Isno-Open/OpenProfalux/firmware/README.md

# OpenProfalux : firmware (ESP32 + CC1101)

Pilote des volets roulants **Profalux 868 MHz** (moteurs MAI-EMPX / MAI-EMNOE) depuis
Home Assistant, **sans la clé constructeur** : le firmware **clone** une télécommande
existante (capture + rejeu) : le moteur accepte le rejeu (rolling code non contraint).

## Fonctions
- **UI web embarquée** : pilotage, apprentissage, calibration, Wi-Fi, MQTT, OTA, système (RF debug).
- **Cover Home Assistant** par volet (MQTT discovery) : open/close/stop + position.
- **Apprentissage** : on capture ▲/▼/■ d'une vraie télécommande et on nomme le volet.
- **Position estimée par le temps** (calibration montée/descente ; recalage aux butées).
- **Suivi de la vraie télécommande** : ▲/▼ lance, ■ fige (modèle appui + stop).
- **Multi-télécommandes** par volet (serials multiples).
- **Sauvegarde / restauration** : export JSON (noms + trames de référence + calibration).
- **Capture de trames** optionnelle vers MQTT (dédup par serial).
- **OTA** : upload web + pull MQTT, 2 partitions ; **retour automatique** à la version précédente si la nouvelle plante au démarrage (voir plus bas), et bouton « Version précédente ».
- **Config UI** : Wi-Fi + MQTT (persistés en NVS).

## Matériel
Une carte ESP32 (M5Stack ATOM Lite, DevKit, D1 mini, Olimex ESP32-POE, ISNO Super : tableau dans
[`BUILD.md`](../BUILD.md)) + module CC1101 868 MHz (EBYTE E07-900M10S).
Brochage : voir `boards/<carte>.json`. **CC1101 = 3.3 V max, jamais 5 V.**

## Build
```bash
# via Docker ESP-IDF v6.1 (un repertoire de build par carte)
docker run --rm -v "$PWD/..":/project -w /project/firmware espressif/idf:v6.1 bash -c "
  idf.py -B build-isno-super set-target esp32s3
  idf.py -B build-isno-super -DBOARD=isno-super build"
# autres cartes : -DBOARD=<fichier de boards/>, cible = son champ mcu (tableau dans BUILD.md)
# ou en local si ESP-IDF v6.1 est installe :
idf.py -B build-isno-super set-target esp32s3 && idf.py -B build-isno-super -DBOARD=isno-super build
```

## Flash

### Option A : release pré-compilée (le plus simple, pas d'ESP-IDF)
Télécharger les binaires de la [dernière release](https://github.com/Isno-Open/OpenProfalux/releases)
puis, avec juste `esptool` (`pip install esptool`). **Choisir le binaire selon la carte** : les
broches SPI diffèrent, un binaire d'une carte ne marchera pas sur l'autre :

| Carte | Board neuf (`write_flash 0x0`) | Mise à jour OTA (onglet OTA) |
|---|---|---|
| **M5Stack ATOM Lite** (ESP32-PICO) | `openprofalux-m5-atom-lite-full.bin` | `openprofalux-m5-atom-lite-ota.bin` |
| **ESP32 DevKit** (CC1101 externe) | `openprofalux-external-full.bin` | `openprofalux-external-ota.bin` |
| **D1 mini ESP32** (CC1101 externe) | `openprofalux-d1-mini-full.bin` | `openprofalux-d1-mini-ota.bin` |
| **Olimex ESP32-POE** (Ethernet) | `openprofalux-esp32-poe-full.bin` | `openprofalux-esp32-poe-ota.bin` |
| **ISNO Super** (ESP32-S3, `--chip esp32s3`) | `openprofalux-isno-super-full.bin` | `openprofalux-isno-super-ota.bin` |

> Chaque release publie aussi `openprofalux-<carte>-bootloader.bin`, le bootloader seul : il active
> le retour automatique sur un boîtier déjà installé (voir plus bas).

> **Le `-full.bin` efface la configuration** (Wi-Fi, MQTT, volets, télécommandes clonées) : sa zone
> de configuration est vide. Sur un boîtier déjà configuré, exporter d'abord la sauvegarde (onglet
> **Système** → Sauvegarde), ou passer par l'OTA, qui la garde.

```bash
# Board neuf / réinstallation complète : image fusionnée à flasher à 0x0
esptool.py --chip esp32 -p /dev/ttyUSB0 --baud 460800 write_flash 0x0 openprofalux-m5-atom-lite-full.bin
```
Windows (PowerShell) : `esptool.exe --chip esp32 --port COM4 --baud 115200 write_flash 0x0 openprofalux-m5-atom-lite-full.bin`

> `460800` accélère l'écriture mais ne passe pas sur tous les câbles/puces USB. En cas d'erreur
> (*Timed out waiting for packet*, *invalid head of packet*), retomber à `--baud 115200`, qui marche partout.

Déjà sous OpenProfalux ? Pas besoin de câble : **onglet OTA → uploader le `-ota.bin`** de ta carte,
ou pousser son URL via MQTT (`openprofalux/ota/pull`).

### Option B : depuis les sources
```bash
# le repertoire de build de SA carte (voir Build) : sans -B, idf.py prend build/, isno-super par defaut
idf.py -B build-m5-atom-lite -p /dev/ttyUSB0 flash monitor
```

Sur Mac, où le flash USB via Docker est capricieux, une procédure pas à pas installe ESP-IDF v6.1 en
natif : [`../docs/FLASH-MACOS.md`](../docs/FLASH-MACOS.md).

## Retour automatique après une mise à jour
Une mise à jour démarre **en essai**. Elle est validée après une minute sans plantage, ou plus tôt
si le boîtier redémarre de lui-même (Wi-Fi revenu, configuration enregistrée) ou reçoit une
nouvelle mise à jour. Si elle plante avant, le bootloader l'abandonne et le boîtier repart **tout
seul** sur la version précédente ; l'onglet **OTA** le signale.
- Débranché pendant cette minute, le boîtier revient aussi à l'ancienne version : refaire la mise à jour.
- Une version qui se bloque sans planter n'est pas rattrapée : bouton « Version précédente » de l'onglet OTA.
- Le retour automatique vit dans le **bootloader**, que l'OTA ne remplace jamais. L'onglet OTA dit
  s'il est actif. Un boîtier installé avant cette version l'obtient une fois, par USB, en ne
  flashant que le bootloader : **configuration et firmware gardés**. Avec le
  `openprofalux-<carte>-bootloader.bin` de la release, à la même adresse que le `-full.bin` :
  ```bash
  esptool.py --chip esp32 -p /dev/ttyUSB0 --baud 115200 write_flash 0x0 openprofalux-m5-atom-lite-bootloader.bin
  ```
  Windows (PowerShell) : `esptool.exe --chip esp32 --port COM4 --baud 115200 write_flash 0x0 openprofalux-m5-atom-lite-bootloader.bin`.
  ISNO Super : `--chip esp32s3`. Depuis les sources : `idf.py -B build-<carte> -p /dev/ttyUSB0 -b 115200 bootloader-flash`.
  Le `-full.bin` le donne aussi, mais il efface la configuration (exporter la sauvegarde avant).

## Premier démarrage
1. Pas de Wi-Fi configuré → l'ESP32 ouvre un point d'accès **ouvert** `OpenProfalux_XXXX`
   (fin de son adresse MAC).
2. S'y connecter : le téléphone ouvre tout seul la page de configuration (portail captif), sinon
   ouvrir http://192.168.4.1. Onglet **Wi-Fi** : réseau, mot de passe, nom du boîtier (facultatif).
3. Redémarrage → le boîtier rejoint le réseau, à l'adresse affichée par la page
   (`http://openprofalux-xxxx.local`, ou `http://<nom>.local`).
4. Onglet **MQTT** : adresse du broker → les covers apparaissent dans Home Assistant.
5. Onglet **Télécommandes** : « Cloner une télécommande » (capturer ▲/▼/■, nommer le volet),
   puis « Calibrer la position » (chronométrer une course complète pour la position en %).

## Sécurité de l'interface
- Le boîtier refuse les envois (POST `/api/...`) qu'une page d'un **autre site** ferait faire au navigateur :
  une page piégée ne peut plus piloter les volets ni changer la configuration (réponse 403, `"err":"origine"`).
- Rien ne change pour l'interface (y compris dans une iframe Home Assistant), Home Assistant (MQTT ou REST),
  curl et les scripts.
- Un mot de passe (Système → Appareil) protège en plus l'accès à l'interface et à la sauvegarde.

## Topics MQTT
| Topic | Sens | Payload |
|---|---|---|
| `homeassistant/cover/openprofalux_<dev>_<id>/config` | pub retain | discovery HA |
| `openprofalux/cover/<id>/set` | sub | `OPEN`\|`CLOSE`\|`STOP` |
| `openprofalux/cover/<id>/set_position` | sub | `0..100` |
| `openprofalux/cover/<id>/position` / `/state` | pub retain | position / état |
| `openprofalux/<nom>/status` | pub retain | `online` / `offline` (disponibilité HA) |
| `openprofalux/listen/set` | sub | `ON`\|`OFF` : écoute RF permanente (aussi dans **Système**) |
| `openprofalux/frames/last`, `openprofalux/frames/log/<n>` | pub retain | trames captées (si écoute activée) |
| `openprofalux/ota/pull` | sub | URL du `.bin` |

> Le firmware de reverse/banc (capture, tests KeeLoq) est dans `../firmware-capture-test/`.
