Isno-Open/OpenProfalux/docs/images/telecommandes-compatibles.webp

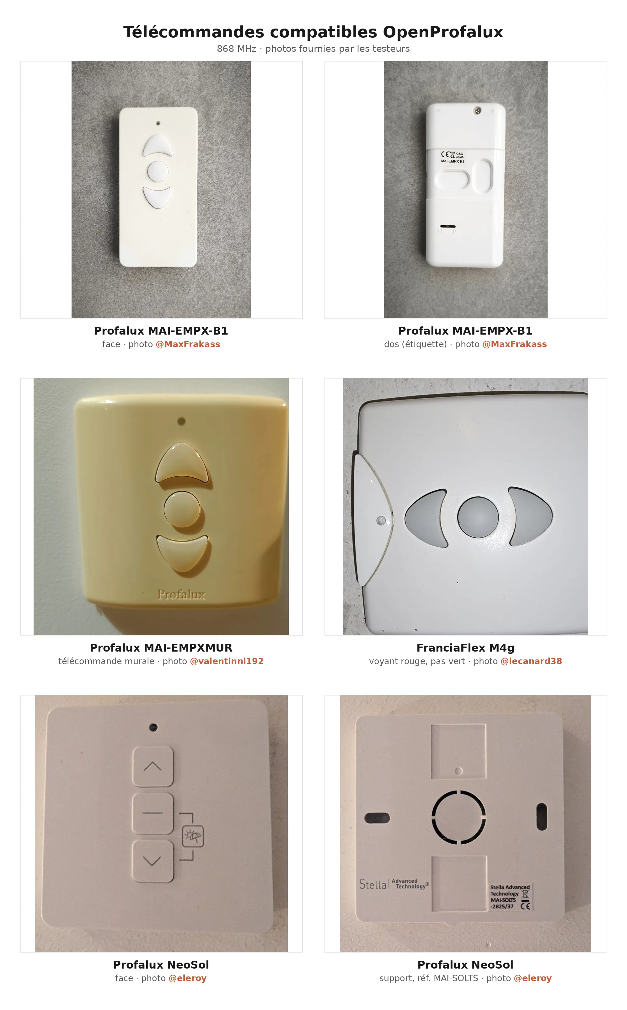
docs/images/telecommandes-compatibles.webp
