Isno-Open/OpenProfalux/enclosure/Ensemble.stl

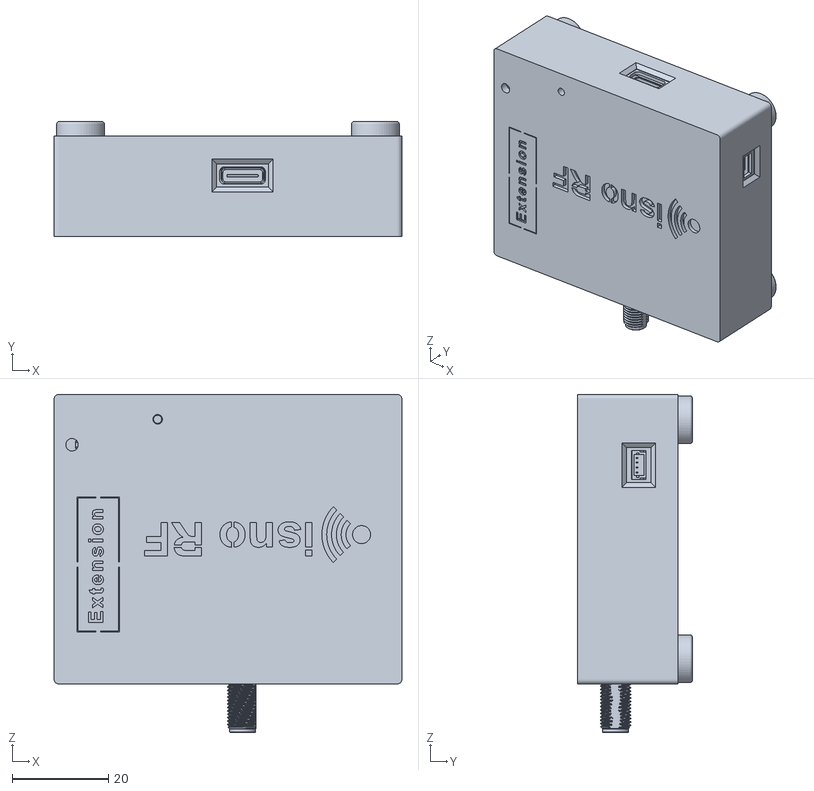
[picture p14: CAD file, 2026-10-23]
enclosure/Ensemble.stl
72.2 x 23.8 x 70.2
