Isno-Open/OpenProfalux/enclosure/OPENPROFALUX-boite.step

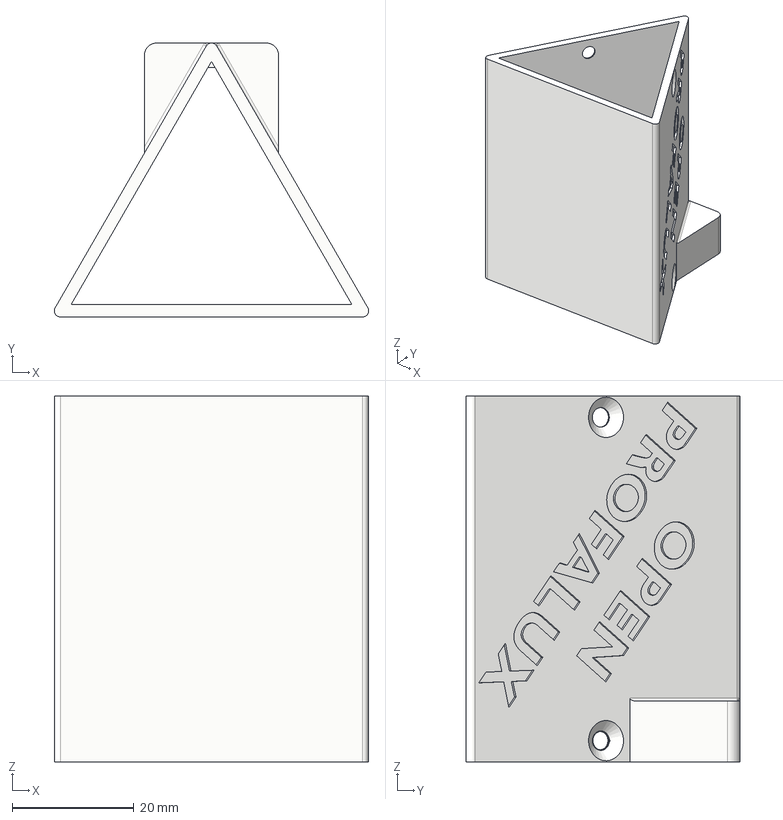
[picture p15: CAD file, 2026-10-23]
enclosure/OPENPROFALUX-boite.step
51.5 x 44.9 x 60.0 mm
