Isno-Open/OpenProfalux/firmware/main/main.c

/*
 * OpenProfalux main task orchestration
 * Boot flow:
 *   1. Init NVS
 *   2. Init CC1101
 *   3. Init Wi-Fi (STA from NVS config, else SoftAP)
 *   4. Init MQTT (broker from NVS config)
 *   5. Publish HA discovery
 *   6. Listen for MQTT commands
 */
#include <stdio.h>
#include <string.h>
#include <freertos/FreeRTOS.h>
#include <freertos/task.h>
#include <esp_log.h>
#include <nvs_flash.h>
#include <nvs.h>

#include "hardware_config.h"
#include "cc1101.h"
#include "radio.h"
#include "radio_profile.h"
#include "wifi_bridge.h"
#include "mqtt_bridge.h"
#include "tls_pool.h"
#include "tls_budget.h"
#include "shutters.h"
#include "pfx_enrol.h"
#include "web_ui.h"
#include "ota.h"
#include <esp_timer.h>
#include <esp_mac.h>
#include "mdns.h"
#include "mdns_name.h"
#include "esp_app_desc.h"   /* esp_app_get_description()->version = PROJECT_VER */
#include "log_ring.h"
#include "memprobe.h"
#include "memprobe.h"
#include <esp_attr.h>     /* RTC_NOINIT_ATTR */
#include <esp_system.h>   /* esp_reset_reason */
#if CONFIG_HEAP_TASK_TRACKING
#include <esp_heap_task_info.h>   /* build de diagnostic : test/heapdiag/sdkconfig.heapdiag */
#include <esp_rom_sys.h>
/* Chaque allocation refusee : taille, fonction et tache, notees ici (contexte de l'allocateur,
 * donc rien qui alloue), puis le bilan par tache est ecrit par la boucle de fond. Un releve
 * toutes les 20 s rate les creux de quelques secondes ; celui-ci tombe sur l'instant meme. */
static volatile uint32_t s_fail_n, s_fail_size;
static const char *volatile s_fail_fn;
static char s_fail_task[16];
static void on_alloc_failed(size_t size, uint32_t caps, const char *fn) {
    s_fail_n++; s_fail_size = size; s_fail_fn = fn;
    const char *t = pcTaskGetName(NULL);
    strlcpy(s_fail_task, t ? t : "?", sizeof(s_fail_task));
    esp_rom_printf("ALLOCFAIL n=%u size=%u caps=0x%x fn=%s task=%s libre=%u bloc=%u\n", (unsigned)s_fail_n,
                   (unsigned)size, (unsigned)caps, fn ? fn : "?", s_fail_task,
                   (unsigned)esp_get_free_heap_size(), (unsigned)heap_caps_get_largest_free_block(MALLOC_CAP_8BIT));
}
#endif

static const char *TAG = "main";
static bool s_log_frames = false;   /* option UI "capture toutes les trames" (namespace cfg) */
static bool s_mqtt_obey  = true;    /* obeir aux ordres cover MQTT (namespace cfg) ; defaut oui */
static bool s_debug      = false;   /* switch UI "debug console" : logge chaque capture RX */
static bool s_upd_auto   = true;    /* verification de mise a jour automatique (toutes les 6 h) */
static bool s_tx_rpt     = false;   /* option UI : bit de repetition comme la telecommande */
static bool s_tx_rmt     = false;   /* option UI : emission par le RMT (timing materiel) */
static uint8_t s_rx_gain = 0x27;    /* plafond de gain RX (AGCCTRL2) reglable via l'UI ; defaut 0x27 */
static uint32_t s_tx_te  = TX_TE_DEFAULT_US;   /* TE d'emission (us) reglable via l'UI ; defaut 400 */
static uint8_t  s_radio_prof = RADIO_PROFILE_DEFAULT;   /* profil radio (radio_profile.h), via l'UI */
static uint32_t s_freq_custom = 0;                      /* kHz, profil custom seulement */

/* Device name / config from NVS */
static char s_device_name[32] = "volet_test";
static char s_wifi_ssid[32]   = "";
static char s_wifi_pass[64]   = "";
static char s_mqtt_uri[160]   = "mqtt://ha.local:1883";
static char s_mqtt_user[128]  = "";   /* certains brokers utilisent des tokens JWT longs */
static char s_mqtt_pass[256]  = "";   /* HA peut generer des mdp broker >64 : marge (nvs_get_str echoue si buffer trop court -> champ vide -> 'not authorized'). Aligne sur OpenXtraflame. */

/* Load user config from NVS "cfg" namespace */
static void load_config(void) {
    nvs_handle_t h;
    if (nvs_open("cfg", NVS_READONLY, &h) != ESP_OK) return;
    size_t sz;
    sz = sizeof(s_device_name); nvs_get_str(h, "device", s_device_name, &sz);
    sz = sizeof(s_wifi_ssid);   nvs_get_str(h, "wifi_ssid", s_wifi_ssid, &sz);
    sz = sizeof(s_wifi_pass);   nvs_get_str(h, "wifi_pass", s_wifi_pass, &sz);
    sz = sizeof(s_mqtt_uri);    nvs_get_str(h, "mqtt_uri", s_mqtt_uri, &sz);
    sz = sizeof(s_mqtt_user);   nvs_get_str(h, "mqtt_user", s_mqtt_user, &sz);
    sz = sizeof(s_mqtt_pass);   nvs_get_str(h, "mqtt_pass", s_mqtt_pass, &sz);
    uint8_t lf = 0; nvs_get_u8(h, "log_frames", &lf); s_log_frames = lf;
    uint8_t mo = 1; nvs_get_u8(h, "mqtt_obey", &mo); s_mqtt_obey = mo;   /* absent = oui */
    uint8_t db = 0; nvs_get_u8(h, "debug", &db); s_debug = db;
    uint8_t ua = 1; nvs_get_u8(h, "upd_auto", &ua); s_upd_auto = ua;   /* absent = active */
    uint8_t rp = 0; nvs_get_u8(h, "tx_rpt", &rp); s_tx_rpt = rp;
    uint8_t rm = 0; nvs_get_u8(h, "tx_rmt", &rm); s_tx_rmt = rm;
    uint8_t rg = 0; if (nvs_get_u8(h, "rx_gain", &rg) == ESP_OK && rg) s_rx_gain = rg;
    uint32_t te = 0; if (nvs_get_u32(h, "te_tx", &te) == ESP_OK && te) s_tx_te = te;
    nvs_get_u8(h, "radio_prof", &s_radio_prof);
    nvs_get_u32(h, "freq_khz", &s_freq_custom);
    nvs_close(h);
    /* L'ancienne cle tx_te melait le reglage manuel et le TE cale automatiquement a chaque
     * apprentissage, sans pouvoir les distinguer : effacee une fois, le boitier repart a 400
     * (issue #64). Le reglage manuel vit desormais sous te_tx. */
    if (nvs_open("cfg", NVS_READWRITE, &h) == ESP_OK) {
        if (nvs_erase_key(h, "tx_te") == ESP_OK) { nvs_commit(h); ESP_LOGW(TAG, "TE d'emission : ancien reglage efface, %u us", (unsigned)s_tx_te); }
        nvs_close(h);
    }
    /* Nom d'appareil vide -> defaut : sinon client_id MQTT vide + topic de disponibilite
     * qui ne coincide pas avec la decouverte HA. */
    if (!s_device_name[0]) strlcpy(s_device_name, "openprofalux", sizeof(s_device_name));
}

/* Publish state JSON (heartbeat : etat liaison + heap libre) */
static void publish_state(const char *last_cmd) {
    char json[320];
    /* reserve TLS : libre, plus bas atteint, debordements (voir tls_pool.h) ; sert a la dimensionner */
    tls_pool_stats_t tp; tls_pool_stats(&tp);
    int ring = 0, hops = 0; shutters_mem_sizes(&ring, &hops);   /* tailles deduites de la RAM */
    snprintf(json, sizeof(json),
        "{\"last_cmd\":\"%s\",\"rssi\":%d,\"free_heap\":%u,\"min_heap\":%u,"
        "\"tls_pool\":%u,\"tls_free\":%u,\"tls_min\":%u,\"tls_spills\":%u,\"tls_offturn\":%u,"
        "\"ring\":%d,\"hops_cap\":%d,\"pub_drops\":%u,\"up_s\":%u}",
        last_cmd, wifi_bridge_rssi(), (unsigned)esp_get_free_heap_size(),
        (unsigned)esp_get_minimum_free_heap_size(),
        (unsigned)tp.size, (unsigned)tp.free_now, (unsigned)tp.free_min, (unsigned)tp.spills, (unsigned)tls_turn_misses(),
        ring, hops, (unsigned)shutters_pub_dropped(), (unsigned)(esp_timer_get_time() / 1000000));
    mqtt_pub_state(s_device_name, json);
}

/* ────── MQTT handlers ────── */

static void on_ota_pull(const char *url) {
    ESP_LOGI(TAG, "▶ OTA pull depuis %s", url);
    ota_pull_from_url(url);
}
static void on_mqtt_connected(void) {
    shutters_mqtt_announce(s_device_name);   /* publie la decouverte HA a la VRAIE connexion broker */
}

/* ── Retour du Wi-Fi en mode secours (wifi_bridge_start_fallback) ──
 * Des que le reseau repond, on redemarre : le demarrage normal (MQTT, mDNS, decouverte HA)
 * est deja eprouve, et rien n'est perdu (config et positions en NVS). Une mise a jour
 * envoyee par le point d'acces est attendue TANT QU'ELLE AVANCE : un envoi abandonne
 * (telephone coupe du point d'acces, qui suit le canal de la box au retour) reste "en
 * cours" sans fin cote serveur web ; 20 s sans octet recu -> on redemarre quand meme
 * (la partition de demarrage ne change qu'une fois l'image verifiee).
 * La duree passee en mode secours survit au redemarrage logiciel (memoire RTC, pas de
 * flash) : le journal du demarrage suivant la donne. */
#define FALLBACK_MAGIC 0x57494649u   /* "WIFI" */
static RTC_NOINIT_ATTR uint32_t s_fb_magic;
static RTC_NOINIT_ATTR uint32_t s_fb_secs;
static int64_t s_fb_since_us;
static esp_timer_handle_t s_back_timer;
static void back_restart_now(void) {
    s_fb_secs = (uint32_t)((esp_timer_get_time() - s_fb_since_us) / 1000000);
    s_fb_magic = FALLBACK_MAGIC;
    ESP_LOGW(TAG, "Wi-Fi de retour apres %u s en mode secours : redemarrage", (unsigned)s_fb_secs);
    esp_restart();
}
static void back_restart_cb(void *arg) {
    (void)arg;
    static uint32_t last; static int still;   /* octets recus au passage precedent, passages sans progres */
    ota_status_t st = {0}; ota_get_status(&st);   /* {0} : rien n'est copie si le verrou ne vient pas */
    bool busy = st.state == OTA_STATE_RECEIVING || st.state == OTA_STATE_VERIFYING || st.state == OTA_STATE_APPLYING;
    if (busy && st.written_bytes != last) { last = st.written_bytes; still = 0; }
    if (busy && still++ < 4) {   /* toutes les 5 s, au plus 4 fois sans progres */
        esp_timer_start_once(s_back_timer, 5 * 1000000ULL);
        return;
    }
    back_restart_now();
}
static void on_wifi_back(void) {   /* appele depuis la tache d'evenements : on ne fait qu'armer */
    if (!s_back_timer) {
        const esp_timer_create_args_t ta = { .callback = back_restart_cb, .name = "wifi_back" };
        if (esp_timer_create(&ta, &s_back_timer) != ESP_OK) { back_restart_now(); return; }   /* sinon connecte sans MQTT */
    }
    if (!esp_timer_is_active(s_back_timer)) esp_timer_start_once(s_back_timer, 2 * 1000000ULL);
}

/* NB : le RX radio (capture permanente arbitree) est demarre par shutters_init() ;
 * les trames recues sont routees vers shutters_on_rx en interne. */

/* ────── App entry ────── */

void app_main(void) {
    log_ring_init();   /* journal de l'interface web : avant le premier message */
    memprobe("boot-debut");
#if CONFIG_HEAP_TASK_TRACKING
    heap_caps_register_failed_alloc_callback(on_alloc_failed);
#endif
    ESP_LOGI(TAG, "╔══════════════════════════════════════════╗");
    ESP_LOGI(TAG, "║ OpenProfalux v%s : target=" TARGET_NAME, esp_app_get_description()->version);
    ESP_LOGI(TAG, "╚══════════════════════════════════════════╝");
    if (s_fb_magic == FALLBACK_MAGIC && esp_reset_reason() == ESP_RST_SW)
        ESP_LOGW(TAG, "redemarre apres le retour du Wi-Fi (%u s en mode secours)", (unsigned)s_fb_secs);
    s_fb_magic = 0;

    /* 1. NVS */
    esp_err_t err = nvs_flash_init();
    if (err == ESP_ERR_NVS_NO_FREE_PAGES || err == ESP_ERR_NVS_NEW_VERSION_FOUND) {
        nvs_flash_erase(); nvs_flash_init();
    }

    /* 1b. OTA (retour automatique : l'image en essai est validee plus bas apres ~60 s) */
    ota_init();
    memprobe("boot-nvs-ota");

    /* 2. Config */
    load_config();
    /* Reserve TLS prise d'un bloc des la configuration connue, avant que le reste du demarrage
     * ne morcelle la memoire, et a la taille de CE boitier (tls_pool_need). Un mqtts choisi en
     * cours de route deborde sur le tas jusqu'au redemarrage, et se compte. */
    {
        bool local_tls  = strncmp(s_mqtt_uri, "mqtts://", 8) == 0;
        bool local_mtls = local_tls && mqtt_cert_len("cert") && mqtt_cert_len("key");
        tls_pool_init(tls_pool_need(local_tls, local_mtls, false, s_upd_auto));
    }
    memprobe("boot-reserve-tls");
    /* Nom mDNS (mdns_name.h), decide AVANT le Wi-Fi : un boitier neuf demarre sans Wi-Fi (point
     * d'acces), et c'est a ce premier demarrage que son nom a suffixe doit etre fige. Nom choisi
     * par l'utilisateur, sinon le nom fige (cfg/mdns_host) : openprofalux pour un boitier deja
     * installe (Wi-Fi deja enregistre : adresse inchangee), openprofalux-xxxx pour un neuf. */
    {
        char host[MDNS_NAME_MAX + 1] = "";
        if (!mdns_name_is_default_device(s_device_name)) mdns_name_sanitize(s_device_name, host, sizeof(host));
        if (!host[0]) {
            nvs_handle_t h; size_t sz = sizeof(host);
            if (nvs_open("cfg", NVS_READWRITE, &h) == ESP_OK) {
                if (nvs_get_str(h, "mdns_host", host, &sz) != ESP_OK || !host[0]) {
                    uint8_t mac[6] = {0}; esp_read_mac(mac, ESP_MAC_WIFI_SOFTAP);
                    mdns_name_first_boot(s_wifi_ssid[0] != 0, mac, host, sizeof(host));
                    nvs_set_str(h, "mdns_host", host); nvs_commit(h);
                    ESP_LOGW(TAG, "mDNS : nom fige au premier demarrage : %s.local", host);
                }
                nvs_close(h);
            }
        }
        wifi_bridge_set_hostname(host);   /* vide : garde openprofalux */
    }
    ESP_LOGI(TAG, "device=%s wifi_ssid=%s mqtt=%s",
             s_device_name, s_wifi_ssid, s_mqtt_uri);

    /* 3. CC1101 */
    if (cc1101_init() != 0) {
        ESP_LOGE(TAG, "CC1101 init FAILED. Check wiring per hardware_config.h");
    }
    /* 3b. Profil radio (frequence par marque). Une config invalide ou hors de la plage de la
     * carte retombe sur le profil par defaut plutot que de laisser la radio muette. */
    {
        uint32_t khz;
        if (!radio_profile_resolve(s_radio_prof, s_freq_custom, CC1101_BAND_LOW_KHZ, CC1101_BAND_HIGH_KHZ, &khz)) {
            ESP_LOGW(TAG, "profil radio %u / %u kHz invalide pour cette carte : profil %s",
                     s_radio_prof, (unsigned)s_freq_custom, radio_profile_name(RADIO_PROFILE_DEFAULT));
            khz = radio_profile_freq_khz(RADIO_PROFILE_DEFAULT, 0);
        }
        cc1101_set_freq_khz(khz);
    }
    /* 4b. Auto-test emission au boot (prouve que la puce passe en TX). */
    if (cc1101_tx_selftest() == 0)
        ESP_LOGI(TAG, "TX SELFTEST OK : la puce emet (MARCSTATE=TX).");
    else
        ESP_LOGW(TAG, "TX SELFTEST ECHEC : puce NE passe PAS en TX (config/SPI).");
    cc1101_rx_probe();   /* sonde de bruit RX au boot (comparaison module/antenne) */

    /* 4c. Modele cover + arbitre radio (RX permanent gere en interne) */
    memprobe("boot-radio");
    shutters_set_update_auto(s_upd_auto);   /* avant shutters_init : la 1re verification en tient compte */
    shutters_init();
    memprobe("boot-volets");
    pfx_enrol_init();   /* identite virtuelle 0x067 (apprentissage sans telecommande, experimental) */
    if (s_log_frames) shutters_set_log_frames(true);
    shutters_set_mqtt_obey(s_mqtt_obey);   /* obeir aux ordres MQTT (defaut oui ; coupe = carte secondaire) */
    cc1101_set_rx_debug(s_debug);   /* switch DEBUG console restaure au boot */
    cc1101_set_rx_gain(s_rx_gain);  /* plafond de gain RX restaure au boot */
    cc1101_set_tx_te(s_tx_te);      /* TE d'emission restaure au boot */
    cc1101_set_tx_repeat_bit(s_tx_rpt);   /* bit de repetition (option) restaure au boot */
    cc1101_set_tx_rmt(s_tx_rmt);          /* emission RMT (option) restauree au boot */
    /* Radios SECONDAIRES (issue #95) : la radio 0 garde les cles NVS historiques (ci-dessus) ;
     * chaque radio i>0 a ses propres cles indexees (rprofN, rfreqN, rxgN, rteN, rrptN, rrmtN).
     * On resout sa frequence dans SA bande (defaut = porteuse declaree) et on applique freq, gain,
     * TE et options a cette puce. radio_apply serialise par le mutex radio. */
    {
        nvs_handle_t rh; bool rok = (nvs_open("cfg", NVS_READONLY, &rh) == ESP_OK);
        for (int i = 1; i < cc1101_radio_count(); i++) {
            char k[24];
            uint8_t prof = RADIO_PROFILE_CUSTOM, rxg = 0x27, rpt = 0, rmt = 0;
            uint32_t fcustom = 0, te = TX_TE_DEFAULT_US;
            if (rok) {
                snprintf(k, sizeof k, "rprof%d", i); nvs_get_u8(rh, k, &prof);
                snprintf(k, sizeof k, "rfreq%d", i); nvs_get_u32(rh, k, &fcustom);
                snprintf(k, sizeof k, "rxg%d", i);   { uint8_t v = 0;  if (nvs_get_u8(rh, k, &v) == ESP_OK && v) rxg = v; }
                snprintf(k, sizeof k, "rte%d", i);   { uint32_t v = 0; if (nvs_get_u32(rh, k, &v) == ESP_OK && v) te = v; }
                snprintf(k, sizeof k, "rrpt%d", i);  nvs_get_u8(rh, k, &rpt);
                snprintf(k, sizeof k, "rrmt%d", i);  nvs_get_u8(rh, k, &rmt);
            }
            uint32_t lo = 0, hi = 0, carrier = 0;
            cc1101_radio_info(i, NULL, &carrier, NULL, &lo, &hi, NULL, NULL);
            uint32_t khz;
            if (!radio_profile_resolve(prof, fcustom, lo, hi, &khz)) khz = carrier ? carrier : lo;
            int rpt_i = rpt, rmt_i = rmt;
            radio_apply(i, &khz, &rxg, &te, &rpt_i, &rmt_i);
        }
        if (rok) nvs_close(rh);
    }
    /* Resume des radios au boot (issue #95) : visible dans la console serie du testeur, pour
     * confirmer que CHAQUE puce declaree repond, sur quelle bande et quelle porteuse. */
    ESP_LOGW(TAG, "radios declarees par la carte : %d", cc1101_radio_count());
    for (int i = 0; i < cc1101_radio_count(); i++) {
        const char *band = ""; uint32_t cur = 0; uint8_t pn = 0xFF, ver = 0xFF;
        cc1101_radio_info(i, &band, NULL, &cur, NULL, NULL, &pn, &ver);
        bool ok = (pn == 0x00 && ver != 0x00 && ver != 0xFF);
        ESP_LOGW(TAG, "  radio %d : bande %s MHz, porteuse %u kHz, PARTNUM=0x%02X VERSION=0x%02X -> %s",
                 i, band[0] ? band : "?", (unsigned)cur, pn, ver, ok ? "DETECTEE" : "ABSENTE");
    }

    /* 5. Reseau : Ethernet filaire d'abord (si la carte en declare), sinon Wi-Fi. */
    memprobe("boot-avant-wifi");
    wifi_bridge_init();
#if BOARD_HAS_ETHERNET
    wifi_bridge_start_eth();
    /* Laisse le lien physique monter et le DHCP repondre (jusqu'a ~15 s). */
    for (int r = 0; !wifi_bridge_is_connected() && r < 30; r++) vTaskDelay(pdMS_TO_TICKS(500));
    if (wifi_bridge_is_connected()) ESP_LOGI(TAG, "reseau par Ethernet filaire");
#endif
    if (!wifi_bridge_is_connected() && strlen(s_wifi_ssid) > 0) {
        wifi_bridge_start_sta(s_wifi_ssid, s_wifi_pass);
        /* Wait for connection or timeout */
        int retry = 0;
        while (!wifi_bridge_is_connected() && retry++ < 60) vTaskDelay(pdMS_TO_TICKS(500));
    }
    if (!wifi_bridge_is_connected()) {
        uint8_t mac[6] = {0}; esp_read_mac(mac, ESP_MAC_WIFI_SOFTAP);
        char ap_ssid[32]; snprintf(ap_ssid, sizeof(ap_ssid), "OpenProfalux_%02X%02X", mac[4], mac[5]);
        if (strlen(s_wifi_ssid) > 0) {
            /* Reseau configure mais muet (box qui redemarre apres une coupure, ou panne) :
             * point d'acces ET client, qui continue de chercher le reseau (mode secours). */
            s_fb_since_us = esp_timer_get_time();
            wifi_bridge_start_fallback(ap_ssid, on_wifi_back);
        } else {
            ESP_LOGW(TAG, "Wi-Fi not connected. Starting SoftAP '%s' (open) for config.", ap_ssid);
            wifi_bridge_start_softap(ap_ssid, "");   /* mdp vide => WIFI_AUTH_OPEN (comme OpenXtraflamme) */
        }
    }

    /* 5b. mDNS (pour l'auto-decouverte du broker MQTT depuis l'UI) */
    memprobe("boot-wifi");
    if (wifi_bridge_is_connected()) {
        if (mdns_init() == ESP_OK) {
            mdns_hostname_set(wifi_bridge_hostname());
            /* Nom d'instance : le nom choisi, sinon le nom d'hote (unique par boitier). */
            mdns_instance_name_set(mdns_name_is_default_device(s_device_name) ? wifi_bridge_hostname() : s_device_name);
            ESP_LOGI(TAG, "mDNS : %s.local", wifi_bridge_hostname());
            /* Service _openprofalux._tcp : un client (script, domotique, outil reseau) retrouve le ou
             * les boitiers sans connaitre leur nom ni leur IP. id (MAC station, voir mdns_name.h) les
             * distingue ; ver et board disent ce qui tourne dessus. */
            uint8_t sta[6] = {0}; esp_read_mac(sta, ESP_MAC_WIFI_STA);
            char id[13]; mdns_name_id(sta, id, sizeof(id));
            mdns_txt_item_t txt[] = {
                { "id", id }, { "ver", esp_app_get_description()->version }, { "board", TARGET_NAME },
            };
            if (mdns_service_add(NULL, "_openprofalux", "_tcp", 80, txt, 3) == ESP_OK)
                ESP_LOGI(TAG, "mDNS : service _openprofalux._tcp annonce (id %s)", id);
            else
                ESP_LOGW(TAG, "mDNS : service _openprofalux._tcp non annonce");
        }
    }

    /* 5c. UI web embarquee (config Wi-Fi/MQTT, apprentissage, OTA...) */
    memprobe("boot-mdns");
    web_ui_start();
    memprobe("boot-web");

    /* 6. MQTT */
    if (wifi_bridge_is_connected() && strlen(s_mqtt_uri) > 0) {
        /* Handlers AVANT le start : la decouverte HA est publiee sur l'evenement CONNECTED
         * (vraie connexion), plus au boot a l'aveugle. Le statut UI suit CONNECTED/DISCONNECTED. */
        mqtt_handlers_t h = {
            .on_message = shutters_mqtt_on_message,   /* cover HA */
            .on_ota_pull = on_ota_pull,               /* OTA pull */
            .on_connected = on_mqtt_connected,        /* -> publie la decouverte HA */
            .on_disconnected = shutters_mqtt_lost,    /* -> statut hors ligne */
        };
        mqtt_bridge_set_handlers(&h);
        mqtt_bridge_start(s_mqtt_uri, s_device_name,
                          strlen(s_mqtt_user) ? s_mqtt_user : NULL,
                          strlen(s_mqtt_pass) ? s_mqtt_pass : NULL);
    }

    memprobe("boot-mqtt");
    ESP_LOGI(TAG, "PRET (%s). Pilotage via HA/MQTT + UI web. Capture/replay actif.", TARGET_NAME);

    /* Boucle de fond : heartbeat MQTT (~60 s) + validation de l'image OTA apres ~60 s sans
     * plantage (retour automatique, voir ota.c : un redemarrage voulu ou une nouvelle mise a
     * jour la valident aussi). Le capture/replay + le suivi de position tournent dans le
     * module radio et la tache shutters. */
    uint32_t hb = 0; bool ota_marked = false;
    while (1) {
        if (++hb >= 1200) { hb = 0;
            /* Premier battement (~60 s) : tout tourne, la RAM libre est representative. Le ring RF
             * et les sets de hops prennent leur taille d'apres elle (shutters_size_from_ram). */
            memprobe("battement-avant");
            shutters_size_from_ram();
            memprobe("battement-anneau");
            publish_state("HEARTBEAT");
            if (!ota_marked) { ota_mark_valid(); ota_marked = true; }
        }
#if CONFIG_HEAP_TASK_TRACKING
        /* Build de diagnostic : ce que chaque tache tient sur le tas, toutes les 20 s, sur la
         * console (pas sur le reseau, qui est justement ce qui tombe quand la memoire manque). */
        static uint32_t fail_seen;
        if (s_fail_n != fail_seen) {   /* un refus depuis le dernier tour : bilan de l'instant */
            fail_seen = s_fail_n;
            printf("HEAPDIAG refus n=%u size=%u fn=%s task=%s\n", (unsigned)s_fail_n, (unsigned)s_fail_size,
                   s_fail_fn ? s_fail_fn : "?", s_fail_task);
            heap_caps_print_all_task_stat_overview(stdout);
        }
        if (hb % 400 == 0) {
            printf("HEAPDIAG t=%u libre=%u min=%u bloc=%u\n", (unsigned)(esp_timer_get_time() / 1000000),
                   (unsigned)esp_get_free_heap_size(), (unsigned)esp_get_minimum_free_heap_size(),
                   (unsigned)heap_caps_get_largest_free_block(MALLOC_CAP_8BIT));
            heap_caps_print_all_task_stat_overview(stdout);
        }
#endif
        memprobe_watch();
        memtrace_poll();
        memprobe_stacks();
        vTaskDelay(pdMS_TO_TICKS(50));
    }
}
