Isno-Open/OpenProfalux/firmware/main/cc1101.c

/*
 * CC1101 driver : Profalux 868.425 MHz OOK
 *
 * NOTE: This is a functional skeleton. Config registers below are
 * validated against SmartRF Studio output for OOK 868.425 MHz ~1550 baud
 * asynchronous serial mode with GDO0 output on TX and GDO0 input on RX.
 */
#include "cc1101.h"
#include "radio_profile.h"
#include "hardware_config.h"
#include <string.h>
#include <esp_log.h>
#include <driver/spi_master.h>
#include <driver/gpio.h>
#include <freertos/FreeRTOS.h>
#include <freertos/task.h>
#include <freertos/queue.h>
#include <esp_rom_sys.h>
#include "soc/soc_caps.h"   /* SOC_RMT_MEM_WORDS_PER_CHANNEL : portabilite RMT (S3/C3) */
#include <esp_timer.h>
#include <driver/rmt_rx.h>
#include <driver/rmt_tx.h>
#include <driver/rmt_encoder.h>
#include <esp_rom_gpio.h>      /* rendre GDO0 au GPIO apres une emission RMT */
#include "soc/gpio_sig_map.h"  /* SIG_GPIO_OUT_IDX */
#include <esp_heap_caps.h>
#include "memprobe.h"   /* heap_caps_aligned_alloc : buffer RX DMA-capable aligne (S3) */
#include "keeloq_decode.h"   /* decodeur OOK HCS/KeeLoq, unite pure testable sur hote */
#include <math.h>            /* fabs/lround : mapping debit/bande passante -> registres */

static const char *TAG = "cc1101";

/* ── Radios de la carte (issue #95) ──────────────────────────────────────────
 * La carte declare une ou plusieurs radios CC1101 sur le MEME bus SPI (SCK/MISO/
 * MOSI communs) ; elles ne different que par CS et GDO0/GDO2. board_pins.h fournit
 * CC1101_COUNT et la table CC1101_RADIO_TABLE_INIT (index 0 = radio primaire 868,
 * voir tools/gen_board.py). Le corps du driver pilote la radio ACTIVE : les macros
 * CC1101_PIN_CS/GDO0/GDO2 sont redefinies pour indirecter vers s_radios[s_active],
 * de sorte qu'aucune fonction du driver n'a a connaitre l'index. Une carte
 * mono-radio garde exactement le comportement d'avant (CC1101_COUNT==1, index 0). */
#ifndef CC1101_COUNT
#define CC1101_COUNT 1
#define CC1101_RADIO_TABLE_INIT { { "", CC1101_PIN_CS, CC1101_PIN_GDO0, CC1101_PIN_GDO2, \
                                    CC1101_BAND_LOW_KHZ, CC1101_BAND_HIGH_KHZ, 0 } }
#endif
typedef struct { const char *band; int cs, gdo0, gdo2; uint32_t band_low_khz, band_high_khz, carrier_khz; } cc1101_radio_cfg_t;
static const cc1101_radio_cfg_t s_radios[CC1101_COUNT] = CC1101_RADIO_TABLE_INIT;
static int s_active = 0;   /* radio courante (0 = primaire 868) */

/* A partir d'ici, CS et GDO suivent la radio active : aucune broche n'est figee. */
#undef  CC1101_PIN_CS
#undef  CC1101_PIN_GDO0
#undef  CC1101_PIN_GDO2
#define CC1101_PIN_CS    (s_radios[s_active].cs)
#define CC1101_PIN_GDO0  (s_radios[s_active].gdo0)
#define CC1101_PIN_GDO2  (s_radios[s_active].gdo2)

int cc1101_radio_count(void) { return CC1101_COUNT; }
int cc1101_active_radio(void) { return s_active; }
/* Index de la radio dont la bande declaree contient khz, ou -1 si aucune. */
int cc1101_radio_for_khz(uint32_t khz) {
    for (int i = 0; i < CC1101_COUNT; i++)
        if (khz >= s_radios[i].band_low_khz && khz <= s_radios[i].band_high_khz) return i;
    return -1;
}

/* Frequence porteuse : cache de la radio active (s_freq_khz) et valeur figee de chaque
 * radio (s_chip_khz), car chaque puce garde ses propres registres FREQ. */
static uint32_t s_freq_khz = PROFALUX_FREQ_HZ / 1000;   /* 868 au boot (s_regs) */
static uint32_t s_chip_khz[CC1101_COUNT];
/* PARTNUM/VERSION lus a l'init pour CHAQUE radio (presence + diagnostic par puce, issue #95). */
static uint8_t s_part[CC1101_COUNT], s_ver[CC1101_COUNT];

/* Description d'une radio declaree, pour l'UI (/api/radios). idx 0 = primaire 868.
 * Lecture seule (table + caches figes a l'init), pas de mutex necessaire. 0=OK, -1=hors borne. */
int cc1101_radio_info(int idx, const char **band, uint32_t *carrier_khz, uint32_t *cur_khz,
                      uint32_t *low_khz, uint32_t *high_khz, uint8_t *partnum, uint8_t *version) {
    if (idx < 0 || idx >= CC1101_COUNT) return -1;
    if (band)        *band = s_radios[idx].band;
    if (carrier_khz) *carrier_khz = s_radios[idx].carrier_khz;
    if (cur_khz)     *cur_khz = s_chip_khz[idx];
    if (low_khz)     *low_khz = s_radios[idx].band_low_khz;
    if (high_khz)    *high_khz = s_radios[idx].band_high_khz;
    if (partnum)     *partnum = s_part[idx];
    if (version)     *version = s_ver[idx];
    return 0;
}
/* ── Switch DEBUG capture RX (runtime, togglable depuis l'UI/MQTT) ──────────
 * Quand ON : logge CHAQUE paquet capte en ecoute (symboles RMT + RSSI + bits
 * decodes + classification KeeLoq), y compris les trames <64 bits normalement
 * jetees. Sert a diagnostiquer "ca ne capte pas" : distingue antenne morte /
 * reception mais decode KO / pas du Profalux. OFF par defaut (log verbeux). */
static volatile bool s_rx_debug = false;
void cc1101_set_rx_debug(bool on) { s_rx_debug = on; ESP_LOGW(TAG, "DEBUG capture RX %s", on ? "ON" : "OFF"); }
bool cc1101_get_rx_debug(void)    { return s_rx_debug; }
/* Gain RX reglable (AGCCTRL2) : plafond de gain LNA. 0x27=defaut (-9 dB). Plus GRAND
 * = moins de gain (0x37, 0x3F=-17 dB) -> l'AGC ne remonte plus sur le bruit dans les
 * creux OOK (moins de fausses transitions), au prix de la sensibilite aux signaux faibles. */
/* Reglages PAR RADIO (issue #95) : chaque CC1101 garde son gain, son TE et ses options.
 * Le set/get agit sur la radio ACTIVE (s_active) ; l'application (registre AGCCTRL2 en RX,
 * timing en TX) lit toujours le slot de la radio active, donc basculer de radio applique
 * naturellement ses reglages. Defauts poses dans cc1101_init. */
static volatile uint8_t s_rx_gain[CC1101_COUNT];
void cc1101_set_rx_gain(uint8_t v) { s_rx_gain[s_active] = v; ESP_LOGW(TAG, "radio %d : RX gain AGCCTRL2=0x%02X", s_active, v); }
uint8_t cc1101_get_rx_gain(void)   { return s_rx_gain[s_active]; }
/* Timing d'EMISSION : TE (temps elementaire), 400 us par defaut, le nominal de la datasheet HCS300
 * (plage garantie 260-660 us). Le TE d'une vraie telecommande depend de son oscillateur RC ; les
 * moteurs le mesurent sur chaque trame et acceptent toute la plage. On n'imite donc pas le TE de la
 * telecommande captee (issue #64), mais le reglage reste possible (Systeme > Appareil). On derive
 * bit '1'=TE, '0'=2*TE, preambule=TE, entete=10 TE. */
static volatile uint32_t s_tx_te[CC1101_COUNT];
/* Bit de repetition (bit 65 de la trame KeeLoq). Mesure 2026-10-10 au YARD Stick One sur les
 * murales Eveno (HCS30x) : la 1re trame d'un appui porte RPT=0, toutes les repetitions RPT=1
 * (meme code tournant), ~18 ms de silence entre trames. Le rejeu envoyait jusqu'ici N trames
 * identiques (le bit tel qu'enregistre, 0 pour une trame adoptee) a 2 ms d'intervalle. Option,
 * desactivee par defaut : les moteurs testes acceptent les deux ; elle sert aux moteurs qui
 * tiendraient compte du bit, et a un maintien fidele (appui long). */
#define TX_RPT_GAP_MS 18
static volatile bool s_tx_rpt[CC1101_COUNT];
void cc1101_set_tx_repeat_bit(bool on) { s_tx_rpt[s_active] = on; ESP_LOGW(TAG, "radio %d : TX bit de repetition %s", s_active, on ? "ON" : "OFF"); }
bool cc1101_get_tx_repeat_bit(void)    { return s_tx_rpt[s_active]; }
/* Emission par le RMT (timing materiel) au lieu du bit-bang (esp_rom_delay_us + GPIO,
 * preemptible par le WiFi, voir issue upstream #37). Option, desactivee par defaut. */
static volatile bool s_tx_rmt[CC1101_COUNT];
void cc1101_set_tx_rmt(bool on) { s_tx_rmt[s_active] = on; ESP_LOGW(TAG, "radio %d : TX par RMT %s", s_active, on ? "ON" : "OFF"); }
bool cc1101_get_tx_rmt(void)    { return s_tx_rmt[s_active]; }
void cc1101_set_tx_te(uint32_t te) { if (te >= 200 && te <= 900) { s_tx_te[s_active] = te; ESP_LOGW(TAG, "radio %d : TX TE=%u us", s_active, (unsigned)te); } }
uint32_t cc1101_get_tx_te(void)    { return s_tx_te[s_active]; }
/* TE (us) mesure sur la DERNIERE trame decodee (periode de bit / 3). Diagnostic seulement
 * (te= sur la ligne RX) : il ne regle plus l'emission. */
static volatile int s_last_te = 455;
int cc1101_last_te(void) { return s_last_te; }
/* Diagnostic radio expose a l'UI : detection de la puce + resultat du self-test TX. */
static int     s_tx_ok   = -1;      /* -1=non teste, 0=HS, 1=OK (puce passe en TX) */
static uint8_t s_partnum = 0xFF;    /* CC1101 attendu : PARTNUM 0x00, VERSION 0x04/0x14 */
static uint8_t s_version = 0xFF;
/* GDO0 libre (issue #60) : -1 = non teste, 1 = libre, 0 = tenu par un autre composant
 * (s_gdo0_lvl = niveau auquel il est tenu). */
static int s_gdo0 = -1, s_gdo0_lvl = -1;
int cc1101_gdo0_state(int *level) { if (level) *level = s_gdo0_lvl; return s_gdo0; }
void cc1101_get_diag(int *tx_ok, uint8_t *partnum, uint8_t *version) {
    if (tx_ok)   *tx_ok   = s_tx_ok;
    if (partnum) *partnum = s_partnum;
    if (version) *version = s_version;
}
int g_tx_marc = -1;   /* MARCSTATE lu juste apres le dernier STX (0x13=TX). Diagnostic expose via HTTP. */
static spi_device_handle_t s_spi = NULL;
static rmt_channel_handle_t s_cap = NULL;
static QueueHandle_t s_capq = NULL;
/* Buffer de reception RMT. Sur ESP32-S3 avec DMA, ce buffer DOIT etre en RAM
 * interne DMA-capable et aligne 64 octets, sinon le GDMA lit/ecrit les mauvaises
 * lignes de cache -> symboles parasites (glitches ~55 us) et corruption silencieuse
 * (cf esp-idf #12564, FastLED #2156). Un simple tableau statique ne garantit NI
 * l'alignement NI MALLOC_CAP_DMA. On l'alloue donc a l'init avec heap_caps. */
#define CAP_SYMBOLS KEELOQ_CAP_SYMBOLS   /* source unique (keeloq_decode.h) */
_Static_assert(sizeof(kq_sym_t) == sizeof(rmt_symbol_word_t), "kq_sym_t doit avoir la meme disposition que rmt_symbol_word_t");
static rmt_symbol_word_t *s_capbuf = NULL;
static size_t s_capbuf_sz = 0;
/* RX et auto-capture partagent l'unique canal RMT s_cap sur GDO0 (memoire RMT limitee). */
static cc1101_rx_cb_t     s_rx_cb = NULL;
static TaskHandle_t       s_rx_task = NULL;
static volatile bool      s_rx_running = false;

/* --- Registers CC1101 --- */
#define CC_IOCFG2   0x00
#define CC_IOCFG0   0x02
#define CC_FIFOTHR  0x03
#define CC_PKTLEN   0x06
#define CC_PKTCTRL0 0x08
#define CC_FREQ2    0x0D
#define CC_FREQ1    0x0E
#define CC_FREQ0    0x0F
#define CC_MDMCFG4  0x10
#define CC_MDMCFG3  0x11
#define CC_MDMCFG2  0x12
#define CC_MDMCFG1  0x13
#define CC_MDMCFG0  0x14
#define CC_DEVIATN  0x15
#define CC_MCSM0    0x18
#define CC_FOCCFG   0x19
#define CC_WORCTRL  0x20
#define CC_FSCAL3   0x23
#define CC_FSCAL2   0x24
#define CC_FSCAL1   0x25
#define CC_FSCAL0   0x26
#define CC_TEST2    0x2C
#define CC_TEST1    0x2D
#define CC_TEST0    0x2E
#define CC_PARTNUM  0x30
#define CC_FREQEST  0x32   /* offset de frequence estime du signal recu (signed) */
#define CC_RSSI     0x34
#define CC_MARCSTATE 0x35   /* etat machine radio (0x0D=RX, 0x13=TX, 0x01=IDLE) */
#define CC_MCSM1    0x17
#define CC_FREND1   0x21
#define CC_FREND0   0x22    /* PA_POWER : bit0..2 = index PATABLE utilise */
#define CC_PATABLE  0x3E

/* Strobes */
#define CC_SRES     0x30
#define CC_SIDLE    0x36
#define CC_STX      0x35
#define CC_SRX      0x34
#define CC_SFTX     0x3B
#define CC_SFRX     0x3A

/* Config array: OOK 868.425 MHz ~1550 baud asynchronous mode */
static const struct { uint8_t reg, val; } s_regs[] = {
    {CC_IOCFG2,   0x0D},  /* Serial data output */
    {CC_IOCFG0,   0x0D},  /* Serial data output on GDO0 */
    {CC_FIFOTHR,  0x47},
    {CC_PKTLEN,   0xFF},
    {CC_PKTCTRL0, 0x32},  /* Async serial, no CRC, infinite packet */
    {CC_FREQ2,    0x21},  /* 868.425 MHz (mesure 2026-08-10, etait 868.35 = hors bande) */
    {CC_FREQ1,    0x66},
    {CC_FREQ0,    0xA5},
    {CC_MDMCFG4,  0xC6},  /* RX BW 102 kHz (mesure) */
    {CC_MDMCFG3,  0x83},
    {CC_MDMCFG2,  0x30},  /* OOK/ASK modulation, no preamble/sync */
    {CC_MDMCFG1,  0x22},
    {CC_MDMCFG0,  0xF8},
    {CC_DEVIATN,  0x15},
    {CC_MCSM1,    0x3C},   /* reste en RX apres reception (comme le sniffer) */
    {CC_MCSM0,    0x18},   /* FS_AUTOCAL: calibre le PLL a IDLE->TX/RX */
    {CC_FREND1,   0xB6},   /* front analogique (ref sniffer qui capte) */
    {CC_FREND0,   0x11},   /* PA_POWER=1 => OOK utilise PATABLE[0] et [1] */
    {CC_FOCCFG,   0x14},
    {CC_WORCTRL,  0xFB},
    {CC_FSCAL3,   0xE9},
    {CC_FSCAL2,   0x2A},
    {CC_FSCAL1,   0x00},
    {CC_FSCAL0,   0x1F},
    {CC_TEST2,    0x81},
    {CC_TEST1,    0x35},
    {CC_TEST0,    0x09},
};

static void cs_low(void)  { gpio_set_level(CC1101_PIN_CS, 0); }
static void cs_high(void) { gpio_set_level(CC1101_PIN_CS, 1); }

static void spi_xfer(uint8_t *tx, uint8_t *rx, size_t n) {
    spi_transaction_t t = { .length = 8 * n, .tx_buffer = tx, .rx_buffer = rx };
    spi_device_polling_transmit(s_spi, &t);
}

/* Ecritures VERIFIEES. Mesure 2026-10-09 (D1 mini ESP32 + module CC1101) : apres une rafale
 * de ~5-10 acces SPI (lectures comprises), le CC1101 ignorait les ecritures pendant moins
 * d'1 ms. Il repondait bien en mode ecriture (octet d'etat 0x0F) mais ne gardait pas la
 * valeur ; lectures et strobes passaient. Independant de la frequence SPI et du DMA. Sans
 * verification, l'init perdait au hasard MCSM1/MCSM0/FREND0/TEST* et le PATABLE : puissance
 * d'emission et modulation fausses, sans aucun message. Le defaut a disparu apres une
 * coupure d'alimentation (puce en surconsommation, elle chauffait) : la verification sert a
 * le rendre VISIBLE (spi_retries/spi_fails dans /api/diag) et a s'en remettre.
 * On relit donc chaque registre de config et on reessaie apres 1 ms. */
static uint32_t s_spi_retries, s_spi_fails;
void cc1101_spi_stats(uint32_t *retries, uint32_t *fails) {
    if (retries) *retries = s_spi_retries;
    if (fails)   *fails   = s_spi_fails;
}

static void write_raw(uint8_t addr, uint8_t val) {
    uint8_t tx[2] = {addr, val}, rx[2];
    cs_low(); spi_xfer(tx, rx, 2); cs_high();
}

void cc1101_write_reg(uint8_t addr, uint8_t val) {
    for (int i = 0; ; i++) {
        write_raw(addr, val);
        if (addr > 0x2E || cc1101_read_reg(addr) == val) return;   /* au-dela : pas relisible */
        if (i == 5) {
            s_spi_fails++;
            ESP_LOGE(TAG, "ecriture registre 0x%02X=0x%02X non prise apres %d essais", addr, val, i + 1);
            return;
        }
        s_spi_retries++;
        esp_rom_delay_us(1000);
    }
}

uint8_t cc1101_read_reg(uint8_t addr) {
    uint8_t tx[2] = {addr | 0x80, 0}, rx[2];
    cs_low(); spi_xfer(tx, rx, 2); cs_high();
    return rx[1];
}

static void strobe(uint8_t s) {
    uint8_t tx = s, rx;
    cs_low(); spi_xfer(&tx, &rx, 1); cs_high();
}

/* ── Acces mode PAQUET (FIFO + strobes), pour un backend FSK. Transferts burst bornes a 31 octets
 * utiles. Le chemin OOK n'en a pas besoin. ── */
void cc1101_strobe_cmd(uint8_t s) { strobe(s); }

void cc1101_write_burst(uint8_t addr, const uint8_t *buf, size_t len) {
    if (!buf || len == 0 || len > 31) return;
    uint8_t tx[32], rx[32];
    tx[0] = addr | 0x40;   /* bit burst */
    for (size_t i = 0; i < len; i++) tx[i + 1] = buf[i];
    cs_low(); spi_xfer(tx, rx, len + 1); cs_high();
}

void cc1101_read_burst(uint8_t addr, uint8_t *buf, size_t len) {
    if (!buf || len == 0 || len > 31) return;
    uint8_t tx[32] = {0}, rx[32];
    tx[0] = addr | 0xC0;   /* bits burst + lecture */
    cs_low(); spi_xfer(tx, rx, len + 1); cs_high();
    for (size_t i = 0; i < len; i++) buf[i] = rx[i + 1];
}

/* Reapplique la config OOK/Profalux (restaure la modulation apres un passage FSK). */
void cc1101_apply_config_ook(void) {
    strobe(CC_SIDLE);
    for (size_t i = 0; i < sizeof(s_regs) / sizeof(s_regs[0]); i++)
        cc1101_write_reg(s_regs[i].reg, s_regs[i].val);
    /* PATABLE OOK (burst) : index0=eteint 0x00, index1=puissance 0xC0 (comme l'init) */
    uint8_t tx[3] = { CC_PATABLE | 0x40, 0x00, 0xC0 }, rx[3];
    cs_low(); spi_xfer(tx, rx, 3); cs_high();
}

/* Configure la radio ACTIVE : GPIO (CS/GDO0), reset, registres, PATABLE, porteuse.
 * Le bus SPI est partage et deja initialise par cc1101_init. Renvoie 0 si la puce
 * repond (PARTNUM 0x00), -1 sinon. */
static int cc1101_configure_active_chip(void) {
    gpio_config_t io_cs = { .pin_bit_mask = 1ULL << CC1101_PIN_CS,
                            .mode = GPIO_MODE_OUTPUT };
    gpio_config(&io_cs);
    cs_high();

    gpio_config_t io_gdo = { .pin_bit_mask = 1ULL << CC1101_PIN_GDO0,
                             .mode = GPIO_MODE_INPUT_OUTPUT };
    gpio_config(&io_gdo);

    /* Reset + configure */
    strobe(CC_SRES);
    vTaskDelay(pdMS_TO_TICKS(10));
    for (size_t i = 0; i < sizeof(s_regs) / sizeof(s_regs[0]); i++) {
        cc1101_write_reg(s_regs[i].reg, s_regs[i].val);
    }
    /* PATABLE (burst) pour OOK : index0=eteint (bit 0), index1=puissance (bit 1). */
    for (int i = 0; ; i++) {   /* ecriture verifiee (relue en burst), voir cc1101_write_reg */
        uint8_t tx[3] = { CC_PATABLE | 0x40, 0x00, 0xC0 }, rx[3];
        cs_low(); spi_xfer(tx, rx, 3); cs_high();
        uint8_t tr[3] = { CC_PATABLE | 0xC0, 0, 0 }, rr[3];
        cs_low(); spi_xfer(tr, rr, 3); cs_high();
        if (rr[1] == 0x00 && rr[2] == 0xC0) break;
        if (i == 5) {
            s_spi_fails++;
            ESP_LOGE(TAG, "PATABLE non pris (lu %02X,%02X) : puissance d'emission fausse", rr[1], rr[2]);
            break;
        }
        s_spi_retries++;
        esp_rom_delay_us(1000);
    }
    /* La radio primaire (index 0) garde la porteuse Profalux de s_regs (868,425 MHz) ; une
     * radio secondaire (p.ex. 433) pose la porteuse declaree par la carte. */
    if (s_active != 0 && s_radios[s_active].carrier_khz)
        cc1101_set_freq_khz(s_radios[s_active].carrier_khz);
    s_chip_khz[s_active] = s_freq_khz;   /* fige la porteuse de cette radio */

    uint8_t partnum = cc1101_read_reg(CC_PARTNUM | 0x40);
    uint8_t version = cc1101_read_reg(0x31 | 0x40);   /* VERSION : ~0x04/0x14 sur un vrai CC1101 */
    uint8_t marc    = cc1101_read_reg(CC_MARCSTATE | 0x40) & 0x1F;
    s_part[s_active] = partnum; s_ver[s_active] = version;             /* presence par radio (/api/radios) */
    if (s_active == 0) { s_partnum = partnum; s_version = version; }   /* diag UI detaille = radio primaire */
    ESP_LOGI(TAG, "radio %d (CS=%d GDO0=%d) PARTNUM=0x%02X VERSION=0x%02X (attendu 0x00/0x04-0x14) MARCSTATE=0x%02X",
             s_active, s_radios[s_active].cs, s_radios[s_active].gdo0, partnum, version, marc);
    return (partnum == 0x00) ? 0 : -1;
}

int cc1101_init(void) {
#if BOARD_HAS_INIT_GPIO
    /* Broches menees a un niveau fixe AVANT le bus SPI, declarees par la carte (voir
     * board_pins.h / boards/<carte>.json, champ init_gpio) : alimentation de la radio,
     * selection de bande, CS des peripheriques d'un SPI partage tenus hauts. Une carte
     * qui n'en declare pas (BOARD_HAS_INIT_GPIO 0), comme la Super, ne compile rien ici :
     * les numeros de broches ne sont ecrits nulle part dans le C. Retour #112 (@mckbrmn),
     * carte LILYGO T-Embed CC1101 ou l'ecran et la carte SD partagent le bus du CC1101. */
    {
        static const struct { int pin; int level; } init_gpio[] = BOARD_INIT_GPIO;
        for (int i = 0; i < BOARD_INIT_GPIO_COUNT; i++) {
            gpio_set_direction(init_gpio[i].pin, GPIO_MODE_OUTPUT);
            gpio_set_level(init_gpio[i].pin, init_gpio[i].level);
        }
    }
#endif
    /* Defauts PAR RADIO (issue #95) : gain nominal, TE nominal, options off. main.c les
     * ecrase ensuite par les reglages NVS de chaque radio (apply_radio_config). */
    for (int i = 0; i < CC1101_COUNT; i++) {
        s_rx_gain[i] = 0x27; s_tx_te[i] = TX_TE_DEFAULT_US; s_tx_rpt[i] = false; s_tx_rmt[i] = false;
    }
    /* Bus SPI partage par toutes les radios, initialise une seule fois. SCK/MISO/MOSI
     * sont communs ; CS manuel (spics_io_num=-1) : cs_low/cs_high abaissent la broche CS
     * de la radio active. On configure ensuite CHAQUE radio declaree (issue #95). */
    spi_bus_config_t bus = {
        .miso_io_num = CC1101_PIN_MISO, .mosi_io_num = CC1101_PIN_MOSI,
        .sclk_io_num = CC1101_PIN_SCK, .quadwp_io_num = -1, .quadhd_io_num = -1,
        .max_transfer_sz = 32,
    };
    ESP_ERROR_CHECK(spi_bus_initialize(CC1101_SPI_HOST, &bus, SPI_DMA_CH_AUTO));

    spi_device_interface_config_t dev = {
        .clock_speed_hz = CC1101_SPI_FREQ_HZ, .mode = 0,
        .spics_io_num = -1, .queue_size = 4,
    };
    ESP_ERROR_CHECK(spi_bus_add_device(CC1101_SPI_HOST, &dev, &s_spi));

    int rc0 = -1;
    for (int i = 0; i < CC1101_COUNT; i++) {
        s_active = i;
        int rc = cc1101_configure_active_chip();
        if (i == 0) rc0 = rc;   /* le code de retour est celui de la radio primaire */
    }
    s_active = 0;               /* on rend la main sur la radio primaire (868) */
    s_freq_khz = s_chip_khz[0];
    return rc0;
}

/* Synchronous bit-bang OOK on GDO0. Codage PWM HCS30x mesure le 2026-08-10 :
 *   Te=455us, periode de bit = 3*Te = 1365us.
 *   symbole H455 L910 (H<L)  et  symbole H910 L455 (H>L).
 * POLARITE (quel symbole = logique 1) NON etablie avec une seule telecommande :
 * on applique la convention "bit=1 si H<L" du decode, A CONFIRMER empiriquement
 * (si l'appairage echoue, inverser PFX_TX_INVERT). */
#ifndef PFX_TX_INVERT
#define PFX_TX_INVERT 0
#endif
static void ook_bit(bool one) {
    if (PFX_TX_INVERT) one = !one;
    if (one) {  /* symbole H455 L910 */
        gpio_set_level(CC1101_PIN_GDO0, 1); esp_rom_delay_us(455);
        gpio_set_level(CC1101_PIN_GDO0, 0); esp_rom_delay_us(910);
    } else {    /* symbole H910 L455 */
        gpio_set_level(CC1101_PIN_GDO0, 1); esp_rom_delay_us(910);
        gpio_set_level(CC1101_PIN_GDO0, 0); esp_rom_delay_us(455);
    }
}

/* Frequence porteuse (profil radio). Ecrite en IDLE ; le synthetiseur se recalibre au
 * prochain passage en RX/TX (MCSM0 FS_AUTOCAL). Relue pour verifier : sur certains montages
 * le CC1101 ignore une ecriture juste apres une rafale d'acces SPI, d'ou 3 essais espaces. */
uint32_t cc1101_get_freq_khz(void) { return s_freq_khz; }

/* Rend active la radio idx (0 = primaire 868). Rebranche la capture RMT sur son GDO0 si
 * l'ecoute etait armee, et restaure la porteuse figee de cette radio. 0=OK, -1=index hors
 * borne. A appeler sous le mutex radio (voir radio.c). */
int cc1101_select(int idx) {
    if (idx < 0 || idx >= CC1101_COUNT) return -1;
    if (idx == s_active) return 0;
    bool had_cap = (s_cap != NULL);
    /* rmt_del_channel EXIGE un canal desactive (ESP-IDF rmt_rx.c : sinon ESP_ERR_INVALID_STATE,
     * le canal n'est PAS libere). En ecoute permanente s_cap est ENABLE : sans ce rmt_disable,
     * la suppression echoue en silence, le canal DMA fuit, et re-creer sur le nouveau GDO0 rend
     * "no free rx channels" -> s_cap NULL -> toute RX sur la radio secondaire (capture, reception,
     * calage 433) echoue instantanement. Le sweep y echappe : il lit le registre RSSI, pas le RMT. */
    if (s_cap) { rmt_disable(s_cap); rmt_del_channel(s_cap); s_cap = NULL; }   /* capture liee a l'ancien GDO0 */
    s_active = idx;
    s_freq_khz = s_chip_khz[idx];                          /* cache = porteuse de cette radio */
    if (had_cap && cc1101_capture_init() != 0)             /* re-cree la capture sur le nouveau GDO0 */
        ESP_LOGE(TAG, "cc1101_select(%d) : recreation de la capture RMT sur GDO0 KO", idx);
    return 0;
}

int cc1101_set_freq_khz(uint32_t khz) {
    uint32_t w = radio_cc1101_freq_word(khz);
    uint8_t f2 = (w >> 16) & 0xFF, f1 = (w >> 8) & 0xFF, f0 = w & 0xFF;
    strobe(CC_SIDLE);
    for (int i = 0; i < 3; i++) {
        cc1101_write_reg(CC_FREQ2, f2); cc1101_write_reg(CC_FREQ1, f1); cc1101_write_reg(CC_FREQ0, f0);
        if (cc1101_read_reg(CC_FREQ2) == f2 && cc1101_read_reg(CC_FREQ1) == f1 && cc1101_read_reg(CC_FREQ0) == f0) {
            s_freq_khz = khz;
            s_chip_khz[s_active] = khz;   /* fige la porteuse de la radio active */
            ESP_LOGI(TAG, "frequence %u kHz (FREQ %02X %02X %02X)", (unsigned)khz, f2, f1, f0);
            return 0;
        }
        esp_rom_delay_us(1000);
    }
    ESP_LOGE(TAG, "frequence %u kHz NON prise (FREQ relu %02X %02X %02X)", (unsigned)khz,
             cc1101_read_reg(CC_FREQ2), cc1101_read_reg(CC_FREQ1), cc1101_read_reg(CC_FREQ0));
    return -1;
}

/* Auto-test d'emission : passe en TX, lit MARCSTATE (0x13 = porteuse ON),
 * module ~300 ms puis revient a IDLE. Prouve que la puce emet, sans recepteur. */
/* GDO0 est-il libre pour l'emission ? Sur une carte non standard, le fil peut rejoindre un autre
 * composant (Ebyte E07-900MBL : le STM8 de la carte, issue #59). Le CC1101 lache GDO0 (haute
 * impedance), l'ESP32 le lit en entree avec son tirage interne vers le haut puis vers le bas :
 * s'il suit les deux, rien ne le pilote ; s'il reste bloque, un autre composant le tient.
 * On ne force jamais le fil : forcer et relire sa propre broche ne voit pas une sortie plus
 * faible que celle de l'ESP32 (mesure, issue #60). Limite : ne voit ni un tampon a sens unique,
 * ni un fil coupe. */
static void gdo0_free_test(void) {
    strobe(CC_SIDLE);
    cc1101_write_reg(CC_IOCFG0, 0x2E);   /* GDO0 haute impedance cote CC1101 */
    gpio_set_direction(CC1101_PIN_GDO0, GPIO_MODE_INPUT);
    gpio_set_pull_mode(CC1101_PIN_GDO0, GPIO_PULLUP_ONLY);   esp_rom_delay_us(200);
    int hi = gpio_get_level(CC1101_PIN_GDO0);
    gpio_set_pull_mode(CC1101_PIN_GDO0, GPIO_PULLDOWN_ONLY); esp_rom_delay_us(200);
    int lo = gpio_get_level(CC1101_PIN_GDO0);
    gpio_set_pull_mode(CC1101_PIN_GDO0, GPIO_FLOATING);
    gpio_set_direction(CC1101_PIN_GDO0, GPIO_MODE_INPUT_OUTPUT);
    gpio_set_level(CC1101_PIN_GDO0, 0);
    cc1101_write_reg(CC_IOCFG0, 0x0D);   /* configuration normale */
    s_gdo0 = (hi == 1 && lo == 0) ? 1 : 0;
    s_gdo0_lvl = s_gdo0 ? -1 : hi;
    if (s_gdo0) ESP_LOGI(TAG, "GDO0 libre (suit les tirages haut et bas)");
    else ESP_LOGW(TAG, "GDO0 tenu a %d par un autre composant : l'emission n'atteindra pas le CC1101", hi);
}

int cc1101_tx_selftest(void) {
    gdo0_free_test();
    strobe(CC_STX);
    esp_rom_delay_us(1000);
    uint8_t m1 = cc1101_read_reg(CC_MARCSTATE | 0x40) & 0x1F;
    for (int i = 0; i < 300; i++) {   /* porteuse modulee 1kHz pendant ~300ms */
        gpio_set_level(CC1101_PIN_GDO0, 1); esp_rom_delay_us(500);
        gpio_set_level(CC1101_PIN_GDO0, 0); esp_rom_delay_us(500);
    }
    uint8_t m2 = cc1101_read_reg(CC_MARCSTATE | 0x40) & 0x1F;
    strobe(CC_SIDLE);
    ESP_LOGI(TAG, "TX SELFTEST: MARCSTATE post-STX=0x%02X, pendant modulation=0x%02X "
                  "(0x13=TX porteuse ON, 0x01=IDLE=rien)", m1, m2);
    s_tx_ok = (m1 == 0x13 || m2 == 0x13) ? 1 : 0;   /* pour le diagnostic UI */
    return s_tx_ok ? 0 : -1;
}

int cc1101_tx_ook_frame(const uint8_t *frame, size_t bits) {
    strobe(CC_STX);
    esp_rom_delay_us(800);   /* laisse le PLL se caler (FS_AUTOCAL) avant de moduler */

    /* Preuve d'emission : lit MARCSTATE une fois par boot. 0x13=TX (porteuse ON). */
    static bool s_marc_logged = false;
    if (!s_marc_logged) {
        s_marc_logged = true;
        uint8_t m = cc1101_read_reg(CC_MARCSTATE | 0x40) & 0x1F;
        ESP_LOGI(TAG, "TX MARCSTATE=0x%02X (0x13=TX porteuse ON, 0x01=IDLE=rien emis)", m);
    }

    /* Preambule: 23 alternances de Te (mesure) */
    for (int i = 0; i < PROFALUX_PREAMBLE_ELEMENTS; i++) {
        gpio_set_level(CC1101_PIN_GDO0, (i & 1) == 0);  /* H,L,H,L... */
        esp_rom_delay_us(PROFALUX_TE_US);
    }
    /* Header: silence ~4450us low */
    gpio_set_level(CC1101_PIN_GDO0, 0); esp_rom_delay_us(PROFALUX_HEADER_US);

    /* Data bits MSB first */
    for (size_t i = 0; i < bits; i++) {
        bool b = (frame[i / 8] >> (7 - (i % 8))) & 1;
        ook_bit(b);
    }
    gpio_set_level(CC1101_PIN_GDO0, 0);
    esp_rom_delay_us(2000);  /* Inter-frame gap */
    strobe(CC_SIDLE);
    return 0;
}

/* ── Emission par le RMT ──
 * Meme forme d'onde que le bit-bang ci-dessous, mais chaque duree est tenue par le
 * materiel : une interruption (WiFi) ne peut plus allonger un TE et casser la trame.
 * Le silence entre deux trames est un symbole, lui aussi exact.
 *
 * Memoire RMT : sur ESP32, le canal de reception s_cap prend les 512 symboles, c'est-a-dire
 * les 8 blocs ; il ne reste rien pour un canal d'emission permanent. La reception est de
 * toute facon coupee pendant une emission : on la libere, on cree un canal d'emission de
 * SOC_RMT_MEM_WORDS_PER_CHANNEL symboles (l'encodeur le recharge au fil de l'eau), on emet,
 * puis on rend GDO0 au GPIO et on recree la reception a l'identique. */
#define TX_SYM_MAX (PROFALUX_PREAMBLE_ELEMENTS / 2 + 1 + 80)   /* preambule + entete + 80 bits */
_Static_assert(PROFALUX_PREAMBLE_ELEMENTS % 2 == 1, "le dernier element haut du preambule est suivi de l'entete");
static rmt_symbol_word_t s_txsym[2][TX_SYM_MAX];   /* 1re trame, et repetitions (sous le mutex radio) */

/* Une trame en symboles RMT (1 tic = 1 us). rpt65 = valeur forcee du bit 65, ou 0 pour le
 * laisser tel quel ; gap = silence apres la trame. Renvoie le nombre de symboles. */
static size_t tx_frame_syms(rmt_symbol_word_t *sy, const char *bits, int n, char rpt65,
                            uint32_t te, uint32_t te2, uint32_t hdr, uint32_t gap) {
    size_t k = 0;
    for (int i = 0; i + 1 < PROFALUX_PREAMBLE_ELEMENTS; i += 2)   /* H,L,H,L... (Te chacun) */
        sy[k++] = (rmt_symbol_word_t){ .duration0 = te, .level0 = 1, .duration1 = te, .level1 = 0 };
    sy[k++] = (rmt_symbol_word_t){ .duration0 = te, .level0 = 1, .duration1 = hdr, .level1 = 0 };
    for (int i = 0; i < n && k < TX_SYM_MAX; i++) {
        const char b = (rpt65 && i == 65) ? rpt65 : bits[i];
        sy[k++] = (b == '1')
            ? (rmt_symbol_word_t){ .duration0 = te,  .level0 = 1, .duration1 = te2, .level1 = 0 }
            : (rmt_symbol_word_t){ .duration0 = te2, .level0 = 1, .duration1 = te,  .level1 = 0 };
    }
    sy[k - 1].duration1 += gap;   /* bas du dernier bit + silence (< 32767 us : tient sur 15 bits) */
    return k;
}

/* Emet la rafale par le RMT. Appele en TX (STX fait), reception desactivee. Renvoie 0 si
 * la rafale est partie ; sinon -1, rien n'a ete emis et l'appelant passe au bit-bang.
 * Dans les deux cas, la reception est recreee et active en sortie. */
static int tx_rmt_burst(const char *bits, int n, int repeats, bool rpt,
                        uint32_t te, uint32_t te2, uint32_t hdr, uint32_t gap) {
    if (s_cap) { rmt_del_channel(s_cap); s_cap = NULL; }   /* deja desactive par l'appelant */
    rmt_channel_handle_t tx = NULL;
    rmt_encoder_handle_t enc = NULL;
    rmt_tx_channel_config_t tc = {
        .gpio_num = CC1101_PIN_GDO0, .clk_src = RMT_CLK_SRC_DEFAULT, .resolution_hz = 1000000,
        .mem_block_symbols = SOC_RMT_MEM_WORDS_PER_CHANNEL, .trans_queue_depth = 4,
    };
    rmt_copy_encoder_config_t ec = {};   /* structure vide */
    int rc = -1;
    if (rmt_new_tx_channel(&tc, &tx) != ESP_OK) { tx = NULL; ESP_LOGW(TAG, "TX RMT : canal KO, bit-bang"); goto out; }
    if (rmt_new_copy_encoder(&ec, &enc) != ESP_OK) { enc = NULL; ESP_LOGW(TAG, "TX RMT : encodeur KO, bit-bang"); goto out; }
    if (rmt_enable(tx) != ESP_OK) { ESP_LOGW(TAG, "TX RMT : activation KO, bit-bang"); goto out; }
    /* 1re trame (RPT force a 0 si l'option est active), puis les repetitions (RPT a 1). */
    size_t n0 = tx_frame_syms(s_txsym[0], bits, n, rpt ? '0' : 0, te, te2, hdr, gap);
    size_t n1 = tx_frame_syms(s_txsym[1], bits, n, rpt ? '1' : 0, te, te2, hdr, gap);
    rmt_transmit_config_t xc = { .loop_count = 0, .flags.eot_level = 0 };
    const int64_t t0 = esp_timer_get_time();
    rc = 0;
    for (int r = 0; r < repeats && rc == 0; r++) {   /* en file : les trames s'enchainent sans trou */
        if (rmt_transmit(tx, enc, r ? s_txsym[1] : s_txsym[0], (r ? n1 : n0) * sizeof(rmt_symbol_word_t), &xc) != ESP_OK)
            rc = r ? -2 : -1;   /* -2 : une partie est partie, on n'en remet pas une couche en bit-bang */
    }
    if (rmt_tx_wait_all_done(tx, 5000) != ESP_OK) ESP_LOGW(TAG, "TX RMT : fin de rafale non confirmee");
    /* Duree mesuree : la rafale dure repeats x (trame + silence), au tic pres. Un ecart
     * signale un probleme d'emission. */
    else ESP_LOGW(TAG, "TX RMT : %d trame(s) en %lld ms (attendu ~%lu ms)", repeats,
                  (long long)((esp_timer_get_time() - t0) / 1000),
                  (unsigned long)((uint64_t)repeats * (PROFALUX_PREAMBLE_ELEMENTS * te + hdr
                                  + (uint64_t)n * (te + te2) + gap) / 1000));
    rmt_disable(tx);
out:
    if (enc) rmt_del_encoder(enc);
    if (tx) rmt_del_channel(tx);
    /* GDO0 rendu au GPIO (sortie bas) pour le bit-bang et l'auto-test, puis reception recreee. */
    gpio_set_level(CC1101_PIN_GDO0, 0);
    esp_rom_gpio_connect_out_signal(CC1101_PIN_GDO0, SIG_GPIO_OUT_IDX, false, false);
    gpio_set_direction(CC1101_PIN_GDO0, GPIO_MODE_INPUT_OUTPUT);
    if (cc1101_capture_init() != 0) ESP_LOGE(TAG, "TX RMT : reception non recreee");
    memprobe("tx-rmt-fin");
    return rc == -2 ? 0 : rc;
}

/* Rejoue une trame brute (chaine de bits '0'/'1' en ordre du fil) en OOK :
 * preambule + entete + symboles HCS30x. Sert au replay d'une trame captee. */
int cc1101_tx_raw_bits(const char *bits, int n, int repeats) {
    memprobe("tx-debut");
    /* UNE seule session TX (un STX, FS_AUTOCAL calibre le PLL), puis `repeats` trames dos-a-dos
     * = une vraie rafale de telecommande. Evite un STX/calibration par trame et rend l'emission
     * plus fiable (le bit-bang reste sensible a la preemption, d'ou plusieurs trames). */
    if (repeats < 1) repeats = 1;
    /* CRITIQUE : couper la capture RMT pendant le bit-bang. Sinon la RMT ecoute GDO0
     * (l'ecoute permanente l'a armee), capte notre propre TX, deborde ("hw buffer too
     * small") et son ISR PREEMPTE le bit-bang -> timing 455/910 us deforme -> trame
     * invalide -> le moteur l'ignore. Critique en environnement bruite (RMT deborde en
     * continu -> TOUTES les repetitions corrompues). On re-arme apres le SIDLE. */
    if (s_cap) rmt_disable(s_cap);
    gpio_set_direction(CC1101_PIN_GDO0, GPIO_MODE_INPUT_OUTPUT);
    strobe(CC_STX);
    esp_rom_delay_us(800);   /* laisse le PLL se caler + la PA monter avant de moduler */
    g_tx_marc = cc1101_read_reg(CC_MARCSTATE | 0x40) & 0x1F;
    /* Preuve d'emission sur le serie : MARCSTATE 0x13 = la puce est bien en TX (elle module
     * l'antenne). Loggue avant le bit-bang, au point exact ou la trame part. */
    ESP_LOGW(TAG, "TX RAW: emission de %d trame(s) x%d bits, MARCSTATE=0x%02X (%s)",
             repeats, n, g_tx_marc, g_tx_marc == 0x13 ? "TX ACTIF" : "PAS EN TX !");
    /* Timing derive du TE reglable : bit '1'=TE haut/2TE bas, '0'=2TE haut/TE bas,
     * preambule=TE, entete = 10 TE comme la telecommande (l'ancien 4450 x TE / 455 = 9,78 TE
     * raccourcissait l'entete de ~100 us a TE 448). */
    const uint32_t te = s_tx_te[s_active], te2 = 2 * s_tx_te[s_active];
    const uint32_t hdr = PROFALUX_HEADER_TE * s_tx_te[s_active];
    const bool rpt = s_tx_rpt[s_active] && n >= 66;   /* bit 65 = RPT : 0 sur la 1re trame, 1 ensuite */
    if (s_tx_rmt[s_active]) {
        if (tx_rmt_burst(bits, n, repeats, rpt, te, te2, hdr, rpt ? TX_RPT_GAP_MS * 1000 : 2000) == 0) {
            strobe(CC_SIDLE);   /* reception deja recreee et active */
            return 0;
        }
        if (s_cap) rmt_disable(s_cap);   /* repli bit-bang : meme etat qu'avant */
    }
    for (int r = 0; r < repeats; r++) {
        for (int i = 0; i < PROFALUX_PREAMBLE_ELEMENTS; i++) {
            gpio_set_level(CC1101_PIN_GDO0, (i & 1) == 0);
            esp_rom_delay_us(te);
        }
        gpio_set_level(CC1101_PIN_GDO0, 0);
        esp_rom_delay_us(hdr);
        for (int i = 0; i < n; i++) {
            const char b = (rpt && i == 65) ? (r == 0 ? '0' : '1') : bits[i];
            if (b == '1') { gpio_set_level(CC1101_PIN_GDO0, 1); esp_rom_delay_us(te);
                                  gpio_set_level(CC1101_PIN_GDO0, 0); esp_rom_delay_us(te2); }
            else                { gpio_set_level(CC1101_PIN_GDO0, 1); esp_rom_delay_us(te2);
                                  gpio_set_level(CC1101_PIN_GDO0, 0); esp_rom_delay_us(te); }
        }
        gpio_set_level(CC1101_PIN_GDO0, 0);
        if (rpt) vTaskDelay(pdMS_TO_TICKS(TX_RPT_GAP_MS));   /* silence de la telecommande, porteuse coupee */
        else     esp_rom_delay_us(2000);   /* gap inter-trame */
    }
    strobe(CC_SIDLE);
    if (s_cap) rmt_enable(s_cap);   /* re-arme la capture RMT pour l'ecoute permanente suivante */
    return 0;
}

/* Train d'impulsions OOK brut (voir cc1101.h). Memes precautions que cc1101_tx_raw_bits :
 * capture RMT coupee pendant le bit-bang (sinon son ISR preempte le timing et le deforme),
 * GDO0 en sortie, un seul STX, capture re-armee au SIDLE. Le TX n'a pas besoin de la bande
 * RX : seule la frequence porteuse compte, et l'appelant l'a deja posee. */
int cc1101_tx_ook_pulses(const uint8_t *levels, const uint32_t *us, int n) {
    if (!levels || !us || n <= 0) return -1;
    if (s_cap) rmt_disable(s_cap);
    gpio_set_direction(CC1101_PIN_GDO0, GPIO_MODE_INPUT_OUTPUT);
    strobe(CC_STX);
    esp_rom_delay_us(800);   /* laisse le PLL se caler + la PA monter avant de moduler */
    for (int i = 0; i < n; i++) {
        gpio_set_level(CC1101_PIN_GDO0, levels[i] ? 1 : 0);
        esp_rom_delay_us(us[i]);
    }
    gpio_set_level(CC1101_PIN_GDO0, 0);
    strobe(CC_SIDLE);
    if (s_cap) rmt_enable(s_cap);
    return 0;
}

/* ── Auto-capture : le RMT lit GDO0 pendant qu'on bit-bang (verifie la trame). ── */
static bool IRAM_ATTR cc_cap_cb(rmt_channel_handle_t ch, const rmt_rx_done_event_data_t *e, void *ctx) {
    BaseType_t hp = pdFALSE; xQueueSendFromISR((QueueHandle_t)ctx, e, &hp); return hp == pdTRUE;
}

int cc1101_capture_init(void) {
    if (s_cap) return 0;
    if (!s_capq) s_capq = xQueueCreate(8, sizeof(rmt_rx_done_event_data_t));   /* une seule file : la reception est recreee apres chaque emission RMT */  /* marge : en_partial_rx genere
                                 * plusieurs callbacks par reception ; eviter de perdre un fragment
                                 * si le consommateur (log DEBUG) ralentit. */
    rmt_rx_channel_config_t c = {0};
    c.clk_src = RMT_CLK_SRC_DEFAULT; c.resolution_hz = 1000000;
    /* Une trame entiere (~132 symboles) doit tenir dans UN buffer RX, sinon la
     * capture est hachee en pleine trame et le decode echoue (vu sur ISNO Super/S3).
     *
     * DEUX drapeaux decident, et ils ne vont pas ensemble (verifie dans l'ESP-IDF
     * v6.1). Le second a coute la regression v0.2.6, cf issue #12 : il manquait a
     * ce tableau.
     *
     *   cible    words/canal   SUPPORT_DMA   SUPPORT_RX_PINGPONG
     *   esp32         64        absent        absent
     *   esp32s3       48        1             1
     *   esp32c3       48        absent        1
     *   esp32c6       48        absent        1
     *
     * Donc le S3 est SEUL a avoir le DMA, mais le C3 et le C6 ont le ping-pong :
     * en_partial_rx leur convient, un grand buffer non.
     *
     * - ESP32 classic : pas de DMA, mais 512 symboles tiennent en multi-blocs.
     * - S3 : 48 words/canal seulement, donc 512 sans DMA echoue et 48 tronque la
     *   trame. with_dma=true donne un grand buffer -> trame complete.
     * - ⚠️ C3 et C6 : PAS de DMA RMT, donc ils tombent dans le #else a 48 words et
     *   RESTENT TRONQUES. Ce n'est pas corrige pour eux, et aucune de nos cartes
     *   n'est concernee (boards/ ne declare que esp32 et esp32s3). Les corriger
     *   demanderait un autre mecanisme, par exemple une capture par GPIO+timer. */
#if defined(CONFIG_IDF_TARGET_ESP32)
    c.mem_block_symbols = 512;    /* ESP32 : pas de DMA mais 512 en multi-blocs */
#elif SOC_RMT_SUPPORT_DMA
    c.flags.with_dma    = true;   /* S3 seul (le C3 n'a pas le DMA, il ne passe jamais
                                   * ici) : seulement 48 words/canal -> ping-pong bogue
                                   * (#13419) sur une trame >48 symb. Le DMA stream vers un
                                   * grand buffer et evite ce chemin. mem_block_symbols petit
                                   * avec DMA corrompt (#12564) -> on prend tout le buffer. */
    c.mem_block_symbols = CAP_SYMBOLS;
#else
    /* C3, C6 : 48 words, la trame longue sera tronquee (voir ci-dessus). */
    c.mem_block_symbols = SOC_RMT_MEM_WORDS_PER_CHANNEL;
#endif
    c.gpio_num = CC1101_PIN_GDO0;
    if (rmt_new_rx_channel(&c, &s_cap) != ESP_OK) { ESP_LOGW(TAG, "RMT capture init KO"); s_cap = NULL; return -1; }
    /* Buffer RX aligne + DMA-capable (voir note sur s_capbuf). */
    if (!s_capbuf) {
        s_capbuf_sz = CAP_SYMBOLS * sizeof(rmt_symbol_word_t);
        s_capbuf = heap_caps_aligned_alloc(64, s_capbuf_sz, MALLOC_CAP_DMA | MALLOC_CAP_INTERNAL | MALLOC_CAP_8BIT);
        if (!s_capbuf) { ESP_LOGW(TAG, "RMT capture: alloc buffer DMA KO"); rmt_del_channel(s_cap); s_cap = NULL; return -1; }
    }
    rmt_rx_event_callbacks_t cb = { .on_recv_done = cc_cap_cb };
    rmt_rx_register_event_callbacks(s_cap, &cb, s_capq);
    rmt_enable(s_cap);
    /* RMT met GDO0 en input : on re-active la sortie pour pouvoir bit-banger */
    gpio_set_direction(CC1101_PIN_GDO0, GPIO_MODE_INPUT_OUTPUT);
    return 0;
}

/* Emet la trame ET capture GDO0, decode la forme d'onde en bits (ordre du fil).
 * Retourne le nombre de bits decodes (<0 = erreur). bit=1 si HAUT court (H<680us). */
/* decode_rmt : fin wrapper autour du decodeur PUR keeloq_decode() (unite keeloq_decode.c,
 * testee sur hote dans firmware/test/keeloq). On caste le buffer RMT en kq_sym_t (meme
 * disposition binaire, cf _Static_assert plus haut) et on met a jour le TE mesure
 * (diagnostic). Tout le decodage (de-glitch, scan entetes, vote) vit dans l'unite. */
static int decode_rmt(const rmt_symbol_word_t *raw, size_t n, char *out, int max_bits) {
    int te = 0;
    int r = keeloq_decode((const kq_sym_t *)raw, n, out, max_bits, &te);
    if (te) s_last_te = te;
    return r;
}

int cc1101_tx_and_capture_bits(const uint8_t *frame, size_t bits, char *out_bits, int max_bits) {
    if (!s_cap && cc1101_capture_init() != 0) return -1;
    gpio_set_direction(CC1101_PIN_GDO0, GPIO_MODE_INPUT_OUTPUT);   /* on pilote GDO0 (TX) */
    rmt_receive_config_t rc = { .signal_range_min_ns = 2000, .signal_range_max_ns = 6000000 };
    if (rmt_receive(s_cap, s_capbuf, s_capbuf_sz, &rc) != ESP_OK) return -2;
    cc1101_tx_ook_frame(frame, bits);         /* bit-bang GDO0, RMT capture en parallele */
    rmt_rx_done_event_data_t ev;
    if (xQueueReceive(s_capq, &ev, pdMS_TO_TICKS(500)) != pdTRUE) return -3;
    return decode_rmt(ev.received_symbols, ev.num_symbols, out_bits, max_bits);
}

/* Ecoute (RX) pendant timeout_ms : bascule la puce en RX, capture GDO0 (donnee
 * demodulee) et decode la 1re trame recue. Retourne nbits (<0 = rien / erreur). */
/* Sonde de bruit RX : arme la reception a vide ~800 ms, compte les evenements RMT
 * (= activite bruit OOK) et suit le RSSI. Sert a comparer objectivement un module/antenne :
 * MOINS d'evenements = moins de bruit qui inonde le buffer = meilleur pour l'ecoute continue. */
int cc1101_rx_probe(void) {
    if (!s_cap && cc1101_capture_init() != 0) return -1;
    gpio_set_direction(CC1101_PIN_GDO0, GPIO_MODE_INPUT);
    cc1101_write_reg(0x02, 0x0D); cc1101_write_reg(0x0B, 0x06); cc1101_write_reg(0x19, 0x14);
    cc1101_write_reg(0x1B, s_rx_gain[s_active]); cc1101_write_reg(0x1C, 0x00); cc1101_write_reg(0x1D, 0x91);   /* AGC : meme reglage que l'ecoute (rx_listen_bits) */
    strobe(CC_SIDLE); esp_rom_delay_us(200);
    strobe(0x33); vTaskDelay(pdMS_TO_TICKS(3));
    strobe(0x3A); strobe(0x34);
    for (int i = 0; i < 50; i++) { if ((cc1101_read_reg(CC_MARCSTATE | 0x40) & 0x1F) == 0x0D) break; vTaskDelay(pdMS_TO_TICKS(1)); }
    rmt_disable(s_cap); rmt_enable(s_cap); xQueueReset(s_capq);
    rmt_receive_config_t rc = { .signal_range_min_ns = 3000, .signal_range_max_ns = 8000000 };
    int64_t t_end = esp_timer_get_time() + 800 * 1000;
    int nev = 0; int8_t rssi_max = -128, rssi_min = 0;
    rmt_rx_done_event_data_t ev;
    if (rmt_receive(s_cap, s_capbuf, s_capbuf_sz, &rc) == ESP_OK) {
        while (esp_timer_get_time() < t_end) {
            int8_t r = cc1101_get_rssi(); if (r > rssi_max) rssi_max = r; if (r < rssi_min) rssi_min = r;
            if (xQueueReceive(s_capq, &ev, pdMS_TO_TICKS(40)) != pdTRUE) continue;
            nev++;
            if (rmt_receive(s_cap, s_capbuf, s_capbuf_sz, &rc) != ESP_OK) break;
        }
    }
    strobe(CC_SIDLE);
    gpio_set_direction(CC1101_PIN_GDO0, GPIO_MODE_INPUT_OUTPUT);
    ESP_LOGI(TAG, "RX PROBE bruit: RSSI %d..%d dBm, %d evt RMT en 800ms (moins d'evt = moins de bruit/flood)",
             rssi_min, rssi_max, nev);
    return nev;
}

/* Log DIAG d'une capture (commun aux deux chemins S3/ESP32). sym/nsym = symboles bruts
 * a dumper, nbits/out = resultat du decode. Ne logge que si le switch DEBUG est ON et la
 * capture est "interessante" (entete trouvee ou grosse rafale). */
static void diag_log_capture(const rmt_symbol_word_t *sym, size_t nsym, int nbits, const char *out) {
    if (!(s_rx_debug && (nbits >= 1 || nsym >= 50))) return;
    int8_t drssi = cc1101_get_rssi();
    if (nbits >= 64)
        ESP_LOGW(TAG, "DIAG RX: %u symb, RSSI %d dBm, %d bits => TRAME PROFALUX/KEELOQ complete: %s",
                 (unsigned)nsym, drssi, nbits, out);
    else if (nbits >= 1)
        ESP_LOGW(TAG, "DIAG RX: %u symb, RSSI %d dBm, entete HCS OK mais %d bits (partiel): %s",
                 (unsigned)nsym, drssi, nbits, out);
    else
        ESP_LOGW(TAG, "DIAG RX: %u symb, RSSI %d dBm, PAS d'entete HCS (ou bruit)", (unsigned)nsym, drssi);
    if (drssi > -70) {   /* signal fort : dump des durees brutes des 1res impulsions (us) */
        int8_t fq = (int8_t)cc1101_read_reg(CC_FREQEST | 0x40);
        int fq_khz = (int)fq * 1587 / 1000;
        char dbuf[320]; int p = 0;
        int lim = nsym < 20 ? (int)nsym : 20;
        for (int k = 0; k < lim && p < 300; k++)
            p += snprintf(dbuf + p, sizeof(dbuf) - p, "%c%u %c%u ",
                          sym[k].level0 ? 'H' : 'L', (unsigned)sym[k].duration0,
                          sym[k].level1 ? 'H' : 'L', (unsigned)sym[k].duration1);
        ESP_LOGW(TAG, "DIAG RAW (RSSI %d, FREQEST %d ~%d kHz, %d/%u symb, us): %s",
                 drssi, fq, fq_khz, lim, (unsigned)nsym, dbuf);
    }
}

int cc1101_rx_listen_bits(uint32_t timeout_ms, char *out_bits, int max_bits) {
    /* RX sur GDO0 (GPIO25) comme le sniffer. On REUTILISE l'unique canal RMT s_cap :
     * l'ESP32 n'a pas assez de memoire RMT pour un 2e canal de 512 symboles
     * ("no free rx channels"). GDO0 est prouve OK par le SELFVERIFY au boot. */
    if (!s_cap && cc1101_capture_init() != 0) return -1;
    /* GDO0 en INPUT : la CC1101 (RX, IOCFG0=0x0D) sort la donnee demodulee, on la lit */
    gpio_set_direction(CC1101_PIN_GDO0, GPIO_MODE_INPUT);
    cc1101_write_reg(0x02, 0x0D);   /* IOCFG0 = donnee serie demodulee sur GDO0 */
    cc1101_write_reg(0x0B, 0x06);   /* FSCTRL1 */
    cc1101_write_reg(0x19, 0x14);   /* FOCCFG  */
    cc1101_write_reg(0x1B, s_rx_gain[s_active]);   /* AGCCTRL2 : plafond de gain RX REGLABLE via l'UI (defaut 0x27)
                                     * et resultat de la calibration. Le 0x04 fige "TI DN022" introduit en
                                     * v0.2.6 degradait la reception en terrain : l'ancienne valeur recoit
                                     * mieux (retours issues #1 eleroy et #59 joha38, rollback = RX revient).
                                     * On restaure donc le reglage. Voir cc1101_set_rx_gain(). */
    cc1101_write_reg(0x1C, 0x00);   /* AGCCTRL1 */
    cc1101_write_reg(0x1D, 0x91);   /* AGCCTRL0 : frontiere de decision ASK/OOK a 8 dB. Le passage a 12 dB
                                     * (0x92) en v0.2.6 ratait des trames faibles a l'enrolement, on revient a 8. */
    strobe(CC_SIDLE); esp_rom_delay_us(200);
    strobe(0x33);     /* SCAL */
    vTaskDelay(pdMS_TO_TICKS(3));
    strobe(0x3A);     /* SFRX */
    strobe(0x34);     /* SRX */
    for (int i = 0; i < 50; i++) {
        if ((cc1101_read_reg(CC_MARCSTATE | 0x40) & 0x1F) == 0x0D) break;
        vTaskDelay(pdMS_TO_TICKS(1));
    }
    ESP_LOGI(TAG, "RX(GDO0): MARCSTATE=0x%02X (0x0D=RX attendu)", cc1101_read_reg(CC_MARCSTATE | 0x40) & 0x1F);
    /* OOK sans squelch => bruit continu sur GDO0. Une rafale Profalux (preambule + entete
     * + 66 bits) est repetee ~10x. DEUX chemins selon la puce (cf issue #12) :
     *  - S3/C3 (SOC_RMT_SUPPORT_RX_PINGPONG) : en_partial_rx -> le driver remplit s_capbuf
     *    de facon CONTIGUE sur plusieurs callbacks d'UNE meme reception ; on accumule et on
     *    decode tout le buffer (vote majoritaire dans decode_rmt sur les repetitions), on ne
     *    re-arme qu'a la fin de reception (is_last) ou avant que le buffer ne reboucle.
     *  - ESP32 classique : PAS de ping-pong RX -> ESP-IDF v6.1 REFUSE en_partial_rx
     *    (rmt_rx.c: ESP_ERR_NOT_SUPPORTED) et rmt_receive echoue (regression v0.2.6). On
     *    garde donc l'ancien fonctionnement : une reception = un evenement delimite par
     *    l'idle, on decode l'evenement, on re-arme. */
    rmt_disable(s_cap); rmt_enable(s_cap); xQueueReset(s_capq);
    int64_t t_end = esp_timer_get_time() + (int64_t)timeout_ms * 1000;
    int r = -3;
    rmt_rx_done_event_data_t ev;
#if SOC_RMT_SUPPORT_RX_PINGPONG
    /* signal_range_max_ns plafonne a 32767000 ns (compteur 15 bits). 32 ms > la garde HCS
     * (~16-23 ms) -> toute la rafale s'accumule dans UNE reception. en_partial_rx requis. */
    rmt_receive_config_t rc = { .signal_range_min_ns = 3000, .signal_range_max_ns = 32000000,
                                .flags.en_partial_rx = true };
    const size_t cap = CAP_SYMBOLS;   /* capacite du buffer, en symboles */
    size_t prev_end = 0;              /* fin (offset) du fragment precedent, pour detecter le wrap */
    if (rmt_receive(s_cap, s_capbuf, s_capbuf_sz, &rc) == ESP_OK) {
        while (esp_timer_get_time() < t_end) {
            if (xQueueReceive(s_capq, &ev, pdMS_TO_TICKS(100)) != pdTRUE) continue;  /* tjrs en RX */
            /* en_partial_rx : fin reelle calculee a partir du POINTEUR (robuste a un
             * callback manque : les symboles intermediaires sont bien dans s_capbuf). */
            size_t off = (size_t)(ev.received_symbols - s_capbuf);
            if (off < prev_end) {   /* le buffer a reboucle : on repart sur une capture neuve */
                rmt_disable(s_cap); rmt_enable(s_cap); xQueueReset(s_capq); prev_end = 0;
                if (rmt_receive(s_cap, s_capbuf, s_capbuf_sz, &rc) != ESP_OK) break;
                continue;
            }
            size_t end = off + ev.num_symbols;
            if (end > cap) end = cap;
            prev_end = end;
            int n = decode_rmt(s_capbuf, end, out_bits, max_bits);
            diag_log_capture(s_capbuf, end, n, out_bits);
            if (n >= 64) { r = n; break; }                                  /* vraie trame */
            if (ev.flags.is_last || end >= cap - 160) {   /* fin de reception / wrap imminent */
                rmt_disable(s_cap); rmt_enable(s_cap); xQueueReset(s_capq); prev_end = 0;
                if (rmt_receive(s_cap, s_capbuf, s_capbuf_sz, &rc) != ESP_OK) break;
            }
        }
    } else r = -2;
#else
    /* ESP32 classique (pas de ping-pong RX) : en_partial_rx INTERDIT. Une reception =
     * un evenement (idle a 8 ms), on decode, on re-arme. decode_rmt (de-glitch + vote)
     * reste commun et tolere le bruit meme sur un seul evenement. */
    rmt_receive_config_t rc = { .signal_range_min_ns = 3000, .signal_range_max_ns = 8000000 };
    if (rmt_receive(s_cap, s_capbuf, s_capbuf_sz, &rc) == ESP_OK) {
        while (esp_timer_get_time() < t_end) {
            if (xQueueReceive(s_capq, &ev, pdMS_TO_TICKS(100)) != pdTRUE) continue;  /* tjrs en RX */
            int n = decode_rmt(ev.received_symbols, ev.num_symbols, out_bits, max_bits);
            diag_log_capture(ev.received_symbols, ev.num_symbols, n, out_bits);
            if (n >= 64) { r = n; break; }                                  /* vraie trame */
            if (rmt_receive(s_cap, s_capbuf, s_capbuf_sz, &rc) != ESP_OK) break;  /* re-arme */
        }
    } else r = -2;
#endif
    strobe(CC_SIDLE);
    gpio_set_direction(CC1101_PIN_GDO0, GPIO_MODE_INPUT_OUTPUT);   /* restaure pour le TX bit-bang */
    return r;
}

/* Profil RX de capture (one-shot) : le PROFIL (profiles.json) declare un debit et une bande
 * passante en unites humaines ; on les pose ici juste avant la prochaine capture, qui les
 * mappe en MDMCFG4/MDMCFG3 puis restaure. 0/0 = garder la config courante (cas agnostique).
 * Aucun octet de registre fige dans le code : la valeur vit dans le profil. */
static uint32_t s_cap_drate_baud = 0, s_cap_bw_khz = 0;
void cc1101_set_capture_rx(uint32_t drate_baud, uint32_t bw_khz) {
    s_cap_drate_baud = drate_baud; s_cap_bw_khz = bw_khz;
}
/* Mappe (debit baud, bande passante kHz) vers MDMCFG4/MDMCFG3, fosc 26 MHz (verifie : l'actuel
 * 0xC6 rend 101,6 kHz). MDMCFG4 = CHANBW_E<<6 | CHANBW_M<<4 | DRATE_E ; MDMCFG3 = DRATE_M.
 * BW = fosc/(8*(4+M)*2^E) ; DRATE = (256+M)*2^E/2^28*fosc. On cherche les (E,M) les plus proches. */
static void cc1101_ook_rx_regs(uint32_t drate_baud, uint32_t bw_khz, uint8_t *mdmcfg4, uint8_t *mdmcfg3) {
    const double fosc = 26000000.0;
    int bw_e = 0, bw_m = 0; double bw_best = 1e18, bw_tgt = (double)bw_khz * 1000.0;
    for (int e = 0; e < 4; e++) for (int m = 0; m < 4; m++) {
        double bw = fosc / (8.0 * (4 + m) * (double)(1u << e));
        if (fabs(bw - bw_tgt) < bw_best) { bw_best = fabs(bw - bw_tgt); bw_e = e; bw_m = m; }
    }
    int dr_e = 0, dr_m = 0; double dr_best = 1e18, dr_tgt = (double)drate_baud;
    for (int e = 0; e < 16; e++) {
        long mm = lround(dr_tgt * 268435456.0 / ((double)(1u << e) * fosc)) - 256;
        if (mm < 0 || mm > 255) continue;
        double rr = (256.0 + (double)mm) * (double)(1u << e) / 268435456.0 * fosc;
        if (fabs(rr - dr_tgt) < dr_best) { dr_best = fabs(rr - dr_tgt); dr_e = e; dr_m = (int)mm; }
    }
    *mdmcfg4 = (uint8_t)(((bw_e & 3) << 6) | ((bw_m & 3) << 4) | (dr_e & 0x0F));
    *mdmcfg3 = (uint8_t)dr_m;
}

/* Capture BRUTE OOK (issue #95) : ecoute idle-delimitee et rend les impulsions brutes
 * (niveau + duree us) SANS decoder - pour rejouer n'importe quelle telecommande OOK a CODE FIXE
 * (portail CAME, capteurs...) que le decodeur Profalux ne connait pas. L'appelant tient le radio
 * (ecoute permanente en pause) et a selectionne la bonne puce (voir radio_capture_raw_on).
 * levels[i]=0|1, us[i]=duree us (resolution RMT = 1 MHz). Rend le nb d'impulsions (>0), <0 si
 * rien/erreur. Code FIXE uniquement : rejouer une trame a code tournant est rejete (il change a
 * chaque appui), ca reste l'affaire des decodeurs dedies (Profalux, io). */
int cc1101_rx_capture_pulses(uint32_t timeout_ms, uint8_t *levels, uint16_t *us, int max, int8_t *rssi_out) {
    if (!levels || !us || max < 2) return -1;
    if (!s_cap && cc1101_capture_init() != 0) return -1;
    /* Profil RX du protocole (depuis profiles.json, via cc1101_set_capture_rx) : regle le debit
     * et la bande passante de demodulation pour CE protocole (CAME : 3800 baud / 135 kHz, contre
     * ~2400 / 102 kHz herites du 868 qui lisaient une sequence fausse). 0/0 = garder la config
     * courante (agnostique). PERSISTANT jusqu'au prochain cc1101_set_capture_rx (pose une fois
     * par l'API, re-utilise a chaque capture suivante) ; restaure les registres a la sortie pour
     * ne pas fuir sur le chemin Profalux. Commodite de TEST : le vrai chemin production passe le
     * profil par capture (UI pyramide -> /api/rejeu/capture), pas par un reglage global. */
    uint8_t mdm4_save = 0, mdm3_save = 0;
    bool mdm_over = (s_cap_drate_baud != 0 && s_cap_bw_khz != 0);
    if (mdm_over) {
        mdm4_save = cc1101_read_reg(CC_MDMCFG4); mdm3_save = cc1101_read_reg(CC_MDMCFG3);
        uint8_t m4 = 0, m3 = 0; cc1101_ook_rx_regs(s_cap_drate_baud, s_cap_bw_khz, &m4, &m3);
        cc1101_write_reg(CC_MDMCFG4, m4); cc1101_write_reg(CC_MDMCFG3, m3);
        ESP_LOGW(TAG, "capture : profil RX %u baud / %u kHz -> MDMCFG4=0x%02X MDMCFG3=0x%02X",
                 (unsigned)s_cap_drate_baud, (unsigned)s_cap_bw_khz, m4, m3);
    }
    /* ⚠️ Armement RX OOK async, calque sur cc1101_rx_listen_bits (meme mode, meme gain
     * s_rx_gain) SAUF AGCCTRL0 : la capture brute se rejoue A L'IDENTIQUE, son enveloppe doit
     * donc etre PROPRE, la ou l'ecoute Profalux passe par un decodeur KeeLoq qui tolere le bave.
     * A factoriser (arm_ook_rx) une fois valide sur une vraie Super. */
    gpio_set_direction(CC1101_PIN_GDO0, GPIO_MODE_INPUT);
    cc1101_write_reg(0x02, 0x0D); cc1101_write_reg(0x0B, 0x06); cc1101_write_reg(0x19, 0x14);
    cc1101_write_reg(0x1B, s_rx_gain[s_active]); cc1101_write_reg(0x1C, 0x00);
    /* AGCCTRL0 : decision ASK/OOK a 8 dB + hysteresis LARGE (0xD1), pas 8 dB simple (0x91)
     * du chemin Profalux. Mesures Pascal 2026-10-31 (portail CAME 433, rfdecode) :
     *  - 8 dB simple (0x91) : l'AGC remonte le gain dans les creux, le slicer bascule sur le
     *    bruit -> parasites 52/55 us, trame illisible (0xc) ;
     *  - 12 dB (0x92) : bruit tue (plus rien <120 us) MAIS le seuil haut RONGE les fronts
     *    (640->555, 320->230, creux gonfles), la separation court/long s'ecrase -> 0xc930 ;
     *  - 8 dB + grande hysteresis (0xD1) : garde les fronts du 8 dB, et la bande morte autour
     *    du seuil tue les re-bascules de bruit dans les creux SANS deplacer le point de decision.
     * But : restaurer le 320/640 propre (le registre n'offre que 8/12/16 dB, pas de 10). #102. */
    cc1101_write_reg(0x1D, 0xD1);
    strobe(CC_SIDLE); esp_rom_delay_us(200);
    strobe(0x33); vTaskDelay(pdMS_TO_TICKS(3));
    strobe(0x3A); strobe(0x34);
    for (int i = 0; i < 50; i++) { if ((cc1101_read_reg(CC_MARCSTATE | 0x40) & 0x1F) == 0x0D) break; vTaskDelay(pdMS_TO_TICKS(1)); }
    rmt_disable(s_cap); rmt_enable(s_cap); xQueueReset(s_capq);
    /* Idle a 8 ms = fin de rafale (une trame, repetitions comprises si le gap inter-trame < 8 ms).
     * min 3 us de-glitche le bruit. Un seul evenement a la fois (pas de partial_rx) : prouve OK
     * sur le S3 par cc1101_rx_probe. */
    rmt_receive_config_t rc = { .signal_range_min_ns = 3000, .signal_range_max_ns = 8000000 };
    int64_t t_end = esp_timer_get_time() + (int64_t)timeout_ms * 1000;
    int n = -3;
    rmt_rx_done_event_data_t ev;
    if (rmt_receive(s_cap, s_capbuf, s_capbuf_sz, &rc) == ESP_OK) {
        while (esp_timer_get_time() < t_end) {
            if (xQueueReceive(s_capq, &ev, pdMS_TO_TICKS(100)) != pdTRUE) continue;   /* tjrs en RX */
            if (ev.num_symbols >= 8) {   /* rafale substantielle : filtre les blips de bruit */
                int k = 0;
                for (size_t i = 0; i < ev.num_symbols && k < max - 1; i++) {
                    const rmt_symbol_word_t *s = &ev.received_symbols[i];
                    if (s->duration0) { levels[k] = (uint8_t)s->level0; us[k] = (uint16_t)s->duration0; k++; }
                    if (k >= max - 1) break;
                    if (s->duration1) { levels[k] = (uint8_t)s->level1; us[k] = (uint16_t)s->duration1; k++; }
                }
                n = k;
                { int8_t rssi = cc1101_get_rssi(); if (rssi_out) *rssi_out = rssi;
                  ESP_LOGW(TAG, "CAPTURE brute : %u symboles -> %d impulsions, RSSI %d dBm",
                           (unsigned)ev.num_symbols, n, rssi); }
                break;
            }
            if (rmt_receive(s_cap, s_capbuf, s_capbuf_sz, &rc) != ESP_OK) break;   /* re-arme */
        }
    } else n = -2;
    if (mdm_over) { cc1101_write_reg(CC_MDMCFG4, mdm4_save); cc1101_write_reg(CC_MDMCFG3, mdm3_save); }
    strobe(CC_SIDLE);
    gpio_set_direction(CC1101_PIN_GDO0, GPIO_MODE_INPUT_OUTPUT);   /* restaure pour le TX bit-bang */
    return n;
}

/* --- RX --- */
static void rx_task(void *pv) {
    ESP_LOGI(TAG, "RX task started");
    strobe(CC_SRX);
    while (s_rx_running) {
        /* TODO: Sample GDO0 with hardware timer + detect preamble + decode bits.
         * This skeleton just polls RSSI and provides infrastructure.
         * Full implementation: use RMT peripheral or GPIO ISR + circular buffer.
         */
        vTaskDelay(pdMS_TO_TICKS(10));
    }
    strobe(CC_SIDLE);
    ESP_LOGI(TAG, "RX task stopped");
    s_rx_task = NULL;
    vTaskDelete(NULL);
}

int cc1101_rx_start(cc1101_rx_cb_t cb) {
    if (s_rx_running) return -1;
    s_rx_cb = cb;
    s_rx_running = true;
    xTaskCreate(rx_task, "cc1101_rx", 4096, NULL, 5, &s_rx_task);
    return 0;
}

int cc1101_rx_stop(void) {
    s_rx_running = false;
    return 0;
}

/* Balayage RSSI (issue #51) : pour chaque frequence, IDLE -> FREQ -> RX (calibration auto du PLL,
 * MCSM0 FS_AUTOCAL) puis RSSI max sur dwell_ms, soit au moins une trame entiere de la
 * telecommande. Filtre RX resserre a 58 kHz pendant le balayage (sommet plus net), frequence et
 * filtre restaures a la fin. RSSI en demi-dB (dBm = valeur / 2). L'appelant tient le radio
 * (ecoute permanente en pause). Rend 0, ou -1 si la puce ne passe pas en RX. */
int cc1101_rssi_scan(const uint32_t *khz, int n, int dwell_ms, int16_t *peak_hdb) {
    const uint32_t f0 = s_freq_khz;
    const uint8_t mdm4 = cc1101_read_reg(CC_MDMCFG4);
    gpio_set_direction(CC1101_PIN_GDO0, GPIO_MODE_INPUT);
    cc1101_write_reg(CC_IOCFG0, 0x0D);
    cc1101_write_reg(0x1B, s_rx_gain[s_active]);   /* AGCCTRL2, AGCCTRL1, AGCCTRL0 : comme l'ecoute (rx_listen_bits) */
    cc1101_write_reg(0x1C, 0x00);
    cc1101_write_reg(0x1D, 0x91);
    cc1101_write_reg(CC_MDMCFG4, (uint8_t)(0xF0 | (mdm4 & 0x0F)));   /* CHANBW 58 kHz, debit inchange */
    int rc = 0;
    for (int i = 0; i < n; i++) {
        uint32_t w = radio_cc1101_freq_word(khz[i]);
        strobe(CC_SIDLE);
        cc1101_write_reg(CC_FREQ2, (w >> 16) & 0xFF);
        cc1101_write_reg(CC_FREQ1, (w >> 8) & 0xFF);
        cc1101_write_reg(CC_FREQ0, w & 0xFF);
        strobe(0x34);   /* SRX (calibre le PLL au passage IDLE -> RX) */
        int k = 0;
        while ((cc1101_read_reg(CC_MARCSTATE | 0x40) & 0x1F) != 0x0D && k++ < 20) esp_rom_delay_us(100);
        if (k >= 20) { rc = -1; peak_hdb[i] = -256; continue; }
        esp_rom_delay_us(500);   /* RSSI valide apres quelques echantillons */
        int16_t best = -256;
        int64_t t_end = esp_timer_get_time() + (int64_t)dwell_ms * 1000;
        while (esp_timer_get_time() < t_end) {
            int8_t raw = (int8_t)cc1101_read_reg(CC_RSSI | 0x40);
            int16_t hdb = (int16_t)(raw - 148);   /* (raw/2 - 74) dBm, en demi-dB */
            if (hdb > best) best = hdb;
            esp_rom_delay_us(300);
        }
        peak_hdb[i] = best;
        if ((i & 3) == 3) vTaskDelay(1);   /* nourrit le watchdog sur un long balayage */
    }
    strobe(CC_SIDLE);
    cc1101_write_reg(CC_MDMCFG4, mdm4);
    cc1101_set_freq_khz(f0);
    gpio_set_direction(CC1101_PIN_GDO0, GPIO_MODE_INPUT_OUTPUT);
    return rc;
}

int8_t cc1101_get_rssi(void) {
    uint8_t r = cc1101_read_reg(CC_RSSI | 0x40);
    return (r >= 128) ? (int8_t)((r - 256) / 2 - 74) : (int8_t)(r / 2 - 74);
}
