Isno-Open/OpenProfalux/firmware/main/shutters.c

/*
 * shutters.c : modele cover OpenProfalux (clone/replay + position time-based).
 * Config persistee en NVS, un document JSON par volet (voir cfg_store.h). Le
 * dataset de trames et le ring RF vivent en SPIFFS (partition "storage").
 */
#include "shutters.h"
#include "cfg_store.h"
#include "cfg_model.h"
#include "remote_battery.h"
#include "pfx_enrol.h"
#include "pfx_keys.h"   /* pfx_key_for_serial : predicat "serial = identite 0x067 valide ?" */
#include "virt_counter.h"   /* compteur des telecommandes virtuelles a la restauration */
#include <string.h>
#include <strings.h>
#include <stdlib.h>
#include <stdio.h>
#include <time.h>
#include <sys/stat.h>
#include "esp_log.h"
#include "esp_timer.h"
#include "nvs_flash.h"
#include "nvs.h"
#include "esp_spiffs.h"
#include "freertos/FreeRTOS.h"
#include "freertos/task.h"
#include "freertos/semphr.h"
#include "cJSON.h"
#include "cc1101.h"
#include "radio.h"
#include "somfy_tx.h"
#include "hardware_config.h"
#include "mqtt_bridge.h"
#include "ota.h"
#include "esp_app_desc.h"   /* esp_app_get_description()->version = version installee */
#include "esp_wifi.h"
#include "wifi_bridge.h"
#include "esp_netif.h"

static const char *TAG = "shutters";
#define TICK_MS 150
#define SH_MAX_HOPS 1024   /* set de hops distincts memorises par serial (4 Ko/serial max) */

/* volet_t et remote_t : definis dans cfg_model.h (modele persistant + serialisation). */
typedef struct { uint32_t t; char serial[SH_SERIAL_LEN]; uint8_t button; uint32_t hop; int8_t rssi; } rfrec_t;
/* LEGER (pas de bits stockes) : les 66 bits sont RECONSTRUITS a la demande depuis serial+bouton+hop
 * (build_frame_bits) pour le rejeu et l'adoption -> permet un ring de 1000 sans exploser la RAM. */

static volet_t  s_volets[SH_MAX_VOLETS];
static int      s_nvolets = 0;
static remote_t s_remotes[SH_MAX_REMOTES];
static int      s_nremotes = 0;
#define RF_RING 1000          /* trames a l'affichage (paginees) ; l'export /api/frames = l'ensemble du dataset */
#define STATUS_RF_SHOW 20     /* nb de trames recentes mises dans /api/status (leger, poll 3 s) ; l'onglet RF pagine via /api/rf */
static rfrec_t  s_rf[RF_RING];
static int      s_rfhead = 0;
static SemaphoreHandle_t s_lock;
static char     s_device[32] = "op";   /* nom appareil (prefixe topics HA) */
static bool     s_mqtt_ready = false;   /* true apres shutters_mqtt_announce() */
static bool     s_log_frames = false;   /* publie toutes les trames captees en MQTT */
static bool     s_mqtt_obey  = true;    /* la carte obeit-elle aux ordres cover MQTT (emission) ? defaut oui */
/* La config persistante, telle que cfg_model.c la lit et l'ecrit. */
static const cfg_model_t s_model = { &s_log_frames, s_remotes, &s_nremotes, s_volets, &s_nvolets };
static bool     s_frames_dirty = false; /* dataset modifie -> a resauvegarder (SPIFFS) */
static bool     s_ring_dirty = false;    /* ring RF modifie -> a resauvegarder (SPIFFS) */
static bool     s_pos_dirty = false;     /* position d'un volet a changer/figer -> sauver la cfg (retenir la position au reboot) */
#define FRAMES_MAX 256                  /* hops distincts persistes (4 Ko, en SPIFFS). Le gros dataset slide s'accumule cote MQTT/HA. */

#define LOCK()   xSemaphoreTake(s_lock, portMAX_DELAY)
#define UNLOCK() xSemaphoreGive(s_lock)

/* ── Liste des telecommandes (SH_MAX_REMOTES places) ── Appeles sous LOCK. */
static char s_remote_refused[SH_SERIAL_LEN];   /* derniere telecommande refusee, liste pleine ("" = aucune) */

/* Telecommandes IGNOREES (bouton UI) : une trame confirmee ne les enregistre plus. Le suivi
 * de position d'un volet n'en depend pas (il passe par les serials du volet). NVS cfg/rem_ignore,
 * CSV. Appeles sous LOCK, sauf ignore_load (boot). */
#define SH_MAX_IGNORED 32
static char s_ignored[SH_MAX_IGNORED][SH_SERIAL_LEN];
static int  s_nignored = 0;

static bool ignored(const char *shex) {
    for (int i = 0; i < s_nignored; i++) if (!strcmp(s_ignored[i], shex)) return true;
    return false;
}
static void ignore_save(void) {
    char csv[SH_MAX_IGNORED * SH_SERIAL_LEN + 1] = "";
    for (int i = 0; i < s_nignored; i++) {
        if (i) strlcat(csv, ",", sizeof(csv));
        strlcat(csv, s_ignored[i], sizeof(csv));
    }
    nvs_handle_t h;
    if (nvs_open("cfg", NVS_READWRITE, &h) != ESP_OK) return;
    nvs_set_str(h, "rem_ignore", csv); nvs_commit(h); nvs_close(h);
}
static void ignore_load(void) {
    char csv[SH_MAX_IGNORED * SH_SERIAL_LEN + 1] = ""; size_t sz = sizeof(csv);
    nvs_handle_t h;
    if (nvs_open("cfg", NVS_READONLY, &h) != ESP_OK) return;
    if (nvs_get_str(h, "rem_ignore", csv, &sz) != ESP_OK) csv[0] = 0;
    nvs_close(h);
    s_nignored = 0;
    for (char *p = csv, *t; s_nignored < SH_MAX_IGNORED && (t = strsep(&p, ",")); )
        if (*t) strlcpy(s_ignored[s_nignored++], t, SH_SERIAL_LEN);
}

static remote_t *remote_find(const char *shex) {
    for (int i = 0; i < s_nremotes; i++) if (!strcmp(s_remotes[i].serial, shex)) return &s_remotes[i];
    return NULL;
}
/* Trouve ou ajoute (sans nom). Liste pleine : refuse, le journalise et le signale a l'UI
 * (/api/status remote_refused) au lieu de l'ignorer en silence (issue #39, zone 5 perdue). */
static remote_t *remote_add(const char *shex) {
    remote_t *rm = remote_find(shex);
    if (rm) return rm;
    if (s_nremotes >= SH_MAX_REMOTES) {
        if (strcmp(s_remote_refused, shex)) {
            ESP_LOGW(TAG, "liste des telecommandes pleine (%d) : %s non enregistree, supprimez-en une inutile",
                     SH_MAX_REMOTES, shex);
            strlcpy(s_remote_refused, shex, SH_SERIAL_LEN);
        }
        return NULL;
    }
    rm = &s_remotes[s_nremotes++];
    memset(rm, 0, sizeof(*rm));
    strlcpy(rm->serial, shex, SH_SERIAL_LEN);
    return rm;
}
/* Serial (0x%07X) d'une trame stockee : bits[32..59], LSB en tete. "" si trame absente. */
static void bits_serial_hex(const char *bits, char *out) {
    out[0] = 0;
    if ((int)strlen(bits) < 60) return;
    uint32_t ser = 0;
    for (int i = 0; i < 28; i++) if (bits[32 + i] == '1') ser |= (1u << i);
    snprintf(out, SH_SERIAL_LEN, "0x%07X", (unsigned)ser);
}
/* Volet qui utilise cette telecommande (serial de suivi, identite virtuelle, ou commande
 * apprise), NULL si aucun. */
static const char *remote_user(const char *shex) {
    for (int i = 0; i < s_nvolets; i++) {
        volet_t *v = &s_volets[i];
        for (int j = 0; j < v->n_serials; j++) if (!strcmp(v->serials[j], shex)) return v->id;
        if (v->virt) {
            char vx[SH_SERIAL_LEN]; snprintf(vx, sizeof(vx), "0x%07X", (unsigned)v->virt_serial);
            if (!strcmp(vx, shex)) return v->id;
        }
        const char *cmds[3] = { v->up, v->down, v->stop };
        for (int k = 0; k < 3; k++) {
            char cx[SH_SERIAL_LEN]; bits_serial_hex(cmds[k], cx);
            if (cx[0] && !strcmp(cx, shex)) return v->id;
        }
    }
    return NULL;
}
/* Retire la telecommande d'index i (et son jeu de trames). */
static void remote_remove(int i) {
    free(s_remotes[i].hops);
    memmove(&s_remotes[i], &s_remotes[i + 1], (size_t)(s_nremotes - i - 1) * sizeof(remote_t));
    s_nremotes--;
    memset(&s_remotes[s_nremotes], 0, sizeof(remote_t));
    s_remote_refused[0] = 0;   /* une place s'est liberee */
}

/* ── Publication MQTT DIFFEREE (anti-deadlock) ──────────────────────────────
 * REGLE ABSOLUE : ne JAMAIS appeler mqtt_pub_raw sous le LOCK. Un handler MQTT
 * entrant (cover/set, set_position...) reprend ce meme LOCK ; publier sous LOCK
 * peut bloquer (outbox pleine, ou la tache MQTT est justement bloquee) -> attente
 * mutuelle = deadlock (httpd/tick/commandes tous figes). On EMPILE le message sous
 * LOCK (malloc seulement, jamais bloquant) puis on PUBLIE apres le UNLOCK via
 * pub_flush(). Voir aussi shutters_on_rx (meme principe, deja applique). */
typedef struct pubmsg { struct pubmsg *next; int qos, retain; char *topic; char *payload; } pubmsg_t;
static pubmsg_t *s_pub_head, *s_pub_tail;   /* file simple, touchee UNIQUEMENT sous LOCK */

/* Empile une publication. Appele SOUS LOCK. Copie topic+payload sur le tas. */
static void pub_defer(const char *topic, const char *payload, int qos, int retain) {
    pubmsg_t *m = malloc(sizeof(*m));
    if (!m) return;
    m->next = NULL; m->qos = qos; m->retain = retain;
    m->topic = strdup(topic); m->payload = strdup(payload);
    if (!m->topic || !m->payload) { free(m->topic); free(m->payload); free(m); return; }
    if (s_pub_tail) s_pub_tail->next = m; else s_pub_head = m;
    s_pub_tail = m;
}

/* Vide la file en publiant HORS LOCK. A appeler APRES chaque UNLOCK qui a empile
 * (jamais en tenant le LOCK : pub_flush reprend le LOCK pour detacher la file). */
static void pub_flush(void) {
    if (!s_pub_head) return;                 /* rapide : rien a publier (course benigne) */
    LOCK(); pubmsg_t *m = s_pub_head; s_pub_head = s_pub_tail = NULL; UNLOCK();
    while (m) {
        pubmsg_t *n = m->next;
        mqtt_pub_raw(m->topic, m->payload, m->qos, m->retain);
        free(m->topic); free(m->payload); free(m);
        m = n;
    }
}

static void update_listening(void);   /* (defini plus bas) : allume le RX si volet appris OU option capture */

static volet_t *find_volet(const char *id) {
    for (int i = 0; i < s_nvolets; i++) if (!strcmp(s_volets[i].id, id)) return &s_volets[i];
    return NULL;
}
/* ZONE : volet appris qui a des suiveurs (voir zone_follow). Une zone n'est
 * jamais suiveuse, et un suiveur n'est jamais une zone : on ne coche que des
 * volets simples. */
static bool is_zone(const volet_t *v) { return !v->central && v->members && *v->members; }
/* Vrai si id figure dans la liste de membres csv. */
static bool in_members(const char *csv, const char *id) {
    char mid[SH_ID_LEN];
    for (const char *p = cfg_members_next(csv, mid); p; p = cfg_members_next(p, mid)) if (!strcmp(mid, id)) return true;
    return false;
}
/* Une zone (ou NULL) dont v est suiveur ; il peut en suivre plusieurs. */
static volet_t *zone_of(const volet_t *v) {
    for (int i = 0; i < s_nvolets; i++) if (is_zone(&s_volets[i]) && in_members(s_volets[i].members, v->id)) return &s_volets[i];
    return NULL;
}
static volet_t *get_or_create(const char *id) {
    volet_t *v = find_volet(id);
    if (v) return v;
    if (s_nvolets >= SH_MAX_VOLETS) return NULL;
    /* Pas de virgule dans un NOUVEAU nom : les membres d'une centrale (et l'ordre
     * d'affichage) sont des listes d'ids separes par des virgules. Coupe en deux,
     * le nom n'y designerait plus le volet, qui ne recevrait jamais les commandes
     * de sa centrale. Un volet existant qui en a une reste utilisable. */
    if (strchr(id, ',')) { ESP_LOGW(TAG, "volet '%s' refuse : virgule dans le nom", id); return NULL; }
    v = &s_volets[s_nvolets++];
    memset(v, 0, sizeof(*v));
    strlcpy(v->id, id, SH_ID_LEN);
    v->position = 50; v->target = -1; v->pub_pos = -1; v->pub_dir = -9; v->orientation = -1;
    v->order = -1;   /* non range : l'UI l'affiche a la fin, dans l'ordre de creation */
    return v;
}

/* nom volet -> slug HA-safe ([a-zA-Z0-9_-]) : espaces/accents interdits dans les topics
 * (decouverte HA ET command/state), sinon commandes/decouverte cassees. */
static void slugify(char *dst, int cap, const char *src) {
    int p = 0;
    for (int k = 0; src[k] && p < cap - 1; k++) {
        char c = src[k];
        dst[p++] = ((c >= 'a' && c <= 'z') || (c >= 'A' && c <= 'Z') || (c >= '0' && c <= '9') || c == '-' || c == '_') ? c : '_';
    }
    dst[p] = 0;
    if (!p && cap > 6) strlcpy(dst, "volet", cap);
}
static volet_t *find_volet_by_slug(const char *slug) {
    char s[SH_ID_LEN];
    for (int i = 0; i < s_nvolets; i++) { slugify(s, sizeof(s), s_volets[i].id); if (!strcmp(s, slug)) return &s_volets[i]; }
    return NULL;
}

/* ── Accesseurs dataset (export des trames captees : hops distincts par telecommande) ── */
int shutters_remote_count(void) { LOCK(); int n = s_nremotes; UNLOCK(); return n; }
int shutters_remote_dump(int i, int from, char *serial, int sser, char *name, int sname, dframe_t *frames, int maxframes) {
    LOCK();
    if (i < 0 || i >= s_nremotes) { UNLOCK(); return -1; }
    strlcpy(serial, s_remotes[i].serial, sser);
    strlcpy(name, s_remotes[i].name, sname);
    int nh = s_remotes[i].nhops, m = nh - from; if (m > maxframes) m = maxframes;
    if (from >= 0 && m > 0 && s_remotes[i].hops) memcpy(frames, s_remotes[i].hops + from, (size_t)m * sizeof(dframe_t));
    UNLOCK();
    return nh < 0 ? 0 : nh;
}

/* ── Persistance JSON <-> NVS ── */
/* La serialisation et le rangement sont dans cfg_model.c / cfg_store.c. Les
 * echecs sont journalises : une NVS pleine faisait autrefois echouer TOUTES les
 * sauvegardes sans le moindre message. */
static esp_err_t save_cfg(void) {
    char key[8] = "";
    esp_err_t e = cfg_model_save(&s_model, key);
    if (e != ESP_OK)
        ESP_LOGE(TAG, "save_cfg ECHEC sur '%s' : %s (%d volets)", key, esp_err_to_name(e), s_nvolets);
    return e;
}
/* Persistance BORNEE du dataset de trames (hops distincts) : survit au reboot, mais
 * plafonnee (FRAMES_MAX). Le GROS dataset (65536) doit vivre cote HA (recorder).
 * Sauvegarde periodique (pas a chaque trame -> menage la flash).
 *
 * En SPIFFS, a cote du ring RF. Il vivait en NVS ("framesv2", jusqu'a 4 Ko) : le plus
 * gros occupant d'une NVS de 16 Ko qui saturait. Donnee NON critique (jeu de trames
 * pour la recherche) : une coupure en pleine ecriture n'en perd au pire que la fin. */
#define FRAMES_FILE "/spiffs/frames.bin"
static void save_frames(void) {
    static uint32_t buf[FRAMES_MAX * 4];   /* records {serial, hop, t, bouton} */
    int n = 0;
    LOCK();
    for (int i = 0; i < s_nremotes && n < FRAMES_MAX; i++) {
        uint32_t ser = (uint32_t)strtoul(s_remotes[i].serial, NULL, 16);
        for (int k = 0; k < s_remotes[i].nhops && n < FRAMES_MAX; k++) {
            dframe_t *d = &s_remotes[i].hops[k];
            buf[n * 4] = ser; buf[n * 4 + 1] = d->hop; buf[n * 4 + 2] = d->t; buf[n * 4 + 3] = d->button; n++;
        }
    }
    s_frames_dirty = false;
    UNLOCK();
    FILE *f = fopen(FRAMES_FILE, "wb");
    if (!f) { ESP_LOGW(TAG, "save_frames: fopen KO"); return; }
    fwrite(buf, 1, (size_t)n * 4 * sizeof(uint32_t), f);
    fclose(f);
}
/* Au boot, apres load_cfg (rattache les hops aux telecommandes). Renvoie true si
 * le dataset est en fichier : son ancienne copie NVS peut alors etre effacee. */
static bool load_frames(void) {
    /* Tampon sur le tas le temps du demarrage, plutot que 4 Ko reserves en permanence
     * pour une lecture faite une fois. Faute de memoire, rien n'est perdu : le dataset
     * reste ou il est, et sa copie NVS n'est pas effacee (on rend false). */
    const size_t cap = FRAMES_MAX * 4 * sizeof(uint32_t);
    uint32_t *buf = malloc(cap);
    if (!buf) { ESP_LOGE(TAG, "load_frames: plus de memoire, dataset laisse en place"); return false; }
    size_t sz = 0;
    /* Fichier, sinon ancienne copie NVS rangee en fichier. La copie NVS n'est
     * effacee (par cfg_store_finish_boot) qu'une fois le fichier en place. */
    bool in_file = cfg_frames_load(FRAMES_FILE, buf, cap, &sz);
    if (sz < 16) { free(buf); return in_file; }
    int n = sz / (4 * sizeof(uint32_t));
    for (int i = 0; i < n; i++) {
        char shex[SH_SERIAL_LEN]; snprintf(shex, sizeof(shex), "0x%07X", (unsigned)buf[i * 4]);
        /* Telecommandes connues seulement : seule une trame confirmee en cree une (issue #39),
         * et une telecommande supprimee ne doit pas revenir par son jeu de trames. */
        remote_t *rm = remote_find(shex);
        if (!rm) continue;
        if (rm->nhops >= rm->caphops && rm->caphops < SH_MAX_HOPS) {
            uint16_t nc = rm->caphops ? (uint16_t)(rm->caphops * 2) : 32; if (nc > SH_MAX_HOPS) nc = SH_MAX_HOPS;
            dframe_t *np = realloc(rm->hops, (size_t)nc * sizeof(dframe_t));
            if (np) { rm->hops = np; rm->caphops = nc; }
        }
        if (rm->nhops < rm->caphops) rm->hops[rm->nhops++] = (dframe_t){ .hop = buf[i * 4 + 1], .t = buf[i * 4 + 2], .button = (uint8_t)buf[i * 4 + 3] };
    }
    free(buf);
    return in_file;
}

/* Reconstruit la trame 66 bits a partir de serial(28)+bouton(4)+hop(32) : format deterministe
 * (radio.c : hop=bits[0..31], serial=bits[32..59], bouton=bits[60..63], LSB-first). Les 2 bits
 * de statut (VLOW/RPT, bits[64..65]) ne sont pas transmis -> 0 (sans effet sur le rejeu). */
static void build_frame_bits(char *out, uint32_t serial, uint8_t button, uint32_t hop) {
    for (int i = 0; i < 32; i++) out[i]      = ((hop    >> i) & 1u) ? '1' : '0';
    for (int i = 0; i < 28; i++) out[32 + i] = ((serial >> i) & 1u) ? '1' : '0';
    for (int i = 0; i < 4;  i++) out[60 + i] = ((button >> i) & 1u) ? '1' : '0';
    out[64] = '0'; out[65] = '0'; out[66] = 0;
}

/* Persistance BORNEE du ring RF en NVS : on ne stocke que les METADONNEES {serial,bouton,hop,t,rssi}
 * (16 o/trame) et on RECONSTRUIT les bits au boot -> les trames restent REJOUABLES apres reboot/flash. */
typedef struct { uint32_t serial, hop, t; uint8_t button; int8_t rssi; uint16_t _pad; } ringrec_t;
#define RING_FILE "/spiffs/rfring.bin"
/* Conversion par blocs de RING_CHUNK, meme format de fichier qu'avant (int head, puis
 * RF_RING enregistrements) : un tampon du ring entier immobilisait 16 Ko de RAM pour
 * une sauvegarde par minute au plus. Partage sans risque : load_ring tourne au
 * demarrage, avant la tache tick_task, seule a appeler save_ring. */
#define RING_CHUNK 64
static ringrec_t s_ringchunk[RING_CHUNK];
static void spiffs_mount(void) {   /* la NVS (16 Ko) ne tient pas le ring 300 -> SPIFFS (partition storage, 960 Ko) */
    esp_vfs_spiffs_conf_t c = { .base_path = "/spiffs", .partition_label = "storage", .max_files = 4, .format_if_mount_failed = true };
    esp_err_t e = esp_vfs_spiffs_register(&c);
    ESP_LOGI(TAG, "spiffs mount: %s", esp_err_to_name(e));
}
/* Le (serial, hop) est-il deja dans le ring ? (dedup : une pression = ~10 repetitions du meme hop).
 * Le hop encode le bouton -> (serial, hop) identique => meme bouton. Caller detient le LOCK (ou boot). */
static bool ring_contains(const char *shex, uint32_t hop) {
    for (int k = 0; k < RF_RING; k++)
        if (s_rf[k].serial[0] && s_rf[k].hop == hop && !strcmp(s_rf[k].serial, shex)) return true;
    return false;
}
static void save_ring(void) {
    FILE *f = fopen(RING_FILE, "wb");
    if (!f) { ESP_LOGW(TAG, "save_ring: fopen KO"); return; }
    int head;
    LOCK();
    head = s_rfhead;
    s_ring_dirty = false;   /* une trame qui arrive pendant l'ecriture relancera une sauvegarde */
    UNLOCK();
    fwrite(&head, sizeof(head), 1, f);
    size_t w = 0;
    for (int i0 = 0; i0 < RF_RING; i0 += RING_CHUNK) {
        int m = RF_RING - i0 < RING_CHUNK ? RF_RING - i0 : RING_CHUNK;
        LOCK();   /* par bloc : le LOCK n'est plus tenu sur les RF_RING conversions */
        for (int j = 0; j < m; j++) {
            rfrec_t *r = &s_rf[i0 + j];
            ringrec_t *o = &s_ringchunk[j];
            o->serial = r->serial[0] ? (uint32_t)strtoul(r->serial, NULL, 16) : 0;
            o->hop = r->hop; o->t = r->t; o->button = r->button; o->rssi = r->rssi; o->_pad = 0;
        }
        UNLOCK();
        w += fwrite(s_ringchunk, 1, (size_t)m * sizeof(ringrec_t), f);
    }
    fclose(f);
    ESP_LOGI(TAG, "save_ring: %d o ecrits (head=%d)", (int)w, head);
}
static void load_ring(void) {   /* boot : restaure le ring + reconstruit les bits (trames rejouables) */
    FILE *f = fopen(RING_FILE, "rb");
    if (!f) { ESP_LOGW(TAG, "load_ring: pas de fichier (rien a charger)"); return; }
    int head = 0;
    if (fread(&head, sizeof(head), 1, f) != 1) { fclose(f); return; }
    (void)head;
    size_t r = 0;
    int loaded = 0;   /* on compacte + on deduplique (nettoie d'eventuels doublons deja en SPIFFS) */
    for (int i0 = 0; i0 < RF_RING && loaded < RF_RING; i0 += RING_CHUNK) {
        size_t want = RF_RING - i0 < RING_CHUNK ? (size_t)(RF_RING - i0) : RING_CHUNK;
        size_t got = fread(s_ringchunk, sizeof(ringrec_t), want, f);   /* enregistrements entiers */
        r += got * sizeof(ringrec_t);
        for (size_t j = 0; j < got && loaded < RF_RING; j++) {
            ringrec_t *c = &s_ringchunk[j];
            if (!c->serial && !c->hop) continue;
            char shex[SH_SERIAL_LEN]; snprintf(shex, sizeof(shex), "0x%07X", (unsigned)c->serial);
            if (ring_contains(shex, c->hop)) continue;   /* dedup (serial, hop) */
            rfrec_t *rr = &s_rf[loaded];
            strlcpy(rr->serial, shex, SH_SERIAL_LEN);
            rr->hop = c->hop; rr->t = c->t; rr->button = c->button; rr->rssi = c->rssi;
            loaded++;
        }
        if (got < want) break;
    }
    fclose(f);
    s_rfhead = loaded % RF_RING;   /* prochaine place libre apres compactage */
    ESP_LOGI(TAG, "load_ring: %d trames rechargees/dedupliquees (%d o)", loaded, (int)r);
}

/* Repeuplement depuis MQTT (frames/log/<slot>) : remplit le slot UNIQUEMENT s'il est vide (NVS vide)
 * -> restaure affichage RF + rejeu + dataset slide. Ne republie rien. Reconcilie aussi la NVS. */
static void ring_fill_from_mqtt(int slot, const char *ser, uint8_t button, uint32_t hop, uint32_t t, int8_t rssi) {
    if (slot < 0 || slot >= RF_RING || !ser || !ser[0]) return;
    LOCK();
    rfrec_t *r = &s_rf[slot];
    if (!r->serial[0] && !ring_contains(ser, hop)) {   /* slot vide ET pas deja present ailleurs (dedup) */
        strlcpy(r->serial, ser, SH_SERIAL_LEN);
        r->button = button; r->hop = hop; r->t = t; r->rssi = rssi;
        s_ring_dirty = true;
        remote_t *rm = remote_find(ser);   /* connues seulement (cf load_frames) */
        if (rm) {
            bool isnew = true;
            for (int i = 0; i < rm->nhops; i++) if (rm->hops[i].hop == hop) { isnew = false; break; }
            if (isnew) {
                if (rm->nhops >= rm->caphops && rm->caphops < SH_MAX_HOPS) {
                    uint16_t nc = rm->caphops ? (uint16_t)(rm->caphops * 2) : 32; if (nc > SH_MAX_HOPS) nc = SH_MAX_HOPS;
                    dframe_t *np = realloc(rm->hops, (size_t)nc * sizeof(dframe_t)); if (np) { rm->hops = np; rm->caphops = nc; }
                }
                if (rm->nhops < rm->caphops) { rm->hops[rm->nhops++] = (dframe_t){ .hop = hop, .t = t, .button = button }; s_frames_dirty = true; }
            }
        }
    }
    UNLOCK();
}

/* Remet la config a zero (libere les sets de hops avant reload/import). */
static void reset_state(void) {
    for (int i = 0; i < s_nremotes; i++) { free(s_remotes[i].hops); s_remotes[i].hops = NULL; s_remotes[i].nhops = s_remotes[i].caphops = 0; }
    for (int i = 0; i < s_nvolets; i++) cfg_volet_release(&s_volets[i]);   /* listes des centrales */
    s_nremotes = 0; s_nvolets = 0;
}
/* Migration (issue #111) : bit de repetition et RMT passent de GLOBAUX box a PAR APPAREIL. ORDRE
 * IMPERATIF : chaque appareil DEJA ENROLE herite de la valeur courante de l'ancien global AVANT que
 * le global ne disparaisse, sinon il retomberait sur le defaut et changerait de comportement. On lit
 * donc l'ancienne cle NVS "cfg" (tx_rpt/tx_rmt), pas l'etat runtime (qui n'est plus restaure au boot).
 * Une fiche deja resolue (valeur != heriter, enrolee par la nouvelle version) n'est pas touchee ;
 * idempotent (une fiche migree n'est plus en 'heriter'). */
static void migrate_tx_overrides(void) {
    nvs_handle_t h;
    if (nvs_open("cfg", NVS_READONLY, &h) != ESP_OK) return;
    uint8_t rp = 0, rm = 0;
    nvs_get_u8(h, "tx_rpt", &rp); nvs_get_u8(h, "tx_rmt", &rm);
    nvs_close(h);
    bool changed = false;
    for (int i = 0; i < s_nvolets; i++) {
        volet_t *v = &s_volets[i];
        if (!(v->virt && (volet_proto_t)v->proto == VOLET_PROTO_PROFALUX)) continue;
        if (v->tx_rpt == TXOVR_INHERIT) { v->tx_rpt = rp ? TXOVR_ON : TXOVR_OFF; changed = true; }
        if (v->tx_rmt == TXOVR_INHERIT) { v->tx_rmt = rm ? TXOVR_ON : TXOVR_OFF; changed = true; }
    }
    if (changed) { ESP_LOGW(TAG, "migration #111 : bit de repetition/RMT (ancien global %d/%d) grave par appareil", rp, rm); save_cfg(); }
}
static cfg_layout_t load_cfg(void) {
    cfg_layout_t lay = cfg_model_load(&s_model);
    for (int i = 0; i < s_nvolets; i++)   /* DIAGNOSTIC : verifie que la calibration est bien relue */
        ESP_LOGI(TAG, "cfg volet '%s' : up=%u ms down=%u ms pos=%d",
                 s_volets[i].id, (unsigned)s_volets[i].travel_up_ms, (unsigned)s_volets[i].travel_down_ms, (int)(s_volets[i].position + 0.5f));
    migrate_tx_overrides();
    return lay;
}

/* ── RF ── */
#define PRESS_REPEATS 10   /* nb de trames par "appui" : le bit-bang peut etre preempte par le WiFi
                              (trame corrompue) ; plus de repetitions = plus de chances qu'une passe propre */
/* Params d'emission RESOLUS depuis la fiche (defini plus bas) : porteuse/TE/rpt/rmt par appareil. */
static tx_params_t tx_params_of(const volet_t *v);

/* Emet une RAFALE = 1 appui de telecommande, en UNE session TX (trames dos-a-dos, une seule
 * calibration) via l'arbitre radio. Le moteur part ensuite tout seul jusqu'au STOP/butee.
 * `v` (optionnel) porte la fiche : si present, emission PAR APPAREIL (porteuse/TE/rpt/rmt de la
 * fiche, appliques puis restaures par radio_tx_device) -> une marque clonee garde SA frequence sur
 * une radio partagee (bug terrain Eveno/Profalux). `v==NULL` = rejeu de trame RF brute sans volet. */
static void emit_press(const volet_t *v, const char *bits) {
    if (!bits || !bits[0]) return;
    /* Log de CE QU'ON EMET (serial/bouton/hop decodes de la trame), symetrique du log RX.
     * Permet de verifier qu'on rejoue bien la trame captee (et de voir le hop emis). */
    int n = (int)strlen(bits);
    if (n >= 64) {
        uint32_t hop = 0, ser = 0; uint8_t btn = 0;
        for (int i = 0; i < 32; i++) if (bits[i]      == '1') hop |= (1u << i);
        for (int i = 0; i < 28; i++) if (bits[32 + i] == '1') ser |= (1u << i);
        for (int i = 0; i < 4;  i++) if (bits[60 + i] == '1') btn |= (1u << i);
        ESP_LOGW(TAG, "TX serial=0x%07X bouton=0x%X hop=0x%08X (%d bits, rafale x%d)",
                 (unsigned)ser, btn, (unsigned)hop, n, PRESS_REPEATS);
    }
    if (v) {
        tx_params_t p = tx_params_of(v);
        radio_tx_device(bits, PRESS_REPEATS, &p);   /* par appareil : porteuse/TE/rpt/rmt de la fiche */
    } else {
        radio_tx(bits, PRESS_REPEATS);              /* trame brute sans volet (rejeu RF debug) */
    }
}

/* ── Rejeu BRUT par commande (code fixe OOK, agnostique : CAME, 433 cheap...) ──
 * Le cadre capte de chaque commande est range dans v->rejeu (JSON {f, up, stop, down} ;
 * chaque valeur = impulsions signees +us haut / -us bas). On le rejoue a l'identique, suivi
 * d'un silence inter-trame, repete. Ne touche ni au clone bit-string ni au virtuel. */
#define REJEU_MAX_PULSES 512
#define REJEU_GAP_US     12000   /* silence inter-trame, couvre le CAME (~11,5 ms) */
#define REJEU_REPEATS    8

/* Rejoue la commande `cmd` ("up"/"stop"/"down") d'un volet a rejeu brut. true si emis. */
static bool rejeu_emit(volet_t *v, const char *cmd) {
    if (!v->rejeu) return false;
    cJSON *j = cJSON_Parse(v->rejeu);
    if (!j) return false;
    /* Frequence d'emission : la fiche (editable dans Modifier, par appareil) prime sur la frequence
     * captee. Permet de faire cohabiter CAME, Profalux et Eveno sur des frequences differentes. */
    uint32_t freq = v->freq_khz ? v->freq_khz : (uint32_t)cJSON_GetNumberValue(cJSON_GetObjectItem(j, "f"));
    const char *csv = cJSON_GetStringValue(cJSON_GetObjectItem(j, cmd));
    /* Portail a bouton UNIQUE (CAME & co) : la telecommande n'a qu'un bouton, le moteur enchaine
     * la sequence lui-meme (ouvre -> stop -> ferme). On ne capture donc qu'une commande ; Ouvrir /
     * Stop / Fermer du pave rejouent la meme trame. Repli : si la commande demandee n'a pas ete
     * captee, on rejoue la premiere commande presente. */
    if (!csv || !*csv)
        for (const char *const *c = (const char *[]){ "up", "stop", "down", NULL }; *c && (!csv || !*csv); c++)
            csv = cJSON_GetStringValue(cJSON_GetObjectItem(j, *c));
    bool ok = false;
    if (csv && *csv && freq) {
        static uint8_t  lvl[REJEU_MAX_PULSES + 1];
        static uint32_t us[REJEU_MAX_PULSES + 1];
        int n = 0;
        for (const char *p = csv; *p && n < REJEU_MAX_PULSES; ) {
            char *end; long d = strtol(p, &end, 10);
            if (end == p) break;
            lvl[n] = d >= 0 ? 1 : 0; us[n] = (uint32_t)(d >= 0 ? d : -d); n++;
            p = end; if (*p == ',') p++;
        }
        if (n >= 2) {
            lvl[n] = 0; us[n] = REJEU_GAP_US; n++;   /* silence inter-trame */
            int r = 0;
            for (int k = 0; k < REJEU_REPEATS && r == 0; k++)
                r = radio_tx_ook_pulses(freq, lvl, us, n);
            ESP_LOGW(TAG, "REJEU brut '%s' cmd=%s : %d impulsions a %u kHz, rc=%d",
                     v->id, cmd, n - 1, (unsigned)freq, r);
            ok = (r == 0);
        }
    }
    cJSON_Delete(j);
    return ok;
}

/* Range le cadre capte (lvl/us, n impulsions) comme commande `cmd` de v, a la frequence freq. */
static int rejeu_store(volet_t *v, const char *cmd, uint32_t freq,
                       const uint8_t *lvl, const uint16_t *us, int n) {
    if (n < 2) return -1;
    char *csv = malloc((size_t)n * 9 + 1);
    if (!csv) return -1;
    int p = 0;
    for (int i = 0; i < n; i++)
        p += snprintf(csv + p, (size_t)n * 9 + 1 - p, "%s%d", i ? "," : "",
                      lvl[i] ? (int)us[i] : -(int)us[i]);
    cJSON *j = v->rejeu ? cJSON_Parse(v->rejeu) : NULL;
    if (!j) j = cJSON_CreateObject();
    cJSON_DeleteItemFromObject(j, "f");   cJSON_AddNumberToObject(j, "f", freq);
    cJSON_DeleteItemFromObject(j, cmd);   cJSON_AddStringToObject(j, cmd, csv);
    char *out = cJSON_PrintUnformatted(j);
    cJSON_Delete(j); free(csv);
    if (!out) return -1;
    free(v->rejeu); v->rejeu = out;   /* out = heap cJSON, libere par cfg_volet_release */
    return 0;
}
/* Rejoue TELLE QUELLE une trame captee (identifiee par serial+hop dans l'anneau RF).
 * Sert au bouton "rejouer" du debug RF : on renvoie la trame brute, sans passer par un volet. */
int shutters_replay_frame(const char *serial, uint32_t hop) {
    if (!serial || !serial[0]) return -1;
    char bits[SH_BITS_LEN] = {0};
    LOCK();
    for (int k = 0; k < RF_RING; k++) {
        rfrec_t *r = &s_rf[k];
        if (r->serial[0] && !strcmp(r->serial, serial) && r->hop == hop) {   /* reconstruit les 66 bits a la demande */
            build_frame_bits(bits, (uint32_t)strtoul(serial, NULL, 16), r->button, hop); break;
        }
    }
    UNLOCK();
    if (!bits[0]) return -2;   /* plus dans l'anneau (ecrasee) */
    emit_press(NULL, bits);    /* trame brute du debug RF : pas de volet, repli global */
    return 0;
}
/* Page de /api/rf, triee par date (recentes d'abord). Sous UN seul LOCK : on trie les
 * (date, place) des trames presentes (8 o chacune, sur le tas le temps de l'appel) et
 * on ne copie que la page. Avant, l'appelant copiait les RF_RING trames dans un tableau
 * statique de 24 Ko (un LOCK par trame), le triait, et n'en renvoyait que 100 au plus.
 * Meme ordre qu'avant, egalites comprises : memes trames, dans le meme ordre de depart
 * (k = 0 la plus recente), meme qsort et meme comparaison (la date seule). */
typedef struct { uint32_t t; uint16_t idx; } rfkey_t;
static int rfkey_cmp(const void *a, const void *b) {   /* t decroissant */
    uint32_t ta = ((const rfkey_t *)a)->t, tb = ((const rfkey_t *)b)->t;
    return (tb > ta) - (tb < ta);
}
int shutters_rf_page(int offset, int limit, shutters_rf_item_t *out, int *nout) {
    *nout = 0;
    rfkey_t *keys = malloc(RF_RING * sizeof(rfkey_t));
    if (!keys) return -1;
    LOCK();
    int n = 0;
    for (int k = 0; k < RF_RING; k++) {
        int idx = (s_rfhead - 1 - k + 2 * RF_RING) % RF_RING;
        if (s_rf[idx].serial[0]) keys[n++] = (rfkey_t){ .t = s_rf[idx].t, .idx = (uint16_t)idx };
    }
    qsort(keys, n, sizeof(rfkey_t), rfkey_cmp);
    int c = 0;
    for (int i = offset < 0 ? 0 : offset; i < n && c < limit; i++, c++) {
        rfrec_t *r = &s_rf[keys[i].idx];
        strlcpy(out[c].serial, r->serial, sizeof(out[c].serial));
        out[c].button = r->button; out[c].hop = r->hop; out[c].t = r->t; out[c].rssi = r->rssi;
    }
    UNLOCK();
    free(keys);
    *nout = c;
    return n;
}
/* bouton (4 bits LSB) d'une trame captee (bits[60..63]). */
static uint8_t bits_button(const char *b) {
    uint8_t v = 0;
    if ((int)strlen(b) >= 64) for (int i = 0; i < 4; i++) if (b[60 + i] == '1') v |= (1u << i);
    return v;
}

/* Volet VIRTUEL Profalux : GENERE la trame (keeloq + compteur roulant), l'emet au TE du
 * boitier, puis avance et persiste le compteur. */
/* Un volet participe a la comptabilite d'enrolement Profalux (identites 0x067, compteurs
 * roulants) seulement s'il est virtuel ET en protocole Profalux. Un volet Somfy RTS porte une
 * adresse 24 bits dans un autre espace de noms : il ne doit ni reserver un creneau 0x067 ni
 * toucher un compteur d'enrolement Profalux, meme si son adresse coincide avec un serial 0x067. */
static inline bool is_pfx_virt(const volet_t *v) {
    return v->virt && (volet_proto_t)v->proto == VOLET_PROTO_PROFALUX;
}

/* Params d'emission RESOLUS depuis la fiche de l'appareil (etage 2, issue #111). On NE code PAS de
 * defaut ici : la source unique des defauts est profiles.json, resolue par le navigateur, qui grave
 * les valeurs concretes du profil dans la fiche a la creation (regle "une configuration, un seul
 * fichier"). Le firmware lit donc des valeurs concretes. Pour une fiche heritee (0 / TXOVR_INHERIT,
 * legacy pre-pyramide), les sentinelles (freq/te 0, rpt/rmt -1) disent a radio_tx_device de GARDER le
 * reglage radio courant : un repli invisible, pas une definition de defaut dupliquee. */
static tx_params_t tx_params_of(const volet_t *v) {
    tx_params_t p = {
        .freq_khz = v->freq_khz,
        .te_us    = v->te_us,
        .rpt = v->tx_rpt == TXOVR_ON ? 1 : v->tx_rpt == TXOVR_OFF ? 0 : -1,
        .rmt = v->tx_rmt == TXOVR_ON ? 1 : v->tx_rmt == TXOVR_OFF ? 0 : -1,
    };
    return p;
}

static bool emit_virt_profalux(volet_t *v, uint8_t button) {
    char bits[68];
    uint16_t cnt = v->virt_counter;
    if (pfx_enrol_frame(v->virt_serial, button, cnt, bits) != 0) return false;   /* rien emis */
    /* Réserve-puis-émets : on persiste le PROCHAIN compteur AVANT d'émettre. Un crash entre les
     * deux fait au pire sauter un compteur (toléré par la fenêtre KeeLoq), jamais un rejeu. */
    v->virt_counter = cnt + 1;
    save_cfg();
    tx_params_t p = tx_params_of(v);
    radio_tx_device(bits, PRESS_REPEATS, &p);
    ESP_LOGW(TAG, "TX VIRT serial=0x%07X btn=0x%X cnt=%u te=%u",
             (unsigned)v->virt_serial, button, cnt, (unsigned)cc1101_get_tx_te());
    return true;
}

/* Volet VIRTUEL Somfy RTS : GENERE la trame (adresse + code roulant), puis l'emet a
 * 433,42 MHz par le module somfy_tx, sans toucher au chemin Profalux. virt_serial sert
 * d'adresse (24 bits) et virt_counter de code roulant : memes champs que la telecommande
 * virtuelle Profalux, reinterpretes par protocole. Reserve-puis-emet comme Profalux : on
 * persiste le PROCHAIN code AVANT d'emettre (au pire un code saute, jamais un rejeu). */
static void somfy_emit_cmd(volet_t *v, somfy_rts_cmd_t cmd) {
    uint16_t code = v->virt_counter;
    somfy_rts_remote_t r = { .address = v->virt_serial & 0xFFFFFF, .rolling_code = code };
    uint8_t frame[SOMFY_RTS_FRAME_BYTES];
    somfy_rts_remote_next(&r, cmd, frame);   /* trame + incrementation du code roulant */
    v->virt_counter = r.rolling_code;
    save_cfg();
    /* Format de trame PAR VOLET (fiche, issue #73) : 56 bits par defaut (rafale COURTE, comme la vraie
     * telecommande) ; 80 bits = format etendu (somfy_tx_emit80) pour les recepteurs qui l'exigent. Sur un
     * BSO a lames, c'est la DUREE de l'appui qui decide course/orientation, pas le format : la rafale
     * courte fait la course complete dans les deux cas. frame_bits 0 (defaut memset) = 56. */
    if (v->frame_bits == 80) somfy_tx_emit80(frame, cmd, SOMFY_RTS_TX_REPEATS, v->freq_khz);
    else                     somfy_tx_emit(frame, SOMFY_RTS_TX_REPEATS, v->freq_khz);
    ESP_LOGW(TAG, "TX SOMFY addr=0x%06X cmd=0x%X code=%u",
             (unsigned)(v->virt_serial & 0xFFFFFF), cmd, (unsigned)code);
}
static bool emit_virt_somfy(volet_t *v, uint8_t button) {
    somfy_emit_cmd(v, somfy_tx_cmd_from_button(button));
    return true;
}

/* Emission d'un volet virtuel, aiguillee par son protocole. Profalux/KeeLoq et Somfy RTS
 * (issue #73) sont cables ; chaque protocole porte sa propre radio, sans toucher aux
 * autres. `button` est un code PFX_BTN_*, traduit par protocole. Renvoie true si une trame a
 * ete emise : un protocole non cable (ou une trame Profalux non construite) renvoie false, pour
 * que l'appelant ne simule pas un mouvement qui n'a rien envoye au moteur. */
static bool emit_virt(volet_t *v, uint8_t button) {
    switch ((volet_proto_t)v->proto) {
    case VOLET_PROTO_PROFALUX:
        return emit_virt_profalux(v, button);
    case VOLET_PROTO_SOMFY_RTS:
        return emit_virt_somfy(v, button);
    default:
        ESP_LOGW(TAG, "volet '%s' : protocole %u pas encore cable, rien emis",
                 v->id, (unsigned)v->proto);
        return false;
    }
}

static void zone_follow(volet_t *z, int dir);   /* (defini plus bas) : les suiveurs d'une zone */

/* Demarre un mouvement (dir=+1 up / -1 down) : UNE rafale (appui), puis le moteur part seul.
 * On integre juste la position ensuite ; l'arret se fait par do_stop (rafale STOP) au bon moment. */
static void start_move(volet_t *v, int dir) {
    radio_pause_rx(true);   /* le temps de nos rafales, l'ecoute permanente ne doit pas bloquer le TX */
    bool sent;
    if (v->virt) sent = emit_virt(v, dir > 0 ? PFX_BTN_UP : PFX_BTN_DOWN);
    else if (v->rejeu) sent = rejeu_emit(v, dir > 0 ? "up" : "down");   /* rejeu brut par commande */
    else       { emit_press(v, dir > 0 ? v->up : v->down); sent = true; }   /* vraie telecommande capturee : toujours emise, par appareil */
    if (!sent) {
        /* Rien n'est parti (protocole non cable) : ne pas enclencher le suivi, sinon la boucle de
         * tick ferait avancer et publier une position que le moteur n'a jamais recue. */
        radio_pause_rx(false);
        return;
    }
    v->dir = dir; v->own_move = true;
    v->last_tick_us = esp_timer_get_time();
    zone_follow(v, dir);
}
static void do_stop(volet_t *v) {
    v->dir = 0; v->target = -1; v->own_move = false; s_pos_dirty = true;   /* fin mouvement : suivi telecommande OK + retenir la position */
    if (v->virt) emit_virt(v, PFX_BTN_STOP);
    else if (v->rejeu) rejeu_emit(v, "stop");   /* rejeu brut par commande */
    else         emit_press(v, v->stop);    /* rafale STOP = fige le moteur a la position voulue, par appareil */
    zone_follow(v, 0);
    radio_pause_rx(false);  /* fin de notre commande : on reprend l'ecoute (sync + frame-log) */
}
/* Sync depuis une commande EXTERNE (vraie telecommande) : suit sans emettre.
 * Le moteur part vers la butee (target) ; l'arret intermediaire vient du STOP (freeze). */
static void track_move(volet_t *v, int dir) {
    v->dir = dir; v->own_move = false; v->target = (dir > 0) ? 0 : 100;   /* monter -> fermeture 0, descendre -> 100 */
    v->last_tick_us = esp_timer_get_time();
}
static void freeze(volet_t *v) { v->dir = 0; v->target = -1; v->own_move = false; s_pos_dirty = true; }

/* ── Home Assistant : discovery + etat (MQTT) ── */
static void ha_state_str(const volet_t *v, char *out) {
    if      (v->dir > 0)          strcpy(out, "opening");   /* monte = ouvre */
    else if (v->dir < 0)          strcpy(out, "closing");   /* descend = ferme */
    else if (v->position <= 1)    strcpy(out, "open");      /* fermeture 0 = ouvert (haut) */
    else if (v->position >= 99)   strcpy(out, "closed");    /* fermeture 100 = ferme (bas) */
    else                          strcpy(out, "stopped");
}
/* Publie position + etat du volet (retained). Appele sous LOCK. */
static void publish_volet_state(volet_t *v) {
    if (!s_mqtt_ready) return;
    char topic[96], pl[16], st[10], slug[SH_ID_LEN];
    slugify(slug, sizeof(slug), v->id);   /* topics slugifies (coherents avec la decouverte) */
    if (s_log_frames) {   /* position publiee seulement si suivi actif (coherent avec la decouverte + l'UI) */
        snprintf(topic, sizeof(topic), "openprofalux/cover/%s/position", slug);
        snprintf(pl, sizeof(pl), "%d", 100 - (int)(v->position + 0.5f));   /* HA = % d'OUVERTURE (100=ouvert) ; interne = fermeture */
        pub_defer(topic, pl, 0, 1);
    }
    ha_state_str(v, st);
    snprintf(topic, sizeof(topic), "openprofalux/cover/%s/state", slug);
    pub_defer(topic, st, 0, 1);
    v->pub_pos = (int)(v->position + 0.5f); v->pub_dir = v->dir;
}
/* ZONE : un volet appris dont la trame fait bouger plusieurs volets a la fois
 * (telecommande de piece). Ses suiveurs (members) reproduisent ses mouvements
 * SANS emettre : sa trame les a deja actionnes. Chacun integre sa position avec
 * ses propres temps de course et s'arrete a sa propre butee ; un STOP de la zone
 * les fige tous. dir = +1 monte, -1 descend, 0 STOP. Un suivi ne se propage pas
 * plus loin : un suiveur n'est jamais une zone (shutters_set_followers). Appele sous LOCK. */
static void zone_follow(volet_t *z, int dir) {
    if (z->central || !z->members) return;
    char mid[SH_ID_LEN];
    for (const char *p = cfg_members_next(z->members, mid); p; p = cfg_members_next(p, mid)) {
        volet_t *m = find_volet(mid);
        if (!m || m == z || m->central || is_zone(m)) continue;   /* volets simples seulement */
        /* Seuls les suiveurs qui changent d'etat sont publies : un STOP arrive en rafale. */
        if (dir == 0) { if (m->dir == 0) continue; freeze(m); }
        else { if (m->dir == dir) continue; track_move(m, dir); }   /* deja en route dans ce sens (suivi ou notre commande) : inchange */
        publish_volet_state(m);
    }
}
/* Publie la config HA discovery d'un cover (retained). Appele sous LOCK. */
/* ── Pile des telecommandes (bit VLOW) : un binary_sensor HA par telecommande NOMMEE ──
 * ON = pile faible. Etat retenu sur openprofalux/remote/<serial>/battery, publie des qu'une
 * trame complete a ete vue depuis le demarrage. Appele sous LOCK (publication differee). */
static const char *remote_slug(const char *serial) {
    return (serial[0] == '0' && (serial[1] == 'x' || serial[1] == 'X')) ? serial + 2 : serial;
}
static void publish_batt_state(remote_t *r) {
    if (!s_mqtt_ready || !r->name[0] || !r->batt.known) return;
    char topic[64];
    snprintf(topic, sizeof(topic), "openprofalux/remote/%s/battery", remote_slug(r->serial));
    pub_defer(topic, r->batt.low ? "ON" : "OFF", 0, 1);
}
static void announce_batt(remote_t *r) {
    if (!s_mqtt_ready) return;
    const char *sl = remote_slug(r->serial);
    char topic[96], uid[48], st[64];
    snprintf(topic, sizeof(topic), "homeassistant/binary_sensor/openprofalux_remote_%s_battery/config", sl);
    if (!r->name[0]) { pub_defer(topic, "", 1, 1); return; }   /* sans nom : pas d'entite (retire l'ancienne) */
    snprintf(uid, sizeof(uid), "openprofalux_remote_%s_battery", sl);
    snprintf(st, sizeof(st), "openprofalux/remote/%s/battery", sl);
    char name[SH_ID_LEN + 8]; snprintf(name, sizeof(name), "Pile %s", r->name);
    char avail[64]; snprintf(avail, sizeof(avail), "openprofalux/%s/status", s_device);
    const char *devname = (!s_device[0] || !strcmp(s_device, "openprofalux")) ? "OpenProfalux" : s_device;
    cJSON *o = cJSON_CreateObject();   /* cJSON : un nom avec guillemets ne casse pas le JSON */
    cJSON_AddStringToObject(o, "name", name);
    cJSON_AddStringToObject(o, "unique_id", uid);
    cJSON_AddStringToObject(o, "object_id", uid);
    cJSON_AddStringToObject(o, "device_class", "battery");
    cJSON_AddStringToObject(o, "entity_category", "diagnostic");
    cJSON_AddStringToObject(o, "state_topic", st);
    cJSON_AddStringToObject(o, "payload_on", "ON");
    cJSON_AddStringToObject(o, "payload_off", "OFF");
    cJSON_AddStringToObject(o, "availability_topic", avail);
    cJSON_AddStringToObject(o, "payload_available", "online");
    cJSON_AddStringToObject(o, "payload_not_available", "offline");
    cJSON *dv = cJSON_AddObjectToObject(o, "device");
    cJSON *ids = cJSON_AddArrayToObject(dv, "identifiers"); cJSON_AddItemToArray(ids, cJSON_CreateString("openprofalux"));
    cJSON_AddStringToObject(dv, "name", devname);
    cJSON_AddStringToObject(dv, "manufacturer", "isno.fr");
    cJSON_AddStringToObject(dv, "model", "OpenProfalux");
    char *pl = cJSON_PrintUnformatted(o);
    cJSON_Delete(o);
    if (pl) { pub_defer(topic, pl, 1, 1); free(pl); }
    publish_batt_state(r);
}

static void announce_one(volet_t *v) {
    if (!s_mqtt_ready) return;
    char topic[160], *pl = malloc(1536);
    if (!pl) return;
    /* configuration_url = UI web du boitier (via son IP) pour "Visiter l'appareil" dans HA ;
     * repli sur la page projet si l'IP n'est pas connue. */
    char cu[52];
    esp_netif_t *nif = esp_netif_get_handle_from_ifkey("WIFI_STA_DEF");
    esp_netif_ip_info_t ip;
    if (nif && esp_netif_get_ip_info(nif, &ip) == ESP_OK && ip.ip.addr)
        snprintf(cu, sizeof(cu), "http://" IPSTR, IP2STR(&ip.ip));
    else
        strlcpy(cu, "https://www.isno.fr/projets/openprofalux", sizeof(cu));
    /* Position exposee a HA UNIQUEMENT si l'ecoute permanente est active (comme dans l'UI web) :
     * sinon un coup de vraie telecommande desynchronise l'estimation, un % faux est pire qu'aucun.
     * Sans l'option, le cover reste pilotable (ouvrir/fermer/stop) mais sans position. */
    /* slug HA-safe : le nom du volet peut avoir espaces/accents (ex "Chambre Parent"),
     * INTERDITS dans les topics (decouverte ET command/state). On slugifie PARTOUT et on
     * resout le volet par slug a la reception (find_volet_by_slug). */
    char slug[SH_ID_LEN]; slugify(slug, sizeof(slug), v->id);
    const char *devname = (!s_device[0] || !strcmp(s_device, "openprofalux")) ? "OpenProfalux" : s_device;
    /* Position seulement si ecoute permanente (sinon % non fiable) */
    char pos[240] = "";
    /* Ni centrale ni zone n'ont de position (juste ouvrir/fermer/stop) : la leur ne
     * serait celle d'aucun volet, et un seul STOP arrete des volets de vitesses differentes. */
    if (s_log_frames && !v->central && !is_zone(v))
        snprintf(pos, sizeof(pos),
            "\"position_topic\":\"openprofalux/cover/%s/position\","
            "\"set_position_topic\":\"openprofalux/cover/%s/set_position\","
            "\"position_open\":100,\"position_closed\":0,", slug, slug);
    snprintf(topic, sizeof(topic), "homeassistant/cover/openprofalux_%s/config", slug);
    /* Cles en TOUTES LETTRES (alignees sur OpenXtraflame) ; device PARTAGE (un seul appareil
     * "OpenProfalux" regroupe tous les volets) ; topics command/state SLUGIFIES.
     * optimistic : HA en deduit assumed_state, et son interface laisse alors Ouvrir et Fermer
     * toujours actifs. Sans lui, un volet que HA croit ferme n'a plus de bouton Fermer : une
     * commande ratee, ou une position mal suivie, ne se rattrapait qu'en le remontant d'abord.
     * C'est le cas reel : le moteur ne renvoie rien, l'etat est suppose. HA continue de lire
     * state_topic ; il affiche juste l'etat vise des l'envoi, avant celui du boitier. */
    snprintf(pl, 1536,
        "{\"name\":\"%s\",\"unique_id\":\"openprofalux_%s\",\"object_id\":\"openprofalux_%s\",\"device_class\":\"shutter\","
        "\"command_topic\":\"openprofalux/cover/%s/set\","
        "\"payload_open\":\"OPEN\",\"payload_close\":\"CLOSE\",\"payload_stop\":\"STOP\",\"optimistic\":true,"
        "%s"
        "\"state_topic\":\"openprofalux/cover/%s/state\","
        "\"availability_topic\":\"openprofalux/%s/status\",\"payload_available\":\"online\",\"payload_not_available\":\"offline\","
        "\"device\":{\"identifiers\":[\"openprofalux\"],\"name\":\"%s\","
        "\"manufacturer\":\"isno.fr\",\"model\":\"OpenProfalux\",\"configuration_url\":\"%s\"}}",
        v->id, slug, slug, slug, pos, slug, s_device, devname, cu);
    pub_defer(topic, pl, 1, 1);
    free(pl);
    publish_volet_state(v);
}

/* Entites HA supplementaires (une seule fois, sous le meme appareil) :
 * - un SWITCH "Ecoute RF permanente" (on/off depuis HA),
 * - un CAPTEUR "Derniere trame RF" (voir les trames passer dans HA). */
static void announce_extras(void) {
    if (!s_mqtt_ready) return;
    const char *devname = (!s_device[0] || !strcmp(s_device, "openprofalux")) ? "OpenProfalux" : s_device;
    char dev[320];
    snprintf(dev, sizeof(dev),
        "\"availability_topic\":\"openprofalux/%s/status\",\"payload_available\":\"online\",\"payload_not_available\":\"offline\","
        "\"device\":{\"identifiers\":[\"openprofalux\"],\"name\":\"%s\",\"manufacturer\":\"isno.fr\",\"model\":\"OpenProfalux\"}",
        s_device, devname);
    char *pl = malloc(700); if (!pl) return;
    snprintf(pl, 700,
        "{\"name\":\"Ecoute RF permanente\",\"unique_id\":\"openprofalux_listen\",\"object_id\":\"openprofalux_listen\","
        "\"command_topic\":\"openprofalux/listen/set\",\"state_topic\":\"openprofalux/listen/state\","
        "\"payload_on\":\"ON\",\"payload_off\":\"OFF\",\"icon\":\"mdi:radio-tower\",%s}", dev);
    pub_defer("homeassistant/switch/openprofalux_listen/config", pl, 1, 1);
    snprintf(pl, 700,
        "{\"name\":\"Derniere trame RF\",\"unique_id\":\"openprofalux_last_frame\",\"object_id\":\"openprofalux_last_frame\","
        "\"state_topic\":\"openprofalux/frames/last\",\"value_template\":\"{{ value_json.hop }}\","
        "\"json_attributes_topic\":\"openprofalux/frames/last\",\"icon\":\"mdi:remote\",%s}", dev);
    pub_defer("homeassistant/sensor/openprofalux_last_frame/config", pl, 1, 1);
    free(pl);
    pub_defer("openprofalux/listen/state", s_log_frames ? "ON" : "OFF", 0, 1);
}

/* Efface la decouverte HA d'un cover : payload retenu vide sur le topic de config (HA
 * retire alors l'entite) + ses topics d'etat/position. Sans ca, un volet supprime reste
 * affiche dans Home Assistant (le discovery retenu survit). Appele sous LOCK. */
static void clear_one(volet_t *v) {
    if (!s_mqtt_ready) return;
    char topic[96], slug[SH_ID_LEN];
    slugify(slug, sizeof(slug), v->id);
    snprintf(topic, sizeof(topic), "homeassistant/cover/openprofalux_%s/config", slug);
    pub_defer(topic, "", 0, 1);   /* vide + retenu -> HA retire l'entite */
    snprintf(topic, sizeof(topic), "openprofalux/cover/%s/state", slug);
    pub_defer(topic, "", 0, 1);
    snprintf(topic, sizeof(topic), "openprofalux/cover/%s/position", slug);
    pub_defer(topic, "", 0, 1);
}

/* ── API commande ── */
int shutters_delete_volet(const char *id) {
    if (!id || !*id) return -1;
    LOCK();
    int idx = -1;
    for (int i = 0; i < s_nvolets; i++) if (!strcmp(s_volets[i].id, id)) { idx = i; break; }
    if (idx < 0) { UNLOCK(); return -1; }
    /* Volet virtuel : son compteur roulant (le seul a jour, il avance a chaque commande) doit
     * survivre au volet, sinon un re-enrolement du meme moteur repart en retard (issue #45). */
    bool pfx_virt = is_pfx_virt(&s_volets[idx]);   /* seul l'enrolement Profalux tient un compteur */
    uint32_t vser = s_volets[idx].virt_serial; uint16_t vcnt = s_volets[idx].virt_counter;
    clear_one(&s_volets[idx]);         /* retire l'entite HA (discovery retenu) AVANT de perdre le volet */
    cfg_model_remove(&s_model, idx);   /* libere la liste d'une centrale */
    save_cfg();
    update_listening();   /* plus aucun volet -> coupe l'ecoute permanente */
    UNLOCK();
    pub_flush();          /* pousse l'effacement MQTT hors LOCK */
    if (pfx_virt) pfx_enrol_note_counter(vser, vcnt);   /* table d'enrolement, hors LOCK */
    ESP_LOGW(TAG, "volet '%s' supprime", id);
    return 0;
}

int shutters_cmd(const char *id, const char *cmd, int value) {
    LOCK();
    volet_t *v = find_volet(id);
    if (!v) { ESP_LOGW(TAG, "CMD '%s' : volet '%s' introuvable", cmd, id ? id : "(null)"); UNLOCK(); return -1; }
    ESP_LOGW(TAG, "CMD %s '%s' (up=%dc stop=%dc down=%dc)", cmd, id,
             (int)strlen(v->up), (int)strlen(v->stop), (int)strlen(v->down));
    if (v->central) {   /* centrale : diffuse la commande a chaque volet membre (CSV) */
        char mid[SH_ID_LEN];
        for (const char *p = cfg_members_next(v->members, mid); p; p = cfg_members_next(p, mid)) {
            volet_t *m = find_volet(mid);
            if (!m || m == v || m->central) continue;
            if      (!strcmp(cmd, "up"))   { m->target = 0;   start_move(m, +1); }
            else if (!strcmp(cmd, "down")) { m->target = 100; start_move(m, -1); }
            else if (!strcmp(cmd, "stop")) { do_stop(m); }
            publish_volet_state(m);
        }
        if (!strcmp(cmd, "up")) v->position = 0; else if (!strcmp(cmd, "down")) v->position = 100;
        v->dir = 0;
        publish_volet_state(v);
        UNLOCK(); pub_flush();
        return 0;
    }
    if (!strcmp(cmd, "prog")) {   /* appairage Somfy RTS : emet la commande PROG vers le moteur */
        if (!v->virt || (volet_proto_t)v->proto != VOLET_PROTO_SOMFY_RTS) {
            ESP_LOGW(TAG, "CMD prog refusee : '%s' n'est pas un volet Somfy virtuel", id);
            UNLOCK(); return -1;
        }
        radio_pause_rx(true);
        somfy_emit_cmd(v, SOMFY_RTS_CMD_PROG);
        radio_pause_rx(false);
        UNLOCK();
        return 0;
    }
    if (!strcmp(cmd, "pos") && is_zone(v)) {   /* zone : pas de position (voir announce_one) */
        ESP_LOGW(TAG, "CMD pos refusee : '%s' est une zone", id);
        UNLOCK(); return -1;
    }
    /* position = % de FERMETURE (0 = ouvert/haut, 100 = ferme/bas). */
    if (!strcmp(cmd, "up"))        { v->target = 0;   start_move(v, +1); }   /* ouvrir : monter vers 0 */
    else if (!strcmp(cmd, "down")) { v->target = 100; start_move(v, -1); }   /* fermer : descendre vers 100 */
    else if (!strcmp(cmd, "stop")) { do_stop(v); }
    else if (!strcmp(cmd, "pos"))  {   /* value = % de fermeture voulu */
        if (value < 0) value = 0;
        if (value > 100) value = 100;
        v->target = value;
        if (value > v->position + 1)      start_move(v, -1);   /* plus ferme -> descendre */
        else if (value < v->position - 1) start_move(v, +1);   /* plus ouvert -> monter */
        else v->dir = 0;
    }
    publish_volet_state(v);
    UNLOCK();
    pub_flush();
    return 0;
}

/* ── Synchro inter-cartes : compteur roulant PARTAGE + verrou d'emission, par MQTT.
 * Deux cartes qui portent la MEME identite virtuelle (meme serial) doivent avancer le MEME compteur,
 * que l'ordre vienne de HA ou de l'UI de l'une d'elles, et ne jamais emettre en meme temps.
 *   openprofalux/counter/<serial>  retained : le compteur ; a la reception on garde le MAX (vc_keep).
 *   openprofalux/busy/<serial>     1/0      : verrou ; un busy recu arme un refus local ~3 s (auto-
 *                                             expire si la carte emettrice plante : jamais de blocage).
 * Les publications se font HORS LOCK (mqtt_pub_raw direct, JAMAIS sous le LOCK, voir pub_defer). ── */
#define SYNC_LOCK_MS   1500u   /* duree max d'une emission : verrou local tenu au plus ce temps */
#define SYNC_STALE_MS  3000u   /* un busy recu plus vieux que ca est ignore (carte emettrice plantee) */
static uint32_t s_busy_until[SH_MAX_VOLETS];   /* ms (esp_timer) jusqu'a laquelle le serial est verrouille ; 0 = libre */
static bool     s_self_emit[SH_MAX_VOLETS];    /* on emet soi-meme ce serial -> ignorer l'echo de notre busy */
static inline uint32_t sync_now_ms(void) { return (uint32_t)(esp_timer_get_time() / 1000); }
static void sync_topic(char *out, size_t cap, const char *kind, uint32_t serial) {
    snprintf(out, cap, "openprofalux/%s/%07lX", kind, (unsigned long)serial);
}
static void sync_pub_counter(uint32_t serial, uint16_t cnt) {
    char t[48], p[8]; sync_topic(t, sizeof t, "counter", serial);
    snprintf(p, sizeof p, "%u", cnt);
    mqtt_pub_raw(t, p, 0, 1);              /* retained : une carte au boot reprend le niveau */
}
static void sync_pub_busy(uint32_t serial, bool on) {
    char t[48]; sync_topic(t, sizeof t, "busy", serial);
    mqtt_pub_raw(t, on ? "1" : "0", 0, 0);
}
/* Index du volet VIRTUEL de ce serial, ou -1. Lecture sous LOCK (tableau partage). */
static int sync_idx_by_serial(uint32_t serial) {
    int idx = -1; LOCK();
    for (int i = 0; i < s_nvolets; i++)
        if (s_volets[i].virt && s_volets[i].virt_serial == serial) { idx = i; break; }
    UNLOCK(); return idx;
}

/* Pilotage AVEC synchro : a appeler a la place de shutters_cmd pour un ordre HA ou UI. Pose le
 * verrou (busy=1) AVANT d'emettre, puis publie le compteur et leve le verrou APRES. Refuse
 * (SH_CMD_BUSY) si une emission du meme serial est deja en cours ici ou sur l'autre carte. */
int shutters_cmd_synced(const char *id, const char *cmd, int value) {
    uint32_t serial = 0; int idx = -1;
    LOCK();
    volet_t *v = find_volet(id);
    if (v && v->virt) { serial = v->virt_serial; idx = (int)(v - s_volets); }
    UNLOCK();
    if (idx >= 0 && !s_self_emit[idx] && s_busy_until[idx] && sync_now_ms() < s_busy_until[idx])
        return SH_CMD_BUSY;                              /* une emission de ce serial est deja en cours */
    if (idx >= 0) { s_self_emit[idx] = true; s_busy_until[idx] = sync_now_ms() + SYNC_LOCK_MS; sync_pub_busy(serial, true); }
    int rc = shutters_cmd(id, cmd, value);               /* prend le LOCK, emet, avance virt_counter */
    if (idx >= 0) {
        uint16_t cnt = 0;
        LOCK(); if (idx < s_nvolets && s_volets[idx].virt) cnt = s_volets[idx].virt_counter; UNLOCK();
        sync_pub_counter(serial, cnt);
        sync_pub_busy(serial, false);
        s_busy_until[idx] = 0; s_self_emit[idx] = false;
    }
    return rc;
}

/* ── Tache : suivi position + streaming du maintien ── */
static void tick_task(void *arg) {
    (void)arg;
    int save_ticks = 0;
    while (1) {
        vTaskDelay(pdMS_TO_TICKS(TICK_MS));
        LOCK();
        int64_t now = esp_timer_get_time();
        for (int i = 0; i < s_nvolets; i++) {
            volet_t *v = &s_volets[i];
            if (v->dir == 0) continue;
            uint32_t travel = v->dir > 0 ? v->travel_up_ms : v->travel_down_ms;
            if (travel < 500) travel = 18000;   /* defaut si non calibre */
            float dms = (now - v->last_tick_us) / 1000.0f;
            v->last_tick_us = now;
            /* Convention : position = % de FERMETURE. 0 = ouvert (haut), 100 = ferme (bas).
             * Monter (dir=+1) DIMINUE la position ; descendre (dir=-1) l'augmente -> d'ou le -=. */
            v->position -= v->dir * (dms / travel) * 100.0f;
            if (v->position < 0) v->position = 0;
            if (v->position > 100) v->position = 100;
            /* cible atteinte ou butee -> stop (monter -> vers 0 ; descendre -> vers 100) */
            int reached = (v->dir > 0 && (v->position <= 0   || (v->target >= 0 && v->position <= v->target)))
                       || (v->dir < 0 && (v->position >= 100 || (v->target >= 0 && v->position >= v->target)));
            if (reached) {
                if (!v->own_move) freeze(v);                                /* mouvement externe : on fige le suivi */
                else if (v->target > 0 && v->target < 100) do_stop(v);      /* notre commande vers une position INTERMEDIAIRE : STOP pour figer */
                else { v->dir = 0; v->target = -1; v->own_move = false; s_pos_dirty = true; radio_pause_rx(false); } /* pleine course : butee, own_move false, retenir la position */
            }
            /* sinon mouvement en cours : le moteur (le notre, lance par une rafale, ou l'externe)
             * tourne tout seul jusqu'au STOP / butee ; on integre juste la position sans re-emettre */
            /* publie l'etat HA quand la position (entiere) ou la direction change */
            if (reached || (int)(v->position + 0.5f) != v->pub_pos || v->dir != v->pub_dir)
                publish_volet_state(v);
        }
        UNLOCK();
        pub_flush();   /* publie les changements de position/etat HORS LOCK */
        if (s_pos_dirty) { s_pos_dirty = false; LOCK(); save_cfg(); UNLOCK(); }   /* fige la nouvelle position en NVS (retenue au reboot) */
        /* sauvegarde periodique du dataset et du ring en SPIFFS (hors LOCK ; menage la flash : ~60 s si modifie) */
        if (++save_ticks * TICK_MS >= 60000) {
            save_ticks = 0;
            if (s_frames_dirty) save_frames();
            if (s_ring_dirty)   save_ring();   /* trames recentes rejouables persistees */
        }
    }
}

/* ── Apprentissage / calibration / nommage ── */
int shutters_learn_assign(const char *id, const char *action, const char *bits) {
    if (!id || !*id || !bits) return -1;
    LOCK();
    volet_t *v = get_or_create(id);
    if (!v) { UNLOCK(); return -1; }
    uint8_t btn = bits_button(bits);
    if      (!strcmp(action, "up"))   { strlcpy(v->up, bits, SH_BITS_LEN);   v->up_btn = btn; }
    else if (!strcmp(action, "down")) { strlcpy(v->down, bits, SH_BITS_LEN); v->down_btn = btn; }
    else if (!strcmp(action, "stop")) { strlcpy(v->stop, bits, SH_BITS_LEN); v->stop_btn = btn; }
    else { UNLOCK(); return -1; }
    /* memorise le serial de cette telecommande pour ce volet (sync position) */
    uint32_t ser = 0; if ((int)strlen(bits) >= 60) for (int i = 0; i < 28; i++) if (bits[32 + i] == '1') ser |= (1u << i);
    char shex[SH_SERIAL_LEN]; snprintf(shex, sizeof(shex), "0x%07X", (unsigned)ser);
    bool has = false;
    for (int i = 0; i < v->n_serials; i++) if (!strcmp(v->serials[i], shex)) { has = true; break; }
    if (!has && v->n_serials < SH_MAX_SERIALS) strlcpy(v->serials[v->n_serials++], shex, SH_SERIAL_LEN);
    save_cfg();
    announce_one(v);       /* (re)publie le cover HA des qu'il est appris */
    update_listening();    /* 1er volet appris -> allume l'ecoute pour le suivi de position */
    UNLOCK();
    pub_flush();
    return 0;
}

/* true si un volet virtuel utilise deja ce serial 0x067 (evite les conflits d'allocation de slot). */
bool shutters_virt_serial_used(uint32_t serial) {
    for (int i = 0; i < s_nvolets; i++)
        if (is_pfx_virt(&s_volets[i]) && s_volets[i].virt_serial == serial) return true;
    return false;
}
/* true si une télécommande ENTENDUE sur l'air (registre des captées, dont celles d'une passerelle tierce) porte
 * déjà ce serial. L'allocateur d'identité virtuelle l'exclut : il ne propose jamais une identité
 * déjà occupée par un tiers, sinon deux moteurs suivraient le même code roulant (collision KeeLoq)
 * et le moteur finirait par refuser nos émissions restées en arrière du compteur. Comparaison
 * numérique pour rester indépendant du format de la chaîne stockée. */
bool shutters_heard_serial_used(uint32_t serial) {
    for (int i = 0; i < s_nremotes; i++)
        if ((uint32_t)strtoul(s_remotes[i].serial, NULL, 16) == serial) return true;
    return false;
}
bool shutters_virt_name_for_serial(uint32_t serial, char *out, size_t cap) {
    if (cap) out[0] = 0;
    for (int i = 0; i < s_nvolets; i++)
        if (is_pfx_virt(&s_volets[i]) && s_volets[i].virt_serial == serial) { strlcpy(out, s_volets[i].id, cap); return true; }
    return false;
}
/* Compteur roulant courant du volet virtuel Profalux de ce serial (0 si aucun). Sert a
 * resynchroniser l'identite d'enrolement sur la valeur reellement emise (toujours devant le moteur). */
uint16_t shutters_virt_counter_for_serial(uint32_t serial) {
    for (int i = 0; i < s_nvolets; i++)
        if (is_pfx_virt(&s_volets[i]) && s_volets[i].virt_serial == serial) return s_volets[i].virt_counter;
    return 0;
}

/* Cree (ou convertit) un volet VIRTUEL a partir d'une identite 0x067 enrolee : il apparait
 * dans l'onglet Volets + en cover HA, et pilote le moteur par generation (compteur roulant). */
int shutters_create_virtual(const char *id, uint32_t serial, uint16_t counter) {
    if (!id || !*id) return -1;
    LOCK();
    volet_t *v = get_or_create(id);
    if (!v) { UNLOCK(); return -1; }
    v->virt = true;
    v->proto = VOLET_PROTO_PROFALUX;   /* seul generateur cable aujourd'hui */
    v->virt_serial = serial;
    v->virt_counter = counter;
    /* L'identite d'emission 0x067 NE VA PAS dans `serials` (= l'ensemble des VRAIES telecommandes
     * qui pilotent le moteur, pour le suivi de position). L'y melanger bloquait l'ajout d'une vraie
     * telecommande (garde-fou anti-melange). L'identite virtuelle est exposee a part (virt_serial). */
    char shex[SH_SERIAL_LEN]; snprintf(shex, sizeof(shex), "0x%07X", (unsigned)serial);
    /* Nomme quand meme l'identite virtuelle -> l'UI l'affiche par son NOM. */
    remote_t *rm = remote_add(shex);
    if (rm) strlcpy(rm->name, id, SH_ID_LEN);
    save_cfg();
    announce_one(v);
    UNLOCK();
    pub_flush();
    ESP_LOGW(TAG, "volet virtuel '%s' cree : identite 0x%07X cnt=%u",
             id, (unsigned)serial, counter);
    return 0;
}

/* Cree (ou convertit) un volet VIRTUEL Somfy RTS : contrairement au Profalux, pas de capture
 * d'identite, on choisit une adresse 24 bits. Le code roulant part a 1 et se persiste comme
 * le Profalux. L'appairage reel (commande PROG) se declenche ensuite depuis l'UI. */
int shutters_create_virtual_somfy(const char *id, uint32_t address) {
    if (!id || !*id) return -1;
    /* Une adresse Somfy ne doit JAMAIS ressembler a une identite Profalux 0x067 valide. Sinon un
     * ancien firmware (d'avant le champ `proto`) qui restaure ce volet le prendrait pour un volet
     * virtuel Profalux et emettrait une vraie trame 0x067 sur 868, pouvant commander un moteur
     * Profalux du meme foyer mixte. On refuse ces adresses a la source : le cas devient impossible,
     * y compris sur les firmwares deja deployes. */
    if (pfx_key_for_serial(address & 0xFFFFFF, NULL, NULL)) {
        ESP_LOGW(TAG, "volet Somfy '%s' refuse : adresse 0x%06X ressemble a une identite Profalux 0x067",
                 id, (unsigned)(address & 0xFFFFFF));
        return -1;
    }
    LOCK();
    volet_t *v = get_or_create(id);
    if (!v) { UNLOCK(); return -1; }
    v->virt = true;
    v->proto = VOLET_PROTO_SOMFY_RTS;
    v->virt_serial = address & 0xFFFFFF;
    v->virt_counter = 1;
    save_cfg();
    announce_one(v);
    UNLOCK();
    pub_flush();
    ESP_LOGW(TAG, "volet Somfy '%s' cree : adresse 0x%06X", id, (unsigned)(address & 0xFFFFFF));
    return 0;
}

/* Cree (ou convertit) un appareil a REJEU BRUT : ni clone bit-string, ni virtuel. Les cadres
 * par commande arrivent ensuite par shutters_rejeu_capture. `type` = dev_type_t (portail/volet). */
int shutters_create_rejeu(const char *id, uint8_t type) {
    if (!id || !*id) return -1;
    LOCK();
    volet_t *v = get_or_create(id);
    if (!v) { UNLOCK(); return -1; }
    v->virt = false;
    v->type = type;
    save_cfg();
    announce_one(v);
    UNLOCK();
    pub_flush();
    ESP_LOGW(TAG, "appareil rejeu brut '%s' cree (type %u)", id, type);
    return 0;
}

/* Corrige le type (dev_type_t) d'un appareil DEJA cree, sans reenroler ni recapturer : l'id,
 * l'identite, le compteur et les captures restent. Sert a reparer un type mal attribue. */
int shutters_set_type(const char *id, uint8_t type) {
    if (!id || !*id || type > TYPE_PORTAIL) return -1;   /* borne sur dev_type_t declare */
    LOCK();
    volet_t *v = find_volet(id);
    if (!v) { UNLOCK(); return -1; }
    v->type = type;
    save_cfg();
    announce_one(v);   /* republie l'entite (un libelle HA peut dependre du type) */
    UNLOCK();
    pub_flush();
    ESP_LOGW(TAG, "appareil '%s' : type change en %u", id, type);
    return 0;
}

/* Capture le cadre OOK brut d'UNE commande (cmd = "up"/"stop"/"down") sur la radio `radio` et
 * le range dans l'appareil. La capture (~15 s, mutex radio) se fait HORS du LOCK shutters ; le
 * rangement + sauvegarde sous LOCK. Rend le nombre d'impulsions (>0), <=0 si rien / erreur. */
int shutters_rejeu_capture(const char *id, const char *cmd, int radio, uint32_t freq_khz) {
    if (!id || !*id || !cmd || !*cmd) return -1;
    static uint8_t  lvl[REJEU_MAX_PULSES];
    static uint16_t us[REJEU_MAX_PULSES];
    int8_t rssi = 0;
    int n = radio_capture_raw_on_freq(radio, freq_khz, 15000, lvl, us, REJEU_MAX_PULSES, &rssi);
    if (n < 2) { ESP_LOGW(TAG, "rejeu capture '%s' cmd=%s : rien (rc=%d)", id, cmd, n); return n <= 0 ? n : -1; }
    const char *band = NULL; uint32_t carrier = 0, cur = 0, low = 0, high = 0; uint8_t pn = 0, ver = 0;
    cc1101_radio_info(radio, &band, &carrier, &cur, &low, &high, &pn, &ver);
    uint32_t freq = freq_khz ? freq_khz : (cur ? cur : carrier);   /* freq du profil de marque si fournie, sinon porteuse de la radio */
    LOCK();
    volet_t *v = find_volet(id);
    int rc = v ? rejeu_store(v, cmd, freq, lvl, us, n) : -1;
    if (rc == 0) save_cfg();
    UNLOCK();
    if (rc != 0) return -1;
    ESP_LOGW(TAG, "rejeu capture '%s' cmd=%s : %d impulsions a %u kHz, RSSI %d dBm", id, cmd, n, (unsigned)freq, rssi);
    return n;
}

/* ZONE : fixe les suiveurs d'un volet appris (CSV d'ids, "" = plus aucun).
 * Suiveurs : des volets simples existants, ni la zone elle-meme, ni une centrale,
 * ni une autre zone. Une zone ne peut pas non plus etre elle-meme suiveuse.
 * *why recoit la raison d'un refus. */
int shutters_set_followers(const char *id, const char *members_csv, const char **why) {
    const char *err = NULL;
    if (!id || !*id) { if (why) *why = "volet inconnu"; return -1; }
    LOCK();
    volet_t *v = find_volet(id), *z;
    char mid[SH_ID_LEN];
    bool any = false;
    if (!v) err = "volet inconnu";
    else if (v->central) err = "une centrale ne peut pas etre une zone";
    else for (const char *p = cfg_members_next(members_csv, mid); p && !err; p = cfg_members_next(p, mid)) {
        volet_t *m = find_volet(mid);
        if (!m) err = "suiveur inconnu";
        else if (m == v) err = "une zone ne peut pas se suivre elle-meme";
        else if (m->central) err = "une centrale ne peut pas etre suiveuse";
        else if (is_zone(m)) err = "une zone ne peut pas etre suiveuse";
        any = true;
    }
    if (!err && any && (z = zone_of(v)) && z != v) err = "ce volet suit une zone, il ne peut pas en etre une";
    if (!err && cfg_volet_set_members(v, members_csv) != 0) err = "trop de suiveurs";
    if (err) {
        UNLOCK();
        ESP_LOGW(TAG, "zone '%s' refusee : %s", id, err);
        if (why) *why = err;
        return -1;
    }
    save_cfg();
    announce_one(v);   /* zone <-> volet simple : la position apparait ou disparait dans HA */
    ESP_LOGW(TAG, "zone '%s' : suiveurs=[%s]", id, v->members ? v->members : "");
    UNLOCK();
    pub_flush();
    return 0;
}

/* Cree/convertit une CENTRALE : commande diffusee a un groupe de volets (members_csv = "id1,id2,..."). */
int shutters_create_central(const char *id, const char *members_csv) {
    if (!id || !*id) return -1;
    LOCK();
    int before = s_nvolets;
    volet_t *v = get_or_create(id);
    if (!v) { UNLOCK(); return -1; }
    /* Liste refusee plutot que tronquee (trop longue, ou plus de memoire) : un
     * membre coupe ne recevrait plus rien. Rien ne change, pas meme un volet cree. */
    if (cfg_volet_set_members(v, members_csv) != 0) {
        if (s_nvolets > before) cfg_model_remove(&s_model, s_nvolets - 1);
        UNLOCK();
        ESP_LOGE(TAG, "centrale '%s' refusee : liste de membres de %u o (plus de %d, ou plus de memoire)",
                 id, members_csv ? (unsigned)strlen(members_csv) : 0u, SH_MEMBERS_LEN - 1);
        return -1;
    }
    v->central = true; v->virt = false;
    v->position = 50; v->dir = 0; v->target = -1;
    save_cfg();
    announce_one(v);
    ESP_LOGW(TAG, "centrale '%s' creee : membres=[%s]", id, v->members ? v->members : "");
    UNLOCK();
    pub_flush();
    return 0;
}

/* Champs (bits + bouton) d'une action pour un volet. NULL si action inconnue. */
static char *action_bits(volet_t *v, const char *a, uint8_t **btn) {
    if (!strcmp(a, "up"))   { *btn = &v->up_btn;   return v->up; }
    if (!strcmp(a, "stop")) { *btn = &v->stop_btn; return v->stop; }
    if (!strcmp(a, "down")) { *btn = &v->down_btn; return v->down; }
    return NULL;
}

/* Permute deux commandes apprises (corrige une trame rangee dans le mauvais slot,
 * sans avoir a re-presser la telecommande). Si la cible est vide, revient a un deplacement. */
int shutters_reassign(const char *id, const char *from, const char *to) {
    if (!id || !from || !to) return -1;
    if (!strcmp(from, to)) return 0;
    LOCK();
    volet_t *v = find_volet(id);
    if (!v) { UNLOCK(); return -1; }
    uint8_t *fb, *tb; char *fbits = action_bits(v, from, &fb), *tbits = action_bits(v, to, &tb);
    if (!fbits || !tbits) { UNLOCK(); return -1; }
    char tmp[SH_BITS_LEN]; uint8_t tmpb;
    strlcpy(tmp, tbits, SH_BITS_LEN); tmpb = *tb;
    strlcpy(tbits, fbits, SH_BITS_LEN); *tb = *fb;
    strlcpy(fbits, tmp, SH_BITS_LEN); *fb = tmpb;
    save_cfg();
    announce_one(v);
    UNLOCK();
    pub_flush();
    ESP_LOGW(TAG, "reaffectation '%s' %s <-> %s", id, from, to);
    return 0;
}

int shutters_adopt(const char *id, const char *action, const char *serial, uint32_t hop) {
    if (!id || !action || !serial) return -1;
    char bits[SH_BITS_LEN] = {0};
    LOCK();
    for (int k = 0; k < RF_RING; k++) {
        rfrec_t *r = &s_rf[k];
        if (r->serial[0] && !strcmp(r->serial, serial) && r->hop == hop) {   /* reconstruit les 66 bits */
            build_frame_bits(bits, (uint32_t)strtoul(serial, NULL, 16), r->button, hop); break;
        }
    }
    UNLOCK();
    if (!bits[0]) return -1;
    return shutters_learn_assign(id, action, bits);   /* prend son propre LOCK */
}

/* Cree un volet a partir d'une telecommande deja captee (Telecommandes > Liste) : pour chaque
 * commande, la trame la plus recente de ce serial dans le journal RF (boutons PFX_BTN_*). Les
 * commandes absentes du journal restent a apprendre. *learned recoit "up,stop,down" (celles
 * trouvees). Refuse un nom deja pris : on ne reecrit pas un volet existant. */
int shutters_create_volet_from_remote(const char *id, const char *serial, char *learned, size_t cap, const char **why) {
    *why = NULL; if (cap) learned[0] = 0;
    if (!id || !*id) { *why = "nom manquant"; return -1; }
    if (!serial || !*serial) { *why = "serial manquant"; return -1; }
    static const struct { const char *action; uint8_t btn; } CMD[] = {
        { "up", PFX_BTN_UP }, { "stop", PFX_BTN_STOP }, { "down", PFX_BTN_DOWN } };
    char bits[3][SH_BITS_LEN] = {{0}};
    LOCK();
    if (find_volet(id)) { UNLOCK(); *why = "un volet porte deja ce nom"; return -1; }
    /* du plus recent au plus ancien : s_rfhead est la prochaine place libre de l'anneau */
    for (int k = 1; k <= RF_RING; k++) {
        rfrec_t *r = &s_rf[(s_rfhead - k + RF_RING) % RF_RING];
        if (!r->serial[0] || strcmp(r->serial, serial)) continue;
        for (int c = 0; c < 3; c++)
            if (!bits[c][0] && r->button == CMD[c].btn)
                build_frame_bits(bits[c], (uint32_t)strtoul(serial, NULL, 16), r->button, r->hop);
    }
    UNLOCK();
    if (!bits[0][0] && !bits[1][0] && !bits[2][0]) { *why = "aucune trame ▲ ■ ▼ de cette telecommande dans le journal RF"; return -1; }
    for (int c = 0; c < 3; c++) {
        if (!bits[c][0]) continue;
        if (shutters_learn_assign(id, CMD[c].action, bits[c]) != 0) { *why = "creation du volet impossible"; return -1; }
        if (cap) { if (learned[0]) strlcat(learned, ",", cap); strlcat(learned, CMD[c].action, cap); }
    }
    LOCK();
    remote_t *rm = remote_find(serial);
    if (rm && !rm->name[0]) { strlcpy(rm->name, id, SH_ID_LEN); save_cfg(); }   /* nomme la telecommande comme le volet */
    UNLOCK();
    ESP_LOGW(TAG, "volet '%s' cree depuis la telecommande %s (journal RF) : %s", id, serial, learned);
    return 0;
}

int shutters_calibrate(const char *id, uint32_t up_ms, uint32_t down_ms) {
    LOCK();
    volet_t *v = find_volet(id);
    if (!v) { UNLOCK(); return -1; }
    v->travel_up_ms = up_ms; v->travel_down_ms = down_ms;
    save_cfg();
    UNLOCK();
    return 0;
}
int shutters_set_orientation(const char *id, int orientation) {
    LOCK();
    volet_t *v = find_volet(id);
    if (!v) { UNLOCK(); return -1; }
    v->orientation = (orientation < 0) ? -1 : (orientation % 360);   /* azimut facade (-1 = non defini) */
    save_cfg();
    UNLOCK();
    return 0;
}

/* Ecrit les parametres d'emission PAR APPAREIL dans la fiche (etage 2, issue #111). Appele au save
 * d'un enrolement (valeurs resolues depuis le profil) et a l'edition du panneau avance. Sentinelles :
 * freq_khz/te_us a 0 = heriter du defaut ; tx_rpt/tx_rmt = tx_override_t (0 heriter, 1 off, 2 on).
 * marque=NULL laisse la provenance inchangee. Une valeur < 0 ou > plafond est ignoree (garde l'actuelle). */
int shutters_set_tx_params(const char *id, uint32_t freq_khz, uint32_t te_us,
                           int rpt, int rmt, int frame_bits, const char *marque) {
    LOCK();
    volet_t *v = find_volet(id);
    if (!v) { UNLOCK(); return -1; }
    v->freq_khz = freq_khz;                                  /* 0 = heriter */
    v->te_us    = (te_us && (te_us < 200 || te_us > 900)) ? v->te_us : te_us;   /* hors plage HCS300 : on garde */
    if (rpt >= TXOVR_INHERIT && rpt <= TXOVR_ON) v->tx_rpt = (uint8_t)rpt;
    if (rmt >= TXOVR_INHERIT && rmt <= TXOVR_ON) v->tx_rmt = (uint8_t)rmt;
    if (frame_bits == 56 || frame_bits == 80) v->frame_bits = (uint8_t)frame_bits;   /* Somfy ; autre = inchange */
    if (marque) strlcpy(v->marque, marque, SH_ID_LEN);
    save_cfg();
    UNLOCK();
    return 0;
}

/* Renomme un volet : change son id ET met a jour toutes les references (membres de centrale, suiveurs
 * de zone). L'id sert d'identifiant partout, dont le slug MQTT/Home Assistant : on retire l'ancienne
 * entite HA (ancien slug) et on publie la nouvelle. Cote HA, une NOUVELLE entite apparait, l'ancienne
 * devient indisponible : c'est inherent au renommage d'un nom qui sert d'identifiant. */
int shutters_rename_volet(const char *old_id, const char *new_id) {
    if (!old_id || !new_id || !new_id[0]) return -1;
    if (strchr(new_id, ','))        return -2;   /* virgule = separateur de membres */
    if (strlen(new_id) >= SH_ID_LEN) return -5;   /* refuse plutot que tronquer en silence */
    LOCK();
    volet_t *v = find_volet(old_id);
    if (!v)                      { UNLOCK(); return -3; }
    if (!strcmp(old_id, new_id)) { UNLOCK(); return 0; }   /* inchange */
    if (find_volet(new_id))      { UNLOCK(); return -4; }   /* collision */
    clear_one(v);   /* retire l'ancienne entite HA (ancien slug) AVANT de changer l'id */
    /* Remplace old_id par new_id dans toutes les listes de membres (centrales ET zones). */
    for (int i = 0; i < s_nvolets; i++) {
        volet_t *c = &s_volets[i];
        if (!c->members || !in_members(c->members, old_id)) continue;
        char buf[SH_MEMBERS_LEN]; int p = 0; char mid[SH_ID_LEN]; bool ok = true;
        for (const char *q = cfg_members_next(c->members, mid); q; q = cfg_members_next(q, mid)) {
            const char *use = strcmp(mid, old_id) ? mid : new_id;
            int w = snprintf(buf + p, sizeof(buf) - (size_t)p, "%s%s", p ? "," : "", use);
            if (w < 0 || p + w >= (int)sizeof(buf)) { ok = false; break; }
            p += w;
        }
        if (ok) cfg_volet_set_members(c, buf);
    }
    strlcpy(v->id, new_id, SH_ID_LEN);
    /* L'IDENTITE affichee = le nom du remote. Elle doit suivre le volet : on renomme le/les remotes
     * qui portaient l'ancien nom (identite virtuelle, ou telecommandes clonees nommees comme lui).
     * Un remote nomme autrement (choisi a la main) n'est PAS touche. */
    char shex[SH_SERIAL_LEN];
    if (v->virt) {
        /* L'identite virtuelle EST le volet : son nom suit TOUJOURS (sans garde), meme s'il avait
         * derive (ancien renommage sous un firmware qui ne la mettait pas a jour). */
        snprintf(shex, sizeof(shex), "0x%07X", (unsigned)v->virt_serial);
        remote_t *rm = remote_find(shex);
        if (rm) { strlcpy(rm->name, new_id, SH_ID_LEN); announce_batt(rm); }
    }
    for (int si = 0; si < v->n_serials; si++) {
        remote_t *rm = remote_find(v->serials[si]);
        if (rm && !strcmp(rm->name, old_id)) { strlcpy(rm->name, new_id, SH_ID_LEN); announce_batt(rm); }
    }
    announce_one(v);   /* publie la nouvelle entite HA (nouveau slug) */
    save_cfg();
    UNLOCK();
    pub_flush();       /* pousse retrait + annonce MQTT hors LOCK */
    return 0;
}
/* Applique un ordre d'affichage : ids_csv = liste d'ids separes par des virgules,
 * dans l'ordre voulu. Chaque volet nomme recoit son rang ; ceux qui ne sont pas
 * dans la liste passent a -1 (affiches en fin, dans leur ordre de creation).
 *
 * N'affecte QUE l'affichage de l'UI web : aucun impact sur la radio, le pilotage,
 * la position ou la decouverte Home Assistant. Une seule ecriture NVS, a la
 * demande de l'utilisateur (jamais pendant un mouvement). */
int shutters_set_order(const char *ids_csv) {
    if (!ids_csv) return -1;
    /* Copie de travail (strtok_r modifie sa chaine) a la taille de la liste :
     * un tampon fixe de 384 octets la tronquait au-dela. Sur
     * le tas : rien de plus sur la pile de la tache HTTP. */
    char *buf = strdup(ids_csv);
    if (!buf) return -1;
    LOCK();
    for (int i = 0; i < s_nvolets; i++) s_volets[i].order = -1;   /* remise a plat */
    int rank = 0;
    char *sv = NULL;
    for (char *tok = strtok_r(buf, ",", &sv); tok; tok = strtok_r(NULL, ",", &sv)) {
        while (*tok == ' ') tok++;
        volet_t *v = find_volet(tok);
        if (v) v->order = rank++;
    }
    save_cfg();
    UNLOCK();
    free(buf);
    ESP_LOGI(TAG, "ordre d'affichage mis a jour (%d volets ranges)", rank);
    return 0;
}

int shutters_remote_name(const char *serial, const char *name) {
    if (!serial || !*serial) return -1;
    LOCK();
    remote_t *rm = remote_add(serial);
    if (rm) { strlcpy(rm->name, name, SH_ID_LEN); save_cfg(); announce_batt(rm); }   /* nommee : capteur pile annonce ; nom vide : entite retiree */
    UNLOCK();
    pub_flush();
    return rm ? 0 : -1;   /* -1 : liste pleine */
}

/* Supprime une telecommande de la liste (bouton UI). Refuse si un volet s'en sert : il faut
 * d'abord supprimer ou reapprendre ce volet. Elle reviendra si elle est de nouveau captee. */
int shutters_delete_remote(const char *serial, const char **why) {
    *why = NULL;
    if (!serial || !*serial) { *why = "serial manquant"; return -1; }
    LOCK();
    int idx = -1;
    for (int i = 0; i < s_nremotes; i++) if (!strcmp(s_remotes[i].serial, serial)) { idx = i; break; }
    const char *user = idx >= 0 ? remote_user(serial) : NULL;
    static char msg[SH_ID_LEN + 40];
    if (idx < 0) *why = "telecommande inconnue";
    else if (user) { snprintf(msg, sizeof(msg), "utilisee par le volet %s", user); *why = msg; }
    else { remote_remove(idx); save_cfg(); s_frames_dirty = true; }
    UNLOCK();
    if (*why) return -1;
    save_frames();   /* tout de suite : sinon son jeu de trames la recreerait au prochain boot */
    ESP_LOGW(TAG, "telecommande %s supprimee", serial);
    return 0;
}

/* Ignore une telecommande : la retire de la liste (refuse si un volet s'en sert, comme la
 * suppression) et n'enregistre plus ses trames. Un serial absent de la liste (saisi a la main)
 * est simplement ajoute aux ignorees. Serial normalise en 0x%07X. */
int shutters_ignore_remote(const char *serial, const char **why) {
    *why = NULL;
    char *end = NULL;
    unsigned long v = serial ? strtoul(serial, &end, 16) : 0;
    if (!serial || !*serial || *end || v == 0 || v > 0xFFFFFFFUL) { *why = "serial invalide (0x + 7 chiffres hexa)"; return -1; }
    char shex[SH_SERIAL_LEN]; snprintf(shex, sizeof(shex), "0x%07lX", v);
    LOCK();
    const char *user = remote_user(shex);
    static char msg[SH_ID_LEN + 40];
    if (user) { snprintf(msg, sizeof(msg), "utilisee par le volet %s", user); *why = msg; }
    else if (!ignored(shex) && s_nignored >= SH_MAX_IGNORED) *why = "liste des telecommandes ignorees pleine";
    else {
        if (!ignored(shex)) { strlcpy(s_ignored[s_nignored++], shex, SH_SERIAL_LEN); ignore_save(); }
        for (int i = 0; i < s_nremotes; i++) if (!strcmp(s_remotes[i].serial, shex)) {
            remote_remove(i); save_cfg(); s_frames_dirty = true; break;
        }
    }
    UNLOCK();
    if (*why) return -1;
    save_frames();
    ESP_LOGW(TAG, "telecommande %s ignoree", shex);
    return 0;
}
int shutters_unignore_remote(const char *serial) {
    int rc = -1;
    LOCK();
    for (int i = 0; i < s_nignored; i++) if (!strcasecmp(s_ignored[i], serial ? serial : "")) {
        memmove(s_ignored[i], s_ignored[i + 1], (size_t)(s_nignored - i - 1) * SH_SERIAL_LEN);
        s_nignored--; ignore_save(); rc = 0; break;
    }
    UNLOCK();
    if (rc == 0) ESP_LOGI(TAG, "telecommande %s n'est plus ignoree", serial);
    return rc;
}

/* Purge UNIQUE (cle NVS cfg/rem_purge) des telecommandes sans nom qu'aucun volet n'utilise :
 * les fantomes enregistres avant la confirmation des trames (issue #39). Une vraie telecommande
 * purgee revient d'elle-meme a son prochain appui. Au boot, apres load_cfg/load_frames. */
static void purge_ghost_remotes_once(void) {
    nvs_handle_t h; uint8_t done = 0;
    if (nvs_open("cfg", NVS_READWRITE, &h) != ESP_OK) return;
    nvs_get_u8(h, "rem_purge", &done);
    if (!done) {
        int n = 0;
        for (int i = 0; i < s_nremotes; ) {
            if (!s_remotes[i].name[0] && !remote_user(s_remotes[i].serial)) {
                ESP_LOGW(TAG, "purge : telecommande %s sans nom ni volet retiree", s_remotes[i].serial);
                remote_remove(i); n++;
            } else i++;
        }
        if (n) { save_cfg(); save_frames(); }
        nvs_set_u8(h, "rem_purge", 1); nvs_commit(h);
        ESP_LOGI(TAG, "purge unique des telecommandes fantomes : %d retiree(s)", n);
    }
    nvs_close(h);
}

/* ══ FONCTION 1 : Dataset slide (option MQTT "capture toutes les trames") ══
 * Publie un hop UNIQUEMENT s'il n'est pas deja dans le set enregistre de ce serial.
 * Sert a collecter les 65536 hops distincts pour l'attaque slide-MITM. Appele sous LOCK. */
static void dataset_log_frame(const char *shex, uint8_t button, uint32_t hop, int8_t rssi, uint32_t t) {
    remote_t *rm = NULL;
    for (int i = 0; i < s_nremotes; i++) if (!strcmp(s_remotes[i].serial, shex)) { rm = &s_remotes[i]; break; }
    if (!rm) return;
    bool is_new = true;
    if (rm->nhops && rm->last_hop == hop) is_new = false;                      /* fast-path maintien */
    else for (int i = 0; i < rm->nhops; i++) if (rm->hops[i].hop == hop) { is_new = false; break; }
    rm->last_hop = hop;
    if (!is_new) return;                                                       /* deja enregistre -> rien */
    /* ajoute au set (croissance bornee a SH_MAX_HOPS) */
    if (rm->nhops >= rm->caphops && rm->caphops < SH_MAX_HOPS) {
        uint16_t nc = rm->caphops ? (uint16_t)(rm->caphops * 2) : 32;
        if (nc > SH_MAX_HOPS) nc = SH_MAX_HOPS;
        dframe_t *np = realloc(rm->hops, (size_t)nc * sizeof(dframe_t));
        if (np) { rm->hops = np; rm->caphops = nc; }
    }
    if (rm->nhops < rm->caphops) { rm->hops[rm->nhops++] = (dframe_t){ .hop = hop, .t = t, .button = button }; s_frames_dirty = true; }
    /* Plus de publication frames/<serial> ni /count : une seule structure MQTT = l'anneau frames/log/<n>.
     * Le dataset slide (hops distincts) reste construit ici en RAM/NVS pour l'export /api/frames. */
}

/* ══ FONCTION 2 : Suivi de position via telecommandes ENREGISTREES ══
 * Independante de l'option MQTT : des qu'un volet a appris ce serial+bouton, on suit
 * sa position quand la VRAIE telecommande l'actionne. Appele sous LOCK. */
static void track_shutter_position(const char *shex, uint8_t button) {
    for (int i = 0; i < s_nvolets; i++) {
        volet_t *v = &s_volets[i];
        bool mine = false;
        for (int j = 0; j < v->n_serials; j++) if (!strcmp(v->serials[j], shex)) { mine = true; break; }
        if (!mine) continue;
        /* Profalux = appui + stop : ▲/▼ lance le moteur vers la butee, STOP le fige.
         * On demarre le suivi au 1er appui (repetitions du burst ignorees), on fige au STOP. */
        if (v->stop_btn && button == v->stop_btn) {
            /* Toujours, meme si la zone est deja a l'arret : un suiveur plus lent qu'elle roule
             * encore quand elle a atteint sa butee estimee, et le STOP de la piece l'arrete aussi.
             * zone_follow ne fige que les suiveurs en mouvement : les repetitions sont sans effet. */
            zone_follow(v, 0);
            freeze(v);
        } else if (v->up_btn && button == v->up_btn) {
            if (!v->own_move && v->dir != +1) { track_move(v, +1); zone_follow(v, +1); }
        } else if (v->down_btn && button == v->down_btn) {
            if (!v->own_move && v->dir != -1) { track_move(v, -1); zone_follow(v, -1); }
        }
        /* v->own_move : notre propre echo (meme serial rejoue) -> ignore.
         * PAS de break : un meme serial (telecommande GENERALE) peut piloter plusieurs volets
         * -> on met a jour l'etat de TOUS les volets qui portent ce serial (sync HA correcte). */
    }
}

/* ── RX : chaque trame recue -> journal + les 2 fonctions ci-dessus ── */
void shutters_on_rx(const char *bits, uint32_t serial, uint8_t button, int8_t rssi, uint32_t hop) {
    /* te : TE de la trame, mesure sur sa periode de bit / 3 (cc1101_last_te, mis a jour au decodage
     * qui vient de la produire). Permet de relever le TE de chaque telecommande sans console. */
    ESP_LOGI(TAG, "RX serial=0x%07X bouton=0x%X hop=0x%08X rssi=%d dBm te=%d us",
             (unsigned)serial, button, (unsigned)hop, rssi, cc1101_last_te());
    bool do_pub = false; int pub_slot = -1; char pub_lf[128];   /* publie APRES UNLOCK (anti-deadlock) */
    LOCK();
    char shex[SH_SERIAL_LEN]; snprintf(shex, sizeof(shex), "0x%07X", (unsigned)serial);
    /* Les 66 bits ne sont pas stockes (reconstruits a la demande pour le rejeu/adoption) ; seul
     * le bit 64 (VLOW, pile faible) est exploite, une fois par appui, ci-dessous. */
    /* DEDUP : meme (serial, hop) deja vu -> repetition d'un meme appui, on n'ajoute rien (ni ring ni MQTT). */
    if (!ring_contains(shex, hop)) {
        int slot = s_rfhead;   /* emplacement -> topic MQTT recuperable frames/log/<slot> */
        rfrec_t *r = &s_rf[s_rfhead];
        time_t now = time(NULL);
        uint32_t t = (now > 1600000000) ? (uint32_t)now : 0;   /* epoch si SNTP synchro, sinon 0 */
        r->t = t; r->button = button; r->hop = hop; r->rssi = rssi;
        strlcpy(r->serial, shex, SH_SERIAL_LEN);
        s_rfhead = (s_rfhead + 1) % RF_RING;
        s_ring_dirty = true;
        /* auto-enregistre le serial vu (nom vide) */
        if (!ignored(shex)) remote_add(shex);   /* trame confirmee (radio.c) ; liste pleine -> signale a l'UI ; ignoree -> rien */
        /* Pile : une fois par appui (nouveau hop), sur trame COMPLETE uniquement (bit 64 = VLOW). */
        if (bits && strlen(bits) >= 66) {
            for (int i = 0; i < s_nremotes; i++) if (!strcmp(s_remotes[i].serial, shex)) {
                remote_t *rm = &s_remotes[i];
                rm->batt_t = t;
                if (batt_on_press(&rm->batt, bits[64] == '1')) {
                    if (rm->batt.low) ESP_LOGW(TAG, "pile FAIBLE : telecommande %s (%s)", shex, rm->name);
                    publish_batt_state(rm);   /* differe, publie apres UNLOCK */
                }
                break;
            }
        }
        if (s_log_frames && s_mqtt_ready) {
            dataset_log_frame(shex, button, hop, rssi, t);  /* dataset slide (dedup par hop, bouton+t) */
            /* On PREPARE le payload ici, mais on PUBLIE hors du LOCK (voir plus bas). */
            snprintf(pub_lf, sizeof(pub_lf), "{\"serial\":\"%s\",\"button\":\"0x%X\",\"hop\":\"0x%08X\",\"rssi\":%d,\"t\":%u}",
                     shex, button, (unsigned)hop, rssi, (unsigned)t);
            pub_slot = slot; do_pub = true;
        }
    }
    track_shutter_position(shex, button);   /* toujours (idempotent sur les repetitions) */
    UNLOCK();
    pub_flush();   /* etat pile eventuel (empile sous LOCK) */
    /* DEADLOCK FIX : ne JAMAIS publier en MQTT sous le LOCK. Un publish QoS1 retained peut
     * bloquer (outbox pleine pendant une rafale d'apprentissage) ; or l'ESP est abonne a
     * frames/log/# et recoit ses propres publications -> la tache MQTT reprend ce meme LOCK
     * pour les traiter. Publier apres UNLOCK casse le cycle d'attente mutuelle. */
    if (do_pub) {
        mqtt_pub_raw("openprofalux/frames/last", pub_lf, 0, 1);   /* capteur HA "Derniere trame" */
        char lt[48]; snprintf(lt, sizeof(lt), "openprofalux/frames/log/%d", pub_slot);
        mqtt_pub_raw(lt, pub_lf, 1, 1);   /* QoS 1 + retained : recuperable via frames/log/# */
    }
}

/* Ajoute au JSON une commande apprise : { "b": <bouton>, "s": "0x<serial>" }.
 * Le serial est extrait de la trame stockee (bits[32..59], LSB), pour verifier
 * dans l'UI que les 3 commandes viennent bien de la meme telecommande. */
static void add_cmd_json(cJSON *cmd, const char *key, const char *bits, uint8_t btn) {
    if (!bits[0]) return;
    uint32_t ser = 0;
    if ((int)strlen(bits) >= 60) for (int i = 0; i < 28; i++) if (bits[32 + i] == '1') ser |= (1u << i);
    char sx[12]; snprintf(sx, sizeof(sx), "0x%07X", (unsigned)ser);
    cJSON *c = cJSON_CreateObject();
    cJSON_AddNumberToObject(c, "b", btn);
    cJSON_AddStringToObject(c, "s", sx);
    cJSON_AddItemToObject(cmd, key, c);
}

/* ── Status JSON ── */
char *shutters_status_json(void) {
    LOCK();
    cJSON *root = cJSON_CreateObject();
    cJSON *rem = cJSON_AddObjectToObject(root, "remotes");
    for (int i = 0; i < s_nremotes; i++) cJSON_AddStringToObject(rem, s_remotes[i].serial, s_remotes[i].name);
    cJSON_AddNumberToObject(root, "remotes_max", SH_MAX_REMOTES);
    cJSON_AddStringToObject(root, "remote_refused", s_remote_refused);   /* "" = aucune refusee */
    cJSON *ign = cJSON_AddArrayToObject(root, "remotes_ignored");
    for (int i = 0; i < s_nignored; i++) cJSON_AddItemToArray(ign, cJSON_CreateString(s_ignored[i]));
    cJSON *rb = cJSON_AddObjectToObject(root, "remote_battery");   /* pile : telecommandes vues depuis le boot */
    for (int i = 0; i < s_nremotes; i++) {
        if (!s_remotes[i].batt.known) continue;
        cJSON *b = cJSON_AddObjectToObject(rb, s_remotes[i].serial);
        cJSON_AddBoolToObject(b, "low", s_remotes[i].batt.low);
        cJSON_AddNumberToObject(b, "t", s_remotes[i].batt_t);
    }
    cJSON *vols = cJSON_AddArrayToObject(root, "volets");
    for (int i = 0; i < s_nvolets; i++) {
        volet_t *v = &s_volets[i];
        cJSON *o = cJSON_CreateObject();
        cJSON_AddStringToObject(o, "id", v->id);
        cJSON_AddNumberToObject(o, "type", v->type);   /* dev_type_t EXPLICITE (0 = volet, 1 = portail) : l'UI filtre dessus, plus d'hypothese "absent = volet". Codes miroir de profiles.json types[].code. */
        if (v->virt) {   /* volet a telecommande virtuelle -> pas d'apprentissage */
            cJSON_AddBoolToObject(o, "virt", true);
            bool somfy = (volet_proto_t)v->proto == VOLET_PROTO_SOMFY_RTS;
            cJSON_AddStringToObject(o, "proto", somfy ? "somfy" : "profalux");
            char vhex[SH_SERIAL_LEN];
            /* Profalux : identite 0x067 sur 7 quartets. Somfy : adresse 24 bits sur 6 quartets. */
            snprintf(vhex, sizeof(vhex), somfy ? "0x%06X" : "0x%07X",
                     (unsigned)(somfy ? (v->virt_serial & 0xFFFFFF) : v->virt_serial));
            cJSON_AddStringToObject(o, "virt_serial", vhex);
        }
        if (v->central) cJSON_AddBoolToObject(o, "central", true);
        if (v->central || v->members) cJSON_AddStringToObject(o, "members", v->members ? v->members : "");   /* centrale : membres ; zone : suiveurs */
        if (is_zone(v)) cJSON_AddBoolToObject(o, "zone", true);
        if (zone_of(v)) {   /* zones que ce volet suit (il peut en suivre plusieurs) */
            cJSON *fl = cJSON_AddArrayToObject(o, "follows");
            for (int k = 0; k < s_nvolets; k++)
                if (is_zone(&s_volets[k]) && in_members(s_volets[k].members, v->id)) cJSON_AddItemToArray(fl, cJSON_CreateString(s_volets[k].id));
        }
        cJSON_AddNumberToObject(o, "position", (int)(v->position + 0.5f));
        cJSON_AddNumberToObject(o, "travel_up_ms", v->travel_up_ms);     /* pour reafficher la calibration dans l'UI */
        cJSON_AddNumberToObject(o, "travel_down_ms", v->travel_down_ms);
        cJSON_AddNumberToObject(o, "orientation", v->orientation);       /* azimut facade (-1 = non defini) */
        cJSON_AddNumberToObject(o, "order", v->order);                   /* rang d'affichage UI (-1 = non range) */
        /* Parametres d'emission PAR APPAREIL (etage 2, issue #111) : pour le panneau avance de l'UI
         * (affichage + edition). tx_rpt/tx_rmt = tri-etat tx_override_t (0 heriter, 1 off, 2 on). */
        if (v->marque[0]) cJSON_AddStringToObject(o, "marque", v->marque);
        cJSON_AddNumberToObject(o, "freq_khz", v->freq_khz);
        cJSON_AddNumberToObject(o, "te_us",    v->te_us);
        cJSON_AddNumberToObject(o, "tx_rpt",   v->tx_rpt);
        cJSON_AddNumberToObject(o, "tx_rmt",   v->tx_rmt);
        cJSON_AddNumberToObject(o, "frame_bits", v->frame_bits);
        cJSON *sr = cJSON_AddArrayToObject(o, "serials");
        for (int j = 0; j < v->n_serials; j++) cJSON_AddItemToArray(sr, cJSON_CreateString(v->serials[j]));
        /* etat des 3 commandes : bouton appris (nibble) si le slot est rempli, absent sinon.
         * Permet a l'UI d'apprentissage centree-volet d'afficher appris / a capturer. */
        cJSON *cmd = cJSON_AddObjectToObject(o, "cmd");
        add_cmd_json(cmd, "up",   v->up,   v->up_btn);
        add_cmd_json(cmd, "stop", v->stop, v->stop_btn);
        add_cmd_json(cmd, "down", v->down, v->down_btn);
        /* Rejeu brut (CAME et code fixe) : l'ecran de capture unifie en a besoin pour distinguer
         * le moteur (rejeu vs clone KeeLoq) et montrer quelles commandes sont deja captees. Le cadre
         * brut est range dans v->rejeu (JSON {f, up, stop, down}) ; on expose juste les commandes
         * presentes, pas les impulsions. */
        if (v->rejeu) {
            cJSON_AddBoolToObject(o, "rejeu", true);
            cJSON *rc = cJSON_AddObjectToObject(o, "rejeu_cmds");
            cJSON *rj = cJSON_Parse(v->rejeu);
            if (rj) {
                for (const char *const *c = (const char *[]){ "up", "stop", "down", NULL }; *c; c++) {
                    const char *s = cJSON_GetStringValue(cJSON_GetObjectItem(rj, *c));
                    if (s && *s) cJSON_AddBoolToObject(rc, *c, true);
                }
                cJSON_Delete(rj);
            }
        }
        cJSON_AddItemToArray(vols, o);
    }
    cJSON *rf = cJSON_AddArrayToObject(root, "rf");   /* recentes seulement ; les 300 via /api/rf */
    for (int k = 0; k < STATUS_RF_SHOW; k++) {
        int idx = (s_rfhead - 1 - k + 2 * RF_RING) % RF_RING;
        rfrec_t *r = &s_rf[idx];
        if (!r->serial[0]) continue;
        cJSON *f = cJSON_CreateObject();
        cJSON_AddNumberToObject(f, "t", r->t);
        cJSON_AddStringToObject(f, "serial", r->serial);
        char hx[10]; snprintf(hx, sizeof(hx), "%X", r->button); cJSON_AddStringToObject(f, "button", hx);
        snprintf(hx, sizeof(hx), "%08X", (unsigned)r->hop); cJSON_AddStringToObject(f, "hop", hx);
        cJSON_AddNumberToObject(f, "rssi", r->rssi);
        cJSON_AddItemToArray(rf, f);
    }
    UNLOCK();
    /* Statut Wi-Fi + MQTT (pour l'UI : pastilles + force du signal) */
    cJSON *wifi = cJSON_AddObjectToObject(root, "wifi");
    wifi_ap_record_t ap;
    /* Le pilote n'est questionne que si le client est connecte : en mode secours (point
     * d'acces + client non connecte), chaque appel ecrit "Haven't to connect to a suitable
     * AP now!", soit une ligne par rafraichissement de l'UI (toutes les 3 s), qui noyait
     * le journal. */
    if (wifi_bridge_is_connected() && esp_wifi_sta_get_ap_info(&ap) == ESP_OK) {
        cJSON_AddBoolToObject(wifi, "connected", true);
        cJSON_AddStringToObject(wifi, "ssid", (char *)ap.ssid);
        cJSON_AddNumberToObject(wifi, "rssi", ap.rssi);
        esp_netif_t *nif = esp_netif_get_handle_from_ifkey("WIFI_STA_DEF");
        esp_netif_ip_info_t ip;
        if (nif && esp_netif_get_ip_info(nif, &ip) == ESP_OK && ip.ip.addr) {
            char ips[16]; snprintf(ips, sizeof(ips), IPSTR, IP2STR(&ip.ip));
            cJSON_AddStringToObject(wifi, "ip", ips);
        }
    } else {
        cJSON_AddBoolToObject(wifi, "connected", false);
        cJSON_AddBoolToObject(wifi, "fallback", wifi_bridge_in_fallback());   /* reessaie seul (mode secours) */
    }
    cJSON_AddBoolToObject(root, "mqtt", s_mqtt_ready);
    cJSON_AddBoolToObject(root, "listening", s_log_frames);   /* ecoute permanente = position fiable */
    cJSON_AddNumberToObject(root, "uptime", (double)(esp_timer_get_time() / 1000000));   /* s depuis boot : date les trames RF cote UI */
    char *js = cJSON_PrintUnformatted(root);
    cJSON_Delete(root);
    return js;
}

/* ── Sauvegarde / restauration (telecommandes + noms + trames de reference + calibration) ── */
char *shutters_export_json(void) {
    LOCK();
    char *js = cfg_model_export(&s_model);
    UNLOCK();
    /* + la table d'enrolement des volets virtuels (cle a part, ignoree par cfg_model_import) */
    cJSON *root = js ? cJSON_Parse(js) : NULL;
    if (!root) return js;
    free(js);
    cJSON_AddItemToObject(root, "pfx_enrol", pfx_enrol_export());
    js = cJSON_PrintUnformatted(root);
    cJSON_Delete(root);
    return js;
}
/* Copie de la config d'avant la derniere restauration (Systeme > Sauvegarde, "Revenir"). */
#define PREV_CFG_FILE "/spiffs/config-avant.json"
#define PREV_CFG_MAX  (24 * 1024)   /* = RESTORE_MAX_BODY (web_ui.c) */

int shutters_import_json(const char *js, const char **err) {
    *err = "format";
    cJSON *root = js ? cJSON_Parse(js) : NULL;
    /* Une sauvegarde, et rien d'autre : l'export des trames (meme onglet), {} ou []
     * passaient, et remettaient toute la config a zero avant de n'importer rien. */
    if (!cfg_model_is_backup(root)) { cJSON_Delete(root); return -1; }
    LOCK();
    /* Copie de la config courante, pour pouvoir revenir en arriere. Sans copie, on ne
     * remplace pas une config qui a des volets ; sans volet, il n'y a rien a perdre. */
    if (!cfg_model_save_copy(&s_model, PREV_CFG_FILE) && s_nvolets > 0) {
        UNLOCK(); cJSON_Delete(root);
        ESP_LOGE(TAG, "restauration annulee : copie de la config actuelle impossible");
        *err = "copie"; return -1;
    }
    /* Compteurs des telecommandes virtuelles en place : la sauvegarde en est une photo plus
     * ancienne, elle ne doit pas les faire reculer sous ce que le moteur a deja vu (virt_counter.h). */
    struct { uint32_t serial; uint16_t counter; uint8_t proto; } vc[SH_MAX_VOLETS];
    int nvc = 0;
    for (int i = 0; i < s_nvolets && nvc < SH_MAX_VOLETS; i++) if (s_volets[i].virt) {
        vc[nvc].serial = s_volets[i].virt_serial; vc[nvc].counter = s_volets[i].virt_counter;
        vc[nvc].proto = s_volets[i].proto; nvc++;
    }
    reset_state();
    cfg_model_import(&s_model, root);
    for (int i = 0; i < s_nvolets; i++) {
        volet_t *v = &s_volets[i];
        if (!v->virt) continue;
        for (int k = 0; k < nvc; k++) if (vc[k].proto == v->proto && vc[k].serial == v->virt_serial) {
            uint16_t keep = vc_keep(v->virt_counter, vc[k].counter);
            if (keep != v->virt_counter) {
                ESP_LOGW(TAG, "volet virtuel '%s' : compteur %u garde (la sauvegarde disait %u)",
                         v->id, (unsigned)keep, (unsigned)v->virt_counter);
                v->virt_counter = keep;
            }
            break;
        }
    }
    /* Table d'enrolement, et compteurs-photo des volets virtuels restaures : non confirmes,
     * un re-enrolement sautera devant le moteur au lieu de repartir derriere (issue #45). */
    pfx_enrol_import(cJSON_GetObjectItem(root, "pfx_enrol"));
    for (int i = 0; i < s_nvolets; i++) if (is_pfx_virt(&s_volets[i])) pfx_enrol_unconfirm(s_volets[i].virt_serial);
    /* L'echec d'ecriture remonte a l'UI : une restauration repondait "ok" meme
     * quand la NVS pleine l'empechait de survivre au redemarrage. */
    esp_err_t saved = save_cfg();
    for (int i = 0; i < s_nvolets; i++) announce_one(&s_volets[i]);   /* re-publie les covers HA restaures */
    update_listening();
    UNLOCK();
    pub_flush();
    cJSON_Delete(root);
    ESP_LOGI(TAG, "config restauree : %d volets, %d telecommandes%s", s_nvolets, s_nremotes,
             saved == ESP_OK ? "" : " (NON enregistree en NVS)");
    *err = saved == ESP_OK ? NULL : "nvs";
    return saved == ESP_OK ? 0 : -1;
}

/* Revient a la copie : la config remplacee devient a son tour la copie (aller-retour). */
int shutters_restore_undo(const char **err) {
    char *js = cfg_read_file(PREV_CFG_FILE, PREV_CFG_MAX, NULL);
    if (!js) { *err = "absente"; return -1; }
    int rc = shutters_import_json(js, err);
    free(js);
    return rc;
}
bool shutters_prev_cfg_time(time_t *t) {
    struct stat st;
    if (stat(PREV_CFG_FILE, &st) != 0 && stat(PREV_CFG_FILE ".tmp", &st) != 0) return false;
    *t = st.st_mtime;
    return true;
}

/* ── Integration Home Assistant (MQTT) ── */
/* Etat de l'entite update HA : version installee + derniere version GitHub connue. */
static void publish_update_state(void) {
    if (!s_mqtt_ready) return;
    const esp_app_desc_t *d = esp_app_get_description();
    const char *inst = d ? d->version : "?";
    const char *latest = ota_latest_version();
    if (!latest || !latest[0]) latest = inst;   /* pas encore verifie -> aucune MAJ signalee */
    char pl[288];
    snprintf(pl, sizeof(pl),
        "{\"installed_version\":\"%s\",\"latest_version\":\"%s\",\"title\":\"OpenProfalux\","
        "\"release_url\":\"https://github.com/Isno-Open/OpenProfalux/releases\"}", inst, latest);
    pub_defer("openprofalux/update/state", pl, 0, 1);
}
/* Decouverte HA de l'entite update (plateforme MQTT update, meme device "openprofalux"). */
static void announce_update(void) {
    if (!s_mqtt_ready) return;
    char *pl = malloc(768); if (!pl) return;
    const char *devname = (!s_device[0] || !strcmp(s_device, "openprofalux")) ? "OpenProfalux" : s_device;
    snprintf(pl, 768,
        "{\"name\":\"Firmware\",\"unique_id\":\"openprofalux_update\",\"object_id\":\"openprofalux_update\","
        "\"device_class\":\"firmware\",\"state_topic\":\"openprofalux/update/state\","
        "\"command_topic\":\"openprofalux/update/install\",\"payload_install\":\"INSTALL\","
        "\"availability_topic\":\"openprofalux/%s/status\",\"payload_available\":\"online\",\"payload_not_available\":\"offline\","
        "\"device\":{\"identifiers\":[\"openprofalux\"],\"name\":\"%s\",\"manufacturer\":\"isno.fr\",\"model\":\"OpenProfalux\"}}",
        s_device, devname);
    pub_defer("homeassistant/update/openprofalux/config", pl, 1, 1);
    free(pl);
    publish_update_state();
}

void shutters_mqtt_announce(const char *device) {
    LOCK();
    strlcpy(s_device, (device && *device) ? device : "op", sizeof(s_device));
    s_mqtt_ready = true;
    for (int i = 0; i < s_nvolets; i++) announce_one(&s_volets[i]);
    announce_extras();           /* switch "Ecoute RF permanente" + capteur "Derniere trame" */
    announce_update();           /* entite update HA (firmware) */
    for (int i = 0; i < s_nremotes; i++) if (s_remotes[i].name[0]) announce_batt(&s_remotes[i]);   /* pile des telecommandes nommees */
    UNLOCK();
    pub_flush();                 /* publie la decouverte HORS LOCK (anti-deadlock a la connexion) */
    /* NB : plus de flush en masse du ring ici. Les frames/log/<slot> sont QoS1 RETAINED
     * (le broker les garde deja) + persistees en SPIFFS ; re-pousser tout le ring (jusqu'a
     * 1000 QoS1) SOUS LOCK dans la tache MQTT tenait le LOCK trop longtemps -> httpd/commandes
     * figes ("plante"). Les nouvelles trames sont publiees en direct par shutters_on_rx. */
    ESP_LOGI(TAG, "HA discovery publiee pour %d cover(s), device=%s", s_nvolets, s_device);
}

void shutters_mqtt_lost(void) {
    LOCK();
    bool was = s_mqtt_ready;
    s_mqtt_ready = false;   /* broker perdu : le statut UI repasse a deconnecte */
    UNLOCK();
    if (was) ESP_LOGW(TAG, "MQTT perdu : statut hors ligne");   /* au passage seulement, pas a chaque essai rate */
}

void shutters_mqtt_on_message(const char *topic, const char *data, int len) {
    /* Entite update HA : HA publie "INSTALL" -> on lance l'OTA de la derniere version connue. */
    if (!strcmp(topic, "openprofalux/update/install")) {
        if (ota_latest_url()[0]) {
            ESP_LOGW(TAG, "HA -> installer MAJ %s : %s", ota_latest_version(), ota_latest_url());
            ota_pull_from_url(ota_latest_url());   /* telecharge + reboot (retour auto si elle plante, voir ota.c) */
        } else {
            ESP_LOGW(TAG, "HA -> install demande mais aucune version GitHub connue");
        }
        return;
    }
    /* Switch HA "Ecoute RF permanente" (commande) */
    if (!strcmp(topic, "openprofalux/listen/set")) {
        shutters_set_log_frames(len >= 2 && !strncasecmp(data, "ON", 2));   /* publie l'etat + re-annonce */
        return;
    }
    /* Etat retained (publie par nous) : restaure l'ecoute au boot si differente. Garde anti-boucle. */
    if (!strcmp(topic, "openprofalux/listen/state")) {
        bool on = (len >= 2 && !strncasecmp(data, "ON", 2));
        if (on != s_log_frames) shutters_set_log_frames(on);   /* re-echo ignore (meme valeur) */
        return;
    }
    /* Repeuplement du ring depuis MQTT (retained frames/log/<slot>) : rempli si slot vide (NVS vide). */
    if (!strncmp(topic, "openprofalux/frames/log/", 24)) {
        int slot = atoi(topic + 24);
        cJSON *j = cJSON_ParseWithLength(data, len);
        if (j) {
            const char *ser = cJSON_GetStringValue(cJSON_GetObjectItem(j, "serial"));
            const char *bs  = cJSON_GetStringValue(cJSON_GetObjectItem(j, "button"));
            const char *hs  = cJSON_GetStringValue(cJSON_GetObjectItem(j, "hop"));
            cJSON *tj = cJSON_GetObjectItem(j, "t"), *rj = cJSON_GetObjectItem(j, "rssi");
            if (ser && hs)
                ring_fill_from_mqtt(slot, ser,
                    bs ? (uint8_t)strtoul(bs, NULL, 16) : 0, (uint32_t)strtoul(hs, NULL, 16),
                    tj ? (uint32_t)cJSON_GetNumberValue(tj) : 0, rj ? (int8_t)cJSON_GetNumberValue(rj) : 0);
            cJSON_Delete(j);
        }
        return;
    }
    /* Synchro compteur : une autre carte (ou nous) a emis ce serial -> on garde le MAX (ne recule jamais). */
    if (!strncmp(topic, "openprofalux/counter/", 21)) {
        uint32_t serial = strtoul(topic + 21, NULL, 16);
        char nb[8]; int k = len < 7 ? len : 7; memcpy(nb, data, k); nb[k] = 0;
        uint16_t rx = (uint16_t)atoi(nb);
        LOCK();
        for (int i = 0; i < s_nvolets; i++)
            if (s_volets[i].virt && s_volets[i].virt_serial == serial) {
                uint16_t keep = vc_keep(rx, s_volets[i].virt_counter);
                if (keep != s_volets[i].virt_counter) { s_volets[i].virt_counter = keep; save_cfg(); }
                break;
            }
        UNLOCK();
        return;
    }
    /* Verrou d'emission : une AUTRE carte emet ce serial -> on se refuse ~3 s (auto-expire). */
    if (!strncmp(topic, "openprofalux/busy/", 18)) {
        uint32_t serial = strtoul(topic + 18, NULL, 16);
        int idx = sync_idx_by_serial(serial);
        if (idx >= 0 && !s_self_emit[idx])   /* pas notre propre echo */
            s_busy_until[idx] = (len >= 1 && data[0] == '1') ? (sync_now_ms() + SYNC_STALE_MS) : 0;
        return;
    }
    static const char P[] = "openprofalux/cover/";
    if (strncmp(topic, P, sizeof(P) - 1)) return;
    const char *after = topic + sizeof(P) - 1;
    const char *slash = strchr(after, '/');
    if (!slash) return;
    char slug[SH_ID_LEN]; int n = slash - after; if (n >= SH_ID_LEN) n = SH_ID_LEN - 1;
    memcpy(slug, after, n); slug[n] = 0;
    const char *sub = slash + 1;
    /* le topic porte le SLUG -> on retrouve le vrai volet, puis on commande avec son id reel */
    volet_t *v = find_volet_by_slug(slug);
    if (!v) { ESP_LOGW(TAG, "MQTT cmd : volet slug '%s' inconnu", slug); return; }
    char id[SH_ID_LEN]; strlcpy(id, v->id, sizeof(id));
    char payload[16]; int m = len < 15 ? len : 15; memcpy(payload, data, m); payload[m] = 0;
    if (!s_mqtt_obey) { ESP_LOGW(TAG, "MQTT cmd ignoree (obey=OFF) pour '%s'", id); return; }   /* carte secondaire : une seule carte emet un volet partage */
    if (!strcmp(sub, "set")) {
        if      (!strcasecmp(payload, "OPEN"))  shutters_cmd_synced(id, "up", 0);
        else if (!strcasecmp(payload, "CLOSE")) shutters_cmd_synced(id, "down", 0);
        else if (!strcasecmp(payload, "STOP"))  shutters_cmd_synced(id, "stop", 0);
    } else if (!strcmp(sub, "set_position")) {
        shutters_cmd_synced(id, "pos", 100 - atoi(payload));   /* HA envoie le % d'ouverture -> on convertit en fermeture */
    }
}

/* L'ecoute radio est necessaire pour DEUX raisons independantes :
 *  - suivre la position via une vraie telecommande  -> des qu'au moins un volet est appris,
 *  - collecter le dataset slide                      -> si l'option "capture" est ON.
 * On ecoute donc si l'une OU l'autre est vraie. */
static void update_listening(void) {
    /* Ecoute permanente = uniquement si l'option est activee. Evite la saturation
     * (boucle RMT sur le bruit OOK) en usage normal. L'apprentissage et le rejeu
     * n'en dependent pas ; seuls le RF debug live, le suivi de position via la vraie
     * telecommande et le dataset MQTT necessitent cette ecoute. */
    radio_set_listening(s_log_frames);
}

void shutters_set_log_frames(bool on) {
    s_log_frames = on;
    update_listening();
    LOCK();
    save_cfg();                                        /* persiste l'ecoute permanente -> restauree au boot */
    for (int i = 0; i < s_nvolets; i++) announce_one(&s_volets[i]);   /* re-publie la decouverte : position apparait/disparait selon l'option */
    if (s_mqtt_ready) pub_defer("openprofalux/listen/state", on ? "ON" : "OFF", 0, 1);   /* etat du switch HA */
    UNLOCK();
    pub_flush();
    ESP_LOGI(TAG, "log_frames=%d", on);
}
void shutters_set_mqtt_obey(bool on) { s_mqtt_obey = on; ESP_LOGI(TAG, "mqtt_obey=%d", on); }
bool shutters_mqtt_obey(void) { return s_mqtt_obey; }

/* Dispatch d'une trame recue par la tache radio -> sync position + frame-log. */
static void on_air(const char *bits, uint32_t serial, uint8_t button, uint32_t hop, int8_t rssi) {
    shutters_on_rx(bits, serial, button, rssi, hop);
}

/* Verifie GitHub au demarrage puis toutes les 6 h (si la verification automatique est
 * active), ou a la demande (shutters_update_check_now), et republie l'etat de l'entite
 * update HA. Tache dediee : ota_check_github() est bloquant (~s), a ne pas mettre dans
 * tick_task.
 *
 * ⚠️ Delai en ticks, pas pdMS_TO_TICKS : dans l'IDF, pdMS_TO_TICKS calcule en 32 bits
 * (projdefs.h), et 6 h = 21 600 000 ms x 1000 Hz depasse 2^32. Le delai retombait a
 * ~125 s : une connexion TLS vers GitHub toutes les ~2 min au lieu de 4 par jour. */
static volatile bool s_upd_auto = true;
static TaskHandle_t  s_upd_task = NULL;
void shutters_set_update_auto(bool on) { s_upd_auto = on; ESP_LOGI(TAG, "verification MAJ auto %s", on ? "ON" : "OFF"); }
bool shutters_get_update_auto(void)    { return s_upd_auto; }
void shutters_update_check_now(void)   { if (s_upd_task) xTaskNotifyGive(s_upd_task); }

static void update_check_task(void *arg) {
    (void)arg;
    const TickType_t six_h = (TickType_t)6 * 3600 * configTICK_RATE_HZ;
    /* laisse WiFi + MQTT monter ; une demande explicite passe tout de suite */
    bool demande = ulTaskNotifyTake(pdTRUE, pdMS_TO_TICKS(30000)) > 0;
    while (1) {
        if (demande || s_upd_auto) {
            ota_check_github();
            if (s_mqtt_ready) { publish_update_state(); pub_flush(); }
        }
        demande = ulTaskNotifyTake(pdTRUE, six_h) > 0;
    }
}

/* Migration : les anciens firmwares rangeaient l'identite d'emission 0x067 dans `serials`
 * (l'ensemble des VRAIES telecommandes). Ca bloquait l'ajout de la vraie telecommande sur un
 * volet enrole (garde-fou anti-melange), et affichait le 0x067 comme "la" telecommande du volet.
 * On l'en retire : `serials` ne porte plus que du reel, l'identite virtuelle vit dans virt_serial.
 * Renvoie true si au moins un volet a change (il faut alors re-sauver). */
static bool migrate_strip_virt_serial(void) {
    bool changed = false;
    for (int i = 0; i < s_nvolets; i++) {
        volet_t *v = &s_volets[i];
        if (!v->virt) continue;
        char shex[SH_SERIAL_LEN]; snprintf(shex, sizeof(shex), "0x%07X", (unsigned)v->virt_serial);
        for (int j = 0; j < v->n_serials; j++) {
            if (strcmp(v->serials[j], shex)) continue;
            for (int k = j; k + 1 < v->n_serials; k++) strlcpy(v->serials[k], v->serials[k + 1], SH_SERIAL_LEN);
            v->n_serials--; j--; changed = true;
        }
    }
    return changed;
}

void shutters_init(void) {
    s_lock = xSemaphoreCreateMutex();
    /* L'ORDRE compte sur une NVS de 16 Ko saturee : le dataset de trames doit
     * quitter la NVS (load_frames) AVANT que la migration de la config ait besoin
     * de cette place pour ecrire ses cles par volet. */
    spiffs_mount();  /* EN PREMIER : dataset de trames et ring RF y vivent */
    cfg_layout_t lay = load_cfg();
    bool frames_stored = load_frames();   /* restaure le dataset borne ; reprend l'ancienne copie NVS si besoin */
    /* Ancien rangement -> nouveau : l'ordre et la regle d'effacement sont dans
     * cfg_store_finish_boot(), ou le banc de test les exerce tels quels. */
    esp_err_t mig = cfg_store_finish_boot(lay, frames_stored, save_cfg);
    if (mig != ESP_OK) ESP_LOGE(TAG, "migration config : ecriture KO (%s), ancien format conserve", esp_err_to_name(mig));
    else if (lay == CFG_LAYOUT_LEGACY) ESP_LOGI(TAG, "migration config : %d volets, une cle NVS par volet", s_nvolets);
    if (migrate_strip_virt_serial()) { save_cfg(); ESP_LOGI(TAG, "migration : identite 0x067 retiree de la liste des vraies telecommandes"); }
    load_ring();     /* restaure les trames recentes rejouables (bits reconstruits) apres reboot */
    ignore_load();
    purge_ghost_remotes_once();   /* une fois : fantomes d'avant la confirmation des trames (#39) */
    xTaskCreate(tick_task, "sh_tick", 4096, NULL, 5, NULL);
    xTaskCreate(update_check_task, "sh_upd", 6144, NULL, 4, &s_upd_task);   /* check GitHub -> entite update HA */
    radio_init();
    radio_start(on_air);   /* tache radio prete (arbitre TX) */
    update_listening();    /* ecoute si des volets sont deja appris (suivi position) ou si capture ON */
    ESP_LOGI(TAG, "init : %d volets, %d telecommandes, ecoute permanente=%s", s_nvolets, s_nremotes, s_log_frames ? "ON" : "OFF");
}
