Isno-Open/OpenProfalux/firmware/main/shutters.h

/*
 * shutters.h : modele "cover" OpenProfalux.
 * Clone/replay : chaque volet stocke 3 trames captees (up/down/stop) rejouees telles quelles.
 * Position estimee par le temps (le moteur ne renvoie rien). Multi-serial par volet.
 */
#ifndef SHUTTERS_H
#define SHUTTERS_H

#include <stdbool.h>
#include <stdint.h>
#include <time.h>

#define SH_MAX_VOLETS   24
/* Longueur maximale (NUL compris) de la liste des membres d'une centrale, CSV
 * d'ids : de quoi tenir TOUS les volets a leur longueur maximale (SH_ID_LEN - 1
 * caracteres + la virgule). Au-dela, la liste est refusee, jamais tronquee. Elle
 * vit sur le tas, a sa taille (cfg_model.h) : rien n'est reserve par volet. */
#define SH_MEMBERS_LEN  (SH_MAX_VOLETS * SH_ID_LEN + 1)
#define SH_MAX_SERIALS  8    /* vraies telecommandes d'un volet : une centrale + plusieurs individuelles */
#define SH_BITS_LEN     72   /* 66 bits + marge + NUL */
#define SH_ID_LEN       24
#define SH_SERIAL_LEN   12

/* Charge la config NVS + demarre la tache de suivi position. */
void shutters_init(void);
/* Tailles du ring RF et des sets de hops, DEDUITES de la RAM libre quand tout tourne (reseau,
 * MQTT, serveur web) : a appeler une fois, au premier battement. Recharge alors le ring de la
 * flash a sa taille. Avant cet appel, un petit ring garde les trames du demarrage. */
void shutters_size_from_ram(void);
/* Tailles retenues (publiees avec le battement). */
void shutters_mem_sizes(int *ring, int *hops_cap);

/* Commande : cmd = "up" | "down" | "stop" | "pos" (value = 0..100). Rejoue la trame + suit la position. */
int  shutters_cmd(const char *id, const char *cmd, int value);
#define SH_CMD_BUSY (-2)   /* une emission du meme serial est deja en cours (ici ou sur l'autre carte) */
/* Comme shutters_cmd, mais synchronise le compteur roulant entre cartes (MQTT) et pose un verrou
 * d'emission : refuse (SH_CMD_BUSY) si une emission du meme serial est deja en cours. A appeler pour
 * tout ordre venant de HA ou de l'UI ; shutters_cmd reste l'emission brute (zones, centrales). */
int  shutters_cmd_synced(const char *id, const char *cmd, int value);
int  shutters_delete_volet(const char *id);
int  shutters_delete_remote(const char *serial, const char **why);   /* refuse si un volet s'en sert (*why) */
int  shutters_ignore_remote(const char *serial, const char **why);   /* retire + n'enregistre plus ; refuse si un volet s'en sert */
int  shutters_unignore_remote(const char *serial);

/* Apprentissage : affecte une trame captee (bitstring) a une action d'un volet. Cree le volet si absent. */
int  shutters_learn_assign(const char *id, const char *action, const char *bits);
/* Cree un volet "virtuel PFX" a partir d'une identite 0x067 enrolee (pilote par generation,
 * pas rejeu) : apparait dans l'onglet Volets + cover HA. Retourne 0 si OK. */
int  shutters_create_virtual(const char *id, uint32_t serial, uint16_t counter);
int  shutters_create_virtual_somfy(const char *id, uint32_t address);   /* volet Somfy RTS (adresse 24 bits, pas de capture) */
int  shutters_create_rejeu(const char *id, uint8_t type);                /* appareil a rejeu brut OOK (code fixe) */
int  shutters_set_type(const char *id, uint8_t type);                    /* corrige le dev_type d'un appareil existant */
int  shutters_rejeu_capture(const char *id, const char *cmd, int radio, uint32_t freq_khz); /* capture le cadre brut d'une commande, a freq_khz (0 = porteuse radio) */
/* Cree une "centrale" virtuelle : une commande (ouvrir/fermer/stop) diffusee a un GROUPE de
 * volets. members_csv = ids de volets separes par des virgules. Apparait en cover HA. */
int  shutters_create_central(const char *id, const char *members_csv);
/* ZONE : volet appris dont la trame actionne plusieurs volets (telecommande de piece).
 * Ses suiveurs (CSV d'ids, "" = aucun) suivent ses mouvements sans rien emettre, pour
 * que leur etat reste juste. Une zone n'a pas de position (comme une centrale).
 * Suiveurs : volets simples seulement (ni zone, ni centrale) ; une zone ne suit rien.
 * Refuse (-1) sinon, *why (peut etre NULL) recevant la raison. */
int  shutters_set_followers(const char *id, const char *members_csv, const char **why);
int  shutters_reassign(const char *id, const char *from, const char *to);

/* Calibration : temps de course. */
int  shutters_calibrate(const char *id, uint32_t up_ms, uint32_t down_ms);
int  shutters_set_orientation(const char *id, int orientation);   /* azimut facade (-1 = non defini) */
/* Params d'emission PAR APPAREIL (etage 2, issue #111) : porteuse, TE, tri-etat bit de repetition/RMT
 * (tx_override_t). freq_khz/te_us a 0 = heriter. marque=NULL = provenance inchangee. */
int  shutters_set_tx_params(const char *id, uint32_t freq_khz, uint32_t te_us,
                            int rpt, int rmt, int frame_bits, const char *marque);
/* Renomme un volet (change son id + met a jour membres/suiveurs + entite HA). 0 ok ; -4 nom deja pris. */
int  shutters_rename_volet(const char *old_id, const char *new_id);
/* Ordre d'affichage dans l'UI : CSV d'ids dans l'ordre voulu. N'affecte QUE
 * l'affichage web (ni radio, ni pilotage, ni decouverte HA). */
int  shutters_set_order(const char *ids_csv);

/* Nommage d'une telecommande (serial -> nom). */
int  shutters_remote_name(const char *serial, const char *name);

/* Appele par le sniff RX : met a jour la position si une commande externe bouge un volet. */
void shutters_on_rx(const char *bits, uint32_t serial, uint8_t button, int8_t rssi, uint32_t hop);
/* Adopte une trame vue dans le journal RF (identifiee par serial+hop) et l'affecte a une action. */
int  shutters_adopt(const char *id, const char *action, const char *serial, uint32_t hop);
/* Volet cree depuis une telecommande du journal RF (derniere trame ▲ ■ ▼) ; learned = "up,stop,down". */
int  shutters_create_volet_from_remote(const char *id, const char *serial, char *learned, size_t cap, const char **why);
/* Rejoue telle quelle une trame captee (serial+hop) depuis le journal RF (bouton "rejouer" du debug). */
int  shutters_replay_frame(const char *serial, uint32_t hop);
/* Journal RF pour /api/rf : la page [offset, offset + limit) des trames triees par date
 * (recentes d'abord), copiee dans out (limit places). Renvoie le nombre total de trames
 * (-1 si plus de memoire) ; *nout recoit le nombre copie. */
typedef struct { char serial[SH_SERIAL_LEN]; uint32_t hop, t; uint8_t button; int8_t rssi; } shutters_rf_item_t;
int  shutters_rf_page(int offset, int limit, shutters_rf_item_t *out, int *nout);

/* JSON /api/status, alloue a sa taille : a liberer par l'appelant (NULL si plus de
 * memoire). Plus de tampon fixe : celui de 4 Ko tronquait l'etat au-dela de ~9 volets,
 * et l'UI recevait un JSON invalide. */
char *shutters_status_json(void);

/* ── Integration Home Assistant (MQTT) ── */
/* Publie la discovery HA (1 cover par volet) + l'etat courant. A appeler apres connexion MQTT. */
void shutters_mqtt_announce(const char *device);
void shutters_mqtt_lost(void);   /* broker perdu -> statut hors ligne */
/* Export dataset slide : par telecommande, ses trames distinctes {hop, bouton, t} (tout brut). */
typedef struct { uint32_t hop; uint32_t t; uint8_t button; } dframe_t;
int  shutters_remote_count(void);
/* Telecommande i : numero, nom, et ses trames [from, from + maxframes) copiees dans frames.
 * Renvoie son nombre TOTAL de trames (-1 si i n'existe pas) : l'export les parcourt par
 * tranches, sans tampon de la taille du dataset. */
int  shutters_remote_dump(int i, int from, char *serial, int sser, char *name, int sname, dframe_t *frames, int maxframes);
/* Route une commande HA cover recue en MQTT : openprofalux/cover/<id>/set|set_position. */
void shutters_mqtt_on_message(const char *topic, const char *data, int len);
/* Active/desactive la publication MQTT de TOUTES les trames captees (dedup par serial). */
void shutters_set_log_frames(bool on);

/* Par carte : obeir aux ordres cover MQTT (emettre quand HA commande) ? Defaut oui. Couper sur une
   carte secondaire quand deux cartes partagent un volet : une seule emet (pas de double emission). */
void shutters_set_mqtt_obey(bool on);
bool shutters_mqtt_obey(void);

/* ── Verification de mise a jour (GitHub) ── */
/* Verification automatique toutes les 6 h (defaut : oui). Desactivee, seule une demande
 * explicite (shutters_update_check_now) interroge GitHub. */
void shutters_set_update_auto(bool on);
bool shutters_get_update_auto(void);
/* Demande une verification tout de suite, en tache de fond (ne bloque pas l'appelant).
 * Fin observable par ota_check_count(). */
void shutters_update_check_now(void);

/* ── Sauvegarde / restauration ── */
/* Exporte toute la config (telecommandes + noms + trames de reference + calibration) en
 * JSON, alloue a sa taille : a liberer par l'appelant (NULL si plus de memoire). */
char *shutters_export_json(void);
/* Restaure la config depuis un JSON (remplace tout). Retourne 0 si OK ; sinon *err dit
 * pourquoi : "format" (pas une sauvegarde de config, rien n'est touche), "copie" (la
 * config actuelle n'a pas pu etre copiee, rien n'est touche) ou "nvs" (restauree mais
 * pas enregistree). Avant de remplacer, copie la config courante : voir undo. */
int  shutters_import_json(const char *js, const char **err);
/* Revient a la config d'avant la derniere restauration ; celle-ci devient la copie. */
int  shutters_restore_undo(const char **err);
/* Une copie existe-t-elle ? *t recoit sa date (fiable si l'heure etait synchronisee). */
bool shutters_prev_cfg_time(time_t *t);

/* ── Identités virtuelles PFX (anti-conflit + resync compteur pour l'enrôlement) ── */
bool     shutters_virt_serial_used(uint32_t serial);        /* serial 0x067 déjà pris par un volet ? */
bool     shutters_heard_serial_used(uint32_t serial);       /* serial déjà entendu sur l'air (télécommande tierce) ? */
bool     shutters_virt_name_for_serial(uint32_t serial, char *out, size_t cap); /* volet virtuel de ce serial */
uint16_t shutters_virt_counter_for_serial(uint32_t serial); /* compteur du volet de ce serial (0 si aucun) */

#endif
/* Publications perdues faute de place dans la file differee (voir PUB_DEFER_BUDGET). */
uint32_t shutters_pub_dropped(void);
