Isno-Open/OpenProfalux/firmware/main/cfg_model.c

/* Config persistante des volets : serialisation JSON et rangement. Voir cfg_model.h. */
#include "cfg_model.h"
#include <stdio.h>
#include <stdlib.h>
#include <string.h>
#if __has_include(<bsd/string.h>)
#include <bsd/string.h>   /* strlcpy sur PC (banc de test) ; newlib la fournit sur l'ESP32 */
#endif
#include "esp_log.h"

static const char *TAG = "cfg_model";

/* ── Membres d'une centrale ── */
int cfg_volet_set_members(volet_t *v, const char *csv) {
    size_t n = csv ? strlen(csv) : 0;
    if (n >= SH_MEMBERS_LEN) return -1;
    char *copy = NULL;
    if (n && !(copy = strdup(csv))) return -1;
    free(v->members);
    v->members = copy;
    return 0;
}
void cfg_volet_release(volet_t *v) {
    free(v->members);
    v->members = NULL;
}
void cfg_model_remove(const cfg_model_t *m, int idx) {
    int n = *m->nvolets;
    if (idx < 0 || idx >= n) return;
    cfg_volet_release(&m->volets[idx]);
    memmove(&m->volets[idx], &m->volets[idx + 1], (size_t)(n - idx - 1) * sizeof(volet_t));
    memset(&m->volets[n - 1], 0, sizeof(volet_t));   /* la place liberee ne partage plus de liste */
    (*m->nvolets)--;
}
/* Meme decoupage que l'ancien parcours (copie + strtok_r + espaces de tete),
 * sans tampon : un tampon fixe etait ce qui tronquait la liste. */
const char *cfg_members_next(const char *p, char id[SH_ID_LEN]) {
    if (!p) return NULL;
    while (*p == ',') p++;
    if (!*p) return NULL;
    while (*p == ' ') p++;
    size_t n = strcspn(p, ",");
    if (n < SH_ID_LEN) { memcpy(id, p, n); id[n] = 0; }
    else id[0] = 0;
    return p + n;
}

/* ── Modele -> JSON ── */
static cJSON *volet_to_json(const volet_t *v) {
    cJSON *o = cJSON_CreateObject();
    cJSON_AddStringToObject(o, "id", v->id);
    cJSON *sr = cJSON_AddArrayToObject(o, "serials");
    for (int j = 0; j < v->n_serials; j++) cJSON_AddItemToArray(sr, cJSON_CreateString(v->serials[j]));
    cJSON *cmd = cJSON_AddObjectToObject(o, "cmd");
    cJSON_AddStringToObject(cmd, "up", v->up);
    cJSON_AddStringToObject(cmd, "down", v->down);
    cJSON_AddStringToObject(cmd, "stop", v->stop);
    cJSON_AddNumberToObject(o, "up_btn", v->up_btn);
    cJSON_AddNumberToObject(o, "down_btn", v->down_btn);
    cJSON_AddNumberToObject(o, "stop_btn", v->stop_btn);
    cJSON_AddNumberToObject(o, "travel_up_ms", v->travel_up_ms);
    cJSON_AddNumberToObject(o, "travel_down_ms", v->travel_down_ms);
    cJSON_AddNumberToObject(o, "orientation", v->orientation);
    cJSON_AddNumberToObject(o, "order", v->order);   /* rang d'affichage UI (-1 = non range) */
    cJSON_AddNumberToObject(o, "position", (int)(v->position + 0.5f));
    if (v->virt) {   /* volet virtuel : identite 0x067 + compteur roulant persiste */
        cJSON_AddBoolToObject(o, "virt", true);
        cJSON_AddNumberToObject(o, "virt_serial", v->virt_serial);
        cJSON_AddNumberToObject(o, "virt_counter", v->virt_counter);
        /* Protocole : omis quand il vaut Profalux (0), pour garder le JSON et les
         * sauvegardes existantes a l'identique. */
        if (v->proto != VOLET_PROTO_PROFALUX)
            cJSON_AddNumberToObject(o, "proto", v->proto);
        /* Format Somfy RTS : omis quand il vaut 56 bits (0), meme raison que proto. */
        if (v->somfy_mode)
            cJSON_AddNumberToObject(o, "somfy_mode", v->somfy_mode);
    }
    if (v->central) cJSON_AddBoolToObject(o, "central", true);
    /* Centrale : volets membres. Zone : volets suiveurs. Toujours ecrit pour une
     * centrale (meme vide, comme avant) ; pour un volet, seulement s'il en a. */
    if (v->central || v->members) cJSON_AddStringToObject(o, "members", v->members ? v->members : "");
    return o;
}
/* En-tete : tout ce qui n'est pas un volet. */
static cJSON *hdr_to_json(const cfg_model_t *m) {
    cJSON *root = cJSON_CreateObject();
    cJSON_AddBoolToObject(root, "log_frames", *m->log_frames);   /* ecoute permanente : restauree au boot */
    cJSON *rem = cJSON_AddObjectToObject(root, "remotes");
    for (int i = 0; i < *m->nremotes; i++) cJSON_AddStringToObject(rem, m->remotes[i].serial, m->remotes[i].name);
    return root;
}
char *cfg_model_export(const cfg_model_t *m) {
    cJSON *root = hdr_to_json(m);
    cJSON *vols = cJSON_AddArrayToObject(root, "volets");
    for (int i = 0; i < *m->nvolets; i++) cJSON_AddItemToArray(vols, volet_to_json(&m->volets[i]));
    char *js = cJSON_PrintUnformatted(root);
    cJSON_Delete(root);
    return js;
}
static char *print_and_free(cJSON *j) {   /* NULL si plus de memoire : cfg_store le compte en echec */
    char *s = j ? cJSON_PrintUnformatted(j) : NULL;
    cJSON_Delete(j);
    return s;
}
/* Un document a la fois : la config n'est jamais tenue entiere en RAM, ni
 * reecrite en bloc. Un volet inchange ne coute rien, la NVS ignore une valeur
 * identique. */
esp_err_t cfg_model_save(const cfg_model_t *m, char *failed_key) {
    cfg_store_tx_t tx;
    if (cfg_store_begin(&tx) == ESP_OK) {
        char *d = print_and_free(hdr_to_json(m));
        cfg_store_put_hdr(&tx, d); free(d);
        for (int i = 0; i < *m->nvolets; i++) {
            d = print_and_free(volet_to_json(&m->volets[i]));
            cfg_store_put_volet(&tx, d); free(d);
        }
    }
    esp_err_t e = cfg_store_end(&tx);
    if (failed_key) memcpy(failed_key, tx.failed_key, sizeof(tx.failed_key));
    return e;
}

/* ── JSON -> modele ── */
/* Peuple les telecommandes depuis l'en-tete (le modele doit etre remis a zero avant). */
static void parse_hdr_json(const cfg_model_t *m, cJSON *root) {
    cJSON *lf = cJSON_GetObjectItem(root, "log_frames");
    if (cJSON_IsBool(lf)) *m->log_frames = cJSON_IsTrue(lf);   /* restaure l'ecoute permanente au boot */
    cJSON *rem = cJSON_GetObjectItem(root, "remotes");
    /* Objet attendu : dans un tableau, it->string est NULL et strlcpy plantait
     * (redemarrage provoque par une restauration malformee). */
    if (!cJSON_IsObject(rem)) return;
    for (cJSON *it = rem->child; it && *m->nremotes < SH_MAX_REMOTES; it = it->next) {
        if (!it->string) continue;
        remote_t *r = &m->remotes[(*m->nremotes)++];
        memset(r, 0, sizeof(*r));
        strlcpy(r->serial, it->string, SH_SERIAL_LEN);
        strlcpy(r->name, cJSON_IsString(it) ? it->valuestring : "", SH_ID_LEN);
    }
}
/* Ajoute UN volet depuis son document JSON. */
static void parse_volet_json(const cfg_model_t *m, cJSON *o) {
    if (*m->nvolets >= SH_MAX_VOLETS) return;
    char id[SH_ID_LEN];
    strlcpy(id, cJSON_GetStringValue(cJSON_GetObjectItem(o, "id")) ?: "", sizeof(id));
    /* Identifiant deja charge : ignore. Ne se produit pas en temps normal, mais une
     * coupure au milieu de la suppression d'un volet (les cles suivantes sont
     * renumerotees) peut laisser deux fois le meme document. */
    for (int i = 0; i < *m->nvolets; i++)
        if (!strcmp(m->volets[i].id, id)) { ESP_LOGW(TAG, "volet '%s' en double, ignore", id); return; }
    volet_t *v = &m->volets[(*m->nvolets)++];
    memset(v, 0, sizeof(*v)); v->target = -1; v->pub_pos = -1; v->pub_dir = -9;
    strlcpy(v->id, id, SH_ID_LEN);
    cJSON *sr = cJSON_GetObjectItem(o, "serials");
    for (cJSON *s = sr ? sr->child : NULL; s && v->n_serials < SH_MAX_SERIALS; s = s->next)
        strlcpy(v->serials[v->n_serials++], cJSON_GetStringValue(s) ?: "", SH_SERIAL_LEN);
    cJSON *cmd = cJSON_GetObjectItem(o, "cmd");
    if (cmd) {
        strlcpy(v->up,   cJSON_GetStringValue(cJSON_GetObjectItem(cmd, "up"))   ?: "", SH_BITS_LEN);
        strlcpy(v->down, cJSON_GetStringValue(cJSON_GetObjectItem(cmd, "down")) ?: "", SH_BITS_LEN);
        strlcpy(v->stop, cJSON_GetStringValue(cJSON_GetObjectItem(cmd, "stop")) ?: "", SH_BITS_LEN);
    }
    v->up_btn   = (uint8_t)cJSON_GetNumberValue(cJSON_GetObjectItem(o, "up_btn"));
    v->down_btn = (uint8_t)cJSON_GetNumberValue(cJSON_GetObjectItem(o, "down_btn"));
    v->stop_btn = (uint8_t)cJSON_GetNumberValue(cJSON_GetObjectItem(o, "stop_btn"));
    v->travel_up_ms   = cJSON_GetNumberValue(cJSON_GetObjectItem(o, "travel_up_ms"));
    v->travel_down_ms = cJSON_GetNumberValue(cJSON_GetObjectItem(o, "travel_down_ms"));
    cJSON *ori = cJSON_GetObjectItem(o, "orientation");
    v->orientation    = ori ? (int)cJSON_GetNumberValue(ori) : -1;   /* -1 = non defini */
    /* Champ absent (config anterieure) -> -1 : le volet garde sa place actuelle. */
    cJSON *ord = cJSON_GetObjectItem(o, "order");
    v->order          = ord ? (int)cJSON_GetNumberValue(ord) : -1;
    v->position       = cJSON_GetNumberValue(cJSON_GetObjectItem(o, "position"));
    cJSON *vt = cJSON_GetObjectItem(o, "virt");
    if (cJSON_IsTrue(vt)) {
        v->virt         = true;
        v->virt_serial  = (uint32_t)cJSON_GetNumberValue(cJSON_GetObjectItem(o, "virt_serial"));
        v->virt_counter = (uint16_t)cJSON_GetNumberValue(cJSON_GetObjectItem(o, "virt_counter"));
        cJSON *pr       = cJSON_GetObjectItem(o, "proto");   /* absent -> Profalux (0) */
        v->proto        = pr ? (uint8_t)cJSON_GetNumberValue(pr) : (uint8_t)VOLET_PROTO_PROFALUX;
        cJSON *sm       = cJSON_GetObjectItem(o, "somfy_mode");   /* absent -> 56 bits (0) */
        v->somfy_mode   = sm ? (uint8_t)cJSON_GetNumberValue(sm) : 0;
    }
    v->central = cJSON_IsTrue(cJSON_GetObjectItem(o, "central"));
    /* Membres d'une centrale, ou suiveurs d'une zone. Une liste ecrite par le
     * firmware tient toujours : seul un fichier modifie a la main peut depasser
     * SH_MEMBERS_LEN. Refusee entiere plutot que tronquee, et signalee. */
    const char *mem = cJSON_GetStringValue(cJSON_GetObjectItem(o, "members")) ?: "";
    if (cfg_volet_set_members(v, mem) != 0)
        ESP_LOGE(TAG, "%s '%s' : liste de membres de %u o refusee (trop longue ou plus de memoire)",
                 v->central ? "centrale" : "zone", v->id, (unsigned)strlen(mem));
}
void cfg_model_import(const cfg_model_t *m, cJSON *root) {
    parse_hdr_json(m, root);
    cJSON *vols = cJSON_GetObjectItem(root, "volets");
    for (cJSON *o = vols ? vols->child : NULL; o; o = o->next) parse_volet_json(m, o);
}
bool cfg_model_is_backup(const cJSON *root) {
    if (!cJSON_IsObject(root)) return false;
    const cJSON *rem = cJSON_GetObjectItemCaseSensitive(root, "remotes");
    return cJSON_IsArray(cJSON_GetObjectItemCaseSensitive(root, "volets")) && (!rem || cJSON_IsObject(rem));
}
bool cfg_model_save_copy(const cfg_model_t *m, const char *path) {
    char *js = cfg_model_export(m);
    bool ok = js && cfg_write_file(path, js, strlen(js));
    free(js);
    return ok;
}

/* ── NVS -> modele ── */
static void on_cfg_doc(void *ctx, int index, const char *doc) {
    const cfg_model_t *m = ctx;
    cJSON *j = cJSON_Parse(doc);
    if (!j) { ESP_LOGE(TAG, "document %d illisible", index); return; }
    if (index == CFG_DOC_LEGACY)   cfg_model_import(m, j);
    else if (index == CFG_DOC_HDR) parse_hdr_json(m, j);
    else                           parse_volet_json(m, j);
    cJSON_Delete(j);
}
/* L'ancienne config (cle NVS unique) contient-elle au moins un volet ? */
static bool legacy_has_volets(const char *doc) {
    cJSON *j = cJSON_Parse(doc);
    bool yes = cJSON_GetArraySize(cJSON_GetObjectItem(j, "volets")) > 0;
    cJSON_Delete(j);
    return yes;
}
cfg_layout_t cfg_model_load(const cfg_model_t *m) {
    return cfg_store_load(on_cfg_doc, (void *)m, legacy_has_volets);
}

/* ── Dataset de trames ── */
bool cfg_frames_load(const char *path, void *buf, size_t cap, size_t *sz) {
    *sz = 0;
    FILE *f = fopen(path, "rb");
    if (f) {
        *sz = fread(buf, 1, cap, f);
        fclose(f);
        return true;
    }
    size_t n = cfg_store_read_legacy_frames(buf, cap);
    if (!n) return false;
    *sz = n;
    /* Ecrit directement sous son nom final, un fichier coupe en cours d'ecriture
     * (panne de courant) passait au demarrage suivant pour le dataset complet, et
     * sa copie NVS, la seule entiere, etait effacee : d'ou cfg_write_file. */
    bool ok = cfg_write_file(path, buf, n);
    if (ok) ESP_LOGI(TAG, "dataset de trames : NVS -> fichier (%u o)", (unsigned)n);
    else    ESP_LOGE(TAG, "dataset de trames : ecriture du fichier KO, il reste en NVS");
    return ok;
}

/* Le temporaire est complet avant de toucher a l'ancien fichier. SPIFFS refuse de
 * renommer vers un fichier existant (SPIFFS_ERR_CONFLICTING_NAME) : l'ancien est
 * alors efface juste avant. Une coupure entre les deux laisse le temporaire complet,
 * que cfg_read_file reprend ; un temporaire incomplet est reecrit la fois suivante. */
bool cfg_write_file(const char *path, const void *buf, size_t n) {
    char tmp[96];
    if (snprintf(tmp, sizeof(tmp), "%s.tmp", path) >= (int)sizeof(tmp)) return false;
    FILE *w = fopen(tmp, "wb");
    bool ok = w && fwrite(buf, 1, n, w) == n;
    if (w && fclose(w) != 0) ok = false;
    if (!ok) { if (w) remove(tmp); return false; }
    if (rename(tmp, path) == 0) return true;
    if (remove(path) != 0) { remove(tmp); return false; }   /* l'ancien reste */
    return rename(tmp, path) == 0;
}
char *cfg_read_file(const char *path, size_t cap, size_t *n) {
    char tmp[96];
    FILE *f = fopen(path, "rb");
    if (!f && snprintf(tmp, sizeof(tmp), "%s.tmp", path) < (int)sizeof(tmp)) f = fopen(tmp, "rb");
    if (!f) return NULL;
    char *buf = malloc(cap + 1);
    size_t got = buf ? fread(buf, 1, cap + 1, f) : 0;
    fclose(f);
    if (!buf || got == 0 || got > cap) { free(buf); return NULL; }
    buf[got] = 0;
    if (n) *n = got;
    return buf;
}
