Isno-Open/OpenProfalux/firmware/main/cc1101.h

/*
 * CC1101 driver : TX + RX for Profalux 868.35 MHz OOK
 *
 * Provides:
 *   - Init SPI + register config for OOK 868.35 MHz ~1550 baud
 *   - TX single frame (=synthesize OOK signal via GDO0 bit-banging)
 *   - RX capture : invokes callback for each detected frame
 */
#ifndef CC1101_H
#define CC1101_H

#include <stdint.h>
#include <stdbool.h>
#include <stddef.h>

typedef void (*cc1101_rx_cb_t)(const uint8_t *frame, size_t bits, int8_t rssi_dbm);

int  cc1101_init(void);

/* Transmit one frame using OOK modulation (=synthesize preamble + header + data) */
int  cc1101_tx_ook_frame(const uint8_t *frame, size_t bits);

/* Enter async RX mode. Callback invoked from ISR-friendly task */
int  cc1101_rx_start(cc1101_rx_cb_t cb);
int  cc1101_rx_stop(void);

/* Auto-test emission : renvoie 0 si la puce passe bien en TX (MARCSTATE 0x13). */
int  cc1101_tx_selftest(void);
/* Frequence porteuse en kHz (profil radio, voir radio_profile.h). 0=OK, -1=non prise. */
int      cc1101_set_freq_khz(uint32_t khz);
uint32_t cc1101_get_freq_khz(void);

/* Radios de la carte (issue #95). La carte peut declarer plusieurs CC1101 sur le bus SPI
 * partage (index 0 = primaire 868). Une seule est active a la fois : le TX/RX vise la radio
 * active. Selection a appeler sous le mutex radio (radio.c). */
int cc1101_radio_count(void);              /* nombre de radios declarees (>=1) */
int cc1101_active_radio(void);             /* index de la radio active */
int cc1101_radio_for_khz(uint32_t khz);    /* index dont la bande contient khz, ou -1 */
int cc1101_select(int idx);                /* rend active la radio idx ; 0=OK, -1=hors borne */
/* Description d'une radio declaree, pour l'UI (/api/radios) : etiquette de bande ("868"/"433"),
 * porteuse declaree, frequence courante figee, bornes de bande, PARTNUM/VERSION lus a l'init.
 * Tout pointeur peut etre NULL. 0=OK, -1=index hors borne. */
int cc1101_radio_info(int idx, const char **band, uint32_t *carrier_khz, uint32_t *cur_khz,
                      uint32_t *low_khz, uint32_t *high_khz, uint8_t *partnum, uint8_t *version);
int  cc1101_rx_probe(void);   /* sonde de bruit RX au boot (RSSI + nb d'evenements RMT a vide) */

/* Auto-capture : initialise le RMT sur GDO0 pour relire notre propre emission. */
int  cc1101_capture_init(void);
/* Emet frame + capture GDO0 + decode en bits (ordre du fil). Retourne nbits (<0=err). */
int  cc1101_tx_and_capture_bits(const uint8_t *frame, size_t bits, char *out_bits, int max_bits);
/* Ecoute en RX pendant timeout_ms, decode la 1re trame recue. Retourne nbits (<0=rien). */
int  cc1101_rx_listen_bits(uint32_t timeout_ms, char *out_bits, int max_bits);
/* Capture OOK BRUTE (issue #95) : rend les impulsions brutes (levels[]/us[]) sans decoder,
 * pour rejouer les telecommandes a code fixe (CAME, capteurs) hors protocole Profalux/Somfy. */
int  cc1101_rx_capture_pulses(uint32_t timeout_ms, uint8_t *levels, uint16_t *us, int max, int8_t *rssi_out);
/* Profil RX des captures brutes (PERSISTANT jusqu'au prochain appel) : debit (baud) et bande
 * passante (kHz) de demodulation, mappes en MDMCFG4/MDMCFG3 a chaque capture puis restaures.
 * 0/0 = config courante (agnostique). Les valeurs viennent du profil (profiles.json), pas du
 * code. Commodite de test ; la production passe le profil par capture (UI -> API rejeu). */
void cc1101_set_capture_rx(uint32_t drate_baud, uint32_t bw_khz);
/* Rejoue (TX) une trame brute (chaine '0'/'1' en ordre du fil) en OOK HCS30x. */
int  cc1101_tx_raw_bits(const char *bits, int n, int repeats);

/* Emet un train d'impulsions OOK brut : chaque impulsion est un niveau (0/1) tenu us[i]
 * microsecondes, en bit-bang sur GDO0, dans UNE session TX. Primitive GENERIQUE, sans
 * protocole : l'appelant fournit la forme d'onde complete (et a deja retune la porteuse
 * si besoin). Rend 0 si emis, -1 sur argument invalide. */
int  cc1101_tx_ook_pulses(const uint8_t *levels, const uint32_t *us, int n);

/* Utils */
extern int g_tx_marc;   /* MARCSTATE lu apres le dernier STX (0x13=TX). Diagnostic. */
int8_t cc1101_get_rssi(void);
/* Balayage RSSI : RSSI max (demi-dB) sur dwell_ms a chaque frequence khz[i]. Filtre RX a 58 kHz
 * pendant le balayage ; frequence et filtre restaures. L'appelant tient le radio. 0, ou -1. */
int cc1101_rssi_scan(const uint32_t *khz, int n, int dwell_ms, int16_t *peak_hdb);
void cc1101_set_rx_debug(bool on);   /* switch DEBUG : logge chaque capture RX (symboles+RSSI+bits+classif) */
bool cc1101_get_rx_debug(void);
void cc1101_set_rx_gain(uint8_t agcctrl2);   /* plafond de gain RX (AGCCTRL2) reglable ; defaut 0x27 */
uint8_t cc1101_get_rx_gain(void);
void cc1101_set_tx_repeat_bit(bool on);      /* imite la telecommande : RPT 0 puis 1, 18 ms entre trames */
bool cc1101_get_tx_repeat_bit(void);
void cc1101_set_tx_rmt(bool on);              /* emission par le RMT (timing materiel) au lieu du bit-bang */
bool cc1101_get_tx_rmt(void);
void cc1101_set_tx_te(uint32_t te_us);       /* TE d'emission (us) reglable ; defaut TX_TE_DEFAULT_US (400) */
uint32_t cc1101_get_tx_te(void);
int cc1101_last_te(void);                    /* TE (us) mesure sur la derniere trame decodee */
void cc1101_spi_stats(uint32_t *retries, uint32_t *fails); /* ecritures SPI reessayees / jamais prises */
void cc1101_get_diag(int *tx_ok, uint8_t *partnum, uint8_t *version); /* diag UI : puce + self-test TX */
int  cc1101_gdo0_state(int *level);   /* GDO0 : -1 non teste, 1 libre, 0 tenu (*level = niveau) */
uint8_t cc1101_read_reg(uint8_t addr);
void   cc1101_write_reg(uint8_t addr, uint8_t val);

/* Acces mode PAQUET (FIFO + strobes), pour les protocoles FSK comme io-homecontrol (#87).
 * Transferts burst bornes a 31 octets utiles ; le chemin OOK n'en a pas besoin. */
void cc1101_strobe_cmd(uint8_t strobe);
void cc1101_write_burst(uint8_t addr, const uint8_t *buf, size_t len);
void cc1101_read_burst(uint8_t addr, uint8_t *buf, size_t len);
/* Reapplique la config OOK/Profalux (restaure la modulation apres un passage FSK io). */
void cc1101_apply_config_ook(void);

#endif
