Isno-Open/OpenProfalux/firmware/main/profalux.h

/*
 * Profalux protocol specific - frame build/parse + TX/RX
 */
#ifndef PROFALUX_H
#define PROFALUX_H

#include <stdint.h>
#include <stdbool.h>
#include "hardware_config.h"

/* Profalux transmitter state (=persisted in NVS) */
typedef struct {
    uint32_t serial;         /* 28-bit */
    uint64_t crypt_key;      /* 64-bit */
    uint16_t counter;        /* Rolling code counter */
    uint16_t discrimination; /* 12-bit discrim (=8 LSB serial typical) */
} pfx_tx_state_t;

/* Parsed RX frame from external transmitter */
typedef struct {
    uint32_t serial;         /* Serial extracted from frame */
    uint32_t encrypted_hop;  /* Raw encrypted 32-bit hop */
    uint8_t  button;         /* Button code */
    uint8_t  status_flags;   /* 2 status bits */
    uint16_t counter;        /* Decrypted counter (=only if we have the crypt_key) */
    bool     decoded;        /* true if crypt_key was known and decoded */
} pfx_rx_frame_t;

/* Init state: load NVS or generate new random */
int  pfx_state_init(pfx_tx_state_t *st);
int  pfx_state_save(const pfx_tx_state_t *st);
int  pfx_state_reset(pfx_tx_state_t *st);  /* Force new random (=re-pair) */

/* Build 66-bit frame in 9-byte buffer */
void pfx_frame_build(const pfx_tx_state_t *st, uint8_t button, uint8_t frame[9]);

/* Parse received 66-bit frame */
int  pfx_frame_parse(const uint8_t frame[9], pfx_rx_frame_t *out);

/* Try to decrypt hop using known crypt_key */
int  pfx_frame_decrypt(pfx_rx_frame_t *frm, uint64_t crypt_key);

/* Emit N frames spaced over duration_ms (=for pairing burst) */
void pfx_emit_burst(pfx_tx_state_t *st, uint8_t button, uint32_t n_frames, uint32_t duration_ms);

/* Tient un bouton "appuye" (meme compteur/hop) pendant duration_ms, comme un
 * vrai appui maintenu. Incremente et sauvegarde le compteur UNE fois a la fin.
 * Utilise pour l'etape 2 de la notice (STOP-en-P maintenu 5 s = bouton 0x8). */
void pfx_emit_hold(pfx_tx_state_t *st, uint8_t button, uint32_t duration_ms);

/* Workflow GW d'enrolement : SETTINGS interne silencieux pendant 5 s,
 * transition du compteur, puis seule emission RF ENROLL bouton 0x5. */
void pfx_emit_enroll(pfx_tx_state_t *st);

/* Emit single command (=3 repeats HCS301-style) */
void pfx_emit_command(pfx_tx_state_t *st, uint8_t button);

#endif
