Isno-Open/OpenProfalux/firmware/main/web_ui.c

/*
 * web_ui.c : serveur HTTP OpenProfalux, sert l'UI embarquee + endpoints sous /api.
 */
#include "web_ui.h"
#include "shutters.h"
#include "cfg_model.h"   /* tx_override_t (TXOVR_*) : tri-etat des options d'emission par appareil */
#include "pfx_enrol.h"
#include "pfx_keys.h"   /* pfx_key_for_serial : refuser une adresse Somfy = identite 0x067 */
#include "enrol_gate.h"
#include "radio.h"
#include "rf_capture.h"   /* capture OOK brute + rejeu (issue #95) */
#include "ota.h"
#include "mqtt_bridge.h"       /* mqtt_cert_write / mqtt_cert_len (certificats TLS en NVS) */
#include "wifi_bridge.h"
#include "hardware_config.h"   /* TARGET_NAME (expose la variante a l'UI OTA) */
#include <string.h>
#include <stdlib.h>
#include "esp_log.h"
#include "esp_http_server.h"
#include "esp_wifi.h"
#include "esp_netif.h"
#include "mdns.h"
#include "nvs.h"
#include "freertos/FreeRTOS.h"
#include "freertos/task.h"
#include "esp_timer.h"
#include "cJSON.h"
#include "log_ring.h"
#include "cc1101.h"
#include "radio_profile.h"   /* profil radio (frequence par marque) */
#include "esp_random.h"
#include "esp_system.h"      /* esp_reset_reason, tas libre (/api/health) */
#include "esp_heap_caps.h"
#include "esp_spiffs.h"
#include "esp_ota_ops.h"
#include "esp_app_desc.h"
#include "esp_http_client.h" /* POST du rapport vers le relais www.isno.fr */
#include "esp_crt_bundle.h"  /* verification TLS du relais */
#include "esp_mac.h"         /* chip-id (MAC eFuse) : cle stable qui survit au flash */
#include "cfg_store.h"       /* place des volets en NVS */
#include "req_guard.h"       /* envois venus d'un autre site (CSRF) */
#include <inttypes.h>

#ifndef MIN
#define MIN(a,b) ((a) < (b) ? (a) : (b))
#endif

static const char *TAG = "web_ui";

/* ── Authentification par SESSION (cookie) ──────────────────────────────────
 * MODELE : tant qu'AUCUN mot de passe n'est enregistre (cle NVS cfg/ui_pass vide
 * ou absente), l'UI est OUVERTE : c'est l'etat du 1er demarrage, celui des
 * boitiers deja deployes : aucune regression, aucun mot de passe par defaut a
 * deviner. Des que l'utilisateur en definit un, TOUTES les routes "/api/" l'exigent.
 * La desactivation se fait par un bouton dedie de l'UI (envoie ui_pass vide).
 *
 * POURQUOI PAS HTTP Basic : la popup native du navigateur ne permet ni de se
 * deconnecter, ni d'expliquer quoi que ce soit, et le navigateur rejoue les
 * identifiants indefiniment. On utilise donc une page de login servie par l'UI :
 * POST /api/login verifie le mot de passe et pose un cookie de session.
 *
 * JETONS EN RAM UNIQUEMENT : ils ne sont jamais ecrits en flash (pas d'usure NVS,
 * rien a lire sur une flash extraite). Consequence assumee : un reboot du boitier
 * invalide les sessions ouvertes -> il faut se reconnecter. Un boitier reboote
 * rarement, et c'est le comportement le plus sur.
 *
 * PORTEE : seul le HTTP est concerne. Home Assistant pilote le boitier par MQTT
 * (cover/set, listen/set, update/install...) et n'appelle jamais ces routes :
 * activer l'auth n'a AUCUN impact sur l'integration HA, OTA par HA comprise.
 *
 * Le cookie transite en clair (pas de TLS sur l'UI) : cela protege d'un acces
 * opportuniste sur le LAN, pas d'une ecoute du reseau. C'est le niveau adapte
 * a la menace reelle ici ; le point dur restant est /api/ota/upload, qui permet
 * sinon de pousser un firmware arbitraire depuis n'importe quel appareil. */
#define UI_PASS_MAX   64
#define UI_SESS_MAX    4     /* sessions simultanees (navigateurs/appareils) */
#define UI_TOKEN_LEN  32     /* longueur du jeton en caracteres hex */
#define UI_SESS_TTL_S (7 * 24 * 3600)   /* validite d'une session : 7 jours */

/* Mot de passe courant en cache RAM (evite un acces NVS a chaque requete).
 * Vide = authentification desactivee. Recharge par ui_auth_reload(). */
static char s_ui_pass[UI_PASS_MAX] = "";

/* Table des sessions actives (RAM). exp = date d'expiration (s depuis boot). */
typedef struct { char tok[UI_TOKEN_LEN + 1]; int64_t exp; } uisess_t;
static uisess_t s_sess[UI_SESS_MAX];

static void ui_auth_reload(void) {
    nvs_handle_t h;
    s_ui_pass[0] = 0;
    if (nvs_open("cfg", NVS_READONLY, &h) == ESP_OK) {
        size_t sz = sizeof(s_ui_pass);
        if (nvs_get_str(h, "ui_pass", s_ui_pass, &sz) != ESP_OK) s_ui_pass[0] = 0;
        nvs_close(h);
    }
}

/* Comparaison a TEMPS CONSTANT : un strcmp sort au 1er caractere different et
 * laisse fuir la longueur du prefixe correct, ce qui permet de reconstruire le
 * secret caractere par caractere. On compare toujours tout le buffer. Utilise
 * pour le mot de passe ET pour les jetons de session. */
static bool ui_secret_equal(const char *a, const char *b) {
    size_t la = strlen(a), lb = strlen(b);
    unsigned char diff = (unsigned char)(la ^ lb);
    for (size_t i = 0; i < la; i++) diff |= (unsigned char)(a[i] ^ b[i < lb ? i : (lb ? lb - 1 : 0)]);
    return diff == 0;
}

static int64_t ui_now_s(void) { return esp_timer_get_time() / 1000000; }

/* Cree une session et ecrit son jeton dans out (UI_TOKEN_LEN+1 octets).
 * Jeton tire d'esp_random() (RNG materiel). Si la table est pleine, recycle
 * l'entree la plus proche de l'expiration. */
static void ui_sess_create(char *out) {
    uint32_t r[UI_TOKEN_LEN / 8];
    for (size_t i = 0; i < sizeof(r) / sizeof(r[0]); i++) r[i] = esp_random();
    for (size_t i = 0; i < sizeof(r) / sizeof(r[0]); i++)
        snprintf(out + i * 8, 9, "%08" PRIx32, r[i]);
    out[UI_TOKEN_LEN] = 0;

    int slot = 0; int64_t oldest = INT64_MAX; int64_t now = ui_now_s();
    for (int i = 0; i < UI_SESS_MAX; i++) {
        if (!s_sess[i].tok[0] || s_sess[i].exp <= now) { slot = i; break; }   /* libre/expire */
        if (s_sess[i].exp < oldest) { oldest = s_sess[i].exp; slot = i; }
    }
    strlcpy(s_sess[slot].tok, out, sizeof(s_sess[slot].tok));
    s_sess[slot].exp = now + UI_SESS_TTL_S;
}

static void ui_sess_drop(const char *tok) {
    for (int i = 0; i < UI_SESS_MAX; i++)
        if (s_sess[i].tok[0] && ui_secret_equal(s_sess[i].tok, tok)) { memset(&s_sess[i], 0, sizeof(s_sess[i])); return; }
}
static void ui_sess_drop_all(void) { memset(s_sess, 0, sizeof(s_sess)); }

static bool ui_sess_valid(const char *tok) {
    int64_t now = ui_now_s();
    for (int i = 0; i < UI_SESS_MAX; i++)
        if (s_sess[i].tok[0] && s_sess[i].exp > now && ui_secret_equal(s_sess[i].tok, tok)) return true;
    return false;
}

/* Extrait la valeur du cookie de session de la requete. false si absent. */
static bool ui_cookie_get(httpd_req_t *r, char *out, size_t cap) {
    char c[256];
    size_t n = sizeof(c);
    if (httpd_req_get_cookie_val(r, "opfx_sess", c, &n) != ESP_OK) return false;
    strlcpy(out, c, cap);
    return true;
}

/* true si la requete est autorisee. Repond 401 (JSON) sinon, SANS en-tete
 * WWW-Authenticate : c'est precisement lui qui declencherait la popup native
 * du navigateur. L'UI intercepte le 401 et affiche sa propre page de login. */
static bool ui_auth_ok(httpd_req_t *r) {
    if (!s_ui_pass[0]) return true;   /* pas de mot de passe defini -> UI ouverte */

    char tok[UI_TOKEN_LEN + 1] = "";
    if (ui_cookie_get(r, tok, sizeof(tok)) && ui_sess_valid(tok)) return true;

    httpd_resp_set_status(r, "401 Unauthorized");
    httpd_resp_set_type(r, "application/json");
    httpd_resp_sendstr(r, "{\"ok\":0,\"err\":\"auth\"}");
    return false;
}

/* Valeur d'un en-tete, NULL s'il est absent (tronquee si trop longue : elle reste presente). */
static const char *hdr_or_null(httpd_req_t *r, const char *name, char *buf, size_t cap) {
    esp_err_t e = httpd_req_get_hdr_value_str(r, name, buf, cap);
    return (e == ESP_OK || e == ESP_ERR_HTTPD_RESULT_TRUNC) ? buf : NULL;
}

/* true si l'envoi est accepte. Un POST lance depuis la page d'un AUTRE site (CSRF : sans mot de
 * passe, une page piegee pouvait piloter le boitier) recoit 403 ; l'interface, une iframe dans Home
 * Assistant, Home Assistant en REST et les scripts passent comme avant. Regles : req_guard.h. */
static bool req_guard_ok(httpd_req_t *r) {
    if (r->method != HTTP_POST) return true;   /* une autre page ne peut pas lire les reponses */
    char sfs[24], origin[96], host[96];
    const char *f = hdr_or_null(r, "Sec-Fetch-Site", sfs, sizeof(sfs));
    const char *o = hdr_or_null(r, "Origin", origin, sizeof(origin));
    const char *h = hdr_or_null(r, "Host", host, sizeof(host));
    if (rg_write_ok(f, o, h)) return true;
    ESP_LOGW(TAG, "envoi refuse (autre site) : %s, Sec-Fetch-Site=%s Origin=%s Host=%s",
             r->uri, f ? f : "-", o ? o : "-", h ? h : "-");
    httpd_resp_set_status(r, "403 Forbidden");
    httpd_resp_set_type(r, "application/json");
    httpd_resp_sendstr(r, "{\"ok\":0,\"err\":\"origine\"}");
    return false;
}

/* Fichiers UI embarques COMPRESSES (tools/gzip_web.py, voir EMBED_FILES du CMakeLists). */
extern const uint8_t index_html_start[] asm("_binary_index_html_gz_start");
extern const uint8_t index_html_end[]   asm("_binary_index_html_gz_end");
extern const uint8_t style_css_start[]  asm("_binary_style_css_gz_start");
extern const uint8_t style_css_end[]    asm("_binary_style_css_gz_end");
extern const uint8_t app_js_start[]     asm("_binary_app_js_gz_start");
extern const uint8_t app_js_end[]       asm("_binary_app_js_gz_end");
extern const uint8_t app_capture_js_start[] asm("_binary_app_capture_js_gz_start");   /* UI capture brute (issue #95) */
extern const uint8_t app_capture_js_end[]   asm("_binary_app_capture_js_gz_end");
extern const uint8_t pyramid_detect_js_start[] asm("_binary_pyramid_detect_js_gz_start");   /* detection de profil (pyramide, #111) */
extern const uint8_t pyramid_detect_js_end[]   asm("_binary_pyramid_detect_js_gz_end");
/* Ecran d'accueil du telephone : manifeste (compresse) et icone (PNG, deja compressee). */
extern const uint8_t manifest_start[]   asm("_binary_manifest_webmanifest_gz_start");
extern const uint8_t manifest_end[]     asm("_binary_manifest_webmanifest_gz_end");
extern const uint8_t profiles_json_start[] asm("_binary_profiles_json_gz_start");   /* table de profils de l'ecran "Ajouter un appareil" */
extern const uint8_t profiles_json_end[]   asm("_binary_profiles_json_gz_end");
extern const uint8_t icon_png_start[]   asm("_binary_icon_192_png_start");
extern const uint8_t icon_png_end[]     asm("_binary_icon_192_png_end");

/* ── Etat apprentissage ── */
static char           s_lbits[SH_BITS_LEN];
static uint32_t       s_lserial;
static uint8_t        s_lbtn;
static int8_t         s_lrssi;
static volatile bool  s_lready;
static volatile bool  s_lactive;

/* ── Capture télécommande pour enrôlement PFX (appui télécommande -> serial -> identité) ── */
static volatile bool     s_pcap_active, s_pcap_done;
static volatile int      s_pcap_rc, s_pcap_new, s_pcap_model;
static volatile uint32_t s_pcap_remote;

static uint32_t bits_lsb(const char *b, int from, int len) {
    uint32_t v = 0;
    for (int i = 0; i < len; i++) if (b[from + i] == '1') v |= (1u << i);
    return v;
}

static int req_radio_idx(httpd_req_t *r);   /* ?radio=N (defini plus bas) */
static int s_learn_radio = 0;               /* radio ciblee par /api/learn/start (issue #95) */
static uint32_t s_learn_freq = 0;           /* frequence d'ecoute (0 = porteuse de la radio) : capture a la freq du profil de marque */

static void learn_task(void *arg) {
    (void)arg;
    char bits[SH_BITS_LEN];
    /* Ecoute dediee 15 s : on garde la PREMIERE trame confirmee, quel que soit le bouton.
     * C'est l'action choisie dans l'UI + le bouton physique presse qui determinent la
     * commande. Filtrer par valeur de bouton etait une erreur (codes reels differents de
     * ce qu'on supposait) : ca empechait d'apprendre stop et descente.
     * Confirmee par une 2e trame identique et complete (66 bits) : une trame isolee a bits
     * faux donnait un volet au serial ou a la commande corrompus (issue #39). */
    int n = radio_listen_confirmed_on_freq(s_learn_radio, s_learn_freq, 15000, bits, SH_BITS_LEN, true);
    if (n >= 66) {
        s_lrssi   = cc1101_get_rssi();
        strlcpy(s_lbits, bits, SH_BITS_LEN);
        s_lserial = bits_lsb(bits, 32, 28);
        s_lbtn    = (uint8_t)bits_lsb(bits, 60, 4);
        s_lready  = true;
        /* fait aussi apparaitre la trame captee dans le journal RF debug */
        shutters_on_rx(bits, s_lserial, s_lbtn, s_lrssi, bits_lsb(bits, 0, 32));
    }
    s_lactive = false;
    vTaskDelete(NULL);
}

/* ── Helpers HTTP ── */
/* Interface embarquee en gzip, envoyee telle quelle : le navigateur decompresse. ETag =
 * empreinte du firmware (app_elf_sha256) : tant qu'il ne change pas, la revalidation
 * (no-cache) recoit un 304 sans corps au lieu de toute l'interface ; apres une OTA,
 * l'empreinte change et la nouvelle interface arrive. */
static esp_err_t send_asset(httpd_req_t *r, const char *type, const uint8_t *s, const uint8_t *e, bool gz) {
    char etag[19], inm[24];
    const uint8_t *h = esp_app_get_description()->app_elf_sha256;
    etag[0] = '"';
    for (int i = 0; i < 8; i++) snprintf(etag + 1 + 2 * i, 3, "%02x", h[i]);
    etag[17] = '"'; etag[18] = 0;
    httpd_resp_set_hdr(r, "Cache-Control", "no-cache");   /* toujours revalider : pas d'UI perimee apres MAJ */
    httpd_resp_set_hdr(r, "ETag", etag);
    if (httpd_req_get_hdr_value_str(r, "If-None-Match", inm, sizeof(inm)) == ESP_OK && !strcmp(inm, etag)) {
        httpd_resp_set_status(r, "304 Not Modified");
        return httpd_resp_send(r, NULL, 0);
    }
    httpd_resp_set_type(r, type);
    if (gz) httpd_resp_set_hdr(r, "Content-Encoding", "gzip");
    return httpd_resp_send(r, (const char *)s, e - s);
}
static char *read_body_max(httpd_req_t *r, int max) {
    int len = r->content_len;
    if (len <= 0 || len > max) return NULL;
    char *buf = malloc(len + 1);
    if (!buf) return NULL;
    int got = 0;
    while (got < len) {
        int k = httpd_req_recv(r, buf + got, len - got);
        if (k <= 0) { free(buf); return NULL; }
        got += k;
    }
    buf[len] = 0;
    return buf;
}
static char *read_body(httpd_req_t *r) { return read_body_max(r, 8192); }
static const char *jstr(cJSON *o, const char *k) {
    cJSON *i = cJSON_GetObjectItem(o, k);
    return cJSON_IsString(i) ? i->valuestring : NULL;
}

/* ── Handlers statiques ── */
static esp_err_t h_index(httpd_req_t *r) { return send_asset(r, "text/html",       index_html_start, index_html_end, true); }
static esp_err_t h_css  (httpd_req_t *r) { return send_asset(r, "text/css",        style_css_start,  style_css_end,  true); }
static esp_err_t h_js   (httpd_req_t *r) { return send_asset(r, "application/javascript", app_js_start, app_js_end, true); }
static esp_err_t h_js_capture(httpd_req_t *r) { return send_asset(r, "application/javascript", app_capture_js_start, app_capture_js_end, true); }
static esp_err_t h_js_detect(httpd_req_t *r) { return send_asset(r, "application/javascript", pyramid_detect_js_start, pyramid_detect_js_end, true); }
static esp_err_t h_manifest(httpd_req_t *r) { return send_asset(r, "application/manifest+json", manifest_start, manifest_end, true); }
static esp_err_t h_profiles(httpd_req_t *r) { return send_asset(r, "application/json", profiles_json_start, profiles_json_end, true); }
static esp_err_t h_icon (httpd_req_t *r) { return send_asset(r, "image/png",       icon_png_start,   icon_png_end,   false); }

/* ── /api/status ── */
static esp_err_t h_status(httpd_req_t *r) {
    char *js = shutters_status_json();
    if (!js) return httpd_resp_send_err(r, HTTPD_500_INTERNAL_SERVER_ERROR, "mem");
    httpd_resp_set_type(r, "application/json");
    esp_err_t e = httpd_resp_send(r, js, HTTPD_RESP_USE_STRLEN);
    free(js);
    return e;
}

/* ── /api/shutter ── */
static esp_err_t h_shutter(httpd_req_t *r) {
    char *body = read_body(r); if (!body) return httpd_resp_send_err(r, HTTPD_400_BAD_REQUEST, "body");
    cJSON *j = cJSON_Parse(body); free(body);
    if (!j) return httpd_resp_send_err(r, HTTPD_400_BAD_REQUEST, "json");
    const char *id = jstr(j, "id"), *cmd = jstr(j, "cmd");
    cJSON *val = cJSON_GetObjectItem(j, "value");
    int rc = (id && cmd) ? shutters_cmd_synced(id, cmd, val ? (int)val->valuedouble : 0) : -1;
    cJSON_Delete(j);
    char resp[56];
    snprintf(resp, sizeof(resp), "{\"ok\":%d,\"busy\":%d,\"tx_marc\":%d}", rc == 0 ? 1 : 0, rc == SH_CMD_BUSY ? 1 : 0, g_tx_marc);
    httpd_resp_sendstr(r, resp);
    return ESP_OK;
}

/* ── /api/volet/delete : supprime un volet (permet de reapprendre proprement) ── */
static esp_err_t h_volet_delete(httpd_req_t *r) {
    char *body = read_body(r); if (!body) return httpd_resp_send_err(r, HTTPD_400_BAD_REQUEST, "body");
    cJSON *j = cJSON_Parse(body); free(body);
    if (!j) return httpd_resp_send_err(r, HTTPD_400_BAD_REQUEST, "json");
    int rc = shutters_delete_volet(jstr(j, "id"));
    cJSON_Delete(j);
    httpd_resp_sendstr(r, rc == 0 ? "{\"ok\":1}" : "{\"ok\":0}");
    return ESP_OK;
}

/* ── /api/volet/rename : {"id":"ancien","name":"nouveau"} -> change l'id + met a jour les references.
 * -4 = nom deja pris (on le signale pour un message clair cote UI). ── */
static esp_err_t h_volet_rename(httpd_req_t *r) {
    char *body = read_body(r); if (!body) return httpd_resp_send_err(r, HTTPD_400_BAD_REQUEST, "body");
    cJSON *j = cJSON_Parse(body); free(body);
    if (!j) return httpd_resp_send_err(r, HTTPD_400_BAD_REQUEST, "json");
    int rc = shutters_rename_volet(jstr(j, "id"), jstr(j, "name"));
    cJSON_Delete(j);
    if (rc == -4) { httpd_resp_sendstr(r, "{\"ok\":0,\"err\":\"exists\"}"); return ESP_OK; }
    httpd_resp_sendstr(r, rc == 0 ? "{\"ok\":1}" : "{\"ok\":0}");
    return ESP_OK;
}

/* ── /api/volet/type : {"id":"...","type":N} -> corrige le dev_type d'un appareil existant.
 * Repare un type mal attribue (volet/portail) sans reenroler : identite, compteur, captures conserves. */
static esp_err_t h_volet_type(httpd_req_t *r) {
    char *body = read_body(r); if (!body) return httpd_resp_send_err(r, HTTPD_400_BAD_REQUEST, "body");
    cJSON *j = cJSON_Parse(body); free(body);
    if (!j) return httpd_resp_send_err(r, HTTPD_400_BAD_REQUEST, "json");
    cJSON *ty = cJSON_GetObjectItem(j, "type");
    int rc = shutters_set_type(jstr(j, "id"), ty ? (uint8_t)cJSON_GetNumberValue(ty) : 0);
    cJSON_Delete(j);
    httpd_resp_sendstr(r, rc == 0 ? "{\"ok\":1}" : "{\"ok\":0}");
    return ESP_OK;
}

/* ── /api/learn/start + /poll ── */
static esp_err_t h_learn_start(httpd_req_t *r) {
    char *body = read_body(r); if (body) free(body);   /* le corps {action} n'est plus utilise cote firmware */
    if (!s_lactive) {
        s_learn_radio = req_radio_idx(r);
        s_learn_freq = 0;   /* ?freq_khz=N : ecouter a la frequence de l'appareil/profil (Eveno 868330 vs Profalux 868425) */
        char q[96], v[12];
        if (httpd_req_get_url_query_str(r, q, sizeof q) == ESP_OK &&
            httpd_query_key_value(q, "freq_khz", v, sizeof v) == ESP_OK)
            s_learn_freq = (uint32_t)strtoul(v, NULL, 10);
        s_lready = false; s_lactive = true;
        xTaskCreate(learn_task, "learn", 4096, NULL, 6, NULL);
    }
    httpd_resp_sendstr(r, "{\"ok\":1}");
    return ESP_OK;
}
static esp_err_t h_learn_poll(httpd_req_t *r) {
    httpd_resp_set_type(r, "application/json");
    if (!s_lready) { httpd_resp_sendstr(r, "{}"); return ESP_OK; }
    char out[SH_BITS_LEN + 96];
    snprintf(out, sizeof(out), "{\"bits\":\"%s\",\"serial\":\"0x%07X\",\"button\":\"%X\",\"rssi\":%d}",
             s_lbits, (unsigned)s_lserial, s_lbtn, s_lrssi);
    httpd_resp_sendstr(r, out);
    return ESP_OK;
}
static esp_err_t h_learn_assign(httpd_req_t *r) {
    char *body = read_body(r); if (!body) return httpd_resp_send_err(r, HTTPD_400_BAD_REQUEST, "body");
    cJSON *j = cJSON_Parse(body); free(body);
    if (!j) return httpd_resp_send_err(r, HTTPD_400_BAD_REQUEST, "json");
    int rc = shutters_learn_assign(jstr(j, "id"), jstr(j, "action"), jstr(j, "bits"));
    cJSON_Delete(j); s_lready = false;
    httpd_resp_sendstr(r, rc == 0 ? "{\"ok\":1}" : "{\"ok\":0}");
    return ESP_OK;
}
static esp_err_t h_learn_reassign(httpd_req_t *r) {
    char *body = read_body(r); if (!body) return httpd_resp_send_err(r, HTTPD_400_BAD_REQUEST, "body");
    cJSON *j = cJSON_Parse(body); free(body);
    if (!j) return httpd_resp_send_err(r, HTTPD_400_BAD_REQUEST, "json");
    int rc = shutters_reassign(jstr(j, "id"), jstr(j, "from"), jstr(j, "to"));
    cJSON_Delete(j);
    httpd_resp_sendstr(r, rc == 0 ? "{\"ok\":1}" : "{\"ok\":0}");
    return ESP_OK;
}
static esp_err_t h_learn_adopt(httpd_req_t *r) {
    char *body = read_body(r); if (!body) return httpd_resp_send_err(r, HTTPD_400_BAD_REQUEST, "body");
    cJSON *j = cJSON_Parse(body); free(body);
    if (!j) return httpd_resp_send_err(r, HTTPD_400_BAD_REQUEST, "json");
    const char *hs = jstr(j, "hop");
    uint32_t hop = hs ? (uint32_t)strtoul(hs, NULL, 16) : 0;
    int rc = shutters_adopt(jstr(j, "id"), jstr(j, "action"), jstr(j, "serial"), hop);
    cJSON_Delete(j);
    httpd_resp_sendstr(r, rc == 0 ? "{\"ok\":1}" : "{\"ok\":0}");
    return ESP_OK;
}

static esp_err_t h_rf_replay(httpd_req_t *r) {
    char *body = read_body(r); if (!body) return httpd_resp_send_err(r, HTTPD_400_BAD_REQUEST, "body");
    cJSON *j = cJSON_Parse(body); free(body);
    if (!j) return httpd_resp_send_err(r, HTTPD_400_BAD_REQUEST, "json");
    const char *hs = jstr(j, "hop");
    uint32_t hop = hs ? (uint32_t)strtoul(hs, NULL, 16) : 0;
    int rc = shutters_replay_frame(jstr(j, "serial"), hop);
    cJSON_Delete(j);
    httpd_resp_sendstr(r, rc == 0 ? "{\"ok\":1}" : "{\"ok\":0}");
    return ESP_OK;
}

/* ── /api/calibrate + /api/remote ── */
static esp_err_t h_calibrate(httpd_req_t *r) {
    char *body = read_body(r); if (!body) return httpd_resp_send_err(r, HTTPD_400_BAD_REQUEST, "body");
    cJSON *j = cJSON_Parse(body); free(body);
    if (!j) return httpd_resp_send_err(r, HTTPD_400_BAD_REQUEST, "json");
    int rc = shutters_calibrate(jstr(j, "id"),
        (uint32_t)cJSON_GetNumberValue(cJSON_GetObjectItem(j, "travel_up_ms")),
        (uint32_t)cJSON_GetNumberValue(cJSON_GetObjectItem(j, "travel_down_ms")));
    cJSON_Delete(j);
    httpd_resp_sendstr(r, rc == 0 ? "{\"ok\":1}" : "{\"ok\":0}");
    return ESP_OK;
}
static esp_err_t h_orientation(httpd_req_t *r) {
    char *body = read_body(r); if (!body) return httpd_resp_send_err(r, HTTPD_400_BAD_REQUEST, "body");
    cJSON *j = cJSON_Parse(body); free(body);
    if (!j) return httpd_resp_send_err(r, HTTPD_400_BAD_REQUEST, "json");
    cJSON *ori = cJSON_GetObjectItem(j, "orientation");
    int rc = shutters_set_orientation(jstr(j, "id"), ori ? (int)cJSON_GetNumberValue(ori) : -1);
    cJSON_Delete(j);
    httpd_resp_sendstr(r, rc == 0 ? "{\"ok\":1}" : "{\"ok\":0}");
    return ESP_OK;
}
/* /api/volet/txparams : edition PAR APPAREIL de la porteuse, du TE, du bit de repetition et du RMT
 * (etage 2, issue #111 ; panneau avance). freq_khz/te_us a 0 = heriter du defaut ; tx_rpt/tx_rmt =
 * tri-etat (0 heriter, 1 off, 2 on). Chaque appareil garde SES valeurs : en regler un ne touche aucun
 * autre, meme sur la meme radio (c'est le correctif du bug "ajouter de l'Eveno casse le Profalux"). */
static esp_err_t h_volet_txparams(httpd_req_t *r) {
    char *body = read_body(r); if (!body) return httpd_resp_send_err(r, HTTPD_400_BAD_REQUEST, "body");
    cJSON *j = cJSON_Parse(body); free(body);
    if (!j) return httpd_resp_send_err(r, HTTPD_400_BAD_REQUEST, "json");
    cJSON *fk = cJSON_GetObjectItem(j, "freq_khz");
    cJSON *tu = cJSON_GetObjectItem(j, "te_us");
    cJSON *xp = cJSON_GetObjectItem(j, "tx_rpt");
    cJSON *xm = cJSON_GetObjectItem(j, "tx_rmt");
    cJSON *fb = cJSON_GetObjectItem(j, "frame_bits");
    int rc = shutters_set_tx_params(jstr(j, "id"),
        cJSON_IsNumber(fk) ? (uint32_t)fk->valuedouble : 0,
        cJSON_IsNumber(tu) ? (uint32_t)tu->valuedouble : 0,
        cJSON_IsNumber(xp) ? (int)xp->valuedouble : -1,
        cJSON_IsNumber(xm) ? (int)xm->valuedouble : -1,
        cJSON_IsNumber(fb) ? (int)fb->valuedouble : 0,
        jstr(j, "marque"));
    cJSON_Delete(j);
    httpd_resp_sendstr(r, rc == 0 ? "{\"ok\":1}" : "{\"ok\":0}");
    return ESP_OK;
}
/* /api/volet/order : {"ids":["id1","id2",...]} dans l'ordre d'affichage voulu.
 * Purement cosmetique : ne touche ni la radio, ni le pilotage, ni les topics HA. */
static esp_err_t h_volet_order(httpd_req_t *r) {
    char *body = read_body(r); if (!body) return httpd_resp_send_err(r, HTTPD_400_BAD_REQUEST, "body");
    cJSON *j = cJSON_Parse(body); free(body);
    if (!j) return httpd_resp_send_err(r, HTTPD_400_BAD_REQUEST, "json");
    /* Tous les volets : un tampon de 384 octets (l'ancien SH_MEMBERS_LEN)
     * tronquait la liste en silence au-dela, et les volets coupes repassaient
     * a order = -1 (renvoyes en fin d'affichage). */
    char csv[SH_MAX_VOLETS * SH_ID_LEN + 1] = ""; int p = 0;
    cJSON *ids = cJSON_GetObjectItem(j, "ids"), *it;
    if (cJSON_IsArray(ids)) cJSON_ArrayForEach(it, ids) {
        const char *s = cJSON_GetStringValue(it);
        if (s && *s && p < (int)sizeof(csv) - 1)
            p += snprintf(csv + p, sizeof(csv) - p, "%s%s", p ? "," : "", s);
    }
    int rc = shutters_set_order(csv);
    cJSON_Delete(j);
    httpd_resp_set_type(r, "application/json");
    return httpd_resp_sendstr(r, rc == 0 ? "{\"ok\":1}" : "{\"ok\":0}");
}

static esp_err_t h_remote(httpd_req_t *r) {
    char *body = read_body(r); if (!body) return httpd_resp_send_err(r, HTTPD_400_BAD_REQUEST, "body");
    cJSON *j = cJSON_Parse(body); free(body);
    if (!j) return httpd_resp_send_err(r, HTTPD_400_BAD_REQUEST, "json");
    int rc = shutters_remote_name(jstr(j, "serial"), jstr(j, "name") ?: "");
    cJSON_Delete(j);
    httpd_resp_sendstr(r, rc == 0 ? "{\"ok\":1}" : "{\"ok\":0,\"err\":\"liste des telecommandes pleine\"}");
    return ESP_OK;
}
/* ── /api/remote/ignore et /api/remote/unignore : {"serial":"0x..."} ── */
static esp_err_t h_remote_ignore(httpd_req_t *r) {
    char *body = read_body(r); if (!body) return httpd_resp_send_err(r, HTTPD_400_BAD_REQUEST, "body");
    cJSON *j = cJSON_Parse(body); free(body);
    if (!j) return httpd_resp_send_err(r, HTTPD_400_BAD_REQUEST, "json");
    const char *why = NULL;
    int rc = shutters_ignore_remote(jstr(j, "serial"), &why);
    cJSON_Delete(j);
    if (rc != 0) return httpd_resp_send_err(r, HTTPD_400_BAD_REQUEST, why ? why : "refus");
    httpd_resp_sendstr(r, "{\"ok\":1}");
    return ESP_OK;
}
static esp_err_t h_remote_unignore(httpd_req_t *r) {
    char *body = read_body(r); if (!body) return httpd_resp_send_err(r, HTTPD_400_BAD_REQUEST, "body");
    cJSON *j = cJSON_Parse(body); free(body);
    if (!j) return httpd_resp_send_err(r, HTTPD_400_BAD_REQUEST, "json");
    int rc = shutters_unignore_remote(jstr(j, "serial"));
    cJSON_Delete(j);
    httpd_resp_sendstr(r, rc == 0 ? "{\"ok\":1}" : "{\"ok\":0}");
    return ESP_OK;
}
/* ── /api/remote/create_volet : {"serial":"0x...","name":"..."} -> {"ok":1,"learned":"up,stop,down"} ── */
static esp_err_t h_remote_create_volet(httpd_req_t *r) {
    char *body = read_body(r); if (!body) return httpd_resp_send_err(r, HTTPD_400_BAD_REQUEST, "body");
    cJSON *j = cJSON_Parse(body); free(body);
    if (!j) return httpd_resp_send_err(r, HTTPD_400_BAD_REQUEST, "json");
    char learned[24]; const char *why = NULL;
    int rc = shutters_create_volet_from_remote(jstr(j, "name"), jstr(j, "serial"), learned, sizeof(learned), &why);
    cJSON_Delete(j);
    if (rc != 0) return httpd_resp_send_err(r, HTTPD_400_BAD_REQUEST, why ? why : "refus");
    char out[64]; snprintf(out, sizeof(out), "{\"ok\":1,\"learned\":\"%s\"}", learned);
    httpd_resp_set_type(r, "application/json");
    httpd_resp_sendstr(r, out);
    return ESP_OK;
}
/* ── /api/remote/delete : {"serial":"0x..."} ; refuse (400 + raison) si un volet s'en sert ── */
static esp_err_t h_remote_delete(httpd_req_t *r) {
    char *body = read_body(r); if (!body) return httpd_resp_send_err(r, HTTPD_400_BAD_REQUEST, "body");
    cJSON *j = cJSON_Parse(body); free(body);
    if (!j) return httpd_resp_send_err(r, HTTPD_400_BAD_REQUEST, "json");
    const char *why = NULL;
    int rc = shutters_delete_remote(jstr(j, "serial"), &why);
    cJSON_Delete(j);
    if (rc != 0) return httpd_resp_send_err(r, HTTPD_400_BAD_REQUEST, why ? why : "refus");
    httpd_resp_sendstr(r, "{\"ok\":1}");
    return ESP_OK;
}

/* ── /api/config : Wi-Fi + MQTT + nom (namespace NVS "cfg", lu par main.c) ── */
static void cfg_get(nvs_handle_t h, const char *k, char *out, size_t cap) {
    size_t sz = cap; out[0] = 0; nvs_get_str(h, k, out, &sz);
}
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
