Isno-Open/OpenProfalux/(commit log)

2026-08-13 sim: harness de verification KEELOQ (cipher + codec + ancre production)
    Certifie sans materiel que keeloq.c et profalux.c sont corrects :
    - cipher keeloq_encrypt/decrypt == KEELOQ Microchip standard (1000/1000)
    - round-trip pfx_frame_build/parse/decrypt (4/4)
    - ancre optionnelle byte-exact contre l'encodeur de production cherubini
    (16/16 si binaire tiers + unicorn dispo, sinon skip propre)
    Aucun binaire ni cle tiers committe. Runnable avec python3 seul.
2026-08-24 fix: reproduce Devmel PFX enrollment frames
    [hardware_config.h, main.c, profalux.c, profalux.h]
2026-08-24 fix: reproduce Gw PFX enrollment frames
    [hardware_config.h, main.c, profalux.c, profalux.h]
2026-08-24 fix: keep Devmel settings phase RF-silent
    [hardware_config.h, main.c, profalux.c, profalux.h]
2026-08-24 fix: keep Gw settings phase RF-silent
    [hardware_config.h, main.c, profalux.c, profalux.h]
2026-10-05 cc1101 RX : capture Profalux fiable sur ISNO Super (S3), en_partial_rx + vote majoritaire + AGC OOK
    La capture OOK KeeLoq etait hachee/tronquee sur ISNO Super (ESP32-S3) alors
    qu'elle marchait sur M5Stack ATOM : cause 100% logicielle (chaine RMT du S3 +
    reglage AGC), pas la radio (2x CC1101 OK, cf OpenHardware#1).
    - en_partial_rx : le driver remplit un buffer contigu sur plusieurs callbacks
    d'une meme reception, on ne re-arme plus entre fragments (plus de milieu perdu).
    Le S3 n'a que 48 mots/canal -> ping-pong bogue (esp-idf #13419) sans ca.
    - buffer RX en RAM interne DMA-capable aligne 64 o (heap_caps_aligned_alloc) :
    sans ca le GDMA du S3 corrompt la capture (glitches ~55 us).
    - sig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
    [cc1101.c]
2026-10-06 mqtts : durcir le TLS et l'UI des certificats (revue codex sur #11)
    - CN : ne lever skip_cert_common_name_check que pour un broker en IP AVEC un CA prive
    fourni. Avec le bundle public le controle reste actif, sinon tout certificat public
    usurperait un broker joint par IP. (P1)
    - Config POST : limite de corps dediee (16 Ko) au lieu de 8 Ko, les 3 certificats
    tenaient a l'etroit ; l'UI remonte desormais l'echec au lieu d'afficher "enregistre". (P2)
    - UI : une case "effacer" par certificat envoie une chaine vide (suppression en NVS),
    on peut enfin revenir au bundle public et couper le mTLS depuis l'interface. (P2)
    - Commentaires "SPIFFS" perimes corriges : les certificats vivent en NVS.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
2026-10-06 test : banc hote pour la decision TLS skip_cn (revue codex P1)
    host_is_ipv4 et la decision de lever le controle du nom (CN) extraites de mqtt_bridge.c
    dans une unite pure mqtt_tls_policy.c, testable sans esp-mqtt (patron du banc KeeLoq).
    Le banc firmware/test/mqtt-tls verifie la table de verite : CN leve uniquement pour un
    broker joint par IP AVEC un CA prive. Mutation verifiee : retirer "&& has_ca" fait echouer
    le cas "IP + bundle". Nouveau job CI banc-mqtt-tls.
2026-10-07 OTA : un envoi interrompu ne bloque plus l'interface web
    Pendant une mise a jour envoyee par l'interface (/api/ota/upload), un delai de
    reception depasse etait ignore sans limite. Si l'appareil qui envoie disparait
    sans fermer la connexion (portable en veille, telephone qui verrouille son
    ecran ou sort de la portee du Wi-Fi), la boucle ne finissait jamais : l'unique
    tache du serveur web restait bloquee, l'interface ne repondait plus a personne
    jusqu'a une coupure de courant, et l'etat OTA restait "receiving". MQTT et
    Home Assistant continuaient, le chien de garde Wi-Fi ne voyait rien.
    - 15 s sans un octet (3 delais de reception de 5 s) : la mise a jour est
    abandonnee (partition active non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
2026-10-07 volets : effacer l'entite Home Assistant a la suppression
    shutters_delete_volet publie un payload retenu vide sur le topic de
    decouverte du cover (HA retire alors l'entite) + ses topics d'etat et de
    position, avant de retirer le volet du modele. Sans ca, un volet supprime
    restait affiche dans Home Assistant : le discovery retenu survivait.
2026-10-07 UI : suppression et suivi de position accessibles sur un volet enrole
    Un volet enrole (telecommande virtuelle) sortait en retour anticipe de
    renderLearnSlots : ni le bouton Supprimer ni la capture n'etaient atteints.
    On ne pouvait donc pas supprimer un volet enrole mal memorise.
    Desormais, pour un volet enrole : le bouton Supprimer est accessible, et on
    peut apprendre sa VRAIE telecommande d'origine, uniquement pour suivre la
    position (le pilotage reste par generation, ces trames ne sont pas rejouees).
    Le backend convient deja : learn_assign enregistre serial + bouton, et
    start_move/do_stop d'un volet virtuel passent toujours par la generation.
2026-10-07 doc : portee radio requise pendant l'apprentissage et l'enrolement
    La capture d'une telecommande et l'enrolement d'un volet passent par la
    radio : la telecommande d'origine doit etre a portee du boitier a ce
    moment-la. Une fois le volet memorise, le pilotage se fait a distance.
2026-10-09 Wi-Fi : le boitier revient tout seul apres une coupure (#22)
    Au demarrage, le Wi-Fi client etait essaye 30 s, puis le boitier passait en
    point d'acces de configuration SEUL (WIFI_MODE_AP) : le client etait eteint et
    plus jamais relance, le chien de garde n'etant arme qu'apres une premiere
    connexion. Deux cas courants y menaient :
    - une coupure de courant generale : l'ATOM redemarre en 2 s, la box en 1 a 3 min ;
    - une box injoignable plus de 5 min pendant le fonctionnement (mise a jour de la
    box, panne du fournisseur) : le chien de garde redemarre le boitier, qui ne la
    trouve toujours pas.
    Le boitier restait alors injoignable depuis Home Assistant jusqu'a un
    redemarrage manuel, avec un po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
2026-10-09 Ethernet filaire (LAN8720) pour une variante Olimex ESP32-POE
    Ajoute une variante de carte esp32-poe avec reseau filaire Ethernet en plus du
    Wi-Fi, demande de toat (issue #28). Le systeme de carte porte le brochage ; le
    code reseau est garde par BOARD_HAS_ETHERNET, donc les cartes existantes
    (isno-super, external, m5-atom-lite) sont inchangees.
    - boards/esp32-poe.json : variante POE, un CC1101 868 sur GPIO libres hors RMII,
    bloc ethernet (LAN8720, MDC 23 / MDIO 18 / alim PHY 12 / clk GPIO0). Brochage
    CC1101 et adresse PHY A CONFIRMER sur le module de toat.
    - tools/gen_board.py : lit le bloc ethernet, engendre BOARD_HAS_ETHERNET + ETH_*.
    - wifi_bridge.c/.h : init esp_eth (EMAC esp32 + PH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
    [gen_board.py, hardware_config.h, main.c, wifi_bridge.c, wifi_bridge.h]
2026-10-09 CI : ne requerir lan87xx que sur esp32 (le composant n'existe pas pour esp32s3)
2026-10-09 UI : etat du boitier (Systeme > Etat), sans cable USB (#29)
    Pour savoir ce qui se passait dans le boitier, il fallait jusqu'ici le cable USB :
    un firmware de diagnostic pour la memoire (elle manquait au point de casser le
    TLS, #17), une lecture de la NVS par esptool pour la place restante (elle limite
    le nombre de volets). Et la cause d'un redemarrage (plantage, chien de garde,
    alimentation trop faible) restait invisible.
    Nouvel onglet Systeme > Etat, rafraichi toutes les 5 s tant qu'il est ouvert :
    - allume depuis, et cause du dernier redemarrage (esp_reset_reason) ;
    - memoire libre, au plus bas depuis le demarrage, et plus gros bloc d'un seul
    tenant (ce qu'une connexion TLS peut obtenir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
2026-10-10 Carte d1-mini : D1 mini ESP32 + CC1101 (GDO0 sur IO26, SPI 1 MHz) (#30)
    Ajoute boards/d1-mini.json. GDO0 sur IO26 (IO4 non cable sur la carte de reference), SPI a 1 MHz (ecritures en rafale corrompues a 6 MHz, mesure).
2026-10-10 HTTP : les refus repondent 400, pas 500 (#33)
    httpd_resp_send_err attend l'enum httpd_err_code_t, ou HTTPD_500 vaut 0 : les 33 appels en 400 litteral sortaient en 500. 400 -> HTTPD_400_BAD_REQUEST, 500 -> HTTPD_500_INTERNAL_SERVER_ERROR.
2026-10-10 cc1101 : ecritures de registres verifiees, compteurs spi_retries/spi_fails (#32)
    Chaque ecriture de registre est relue et reessayee apres 1 ms, le PATABLE aussi. spi_retries/spi_fails exposes dans /api/diag, bandeau Diagnostic rouge si une ecriture n'est jamais prise.
    [cc1101.c, cc1101.h, web_ui.c]
2026-10-10 Profil radio : frequence par marque (Profalux, Eveno, personnalisee), reglable sans reboot (#31)
    Module pur radio_profile.c (profils profalux/eveno/custom, frequence controlee contre bands_allowed_khz de la carte), banc de test hote + job CI. Reglage NVS applique a chaud. Profalux reste le defaut. Voir issue #3.
    [cc1101.c, cc1101.h, hardware_config.h, main.c, radio.c, radio.h, radio_profile.c, radio_profile.h]
2026-10-11 Compatibilité : la porteuse Profalux varie selon la génération (868,350 à 868,425), essayer la fréquence personnalisée
2026-10-11 README : section Soutenir le projet (lien Sponsor) a la place des remerciements
2026-10-15 openprofalux: volet enrole, dissocier le 0x067 des vraies telecommandes + afficher l'identite virtuelle
    Repart de main, sans la re-application config ni la frequence par volet du build test1
    (l'un des deux cassait l'emission re-enrolee chez un testeur). On garde uniquement la
    correction d'association et on ajoute l'affichage de l'identite virtuelle.
    - create_virtual : l'identite d'emission 0x067 ne va plus dans serials (= l'ensemble des
    VRAIES telecommandes reconnues en reception). Elle reste dans virt_serial.
    - migration au boot : retire le 0x067 de serials des volets deja enroles.
    - garde-fou de capture relache pour les volets virtuels : on associe plusieurs vraies
    telecommandes (orig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
2026-10-15 main : version 0.2.11, pas de release 0.2.12 pour l'instant
    Le correctif d'association + identite virtuelle est fusionne, mais on ne publie pas encore
    la 0.2.12 : les loupes d'emission (RMT + bit Repeat, piste azriek, #37) ne sont pas encore
    traites. Le label -test2 ne vit que sur la pre-release de test, pas sur main.
2026-10-15 Verification de mise a jour : vraiment toutes les 6 h, desactivable, et a la demande
    Le delai de 6 h (vTaskDelay(pdMS_TO_TICKS(6UL * 3600UL * 1000UL))) debordait :
    dans l'IDF, pdMS_TO_TICKS calcule en 32 bits (projdefs.h) et 21 600 000 ms x
    1000 Hz depasse 2^32. Le delai retombait a ~125 s : une connexion TLS vers
    l'API GitHub toutes les ~2 min (releve : verifications a 819, 949, 1080,
    1210 s), au lieu de 4 par jour. Pendant chacune, une commande emise en
    bit-bang est souvent ignoree par le moteur (voir issue #37).
    - delai compte directement en ticks (6 x 3600 x configTICK_RATE_HZ)
    - option « Verification automatique » (NVS cfg/upd_auto, active par defaut) ;
    /api/config : update_auto en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
2026-10-15 Calage du TE : periode de bit / 3, et entete d'emission a 10 TE
    A l'apprentissage, le TE d'emission etait la moyenne des HAUT courts de la
    trame captee. La demodulation OOK du CC1101 etire les HAUT d'environ 16 us
    (et raccourcit d'autant les BAS) : le calage donnait 458 us pour une murale
    Eveno dont le TE reel est 448 us (periode de bit 1343 us au RTL-SDR).
    Le TE est maintenant la periode de bit moyenne (HAUT + BAS) / 3, ou le
    decalage se compense.
    L'entete d'emission valait 4450 x TE / 455, soit 9,78 TE : ~100 us trop
    court a TE 448. Il vaut maintenant 10 TE, comme la telecommande (datasheet
    HCS, ~4475 us mesures au SDR a TE 448).
    Banc keeloq : T5 (TE 448, HAUT etires de 16 us) attend TE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
2026-10-15 Restauration : refuser le mauvais fichier, et pouvoir revenir en arriere
    Restaurer un JSON valide qui n'est pas une sauvegarde de config remettait toute
    la config a zero : shutters_import_json appelait reset_state() avant d'importer,
    puis enregistrait. L'export des trames (openprofalux-trames.json, telecharge
    depuis la meme interface), un {} ou un [] effacaient ainsi tous les volets et
    telecommandes en NVS, sans retour possible.
    - Le fichier doit avoir le format d'une sauvegarde (cfg_model_is_backup : un
    objet, un tableau "volets", "remotes" absent ou objet, comme toutes les
    sauvegardes depuis la premiere version). Sinon : refus en 400, rien n'est
    touche, et l'interface dit pourquoi (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
2026-10-15 Firmware plus leger : interface compressee et mise en cache, compilation de production
    L'image ATOM approchait 90 % de la partition OTA (1 408 224 o). Trois gisements :
    - Interface web embarquee COMPRESSEE : tools/gzip_web.py (module gzip de Python,
    niveau 9, mtime=0 : meme fichier a chaque compilation, pas de gzip systeme
    requis) est appele par CMake a la configuration, comme gen_board.py ; EMBED_FILES
    pointe vers les .gz du dossier de construction, les sources web/ restent
    lisibles. send_asset envoie Content-Encoding: gzip. 112 Ko -> 35 Ko en flash, et
    une page complete pese 35 Ko au lieu de 114.
    - Mise en cache : ETag = debut de app_elf_sha256 (unique par compilation), 304 sans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
2026-10-15 Emission : option « comme la telecommande » (bit de repetition RPT, 18 ms entre trames)
    Releve au YARD Stick One sur des murales Eveno (HCS30x) : la premiere trame d'un appui
    porte le bit 65 (RPT) a 0, toutes les repetitions a 1, avec le meme code tournant, et
    ~18 ms de silence entre deux trames (docs/TRAMES-TELECOMMANDE.md). Le rejeu envoie 10
    trames identiques a 2 ms d'intervalle (RPT tel qu'enregistre, 0 pour une trame adoptee).
    Option desactivee par defaut, les moteurs testes acceptant les deux :
    - cc1101_tx_raw_bits : si active et trame >= 66 bits, RPT = 0 sur la 1re trame de la
    rafale, 1 ensuite ; silence de 18 ms (vTaskDelay, porteuse coupee) au lieu de 2 ms.
    Vaut aussi pour le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
2026-10-15 Emission par le RMT (timing materiel), en option
    Le bit-bang (esp_rom_delay_us + GPIO, sans section critique) peut etre
    preempte par le WiFi : un TE allonge casse la trame et le moteur l'ignore
    (hypothese de l'issue upstream #37). Avec l'option, chaque duree de la
    trame est tenue par le RMT, et le silence entre deux trames (2 ms, ou 18 ms
    avec le bit de repetition) devient un symbole, exact lui aussi.
    Memoire RMT : sur ESP32, la reception prend les 512 symboles (les 8 blocs).
    Elle est de toute facon coupee pendant une emission : on la libere, on cree
    un canal d'emission de SOC_RMT_MEM_WORDS_PER_CHANNEL symboles (l'encodeur
    copie le recharge au fil de l'eau), on emet, puis GDO0 est rendu au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
2026-10-15 Emission RMT : log de la duree mesuree de la rafale (et de la duree attendue)
2026-10-15 UI : l'interface ne se vide plus quand le boitier ne repond pas
    Pendant une mise a jour, un redemarrage ou une coupure Wi-Fi, loadStatus
    remplacait l'etat par une liste vide des que /api/status echouait : toutes les
    cartes de volets disparaissaient et l'onglet Wi-Fi annoncait "non connecte",
    sans rien dire du boitier. Et le rafraichissement de 3 s relancait une requete
    meme si la precedente n'etait pas finie : sans delai d'abandon, elles
    s'empilaient pendant la coupure puis repartaient toutes ensemble.
    - Une requete a la fois, abandonnee au bout de 4 s.
    - Un echec ne touche plus a l'affichage : apres 2 echecs de suite (~6 s, rien sur
    un rate isole), un bandeau sous l'en-tete dit "Boitier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
2026-10-16 UI : theme memorise, boutons libelles, mise a jour signalee, ecran d'accueil (#50)
    - Theme : le choix clair / sombre est garde (localStorage) et reapplique dans
    <head> avant la feuille de style, sans eclair du theme par defaut au
    chargement. Sans localStorage (navigation privee), rien ne casse.
    - Libelles : les boutons faits d'un seul symbole (monter, stop, descendre des volets et de
    l'enrolement, fleches de rangement, poubelle des centrales, rejeu, theme,
    deconnexion) ont un aria-label et une infobulle. Ceux des cartes de volets,
    regenerees toutes les 3 s, sont poses apres chaque rendu (MutationObserver).
    - Mise a jour : /api/ota/status donne deja la derniere release trouvee par l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
2026-10-16 Ethernet filaire pour Olimex ESP32-POE (issue #28) (#52)
    Ajoute une carte esp32-poe (LAN8720 via RMII) qui pilote le reseau filaire en
    plus du Wi-Fi. L'horloge RMII est generee par l'ESP32 et sortie sur GPIO0
    (variante WROVER, le PSRAM occupe 16/17) : clk_mode "out", lu du JSON de la
    carte et non ecrit en dur. En entree, aucune horloge n'arrivait et le MAC ne
    se reinitialisait pas (emac_esp32_init: reset timeout). Valide sur une
    ESP32-POE-WROVER-E (adresse IP par le cable).
    - boards/esp32-poe.json : brochage Ethernet + CC1101 868 sur les GPIO libres.
    - gen_board.py : emet le bloc ETH_* (dont ETH_CLK_MODE) depuis le JSON, et
    BOARD_HAS_ETHERNET 0 pour les cartes sans Ethernet.
    - wifi_bridge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
2026-10-17 Enrolement : re-enroler un moteur connu repart devant son compteur (#45)
    Deux pertes de compteur rendaient le re-enrolement d'un moteur deja connu impossible (#45) :
    - l'apprentissage partait toujours au compteur fige 3, les commandes de 4 : derriere le compteur d'un moteur connu, donc rejete comme un rejeu. Il part maintenant du compteur courant de l'identite (3 pour une neuve, conserve pour un moteur connu), reserve avant d'emettre.
    - la suppression d'un volet virtuel jetait son compteur, le seul a jour (il avance a chaque commande) : il y est maintenant reporte.
    Ajouts :
    - saut de resynchronisation KeeLoq (1024, puis 4096, 16384) pour une entree non confirmee (ancien firmware ou volet r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
2026-10-17 Decodage KeeLoq : seuils cales sur l'en-tete de chaque trame (AN742)
    Le decodeur calibre ses seuils sur l'en-tete (TE = en-tete/10) au lieu de seuils fixes, comme le decodeur de reference Microchip AN742. Avant, les seuils fixes limitaient le TE accepte a ~340-600 us ; la datasheet HCS300 va de 260 a 660 us (oscillateur RC), donc les telecommandes rapides etaient ratees (issue #37). Banc elargi aux TE 270, 400 et 650 us. Ajoute te= sur la ligne RX du journal. Ferme #37.
2026-10-17 Radio : calage de frequence sur la telecommande par balayage RSSI
    Trouve la porteuse reelle d'une telecommande en balayant la frequence de reception pendant une emission longue (commutateur P) et en relevant le RSSI max a chaque pas. FREQEST etant inutilisable en OOK (mesure sur issue #51), on prend le milieu des bords du plateau au seuil a mi-hauteur. Unite pure freq_sweep.c testee sur PC (banc dedie + job CI). Le balayage reste dans la bande declaree de la carte et l'application passe par la config validee. Ferme #51.
2026-10-17 Enrolement : pas d'apprentissage sans capture reussie dans la tentative
    Une capture ratee laissait l'identite de la capture precedente selectionnee, et l'apprentissage partait avec elle : une meme identite virtuelle finissait apprise par plusieurs moteurs, jamais celui qu'on visait (issue #53). Porte d'apprentissage (enrol_gate.c, unite pure testee sur PC) : l'emission n'est permise qu'apres une capture reussie dans la tentative en cours. Une capture ratee, un oubli, un volet enregistre ou un redemarrage ferme la porte. Message clair a l'utilisateur et bouton grise sinon. Ferme #53.
2026-10-17 NVS : pile Wi-Fi en RAM, et occupation par espace de noms dans l'etat
    La pile Wi-Fi d'ESP-IDF gardait sa config en NVS (~85-100 entrees sur les 16 Ko) alors que le firmware la redonne a chaque demarrage depuis cfg. NVS saturee, la calibration radio ne s'enregistrait plus (0x1105). cfg.nvs_enable=0 (Wi-Fi en RAM) et effacement unique de l'ancienne copie. /api/health expose desormais nvs_used et l'occupation par espace de noms, affichee dans Systeme > Etat. Mesure sur un boitier 9 volets : 60 -> 144 entrees libres, calibration de nouveau enregistree.
2026-10-17 mDNS : nom du boîtier, défaut unique par carte, et portail captif (#58)
    Le nom mDNS était écrit en dur (openprofalux) : deux boîtiers sur un même réseau se disputaient openprofalux.local.
    - Le nom mDNS vient du nom du boîtier (cfg/device), nettoyé par mdns_name.c (unité pure, banc firmware/test/mdns-name).
    - Sans nom choisi, le nom par défaut est figé une fois au premier démarrage : openprofalux pour un boîtier déjà installé (adresse inchangée), openprofalux-xxxx pour un neuf (2 derniers octets de la MAC du point d'accès, comme son SSID). Comparaison des noms par défaut sans tenir compte de la casse.
    - Portail captif sur le point d'accès : DNS en API brute lwIP (aucun s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
2026-10-17 mDNS : le boîtier s'annonce comme service _openprofalux._tcp (identifiant, version, carte)
    Suite de #58. Le boîtier annonce un service DNS-SD _openprofalux._tcp sur le port 80, avec trois TXT : id (MAC station en 12 hexa), ver (version du firmware), board (carte compilée). Un client réseau liste ainsi tous les boîtiers sans connaître leur nom ni leur IP.
    mdns_name_id() est dans l'unité pure mdns_name.c, couvert par le banc (T12). Les 5 cartes compilent sans avertissement.
2026-10-18 Build : versions des composants figées par puce, et doc alignée sur le code
    Fige les versions des composants du registre dans un verrou commis par puce (dependencies.lock.esp32 et .esp32s3), comme l'IDF est déjà figé en v6.1 : deux builds du même commit embarquent les mêmes composants. Une étape de CI échoue si un build recrée ou recalcule le verrou de sa puce.
    Le message « carte inconnue » liste les cartes depuis boards/*.json au lieu d'une liste écrite à la main. Le build par docker compose monte tout le dépôt (boards/, tools/) et reconstruit l'image. Documentation alignée sur le code : noms de binaires, topics MQTT, point d'accès et portail captif, tailles d'image. Aucu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
2026-10-18 Reception et telecommandes : confirmer une trame par une seconde identique (#39)
    Une trame recue n'est retenue que si une seconde identique la confirme, a la capture d'enrolement comme en ecoute permanente. Une trame isolee, souvent faible et a bits faux, ne cree plus de telecommande fantome et ne peut plus etre apprise.
    - rx_confirm : module pur (confirmation par repetition), teste sur PC, banc CI dedie.
    - Liste des telecommandes : onglet pour nommer, supprimer, ignorer une telecommande, et creer un volet depuis une telecommande deja captee.
    - Liste pleine signalee a l'UI au lieu de perdre une telecommande en silence.
    - Purge unique au boot des telecommandes fantomes d'avant la confirmatio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
2026-10-18 Emission : TE fixe a 400 us par defaut, sans calage automatique (#64)
    Le boitier emet au TE nominal du HCS300 (400 us) au lieu d'imiter celui de la telecommande captee. Recopier le TE mesure, c'est recopier la derive de l'oscillateur RC et le bruit de la mesure : dans #53, une capture a -61 dBm avait recale le TE de tous les volets a 482 us.
    - Plus de calage automatique a l'apprentissage, plus de TE par modele pour les telecommandes virtuelles.
    - Defaut 400 us (TX_TE_DEFAULT_US), toujours reglable dans Systeme > Appareil.
    - Migration : l'ancienne cle cfg/tx_te est effacee au demarrage, le reglage vit sous cfg/te_tx ; un boitier installe repart a 400 us, un TE saisi a la main est a ressaisir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
2026-10-18 Captures : rappel du profil radio, et un echec qui renvoie vers le profil ou le calage (#63)
    Au clonage et a la creation d'une telecommande virtuelle, le profil radio actif est rappele en haut de l'ecran. En cas d'echec de capture, le message reste affiche sous les boutons et propose de verifier le profil ou de caler la frequence sur la telecommande. Le texte s'adapte au profil actif (Profalux, Eveno, personnalise). Pas de balayage RSSI impose : les liens ouvrent Systeme > Appareil.
    Closes #63.
2026-10-18 Diagnostic radio : GDO0 libre ou tenu par un autre composant (#60)
    Le diagnostic radio teste GDO0 par les tirages internes de l'ESP32 : la broche est mise en entree, tirage haut puis bas, et on regarde si elle suit. Si elle suit les deux, rien d'autre ne pilote le fil ; si elle reste bloquee, un composant le tient. L'ESP32 ne force rien, sans risque pour le materiel. Resultat dans le diagnostic : GDO0 libre, ou GDO0 tenu par un autre composant.
    Closes #60.
2026-10-18 Enrolement : creer une identite neuve pour une telecommande deja connue (#53)
    Quand on cree un volet virtuel depuis une telecommande deja connue, on peut desormais choisir une identite neuve au lieu de reprendre l'existante. Une identite apprise par plusieurs moteurs les faisait bouger ensemble, et la reprendre ne separait rien.
    - Option de creer une identite neuve apres une capture qui reprend une identite.
    - La capture signale quand l'identite reprise pilote deja un volet virtuel.
    - L'ancienne entree est detachee : son slot reste reserve, jamais reattribue, puisque des moteurs la connaissent. La telecommande passe sur un slot libre, compteur neuf.
    - Permis seulement juste apres une captur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
2026-10-19 Enrolement : dire les deux cas de confirmation et forcer le delai avant de tester
    L'assistant presentait le va-et-vient du moteur comme obligatoire ; beaucoup de moteurs confirment sans bouger, ce qui faisait croire a un echec. Les consignes disent maintenant les deux cas. Et les boutons de test sont bloques jusqu'a un compte a rebours de 10 s lance apres les gestes, pour empecher un test trop precoce. Texte et UI seulement. Voir #59, #1.
2026-10-19 build de test : version identifiable via OPF_VERSION + script build-test.sh (#70)
    Les builds de test gardaient le numero de release (0.2.11), donc un testeur ne
    pouvait pas distinguer la build de test de l'ancienne version et verifier son flash.
    CMakeLists.txt lit desormais OPF_VERSION si definie et s'en sert comme PROJECT_VER,
    sans toucher le numero des releases. build-test.sh compile chaque carte de boards/
    avec une version <prochaine release>-<label> (ex. 0.2.12-test9), affichee au boot et
    dans l'UI. Doc dans BUILD.md.
2026-10-19 OTA : retour automatique à la version précédente si une mise à jour plante (#71)
    Active CONFIG_BOOTLOADER_APP_ROLLBACK_ENABLE et gère les faux rollbacks. Revue : logique de validation correcte, pas de risque de brique, partitions OK toutes cartes, test branché en CI. Auteur Akkeoss.
2026-10-19 Zones : les volets d'une télécommande de pièce suivent ses mouvements (#42)
    Les suiveurs d'une zone suivent l'état de leur télécommande de pièce (app, HA, vraie télécommande), sans réémettre. Corrige #38. Revue : pas de double comptage ni de boucle, modèle members rétrocompatible. Rebasé, STOP corrigé, CI 6 cartes verte. Auteur azriek.
2026-10-20 RX : restaurer le gain reglable (AGCCTRL2=rx_gain) et le seuil OOK 8 dB, regression v0.2.6
    AGCCTRL2 reprend s_rx_gain (defaut 0x27) au lieu du 0x04 cable en dur, et AGCCTRL0 revient a 0x91 (decision OOK 8 dB) au lieu de 0x92. Applique aux trois sites RX : ecoute permanente, probe d'enrolement, scan RSSI.
    Confirme cote TX par joha38 (#59, moteur solaire NeoSol pilote). Reception a reconfirmer : Nicoast (#1) reste sans capture sur test10, l'issue reste ouverte.
2026-10-20 Volet virtuel : dimension protocole pour preparer d'autres radios (#73)
    Ouvre le terrain pour qu'un volet virtuel emette autre chose que du
    Profalux/KeeLoq (Somfy RTS, ou un autre protocole), sans changer le
    comportement actuel.
    - volet_t gagne un champ `proto` (volet_proto_t). Profalux vaut 0 : les
    volets deja persistes, sans ce champ, le prennent par defaut.
    - emit_virt aiguille sur `proto` : le chemin Profalux est extrait dans
    emit_virt_profalux, les autres protocoles s'ajouteront a cote. Rien
    d'autre que Profalux n'est cable, le defaut emet comme avant.
    - Serialisation JSON retrocompatible : `proto` n'est ecrit que s'il n'est
    pas Profalux, donc les exports et sauvegardes existan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
2026-10-20 doc : collecte des trames par MQTT (#74)
    doc : collecte des trames par MQTT (#74)
    Procedure pour rassembler un gros jeu de trames d'une meme telecommande, en vue
    de l'analyse (issue #74) : ce que le boitier publie (topics, format JSON,
    prerequis), la collecte en direct sans limite via un abonne MQTT, les plafonds a
    connaitre (topics retenus vers 1000, export /api/frames borne a 1024 par
    telecommande), et le role de chaque champ. Valeurs relevees dans shutters.c et
    web_ui.c.
2026-10-21 Reception : confirmation a fenetre adaptative selon le signal
    La confirmation d'une trame par une seconde identique (#39) exigeait les deux
    dans 500 ms. Une reception faible (signal marginal, trames rares) n'y arrivait
    jamais : la trame etait decodee mais jamais confirmee, donc "rien capte" a
    l'enrolement et au test de reception, alors qu'une version anterieure captait.
    La fenetre devient adaptative, sans aucun reglage : confirmation rapide sous
    500 ms en reception dense, jusqu'a 4 s en reception faible. La protection de #39
    reste entiere, il faut toujours DEUX trames identiques, jamais une trame isolee
    (le code tournant change a chaque appui, donc pas de fausse confirmation entre
    deux appu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
2026-10-21 Web : table des routes pleine depuis #42, la route des centrales n'etait plus enregistree (#80)
    Depuis a88f9c0 (#42, zones), donc en v0.2.12, les deux tables de routes
    debordent d'une place : 49 routes protegees pour 48 places (MAX_ROUTES, la
    table de reg()) et 57 routes pour 56 (max_uri_handlers du serveur web). La
    derniere, /api/central, n'est pas enregistree : POST /api/central repond 404,
    et creer ou modifier une centrale depuis l'interface ne marche plus. Seule une
    ligne du journal de demarrage le dit ("route NON enregistree: /api/central
    (table pleine)"). Le piege avait deja frappe (/api/restore mort a 28).
    - MAX_ROUTES 48 -> 64, et MAX_OPEN_ROUTES = 12 pour les routes ouvertes (8
    a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
2026-10-21 Somfy RTS : codec logique de la trame en module pur teste (#73)
    Prepare le terrain du support Somfy RTS (433 MHz) dans OpenProfalux, sans
    toucher au chemin Profalux ni rien emettre.
    somfy_rts.c/.h : niveau LOGIQUE de la trame RTS 7 octets. Somme de controle
    (XOR de quartets), obscurcissement en cascade, aller-retour des champs
    (cle, commande, code tournant 16 bits, adresse 24 bits), et depliage
    Manchester. Module PUR (ni ESP-IDF ni FreeRTOS), comme radio_profile et
    keeloq_decode. Les durees d'emission et la polarite a l'antenne sont
    declarees d'apres les references publiques mais marquees A VALIDER : rien ne
    les consomme encore.
    Banc de test host (gcc + AddressSanitizer), branche en CI : 7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
2026-10-21 Somfy RTS : banc contre les vrais vecteurs open-rts, timings et adresse documentes
    Le banc somfy-rts ne se verifiait que lui-meme (pack et unpack d'accord entre
    eux). T7 confronte le codec a deux vecteurs reels tires des tests unitaires
    d'open-rts (loopj/open-rts) : les octets du fil et les champs decodes viennent
    d'une implementation tierce, pas de nous.
    - v1 : UP, code 0x1E63, adresse 0x421FEE -> fil A3 8A 94 F7 19 06 44.
    - v2 : UP, code 0x007B, adresse 0xFACADE -> fil AB 84 84 FF 21 EB 11.
    unpack(fil) rend les bons champs, pack(champs) reproduit le fil, dans les deux sens.
    somfy_rts.h, precisions apportees par la confrontation aux references :
    - convention d'adresse explicitee (octet 4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
2026-10-21 doc : plan d'implementation Somfy RTS (radio 433, TX/RX, appairage, carte)
    Etat du codec (#75, teste contre open-rts) et ce qu'il reste a faire pour piloter
    du Somfy RTS : la radio 433,42 MHz (point dur, antenne/matching specifique, options
    carte 433 / deux modules / diplexeur Super), l'emission (forme d'onde RMT), la
    capture, le code roulant persistant, l'appairage PROG, l'integration (dimension
    protocole #76, arbitrage radio, UI), le plan de test (Machin77 a le materiel) et
    les questions ouvertes. Sert de plan avant de coder la partie radio (#73).
2026-10-21 doc Somfy RTS : prevoir les deux cartes (433 dediee + Super), bandes declarees
    Les deux cartes sont de premier plan : la carte 433 dediee (Somfy seul) et l'ISNO
    Super (Profalux + Somfy, diplexeur 433+868). Aucune bande en dur : chaque carte
    declare ses bandes dans boards/<carte>.json, le firmware les lit et active Somfy
    et/ou Profalux en consequence, et refuse l'emission hors bande. Tableau des cartes
    et ordre revu en ce sens.
2026-10-21 Somfy RTS : constructeur de la sequence d'impulsions d'emission (unite pure)
    somfy_rts_tx_pulses construit, a partir des 7 octets empaquetes, la sequence
    d'impulsions OOK d'une trame : sync materiel (2 paires 1re trame, 7 aux
    repetitions), sync logiciel, puis les 56 bits Manchester, avec fusion des niveaux
    identiques adjacents. N'inclut ni le wakeup ni le silence inter-trame (enveloppe
    laissee a la boucle d'emission). Pret a jouer sur le RMT.
    Unite pure, sans radio : le banc (T8) prouve la STRUCTURE (ordre, durees des
    constantes, alternance des niveaux, duree totale) et verifie capable d'echouer par
    mutation. La polarite reelle a l'antenne et la jonction sync logiciel / premier bit
    restent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
2026-10-21 Somfy RTS : retirer le tiret cadratin des en-tetes de fichier
2026-10-21 Somfy RTS : telecommande virtuelle (adresse + code roulant, trame suivante)
    somfy_rts_remote_next produit la trame empaquetee d'une commande pour une
    telecommande virtuelle (adresse 24 bits + code roulant 16 bits), puis incremente le
    code roulant (repli a 0 apres 0xFFFF). Le quartet de cle n'est pas un etat a part :
    c'est le quartet bas du code roulant, verifie sur les vecteurs open-rts.
    Banc T9 : cale sur l'etat exact des deux vecteurs open-rts, la trame produite est
    bit pour bit celle du fil (A3 8A 94 F7 19 06 44 et AB 84 84 FF 21 EB 11), le code
    roulant avance et se replie ; verifie capable d'echouer par mutation. README a jour.
2026-10-21 Somfy RTS : demanchester (sens reception), inverse de manchester
    somfy_rts_demanchester relit 2*56 symboles '0'/'1' et recompose les 7 octets du fil :
    '0''1' -> bit 1, '1''0' -> bit 0, toute paire non-transition rejetee (demi-symbole
    manquant ou bruite). C'est la brique de decodage d'une capture Somfy pour le clonage ;
    les octets rendus se repassent a somfy_rts_unpack.
    Banc T10 : aller-retour manchester/demanchester = identite, vecteur open-rts relu
    jusqu'aux champs (adresse 0x421FEE, code 0x1E63), paire invalide et mauvaise longueur
    refusees ; verifie capable d'echouer par mutation. README a jour.
2026-10-21 Somfy RTS : aligner les durees d'emission sur ESPSomfy-RTS (source prouvee)
    Les constantes de timing passent du camp Pushstack (604/2416/1208, wakeup 9415/89565,
    inter-trame 30415) a celles d'ESPSomfy-RTS, lues dans Transceiver::sendFrame : demi-
    symbole 640, bit 1280, sync materiel 2560 (4 demi-symboles), sync logiciel 4850,
    wakeup haut 10920 / bas 7357 (sans long silence), inter-trame 27434. ESPSomfy est le
    projet Somfy le plus utilise, valide sur des milliers de moteurs : on suit la source
    prouvee au lieu de reinventer. La structure (tx_pulses) et les tests, parametres par
    ces constantes, sont inchanges et passent.
2026-10-21 doc Somfy RTS : config CC1101 et appairage d'apres ESPSomfy-RTS
    Section 3.1 : les reglages CC1101 repris d'ESPSomfy (lib ELECHOUSE) pour notre couche
    radio Somfy : 433,42 MHz, modulation ASK/OOK (setModulation 2), format serie async sur
    GDO0 (setPktFormat 3), carrier sense (setSyncMode 4), bande RX large, CRC/adresse
    desactives ; emission bit-bang GDO0, meme modele que notre capture Profalux. Section
    3.6 : PROG s'emet comme toute commande (sendFrame + repetitions), la procedure est cote
    moteur. On suit la source prouvee, reste a traduire en registres cc1101.c et mesurer.
2026-10-21 Somfy RTS : primitive d'emission OOK generique + module somfy_tx
    cc1101_tx_ook_pulses emet un train d'impulsions OOK brut en bit-bang sur GDO0,
    sans connaissance de protocole (memes precautions que cc1101_tx_raw_bits : capture
    RMT coupee pendant le bit-bang, GDO0 en sortie, un seul STX). radio_tx_ook_pulses
    l'emet sur une autre porteuse sous mutex puis retablit la porteuse Profalux.
    Le module somfy_tx assemble l'enveloppe d'une rafale (reveil, trames, silence
    inter-trame, repetitions) a partir du codec pur somfy_rts et emet a 433,42 MHz.
    Isole du chemin Profalux : rien du cote 868 ne bouge.
2026-10-21 Somfy RTS : cabler l'emission du volet virtuel (#73)
    emit_virt aiguille desormais VOLET_PROTO_SOMFY_RTS vers emit_virt_somfy, qui
    genere la trame (adresse + code roulant) via le codec, persiste le prochain code
    avant d'emettre (reserve-puis-emet, comme Profalux), puis emet a 433,42 MHz par le
    module somfy_tx. virt_serial et virt_counter du volet servent d'adresse et de code
    roulant. Le chemin Profalux est inchange.
    Compile-verifie sur isno-super (ESP32-S3). La polarite Manchester a l'antenne et le
    suivi par un vrai moteur restent a valider au banc (issue #73).
2026-10-21 Somfy RTS : UI de creation, appairage et test du volet virtuel (#73)
    Nouvel onglet Somfy (Telecommandes) : creer un volet Somfy par son adresse 24 bits
    (generateur d'adresse inclus), emettre l'appairage (commande PROG), puis tester
    montee/stop/descente. Pas de capture d'identite, contrairement au Profalux.
    Cote firmware : shutters_create_virtual_somfy (adresse, code roulant a 1), commande
    'prog' dans shutters_cmd (reservee aux volets Somfy virtuels), endpoint
    /api/somfy/create, et le champ proto expose dans le JSON d'un volet pour que l'UI
    distingue Somfy de Profalux. Le volet Somfy se pilote aussi depuis l'onglet Volets.
    Compile-verifie sur isno-super. Reste a valider sur un vrai moteur S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
2026-10-21 OTA : bootloader seul dans les releases, et bouton Version precedente qui dit pourquoi il refuse (#79)
    Suite de #71, deux manques.
    Releases : seuls -full.bin et -ota.bin etaient publies. Le retour
    automatique vit dans le bootloader, que l'OTA ne remplace jamais : sans
    ESP-IDF, la seule facon de l'obtenir sur un boitier installe etait le
    -full.bin, qui efface la configuration. build-release.sh publie maintenant
    openprofalux-<carte>-bootloader.bin, le bootloader seul, en image calee a
    0x0 comme le -full.bin sur toutes les puces : bootloader a 0x1000 sur ESP32
    (complete de 0xFF), a 0x0 sur ESP32-S3, offset lu dans flasher_args.json.
    Une adresse unique evite qu'un bootloader ESP32 ecrit a 0x0 e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
2026-10-21 doc : io-homecontrol, etude de faisabilite et appel a materiel de test
2026-10-21 Somfy RTS : cloisonner l'enrolement Profalux par protocole et verrouiller l'adresse (revue Codex #76)
    - Comptabilite d'enrolement 0x067 limitee aux volets Profalux (is_pfx_virt) : un volet
    Somfy ne reserve plus de creneau et ne touche plus un compteur d'enrolement Profalux.
    - emit_virt renvoie si une trame est partie ; start_move n'enclenche le suivi de position
    que dans ce cas (un protocole non cable ne fait plus avancer une position fantome).
    - Refus d'une adresse Somfy qui serait une identite Profalux 0x067 valide, a la creation
    (endpoint + fonction) : un ancien firmware restaurant une telle sauvegarde ne peut plus
    la prendre pour un volet Profalux et commander un moteur du meme f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
2026-10-21 Retrait du bouton Sponsor et de la section de soutien du README (#89)
    Le projet avance grace au travail de plusieurs contributeurs. Un bouton de dons
    a un seul nom ne reflete pas cette realite. On retire le bouton (FUNDING.yml) et
    la section correspondante du README, en attendant une forme de soutien partagee
    ou transparente, discutee avec les contributeurs.
2026-10-21 README : section Compatibilite et deux methodes de pilotage (#90)
    * README : section Compatibilite, deux methodes de pilotage, et corrections
    - Ajoute une section Compatibilite (resume du materiel confirme, renvoi vers
    docs/COMPATIBILITE.md) et une section "Deux methodes de pilotage" : le rejeu
    n'etait pas le seul chemin documente, l'enrolement etait cite sans etre defini.
    - Nuance la frequence : la porteuse Profalux varie selon la generation
    (868,350 a 868,425 MHz), au lieu d'une valeur unique devenue trompeuse.
    - Uniformise les separateurs decimaux en virgule francaise.
    - Complete la structure du depot (firmware/test, boards, research, tools).
    - Statut : l'enrolement est confirme pa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
2026-10-21 Web : refuser les envois venus de la page d'un autre site (CSRF) (#91)
    Sans mot de passe (le defaut), une page piegee ouverte sur un PC de la
    maison pouvait piloter le boitier : le navigateur execute un POST vers son
    adresse locale (ouvrir les volets, restaurer une configuration, lancer une
    mise a jour). Aucune route ne regardait d'ou venait la requete. Avec un mot
    de passe, le cookie SameSite=Lax protegeait deja.
    Le boitier refuse maintenant ces envois-la, et seulement eux (403,
    {"ok":0,"err":"origine"}, une ligne de journal) :
    - Sec-Fetch-Site (navigateurs recents, une page ne peut pas le falsifier) :
    refus seulement pour "cross-site" ; same-origin, same-site et none passent
    (l'interf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
2026-10-21 Capture : accepter une trame complete a defaut de confirmation (#1) (#92)
    * Capture : accepter une trame complete a defaut de confirmation (#1)
    La capture explicite exigeait deux trames identiques (confirmation anti-fantome,
    #39). Sur une reception marginale (M5 Atom Lite et XIAO, retours Nicoast et
    eleroy), la paire n'arrivait pas toujours dans la fenetre et la capture echouait,
    alors que la 0.2.11 captait a -53 dBm. Bissection (builds sans60 / sans60-39) :
    la regression vient bien de #39.
    radio_listen_confirmed garde la derniere trame complete et valide vue dans la
    fenetre et la rend si aucune paire n'est confirmee. La double trame reste exigee
    pour l'ecoute permanente (rx_task), ou le r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
2026-10-21 Version 0.2.13 : corrige la regression de capture de la 0.2.12 (#1)
2026-10-21 Serveur web : sessions = sockets - 5, pour laisser un socket a MQTT et un au TLS
    Le boitier a 10 sockets lwIP (CONFIG_LWIP_MAX_SOCKETS, defaut ESP-IDF, le
    meme sur toutes les cartes). Le serveur web en garde 3 pour lui et en
    autorisait 7 aux sessions, le maximum. Or MQTT tient un socket en
    permanence : des la 6e session navigateur (onglets, pages qui interrogent
    le boitier en keep-alive), les 10 sont pris, et accept() echoue avec
    l'errno 23 (ENFILE). La purge LRU du serveur, qui ferme la session la plus
    ancienne, n'agit qu'a 7 sessions pleines : elle ne se declenche jamais, et
    l'interface et l'OTA restent injoignables tant qu'une page ouverte garde
    ses connexions.
    Les sessions valent mainte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
2026-10-21 Telecommandes : alerte pile faible (bit VLOW), capteur Home Assistant par telecommande nommee
    Le decodeur rend les 66 bits de chaque trame, dont le bit 64 (VLOW, pile faible des
    HCS30x), mais shutters_on_rx l'ignorait : ni le journal, ni MQTT, ni l'UI n'en
    gardaient trace. Les murales fonctionnent sur pile : autant prevenir avant la panne.
    - remote_battery.c (pur) : une trame captee pres du bruit peut porter un bit faux
    (vu le 2026-10-10 : un meme appui decode en deux trames differentes a -91 dBm). On
    n'alerte qu'apres VLOW = 1 sur 2 appuis distincts d'affilee ; une trame VLOW = 0 leve
    l'alerte. Banc hote firmware/test/remote-battery + job CI (mutation verifiee).
    - shutters_on_rx : un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
2026-10-22 remote_battery : retire un tiret cadratin de l'en-tete
2026-10-23 enclosure : boitier imprime 3D OPEN PROFALUX (contribution @lecanard38)
    Boitier en forme de maison pour la carte ESP32 + CC1101, logo en relief, passage
    d'antenne et ouverture USB-C. Sources Fusion 360, STEP et STL, plus la photo.
    Partage avec l'accord de l'auteur, sous CC BY-SA 4.0. Repond a la demande de
    modele 3D d'un boitier (issue #53).
2026-10-23 enclosure : photo detouree sur fond blanc (+ version transparente)
    Remplace la photo de banc par un rendu detoure sur fond blanc, et ajoute la
    version a fond transparent pour reutilisation.
2026-10-23 doc io : integrer ce qui est mesure sur de vraies trames
    Met a jour l'etude de faisabilite avec les mesures faites via un testeur (#87) :
    structure reelle d'une commande Somfy io (25 octets, charge utile de 6, codes bouton,
    CRC KERMIT), couche physique 2-FSK portee et verifiee sur CC1101 (RX et TX), sync reel
    0x57FD. Ajoute les references Somfy (danielpetrovic, samr037) et precise que rspaargaren
    cible le Velux. Recadre le point ouvert : ce n'est plus la radio ni le format, c'est
    l'appairage (1W non prouve vs 2W).
2026-10-23 Revert du merge #86 sauf la doc io : Somfy RTS pas encore pret
    Le merge #86 a amene sur main, en plus de la doc io, tout le code Somfy RTS
    (somfy_rts/somfy_tx + integration + banc de test), qui n'est pas pret (feature en
    brouillon, PR #75, en cours de test #73). On annule l'arrivee du RTS sur main et on
    garde uniquement docs/IO-HOMECONTROL.md. Le RTS reviendra par le PR #75 quand il sera
    valide.
2026-10-24 Home Assistant : Ouvrir et Fermer toujours actifs (etat suppose)
    L'interface de HA desactive Fermer sur un volet qu'elle croit ferme, et Ouvrir sur un
    volet qu'elle croit ouvert, sauf si l'entite annonce assumed_state. Une commande ratee,
    ou une position mal suivie, ne se rattrapait donc qu'en faisant d'abord un mouvement dans
    l'autre sens.
    La decouverte des covers annonce optimistic: true, d'ou HA tire assumed_state
    (mqtt/cover.py) ; son interface laisse alors les deux boutons actifs (frontend,
    data/cover.ts : canOpen, canClose). C'est le cas reel : le moteur ne renvoie rien. HA lit
    toujours state_topic ; il affiche seulement l'etat vise des l'envoi, avant celui publie
    par le boitier.
    Co-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
2026-10-24 somfy rts : rafale plus longue pour monter/descendre (enclenchement course complete)
    Certains moteurs n'enclenchent la course complete qu'au-dela d'un seuil de trames (mesure
    communautaire NodeMCU : ~2 trames = un cran, ~16 = course complete). Les 8 trames d'avant
    restaient sous le seuil sur un volet a battants (#73, retour de Machin77). Monter/descendre
    emettent maintenant 20 repetitions, stop/My 3 (plafond monte a 23). Le timing reste celui
    d'ESPSomfy. Colle au modele existant : une rafale enclenche, do_stop fige au bon moment.
2026-10-24 somfy rts : emission 80 bits (format qui declenche la course complete)
    La vraie cause du petit mouvement (#73, trouvee par @Machin77 en capturant sa Situo avec
    ESPSomfy) : sa telecommande emet en 80 bits, pas 56, et c'est le FORMAT qui declenche la
    course complete (2 trames suffisent), pas le nombre de trames. Ma piste test2 (plus de
    repetitions) etait fausse, elle est retiree.
    Ajoute somfy_rts_frame80 (56 bits standard + 3 octets d'extension bruts, par commande et
    index de repetition) et somfy_tx_emit80, repris a l'identique d'ESPSomfy-RTS encode80BitFrame
    (la reference qui marche sur ce moteur). Verifie sur hote : les 3 octets collent aux valeurs
    ESPSomfy pour monter/descendre/stop, 1re t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
2026-10-24 somfy rts : emettre en 56 bits par defaut (standard), le 80 bits en option a venir
    Le 56 bits est le standard des volets roulants classiques et le defaut d'ESPSomfy ; le
    80 bits (dans le codec, somfy_tx_emit80) ne s'applique qu'a certains moteurs (lames
    orientables, ex. Situo Variation). Tant que le reglage 56/80 par volet n'existe pas, on
    emet en 56 bits pour ne regresser aucune install standard. Le code 80 bits reste present
    pour ce futur reglage.
2026-10-24 Restaure Somfy RTS : annule le revert 506259f (la base RTS est prete)
    Le revert 506259f avait retire tout le code Somfy RTS de main (cc1101, radio,
    somfy_rts/somfy_tx, l'UI, web_ui, CMakeLists) en gardant la doc io. La base RTS
    est desormais prete : on la restaure telle quelle, puis on y pose le travail
    plus recent de la branche (80 bits, defaut 56 bits).
2026-10-24 Somfy RTS : selecteur 56/80 bits par volet
    Le 56 bits reste le defaut (standard, ne regresse personne). Le 80 bits (course
    complete sur les moteurs a lames orientables, #73) se choisit a la creation d'un
    volet Somfy, et se change ensuite sans le recreer (/api/somfy/mode). Le format est
    persiste par volet (somfy_mode, omis en JSON quand il vaut 56 bits), aiguille dans
    somfy_emit_cmd par l'enum somfy_rts_mode_t, jamais par un litteral.
2026-10-24 README : firmware multi-protocole (Profalux + Somfy RTS, io a l'etude)
    Profalux reste le coeur. On ajoute la section Somfy RTS (433 MHz, #73 : appairage
    PROG, pilotage, format 56/80 bits par volet) et io-homecontrol (Velux/Somfy io, #87,
    pas encore fonctionnel), toutes deux marquees experimentales. Faits d'appareil
    seulement dans la compatibilite, aucun nom de testeur.
2026-10-24 boards : ajoute xiao-esp32s3 (XIAO ESP32S3 + CC1101 868 externe, depannage #1)
    La carte etait utilisee pour un build de depannage mais son fichier n'etait pas
    suivi : les binaires xiao-esp32s3 de la release v0.2.14 en sortent, la source les
    rejoint. CC1101 externe sur SPI (sck7 miso8 mosi9 cs5 gdo0=4 gdo2=2), bande 868.
2026-10-24 Compatibilite : ajoute un recepteur Somfy RTS (Soliris Mod/Var Slim, BSO 2012)
    Confirme en Somfy RTS (appairage PROG, course complete en appui bref). Faits
    d'appareil seulement, pas de nom de testeur (issue #73).
2026-10-24 Compatibilite : crediter le testeur par son pseudo (Machin77) sur la ligne Somfy RTS
2026-10-24 Somfy RTS : rafale courte par defaut (course complete, pas orientation)
    Retour #73 : sur un recepteur a lames orientables (BSO), la duree de l'appui decide,
    bref = course complete, long = orientation des lames. On emettait 8 trames (une salve
    longue), qui orientait les lames au lieu de faire la course. On repasse a la rafale
    courte de la vraie telecommande (SOMFY_RTS_TX_REPEATS), pour les deux formats 56 et 80.
2026-10-24 Somfy RTS : retire le selecteur 56/80 par volet (inutile)
    Le retour #73 a montre que le levier de la course complete, c'est la rafale COURTE,
    pas le format 56/80. Le menu par volet (champ somfy_mode, endpoint /api/somfy/mode,
    UI, enum) ne servait donc a rien : on le retire. L'emission Somfy RTS reste en 56 bits,
    rafale courte. Le codec 80 bits (somfy_tx_emit80) reste dans la base, teste, au cas ou
    il compterait sur d'autres moteurs, mais il n'est plus cable.
2026-10-27 Ajoute les captures d'écran de l'interface web (mobile et PC)
2026-10-27 Simplifie la table de compatibilité (5 colonnes, une ligne par modèle)
2026-10-27 Table de compatibilité groupée par marque
2026-10-27 README : ajoute une galerie des captures de l'interface web
2026-10-27 Captures RF debug : floute la colonne télécommande (mobile) et recadre sur la table
2026-10-27 docs(compat): enrôlement, préciser l'aller-retour facultatif et le délai de 10 s avant de tester
2026-10-27 docs(compat): NeoSol S300 Stella, preciser la frequence ~868,383 MHz forcee (a confirmer)
2026-10-27 docs: montage photos des télécommandes compatibles (testeurs)
2026-10-27 docs: illustrer la compatibilité avec le montage des télécommandes
2026-10-28 docs(images): montage telecommandes, ajout de la NeoSol d'eleroy (face + etiquette MAI-SOLTS)
2026-10-28 docs(compat): deux colonnes Rejeu et Enrolement (oui/non) a la place de Methode
2026-10-28 docs(compat): marquer NA les cases rejeu/enrolement non renseignees
2026-10-28 docs(compat): tableau bilingue (FR // EN), une source pour les deux langues
2026-10-28 Super : piloter les deux radios declarees (868 + 433) (#95)
    Le firmware ne retenait qu'une radio : gen_board.py jetait les radios declarees
    sauf la 868 (pick_radio), alors que isno-super.json en declare deux (868
    E07-900MM10S et 433 E07-400MM10S). La carte n'etait donc pas pilotee selon sa
    declaration.
    - gen_board.py emet CC1101_COUNT et CC1101_RADIO_TABLE_INIT (toutes les radios,
    index 0 = primaire 868). Une carte mono-radio reste inchangee (COUNT=1).
    - cc1101.c pilote N radios sur le bus SPI partage via une radio active : les
    broches CS/GDO suivent s_radios[s_active]. Le bus est initialise une seule
    fois, chaque puce configuree au boot. Ajoute cc1101_select / radio_count /
    active_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
2026-10-29 UI radio : une carte de reglages par radio (profil, calage, gain, TE) + backend par radio et logs de boot (#95)
2026-10-30 cfg_model: incise en virgules au lieu de tirets dans un commentaire
2026-10-30 style : retire les tirets cadratins de la prose et des commentaires
2026-10-30 web : retire une marque tierce d'un commentaire (suivi de position)
2026-10-30 Diagnostic : test de reception PAR radio, pour ecouter la bonne puce (433 inclus) (#95)
    La reception (ecoute dediee / apprentissage) ecoutait toujours la radio ACTIVE, soit la
    primaire 868 : d'ou le "ne capte rien" sur une telecommande 433, remonte par Pascal au banc
    sur la Super. Le sweep et le calage etaient deja par radio, pas la reception.
    Ajout de radio_listen_confirmed_on(idx) sur le meme patron (selection de la puce sous mutex,
    ecoute, puis retour a la 868), de /api/learn/start?radio=N, et d'un bouton "Tester la
    reception" PAR radio dans le Diagnostic. Carte mono-radio : un seul bouton, inchange.
2026-10-30 Logo du projet : banniere du README et logo de l'interface
    Banniere clair/sombre du README, logo et favicon de l'interface au bleu, assets dans docs/images/logo/.
2026-10-30 radio : desactiver le canal RMT avant de le supprimer au changement de radio
    cc1101_select supprimait s_cap sans rmt_disable prealable. ESP-IDF exige un
    canal desactive pour rmt_del_channel : sinon la suppression echoue, le canal
    DMA fuit, et re-creer la capture sur le GDO0 de la radio secondaire rend
    "no free rx channels". s_cap reste NULL, donc capture, reception ET calage de
    la 433 echouaient instantanement (le sweep y echappait : il lit le RSSI, pas
    le RMT). On desactive avant de supprimer, et on ne masque plus un echec de
    recreation (log).
2026-10-30 radio : corrige 3 retours Codex sur le support deux radios (#95)
    - radio_apply propage l'echec de cc1101_set_freq_khz au lieu de toujours
    rendre 0 : l'UI ne dira plus "applique" quand une radio secondaire a
    refuse la frequence.
    - cal_task ne selectionne la radio ciblee que DANS chaque fenetre tenue
    sous mutex et restaure la primaire avant de relacher : la 433 ne reste
    plus active mutex relache pendant ~24 s, un radio_tx concurrent n'emet
    plus un volet Profalux sur la mauvaise puce.
    - Diagnostic 433 : le test de reception dit clairement qu'il lit du
    Profalux/KeeLoq (code tournant, serial), et qu'une Somfy RTS ou un
    portail CAME n'y apparaissent pas meme recus.
2026-10-30 Capture brute OOK + rejeu RMT : module rf_capture + UI Diagnostic (#95)
    Capture protocole-agnostique des telecommandes OOK a CODE FIXE (portail CAME, capteurs...)
    que le decodeur Profalux/Somfy ne connait pas, et rejeu a l'identique. Pas de "filtre de ce
    qu'on connait".
    - cc1101_rx_capture_pulses : capture RMT brute (impulsions niveau+us, res 1 MHz), additif, sans
    toucher le chemin d'ecoute eprouve.
    - radio_capture_raw_on : capture sur la radio idx (mutex + select + restauration), patron du sweep.
    - rf_capture.c/.h : moteur capture + rejeu + export JSON ; point d'integration journal auto-cable
    via __has_include("capture_journal.h") (owne par la session soeur).
    - /api/capture/{start,last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
2026-10-30 Capture : eviter la sequence /* dans les commentaires (-Werror=comment)
2026-10-30 support : onglet Rapport + POST /api/report (ouvre l'issue via le relais www.isno.fr)
    - web_ui.c : route /api/report ; joint chip-id + version + carte + la derniere capture
    brute (rfcap_last_json, OOK, protocole-agnostique, aucun secret) et POST au relais
    /support (qui ouvre l'issue OpenProfalux + envoie l'email de suivi) ; l'email ne part
    jamais dans l'issue publique.
    - index.html : onglet Rapport (email, marque/modele, but, description, apercu capture).
    - app.js : handlers rep-send / rep-jview (apercu -> /api/capture/last).
    Zero dependance io : appelle seulement le rfcap_last_json public. Build isno-super vert (1233888 o).
2026-10-30 types : dev_type_t { volet, portail } + champ type sur l'appareil, UI type-aware
    Modele de type d'appareil (#101), orthogonal au protocole d'emission : il decide le vocabulaire
    de commande et les libelles de l'UI, pas la facon d'emettre.
    - cfg_model.h : enum dev_type_t { TYPE_VOLET=0, TYPE_PORTAIL=1 } (on ne declare que ce qu'on
    pilote ; eclairage plus tard, en ajout) + champ type sur volet_t (defaut 0, NVS inchange).
    - cfg_model.c : serialisation du type (meme motif que proto, ecrit si non-defaut, lu avec defaut).
    - shutters.c : type expose dans le JSON de statut pour l'UI.
    - app.js : d-pad type-aware (volet reste Montee/Descente, portail Ouvrir/Fermer, icone 🚪).
    Source unique du type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
2026-10-30 Rejeu : silence inter-trame entre les repetitions (#102)
    Une capture ne prend qu'UNE trame (le creux final n'est pas capte). Au rejeu, les
    repetitions arrivaient collees (~3 ms d'ecart) et le recepteur ne delimitait plus les
    trames : un portail CAME ne s'ouvrait pas, radio et frequence pourtant bonnes (vu sur le
    log du testeur). On ajoute un creux inter-trame (porteuse OFF, RFCAP_GAP_US = 12 ms,
    couvre le silence CAME ~11,5 ms) apres chaque trame rejouee. Generique OOK, a affiner au
    banc si une marque exige un creux different.
2026-10-30 Appareils : table de profils declaree (source unique) pour l'ecran unifie (#101)
    Pose la TABLE DE PROFILS, source unique de l'ecran unifie « Ajouter un appareil »
    (pyramide type -> marque -> profil). L'UI (ecran a venir) se batit dessus : 'types'
    donne les libelles + d-pad par type, 'profils' les feuilles (marque, nom, mecanisme,
    flow). Protocoles existants seulement (Profalux cloner + enroler, Somfy enroler) ;
    le CAME (portail, rejeu OOK) arrive en branche 2. Contrat auto-documente dans _contract.
2026-10-30 ecran : fusion Cloner/Creer/Somfy en un ecran 'Ajouter un appareil' (pyramide type/marque/profil)
    L'ecran unifie se batit depuis profiles.json (table de Max, source unique) : pyramide type -> marque
    -> profil, puis routage vers les flux EXISTANTS (Cloner/Creer/Somfy) via le hash, avec un retour.
    Aucun handler de flux touche : zero regression attendue, seule la vue fusionne.
    - index.html : un onglet 'Ajouter un appareil' remplace les 3 sous-onglets ; panneau pyramide ; retours.
    - app.js : rendu de la pyramide depuis /profiles.json, routage flow -> panneau existant.
    - web_ui.c + CMakeLists : profiles.json embarque + route /profiles.json.
    - web_ui.c : MAX_ROUTES 64 -> 80. /profiles.json faisait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
2026-10-30 CAME : profil portail CAME (rejeu brut) dans la table (#102)
2026-10-30 ecran : panneau 'rejeu' (creer + capturer par commande) + routage pyramide flow=rejeu
    Le flux de rejeu brut generique (branche 2) a son UI : la pyramide 'Ajouter un appareil' route le
    profil flow='rejeu' (ex. Portail CAME) vers un nouveau sous-panneau data-sp='rejeu' :
    - nom + Creer -> POST /api/rejeu/create {id,type} (type pris du profil choisi dans la pyramide) ;
    - selecteur radio (/api/radios, pre-selection 433 pour un portail CAME OOK) ;
    - un bouton Capturer par commande, libelles type-aware (Ouvrir/Fermer pour un portail) ->
    POST /api/rejeu/capture {id,cmd,radio} ; affiche le nombre d'impulsions.
    Le d-pad de Pilotage rejoue ensuite tout seul (moteur de rejeu de Max). Ajoute UNIQUEMENT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
2026-10-31 ecran : retours d'Akkeoss (#111) - bug F5, MAX_ROUTES, renommage Appareils
    - Bug corrige : le profil choisi n'etait qu'en variable JS, donc un F5 sur #remotes/rejeu creait un
    portail comme un volet. L'index du profil est desormais dans le hash (#remotes/rejeu/<i>) et
    loadRejeuPanel le recupere.
    - MAX_ROUTES remis a 64 : mon bump etait inutile (2 tables distinctes, les protegees tenaient a 57/64).
    Et /profiles.json passe de route ouverte a protegee -> soulage la table ouverte (10/12 -> 9/12),
    comme suggere par Akkeoss (auteur de check_routes.py / PR #80).
    - Onglet renomme 'Appareils' (au lieu de 'Telecommandes'), plus juste avec les portails ; hint maj.
    Reste (suivi #111) : deep-link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
2026-10-31 profiles.json : champ band (433/868) par profil pour le filtre radio vs carte (#111)
    Chaque profil declare sa bande, meme vocabulaire que /api/radios : CAME et
    Somfy RTS en 433, Profalux (cloner + enrolement) en 868. L'UI (pyramide) ne
    proposera un profil que si la carte a une radio sur cette bande. Au passage,
    le _contract disait encore qu'aucun profil portail n'existait : corrige, le
    portail CAME y est.
2026-10-31 ecran : filtre radio vs carte dans la pyramide (retour Akkeoss #111)
    La pyramide 'Ajouter un appareil' ne propose plus un profil dont la bande n'est pas sur la carte :
    loadAddPyramid lit /api/radios (PYRAMID_BANDS), renderAddStep filtre les profils par leur champ
    'band' (de profiles.json, pose par Max en a53dc6a). Un profil sans 'band' reste montre (filet).
    Donc un Portail CAME / Somfy (433) ne s'affiche plus sur une carte 868 seule. Filtre app.js seul.
    Build isno-super vert (filtre valide).
2026-10-31 ecran : filtre pyramide fail-open sur echec /api/radios (suivi relecture Max)
    Si /api/radios echoue ou rend une liste vide, PYRAMID_BANDS reste null (au lieu d'un Set vide, qui
    est truthy) : le filtre montre alors TOUS les profils (fail-open, le filet annonce) au lieu de tout
    cacher, et re-essaie au prochain affichage. Bug attrape par Max a la relecture.
2026-10-31 Carte LILYGO T-Embed CC1101 (retour #112) (#113)
    Nouvelle carte communautaire proposee par @mckbrmn : CC1101 integre, ecran TFT
    et carte SD sur le meme bus SPI. Son init (alimentation, selection de bande, CS
    des peripheriques tenus hauts) n'est PAS ecrit en dur dans cc1101.c : il est
    declare dans la carte (champ init_gpio) et lu sous la garde BOARD_HAS_INIT_GPIO,
    sur le modele du bloc ethernet. Une carte sans init_gpio, comme la Super, ne
    compile et ne pilote rien de tout cela.
    - boards/lilygo-t-embed-cc1101.json : la carte (868 MHz, init_gpio).
    - tools/gen_board.py : emet BOARD_HAS_INIT_GPIO / BOARD_INIT_GPIO.
    - cc1101.c : applique la table au tout debut de cc1101_init, sous garde.
    Verifi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
2026-11-01 Pyramide : ecran unifie Ajouter un appareil + detection de profil + E4 (capture rejeu lit le rx du profil)
2026-11-01 io : hooks radio (ecoute permanente / sniff / send / pair 1W) sur feat/came, FSK io exclusif de l'OOK (#87)
2026-11-01 io : UI de test (ecoute io permanente, capture du 0x30 en PROG) dans Diagnostic radio, separee de la pyramide (#87)
2026-11-02 pyramide : emission par appareil (freq/TE/rpt/rmt) + ecran Modifier (profil, renommage, suppression)
    - volet_t porte freq_khz/te_us/tx_rpt/tx_rmt (tri-etat tx_override_t) + marque ; serialisation
    additive, round-trip cfg_store T0-T14 vert
    - radio_tx_device applique puis restaure les params de l'appareil : deux marques sur une meme radio
    ne se melangent plus (correctif du bug terrain Eveno/Profalux)
    - emit_virt_profalux ET emit_press (clones) passent par radio_tx_device ; migration-snapshot au boot
    - defauts resolus depuis profiles.json par le navigateur (source unique), jamais codes en dur
    - Appareils > Mes appareils > Modifier : panneau avance partage (ajout + edition), selecteur de pro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
2026-11-02 pyramide : panneau avance GENERIQUE pilote par le schema du profil (E7) + Somfy dans le moule
    - UI : profileFields(profil) derive les champs editables du tx du profil (profiles.json), txAdvanced
    les rend dynamiquement (number / on-off / selecteur 56-80) ; plus de champs codes en dur
    - Somfy RTS entre dans le moule : Mes appareils > Modifier montre frequence + format 56/80
    - Frequence PAR APPAREIL pour toutes les marques (ajustement par installation) : KeeLoq via
    radio_tx_device, CAME via le rejeu, Somfy via somfy_tx_emit(..., freq_khz) desormais parametrable
    (avant constante SOMFY_RTS_FREQ_KHZ)
    - fiche : champ frame_bits (volet_t) + serialisation additive + sortie status ; somfy_emit_c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
2026-11-03 pyramide : ecran de capture unifie, clone et rejeu dans un seul ecran, commandes par type
    Le rejeu (CAME) reutilise l'ecran learn de Profalux : meme geste, un seul
    ecran. Les commandes a capturer viennent du TYPE (profiles.json : volet =
    Montee/Stop/Descente, portail = un bouton), plus de liste figee dans l'UI.
    shutters.c expose l'etat rejeu (rejeu + rejeu_cmds) pour le rendu et rejoue
    le bouton unique en repli. index.html porte un titre/sous-titre dynamiques.
2026-11-03 came : encodeur TOP-432 propre (E6), polarite validee par round-trip rtl_433
    came_tx_build_frame / came_tx_emit regenerent une trame CAME propre a partir
    du code 12 bits connu, au lieu de rejouer l'enveloppe captee avec ses scories
    (la regression de rejeu brut). Mapping cale empiriquement en resynthetisant la
    trame et en la repassant dans rtl_433 : cellule de start courte, 12 bits MSB
    d'abord, bit 0 = longue haute + creux court, bit 1 = courte haute + creux long,
    gap inter-trame 11,5 ms. Round-trip concluant pour 0x39E, 0x000, 0xFFF, 0x123,
    0xABC. Ajoute au build. NON branche a un flux et NON teste sur un vrai moteur.
2026-11-03 io : io_store_erase_all, socle de purge du namespace iohc sature, non branche
    Compte les entrees du NS iohc, les efface toutes, commit, et rend le nombre
    libere. Prepare le correctif du budget NVS de l'external (iohc accumule 3
    entrees par source io captee au vol, ~141 entrees, NVS sature). Aucun endpoint
    ne l'appelle encore : c'est du socle pour le lot NVS a venir.
2026-11-03 pyramide : ecran de capture unifie corrige + selection de radio explicite par bande
    - CAME resout enfin son profil : window.PROFILES etait toujours undefined (PROFILES est
    lexical, pas une propriete de window), l'ecran retombait sur le clone volet generique
    (3 boutons, 868, titre generique). Lit PROFILES.
    - liste des appareils filtree par TYPE (un profil portail ne liste plus les volets), icone
    porte pour un portail.
    - note 'creer une telecommande virtuelle' affichee seulement si la MARQUE declare un profil
    d'enrolement dans profiles.json : CAME n'a que du rejeu -> note cachee. Decision du fichier
    de config, pas une regle ecrite en dur.
    - bandeau profil radio 868 cache en contexte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
2026-11-03 pyramide : type d'appareil pilote par la config + filtre par type dans Mes appareils
    - le statut expose desormais TOUJOURS v.type (0 volet, 1 portail), fin de l'hypothese
    implicite 'absent = volet' cote UI (shutters.c).
    - profiles.json : chaque type porte 'code' (miroir de dev_type_t) et 'icon'. Le vocabulaire
    des types vit dans la config, plus de 0/1 ni d'icone ecrits en dur dans le JS.
    - helpers partages typeByCode / deviceTypeKey / deviceTypeIcon / filterByType : la MEME
    logique de type sert l'ecran de capture ET Mes appareils, plus de regle recopiee.
    - Mes appareils : barre de filtre par type (une puce par type declare + Tous).
    - creation d'un appareil rejeu : le code de type est l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
2026-11-03 pyramide : changer le type d'un appareil depuis l'ecran Modifier
    Repare un appareil range au mauvais type (ex. un rejeu cree sans profil portail, tombe sur
    le defaut volet) sans le reenroler ni le recapturer : identite, compteur et captures conserves.
    - firmware : shutters_set_type(id, type) + endpoint POST /api/volet/type {id,type}. Borne sur
    dev_type_t declare.
    - UI : selecteur de type dans l'ecran Modifier (Mes appareils). Options, libelles, icones et
    codes viennent de profiles.json (deviceTypeKey + types[].code), rien en dur.
2026-11-03 pyramide : masquer orientation/zone pour un portail + profil sous le nom + fermer Modifier au filtre
    - profiles.json : le type 'volet' porte 'positional' (a une orientation de façade et peut etre une
    zone de suiveurs) ; un portail ne l'a pas -> l'ecran de capture masque Orientation et Zone pour lui.
    Declare dans la config, pas en dur.
    - Mes appareils : le nom du profil passe SOUS le nom de l'appareil (pile verticale).
    - Mes appareils : changer de filtre ferme le panneau Modifier ouvert (il restait affiche pour un
    appareil absent de la liste filtree).
2026-11-03 fix : persister le type d'appareil pour TOUS les appareils, pas seulement les virtuels
    Le champ 'type' (dev_type_t) etait serialise ET deserialise a l'interieur du bloc if (v->virt).
    Un appareil rejeu (CAME, non-virt) portail ne persistait donc pas son type : au reboot il repassait
    volet (0). Prouve sur la Super : Poub (rejeu) passe portail -> reboot -> redevenait volet. Deplace la
    (de)serialisation du type HORS du bloc virt -> attribut general. Verifie : set portail -> reboot ->
    reste portail ; /api/backup porte desormais type=1 pour un rejeu.
2026-11-03 pyramide : capturer a la frequence du PROFIL de marche, pas celle de la box + icone par type partout
    Prerequis pour faire cohabiter Profalux (868425) et Eveno (868330) sur une meme box : la capture ne
    doit pas ecouter sur la frequence globale de la box.
    - radio.c/h : radio_listen_confirmed_on_freq et radio_capture_raw_on_freq calent idx sur la frequence
    demandee (0 = garder), ecoutent, puis RESTAURENT la porteuse de idx (ne pas decaler l'ecoute
    permanente). Les anciennes fonctions delegent avec freq 0.
    - learn/start accepte ?freq_khz=N ; rejeu/capture lit freq_khz du corps ; shutters_rejeu_capture le
    prend et le stocke.
    - UI : captureFreqFor(profil) donne la frequence (profil de marque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
2026-11-03 pyramide : frequence du rejeu editable par appareil dans Modifier
    Dernier morceau : la notion de reglage par appareil s'applique enfin au rejeu (CAME).
    - rejeu_emit prend la frequence de la FICHE (v->freq_khz) si elle est posee, sinon la frequence
    captee. La fiche prime donc, et devient editable.
    - ecran Modifier : un appareil rejeu a desormais un champ Frequence (kHz), pre-rempli depuis la fiche
    ou le profil, enregistre via /api/volet/txparams. C'est ce qui fait cohabiter CAME, Profalux et
    Eveno sur des frequences differentes sur une meme box.
2026-11-03 pyramide : icone de type en SOURCE UNIQUE (profiles.json) + portail coulissant dessine (SVG)
    - l'icone d'un type n'etait definie qu'a moitie dans profiles.json : l'ecran Volets gardait une table
    DEV en dur. devOf lit desormais l'icone ET les libelles du d-pad dans profiles.json (typeByCode),
    DEV ne reste qu'un repli tant que profiles.json n'est pas charge. Une seule source.
    - portail : aucun emoji ne represente un portail coulissant -> icone SVG trait dessinee (panneau a
    lames sur rail + fleche de glissement), portee par profiles.json types.portail.icon. Rendue partout
    en innerHTML (pastille du picker, filtre, Mes appareils, ecran Volets).
    - picker : innerHTML au lieu de textContent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
2026-11-03 pyramide : filtrer l'ecran de capture par MECANISME, pas seulement par type
    Dangereux : l'ecran de clone listait les volets ENROLES (virtuels), qu'on ne clone pas (pilotes par
    generation). On pouvait les selectionner et lancer une capture dessus par erreur. Desormais, avec un
    profil porte, le picker filtre aussi par mecanisme : un ecran de clone ne montre que les appareils
    clones, un ecran de rejeu que les rejeu, jamais les enroles. deviceMech(v) = enrolement|rejeu|cloner,
    compare a profil.mecanisme. Sans profil (gestion d'un appareil existant), pas de filtre mecanisme :
    la fonction 'apprendre la telecommande d'origine d'un volet enrole' reste accessible par ce chemin.
2026-11-03 pyramide : capture calquee sur l'enrolement, panneau avance (frequence PAR APPAREIL) sur l'ecran de capture
    Olivier : la capture (clone/rejeu) doit se regler comme l'enrolement, avec un mode avance, et pareil en
    modification ; sa specificite c'est la capture PAR APPAREIL (a sa frequence).
    - ecran de capture : meme composant que l'enrolement (txAdvanced derive du schema du profil) monte dans
    #learn-advanced (mountCaptureAdvanced, miroir de mountEnrolAdvanced). Donne la frequence (et TE/rpt/rmt
    pour un clone KeeLoq) PAR APPAREIL. captureFreqFor lit ce panneau en priorite ; apres la capture,
    applyCaptureAdvanced applique les reglages a l'appareil (/api/volet/txparams).
    - Modifier : le rej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
2026-11-03 pyramide : panneau avance de capture deplace a la fin de l'ecran
    Sur retour d'Olivier : les reglages avances (frequence par appareil) se placent en bas de l'ecran de
    capture, apres les commandes, comme un repli d'ajustement. Pour un clone il n'y a pas de profil Eveno :
    la marque se resout par la frequence saisie dans ce panneau (pas de selecteur de marque sur l'ecran).
2026-11-03 pyramide : « Caler sur ma telecommande » vit sur l'ecran de capture et remplit l'avance
    Sur retour d'Olivier : plus besoin d'aller dans Systeme regler la box. Un bouton « Caler sur ma
    telecommande » dans le panneau avance balaie la BONNE radio (par bande, captureRadioFor) et ecrit la
    porteuse trouvee (center_khz du /api/rx/sweep) dans le champ Frequence du panneau, PAR APPAREIL ; le
    panneau s'ouvre pour la montrer. captureFreqFor lit ce champ, donc la capture se fait sur la frequence
    calee. Le bandeau de capture ne renvoie plus vers Systeme.
2026-11-03 pyramide : en-tete de l'enrolement aligne sur l'ecran de capture (titre puis explication, plus en haut)
2026-11-03 pyramide : enrolement, un seul bouton primary par ecran et libelle de capture unifie (Appuie sur ta telecommande)
2026-11-03 pyramide : clonage, la prochaine commande a capturer devient le seul bouton primary (libelle unifie Appuie sur ta telecommande)
2026-11-03 pyramide : clonage, boutons de capture uniformes (meme libelle Capturer), seul le prochain passe en primary
2026-11-03 pyramide : enrolement, bouton de capture passe a 'Capturer' (verbe d'action, coherent avec clonage et rejeu)
2026-11-03 retrait io : feature io-homecontrol (module io/, hooks radio, endpoints et UI de test) reportee sur une branche dediee, main reste sur le socle pyramide/came stable
2026-11-03 mqtt : interrupteur par carte « obeir aux ordres MQTT » (defaut ON) ; coupe sur une carte secondaire pour qu'une seule emette un volet partage (fin de la double emission et de la derive de compteur)
2026-11-03 Carte Arduino Nano ESP32 + CC1101 externe
    La Nano ESP32 (module u-blox NORA-W106) est un ESP32-S3 : le brochage de la
    carte external ne s'y applique pas (GPIO23 n'existe pas sur le S3, GPIO19/20
    portent l'USB natif de la Nano). Le CC1101 est sur le SPI serigraphie :
    D13/SCK = GPIO48, D12/CIPO = GPIO47, D11/COPI = GPIO38, D10/CS = GPIO21,
    GDO0 sur D2 = GPIO5. LED a -1 : la LED_BUILTIN (D13) est aussi SCK.
    - boards/arduino-nano-esp32.json : la carte (esp32s3, 868 MHz).
    - BUILD.md, README.md : ligne dans le tableau des cartes.
    - docs/WIRING.md : table de cablage et premier flash (B1 a GND + RST).
    Verifie : compile (idf v6.1, esp32s3), flashe sur une Nano ESP32, demarre,
    rejoint le Wi-Fi et se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
2026-11-03 mqtt : compteur roulant partage entre cartes + verrou d'emission (topics counter/<serial> retained, busy/<serial>). Deux cartes de meme identite avancent le meme compteur (adoption du max), et ne peu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
2026-11-03 systeme : clarifier le bloc radio primaire en « Reception / ecoute permanente » (l'emission est par appareil) et retirer la note TE devenue orpheline
2026-11-03 carte xiao-esp32c3 : Seeed XIAO ESP32C3 + CC1101 868 externe (module M115). Premiere cible ESP32-C3, compile sans changer le code. MISO deplace sur GPIO3 (GPIO9 = strap BOOT), straps et UART0 laisses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
2026-11-04 pfx/enrol : map_free_slot exclut les identites 0x067 entendues sur l'air
    L'allocateur d'identite virtuelle ne consultait que nos volets virtuels et les
    moteurs enroles, jamais le registre des telecommandes entendues (s_remotes). Il
    pouvait donc attribuer un slot deja occupe par un tiers de la meme famille 0x067,
    dont ceux enroles par une box Devmel. Deux moteurs suivaient alors le meme code
    roulant : le tiers avancant le compteur, le moteur finissait par rejeter nos
    emissions restees en arriere (cas du volet Bureau Isa-O, bloque au compteur 22
    pendant que l'identite partagee etait a 5728 cote Devmel).
    map_free_slot() exclut desormais aussi les serials entendus, via le nouvel
    accesseur shutt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
2026-11-04 compat : ajoute la photo Eveno Zuni-R (OPY Zuni R, @azriek) au tableau
    Photo fournie dans #100 par @azriek, non encore illustree. Vignette front
    200px comme les autres telecommandes. Porteuse ~868,33 MHz trouvee au calage ;
    retour #100 ajoute a cote de #3.
2026-11-04 compat : retire le montage obsolete, le tableau porte les photos par telecommande
    Le montage a 4 telecommandes faisait doublon avec la colonne photo du tableau, et
    il etait perime (ni NeoSol ni Eveno). Il n'etait pas repris par l'article isno.fr
    (seul le tableau l'est) et son chemin relatif y aurait ete casse. La provenance des
    photos reste portee par chaque ligne (credit par pseudo).
2026-11-05 purge : neutraliser le nom de la passerelle commerciale (depot public)
    Le depot public ne doit pas identifier la passerelle commerciale. Trois commentaires du
    firmware la nommaient encore (la purge 7aad7e0 n'avait jamais ete fusionnee sur main) :
    pfx_enrol.c, shutters.c, shutters.h. Nom retire, formulation "passerelle tierce".
    Changement de commentaires uniquement, aucune logique modifiee.
2026-11-08 doc: separer compiler (Docker) et flasher (esptool / release .bin / OTA)
    BUILD.md donnait Docker pour compiler PUIS idf.py flash, qui n'existe que dans le
    conteneur : un utilisateur suivant la doc n'avait aucun outil cote hote pour atteindre
    sa carte (question d'un utilisateur via contact@isno.fr). Section Flasher reecrite :
    binaire prebuilt des releases + esptool (sans rien compiler), idf.py local si on a
    compile, Docker-USB en option fragile, mises a jour par OTA.
2026-11-08 docs : procedure de flash depuis un Mac (ESP-IDF natif), lien README et firmware/README
    Procedure testee et partagee par @jean-paulgabert (discussion #116).
2026-11-09 IHM rapport : capter la telecommande sur la page, et champs email/textarea stylés
    Le rapport de capture radio permet maintenant de capter une telecommande
    directement depuis la page (bouton par bande, meme endpoint /api/capture/start),
    au lieu de renvoyer vers l'onglet RF. Correction CSS : input[type=email] et
    textarea etaient hors du selecteur .field et donc non stylés.
2026-11-09 Support : capture multi-trames pour le rapport + onglet dedie
    Le rapport de capture peut collecter PLUSIEURS trames pendant 15 s (chaque
    pression distincte), au lieu d'une seule : les hoppings d'un code tournant
    aident le decodage serveur. Un code fixe repete ne compte qu'une fois. Nouvel
    endpoint POST /api/capture/multi ; le rapport joint toutes les trames via
    rfcap_frames_json (repli compatible: pulses/n = derniere trame). Le panneau
    Rapport devient un onglet 'Support' a part entiere (entre Systeme et A propos),
    hors des sous-onglets Systeme.
2026-11-14 firmware : memoire tenue sur les cartes sans PSRAM, budgets deduits de chaque carte
    Mesure sur l'ATOM (ESP32 sans PSRAM), le 2026-11-13 et 14 : avec les valeurs par defaut
    d'ESP-IDF, le tas tombait a 16 o des que le web, le TLS et la radio se croisaient (1 937 refus
    de tampons Wi-Fi, web sourd 8 min). Corrige :
    - Budgets reseau deduits de la memoire declaree par la carte : chaque boards/<carte>.json
    declare psram, tools/gen_board.py --sdkconfig en engendre un fragment ajoute a
    sdkconfig.defaults avant project(). Le firmware n'active pas la PSRAM : toutes les cartes
    ont les budgets de la RAM interne (Wi-Fi 16/16 tampons, TCP 2 880 o par socket,
    enregistrements TLS sortants de 2 Ko).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
2026-11-14 firmware : pile de la verification GitHub ramenee a 5120 o, consommation journalisee
    Mesure sur l'ATOM Lite (ESP32 sans PSRAM) le 2026-11-14 : la tache ephemere de
    verification consomme 4480 o sur 6144. 5120 o laissent 640 o de marge et rendent
    1 Ko au tas pendant la verification, la ou il touche son minimum. Chaque
    verification journalise desormais la pile reellement utilisee, pour que le reglage
    se surveille au lieu de se supposer.
    Essais ecartes dans la meme campagne : 10 puis 8 tampons Wi-Fi de reception ne
    reduisent pas le creux de la verification (11,5 et 14,8 Ko) et, a 8, divisent par
    dix le debit de reception (OTA en 78 s au lieu de 8).
2026-11-14 firmware : piles reglees sur la marge mesuree, reponses web qui attendent la fin d'un pic memoire
    Report sur main des reglages mesures sur feat/cloud (ATOM Lite, 2026-11-14, pire cas :
    HA mqtts + ecoute permanente + journal web toutes les 2 s + verification GitHub +
    commandes STOP ; marges relevees par la build de diagnostic de feat/cloud) :
    - client esp-mqtt 6144 -> 5120 (marge 2948 -> ~1930, poignee de main TLS comprise) ;
    - mDNS 4096 -> 3072 (marge 2372 -> 1424) ;
    - radio_rx 4096 -> 3072 (marge 3072 -> 2112).
    Web : /api/status, /api/rf et /api/backup reessayent leur allocation pendant 2,5 s au
    plus au lieu de repondre 500 "mem" pendant le pic de la verification GitHub. Essai
    compare, 5 v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
2026-11-14 firmware : reserve TLS, tour de poignee de main et tampons radio selon la RAM, sur main
    Report sur main de la partie memoire de feat/cloud, sans rien du cloud.
    - Reserve TLS (tls_pool.c) : allocateur de mbedTLS fourni par le firmware, un bloc pris au
    demarrage avant que la memoire ne se morcelle. Sa taille se deduit de la configuration
    (tls_budget.c, banc firmware/test/tls-budget) : HA en mqtts ou non, verification GitHub.
    Ce qui la depasse retombe sur le tas et se compte (tls_spills, publie avec le battement).
    - Pic de GitHub mesure sur l'ATOM le 2026-11-14 : 15 724 o. L'ancienne poignee de main de
    14 848 o, calee sur un broker MQTT, laissait 148 o de jeu : 4 debordements par
    ver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
